johonkanen/ac_psu_kicad/reports/aux_flyback/report.txt

params:
VOR 100.5 V, Lp*Ipp 447 uVs, Ipp(max) 1.388 A, Lp 322 uH, RCS 0.562 ohm
design load 19.8 W -> full-load fsw 71.0 kHz at Ipp(max) (FM region)
  Vin 100 V: ton 4.47 us, tdemag 4.45 us, D 0.317, demag duty 0.316, period use 0.70, Ipri rms 0.451 A
  Vin 300 V: ton 1.49 us, tdemag 4.45 us, D 0.106, demag duty 0.316, period use 0.49, Ipri rms 0.260 A
  Vin 450 V: ton 0.99 us, tdemag 4.45 us, D 0.070, demag duty 0.316, period use 0.46, Ipri rms 0.213 A
CC limit: 27.9 W at 100 kHz, 25.7 W at fSW(max) min 92 kHz, 23.0 W with VCST(max) 738 mV too (worst case)
DCM at the CC point, 100 V: ton 4.47 + tdemag 4.45 + 1.0 us = 0.99 of the 10 us period
min on time at 450 V, VCST(min): 248 ns (LEB max 280 ns -> effective 280 ns); tDMAG(min) 1.25 us (TI target >= 1.2 us)
drain peak at 450 V: 450 + clamp 240 = 690 V (73 % of 950 V)
clamp loss (leakage 5.9 uH, Vclamp 240 V): 0.69 W at full load (any Vin; Ipp is fixed by VCST(max) in the FM region)
RCS 0.562 ohm 1 % (E96): 0.12 W at 100 V
  Out1: N 5, winding 15.70 V -> out 15.00 V; diode reverse 85 V
  Out2: N 5, winding 15.70 V -> out 15.00 V; diode reverse 85 V
  CTRL: N 3, winding 9.42 V -> out 8.97 V; diode reverse 51 V
VS divider from the Out1 winding: RS1 59.0 k (run at 85 V DC, stop at 30 V), RS2 20.97 k
cable compensation 0.25 V at full load: RCBC 118 k
VDD from Out1 via diode + 47 ohm: ~14.3 V; run current 6.2 mA (IRUN max + Qg x 100 kHz)
CDD >= 12.9 uF for 20 ms to Out1 10 V (worst UVLO window 9.5 V) -> 15 uF; start delay with 15 uF: 1.3 s typ, 4.9 s worst (IHV 100 uA at 100 V)
gate drive: VDD 14.3 V, DRV ~13 V (clamp 14-16 V only at high VDD); Qg 35 nC at 20 mA min source -> 1.8 us to full charge
== EE25: E 25/13/7 N87, Bobbin EE 25 horizontal longer-creepage 10-pin 5.08mm (Norwe 10165-106)
   Ae 51.8 mm2, Ve 2994 mm3; centre gap 0.215 mm for Lm 322 uH (AL 314 nH); fits: True
   peak flux at Ipp(max) (VCST max 810 mV): 280 mT
   Vin 100 V: Bpk 270 mT  core 0.388 W  winding 0.255 W  total 0.64 W  -> ~74 C at 55 C air (Rth ~29 K/W)  [Primary 0.137 Out1 0.037 Out2 0.035 CTRL 0.047]
   Vin 300 V: Bpk 257 mT  core 0.481 W  winding 0.268 W  total 0.75 W  -> ~77 C at 55 C air (Rth ~29 K/W)  [Primary 0.134 Out1 0.043 Out2 0.033 CTRL 0.058]
   Vin 450 V: Bpk 267 mT  core 0.620 W  winding 0.304 W  total 0.92 W  -> ~82 C at 55 C air (Rth ~29 K/W)  [Primary 0.159 Out1 0.047 Out2 0.033 CTRL 0.065]
== E30: E 30/15/7 N87, Bobbin E 30/15/7 (Ferroxcube CP-E30/15/7-1S)
   Ae 60.1 mm2, Ve 3938 mm3; centre gap 0.206 mm for Lm 322 uH (AL 314 nH); fits: True
   peak flux at Ipp(max) (VCST max 810 mV): 241 mT
   Vin 100 V: Bpk 233 mT  core 0.333 W  winding 0.216 W  total 0.55 W  -> ~69 C at 55 C air (Rth ~25 K/W)  [Primary 0.115 Out1 0.027 Out2 0.036 CTRL 0.038]
   Vin 300 V: Bpk 222 mT  core 0.413 W  winding 0.202 W  total 0.62 W  -> ~71 C at 55 C air (Rth ~25 K/W)  [Primary 0.096 Out1 0.030 Out2 0.032 CTRL 0.044]
   Vin 450 V: Bpk 230 mT  core 0.533 W  winding 0.220 W  total 0.75 W  -> ~74 C at 55 C air (Rth ~25 K/W)  [Primary 0.109 Out1 0.032 Out2 0.032 CTRL 0.048]
== EE32: E 32/16/9 N87, Bobbin EE 32 horizontal 12-pin 5.08mm (Norwe 10750-024)
   Ae 83.2 mm2, Ve 6180 mm3; centre gap 0.372 mm for Lm 322 uH (AL 314 nH); fits: True
   peak flux at Ipp(max) (VCST max 810 mV): 174 mT
   Vin 100 V: Bpk 168 mT  core 0.204 W  winding 0.304 W  total 0.51 W  -> ~65 C at 55 C air (Rth ~20 K/W)  [Primary 0.163 Out1 0.041 Out2 0.043 CTRL 0.056]
   Vin 300 V: Bpk 160 mT  core 0.253 W  winding 0.315 W  total 0.57 W  -> ~66 C at 55 C air (Rth ~20 K/W)  [Primary 0.158 Out1 0.048 Out2 0.040 CTRL 0.069]
   Vin 450 V: Bpk 166 mT  core 0.327 W  winding 0.357 W  total 0.68 W  -> ~69 C at 55 C air (Rth ~20 K/W)  [Primary 0.186 Out1 0.053 Out2 0.040 CTRL 0.077]
== chosen EE25: leakage and build
   leakage ref Primary: [0.0, 6.12, 11.16, 2.92] uH
   leakage ref Out1   : [0.15, 0.0, 0.32, 0.16] uH
   leakage ref Out2   : [0.27, 0.32, 0.0, 0.42] uH
   leakage ref CTRL   : [0.03, 0.06, 0.15, 0.0] uH
   layers (inner -> outer):
     Primary section 0 layer 0                      conduction t 0.450 w  7.19 mm 16
     Insulation between Primary and CTRL section 1  insulation t 0.025 w 15.80 mm 
     CTRL section 0 layer 0                         conduction t 0.683 w  6.15 mm 9
     Insulation between CTRL and Out1 section 3 ins insulation t 0.025 w 15.80 mm 
     Out1 section 0 layer 0                         conduction t 0.704 w  3.52 mm 5
     Insulation between Out1 and Primary section 5  insulation t 0.025 w 15.80 mm 
     Primary section 1 layer 0                      conduction t 0.450 w  7.19 mm 16
     Insulation between Primary and Out2 section 7  insulation t 0.025 w 15.80 mm 
     Out2 section 0 layer 0                         conduction t 0.739 w  3.69 mm 5
     Insulation between Out2 and Primary section 9  insulation t 0.025 w 15.80 mm 
   insulation requirement (MKF, IEC 60664-1 reinforced, 500 V, PD2, OVC II, IIIa; MKF applies its >30 kHz rules): {'clearance': 0.0015, 'creepageDistance': 0.016, 'distanceThroughInsulation': 0.00015, 'withstandVoltage': 2676.2365978649464}
