johonkanen/ac_psu_kicad/next_prompt.md

# Next prompt
## ac_psu_kicad (continuing work on the inverter PSU)

```
Work in /home/jari/dev/ac_psu_kicad (KiCad 10.0.7 design of the single-phase inverter PSU,
converted from Proteus, tag proteus-conversion-complete; v4 fixes 1-16 and v5 steps 1-2 done).
Read README.md, STATUS.md (first "v5 step 2", "v5 step 1", "v4 fix 16", then "v4 fix 15", "v4 fix 13/14"),
V5_PLAN.md section 8, CTRL_ISOLATION_PLAN.md section 8, fab/README.md and tools/check_all.sh.
Never run the KiCad AppImage with --version.

Rules: kicad/ac_psu.kicad_pcb is changed only by small committed pcbnew scripts (tools/v4/fix_*.py,
tools/v5/v5_*.py; each refuses to run twice) or in the KiCad GUI with a clear note in STATUS.md.
Schematic sheets stay generated by tools/sheets/sheetNN.py; v5 parts live in tools/v5/v5_parts.py
(lib/part_map.csv and lib/v5_deviations.csv come from tools/v5/make_v5_lists.py [--nets]). Every
intended difference from Proteus is in lib/v4_deviations.csv, lib/v5_deviations.csv (kinds merge,
rename, refdes, remove, pin, part, add, value, footprint), lib/v4_copper.csv or lib/v5_copper.csv (vias,
areas, pending-layout areas). After a schematic change run tools/p2k/bin/kipy tools/v4/domain_rules.py
(net classes DOM_P/I/E/C + kicad/ac_psu.kicad_dru: the IEC 61010-1 gaps that zone fills and DRC keep).
Pours have no cut-outs since fix 16: KiCad draws every clearance. Every refdes must end in a digit
(KiCad's annotation check of Update PCB; kicad-cli ERC does not test it), see STATUS "v5 step 2".

Verify first: tools/check_all.sh (~2 min) must end with ALL CHECKS PASSED; at handoff:
  compare: parts 365/365 present ... wrong-net pins 0 ... compare: OK (135 deviation values)
  check_board: 377 footprints, 1202 pads ... 217 IPC nets mapped 1:1; 20 v4 vias; 24 Proteus vias deleted by v5; OK
  assign_nets: 562 groups, 0 shorts, 0 orphans, 0 opens; 87 v5 opens pending GUI layout
  domain_rules: 113 DOM_P, 95 DOM_I, 8 DOM_E, 64 DOM_C; OK
  drc: 291 violations, 0 shorts, 0 unconnected, 0 parity; 262 unconnected + 427 clearance pending
  domain_gaps: 0 violations; 208 in v5 pending-layout areas
  ipc356_diff: 217 nets 1:1, 0 mismatches; roundtrip: OK, drills 0 mismatches
Also tools/regen_check.sh must print "regen_check: OK".

State: the v5 netlist is on the board, the 98 new parts sit unplaced in a staging area below the
outline (IPC y -92 .. -152). Placement/routing is GUI work by the user (V5_PLAN.md D5). The pending
areas of lib/v5_copper.csv make the checks list layout items as pending; remove a row when its area
is finished so the checks become strict there again.

Open points (ask the user which to do):
0. **Next (user 2026-11-12): V5_LAYOUT_PLAN.md** – place the control and measurement parts under the
   control card in three domains (CTRL / primary / ISO), 6 copper layers, parts on both sides, planes
   reshaped; for a Claude Fable 5.2 session; stop points after the proposal (phase 1) and before routing.
1. After the user's GUI layout: review it (DRC, domain_gaps with the pending rows removed, renders of
   the aux area and both CTRL islands, slots under the isolators, In1/In2 re-cut), record it in STATUS.md.
2. CPV-E25/13/7-1S-10P-Z pin grid: the footprint assumes 5.0 x 12.7 mm (from the CSV 6-pin former);
   verify on a sample/drawing and fix gen_footprints.py if needed. Core insulation is mandatory.
3. v5 M4 ring-lug terminals for the 17 lead connections that keep soldered pins in v4 (as fix 13),
   which also settles the open cable-tie anchors (ACIN2, PE4, PE6-8, DAB_PRI/SEC_1/2, STATUS "v4 fix 15").
4. fab: the v5 passives are in fab/jlc_bom.csv (fab/README.md "v5 passives"; check C113's effective
   capacitance on the prototype). Still to add: the v5 ICs/discretes (codes in fab/README.md where known:
   UCC28710 C80866, IPD95R450P7 C3289115, ISO7760FDWR C2878538, CA-IS3742LW C4944981, AMC1311BDWVR
   C783598; Q15/Q16, D11-D16, U28 to pick), T1/W1/J13/J14/PEC1/PEC2 in hand_fit.csv, REF3025AIDBZR now
   0 stock (find a replacement), then the CPL after the layout (fab/make_fab.sh, fab/jlc_bom_check.py).
5. Still open from before: switching-noise firmware items (reports/noise/README.md), R73/R74 when the
   shunt inductance is measured, silk outlines vs the 199 silk_over_copper warnings.

Done when: the chosen points are implemented, tools/check_all.sh and tools/regen_check.sh pass,
STATUS.md has a short section, next_prompt.md is replaced, committed (Co-Authored-By: Claude
Opus 5.5 <noreply@anthropic.com>), not pushed.
```
