johonkanen/ac_psu_kicad/V5_PLAN.md

# v5 plan – aux flyback redesign (INN3694C, EE25, 2 x 15 V)

Status 2026-11-05: **schematic done, board staged** (section 8): sheet 7 is the UCC28710 flyback,
the CTRL isolation is on sheets 2/11, the board carries the v5 netlist with the new parts unplaced
below the outline; placement, routing, plane re-cuts and slots are GUI work (D5). Was: plan only
(2026-10-24). User decisions taken
2026-10-24: D1 yes, D2 15 V is fine, D3 reinforced, D5 in place on the main board, D6 rename. D4
(controller sourcing) is still open. The converter and transformer design are
in `reports/aux_flyback/README.md` (commit 965a78b). This file says how to bring that design
into the KiCad project, and which questions need answers first. Coordinates: mm, IPC frame (Y up).

## 1. What sheet 7 does today (v4)

| Rail | Made by | Return | Loads |
|---|---|---|---|
| `20V` | IW1830 PWM1, aux winding TR2-3 → D2, C28/C41; regulates through `AUX_FB` (primary-side sensing) | `GND` | J1/J2/J3 pin 48 (primary gate drivers), U9 → `5V`, relay R20 coil via Q14, D10 |
| `20V_ISO_SEC` | TR2-7 → D1, C36/C15, R49 preload (cross-regulated) | `ISOGND` | J4/J6/J8 pin 48 (isolated-side gate drivers), U8 → `5V_ISOL`, relay R79 coil via Q13, D4 |
| `5V` | U9 (VXO7805), C67/C58/C57 | `GND` | J1–J3 pin 45, U3, … |

`GND` is the DC-link negative: R96 (0 R, sheet 4) joins `GND` and `PGND`. The flyback primary
(PWM1, TR2-4) and the 20 V output therefore already share one reference. Only `20V_ISO_SEC`
crosses the DC ↔ ISO barrier, the same barrier as the DAB transformer TR1 and the
ADuM7701 / Si866x isolators.

The sheet 7 parts take up about x 70…107, y −60…−13. TR2 (EF20, 2 × 5 pins, P 3.81) is at
(87.5, −28.4) and PWM1 (DIP-8) at (75.8, −37.8). DC+ (up to 500 V) runs through the area.

## 2. Findings that change the README design

1. **Isolation sides.** The README models the transformer as primary | Out1 | Out2 | bias, with
   reinforced insulation from the primary to both outputs. On this board:
   - Out1 replaces `20V` (return `GND` = DC−), so it is in the primary domain. Primary ↔ Out1
     needs no insulation at all.
   - Out2 replaces `20V_ISO_SEC` on `ISOGND`. The barrier that matters is
     {primary, Out1, bias} ↔ Out2, and it must be reinforced (D3).

   Re-run `transformer.py` with isolation sides [primary, primary, secondary, primary]. Out2 then
   needs reinforced margins and 3-layer tape on both of its faces. The primary ↔ Out1 barrier
   becomes functional, so P1 → Out1 can be wound without margins. That frees winding width,
   which may allow wider margins on Out2 for the IEC 60664-1 caveat in the README. The
   reinforced barrier on the board, through the transformer and the slot, must match the
   ADuM7701 / Si866x / TR1 barrier around it.
2. **The InnoSwitch secondary side sits on Out1.** The secondary controller (SR FET drive, FB,
   VOUT pins) is referenced to Out1's return, which is `GND`, the same node as the primary
   `SOURCE`. That is allowed. The IC's internal FluxLink isolation is then simply unused between
   primary and Out1, so the "pending UL1577 / IEC 60747-17" note in the README no longer matters.
   An alternative is a primary-side-regulated part with the same transformer (decision D4).
3. **Relay coils.** R20 and R79 (SLA-12VDC-SL-A, 12 V coil) run from the rails through a
   2N7000 with no series resistor. With the two 15 V rails that is 125 % of the rated coil
   voltage (v4: 167 % at 20 V). The user considers this acceptable; check the relay's maximum
   coil voltage once.
4. **15 V instead of 20 V** at the HB GT connectors' pin 48 is only a problem if the gate-driver
   boards need more than 15 V (decision D2). U8/U9 (VXO78, 6.5–36 V input) are fine with 15 V.
5. **Stock.** INN3694C is JLC C567564, with 0 in stock on 2026-10-23. Neither the KiCad library nor
   JLC's basic parts have the InSOP-24D footprint or an EE25 10-pin bobbin footprint; both must be
   project footprints from the datasheets. The transformer is custom-wound, so JLC cannot assemble
   it: hand-fit it, like TR2 today.

6. **Out2 power is too small for the new control card.** The efinix-soc-board session asks for
   U8 (5V_ISOL) to be upgraded to 1.5–2 A for the Ti135 control card (0.72 A typical, 1.15 A
   high at 5 V; `~/dev/efinix_soc_board/POWER_BUDGET.md`). On Out2 (`15V_ISO`) that is U8 at
   up to about 7–8 W (1.45 A at 5 V with the gate-driver logic and U10, at 89–92 % efficiency),
   plus the J4/J6/J8 gate-driver supplies and the R79 coil (≈ 0.5 W). That exceeds the README's
   10 W per output. Re-balance the outputs before step 1 (for example Out2 13–14 W, Out1 6–7 W,
   or a larger total), and re-check the INN3694C's power rating, ILIM and the core.

## 3. Decisions (D1–D3, D5, D6 answered 2026-10-24; D4 2026-10-30)

- **D1 Output mapping – yes:** Out1 (regulated) → `20V`, renamed `15V`, on `GND`; Out2
  (cross-regulated) → `20V_ISO_SEC`, renamed `15V_ISO`, on `ISOGND`.
- **D2 – 15 V is fine** for the gate-driver boards on J1–J8 (pin 48), so `params.py` keeps
  VOUT = 15 V.
- **D3 – reinforced** between {primary, Out1, bias} and Out2 (finding 1), in the transformer and
  on the board.
- **D4 Controller – TI UCC28710 with an external 950 V MOSFET** (user, 2026-10-30), instead of the
  INN3694C (0 stock at JLC). Details in section 5. The iW1830 has 0 stock at JLC, and its 700 V
  switch is too close to 450 V DC plus VOR plus the leakage spike.
- **D5 – in place on the main board:** it replaces the aux supply. Delete the sheet 7 copper,
  then re-place and re-route the area in the KiCad GUI, with a slot under the transformer and IC.
- **D6 – rename** `20V` / `20V_ISO_SEC` to `15V` / `15V_ISO`. This touches sheets 1, 2, 3, 5, 7
  and 10, the deviation files and the checks; the renamed nets go into the v5 deviation list.
- **D7 – standard: IEC 61010-1, user 2026-10-31** (bench-top laboratory power supply). Insulation
  check in 5.3.

## 4. Steps (after the decisions)

1. **Transformer re-check.** Update `params.py` and `inputs.py` for D1–D3 (isolation sides,
   insulation class, output voltages), re-run `inputs.py` and `transformer.py`, and update the
   README tables. Check Out2 cross-regulation at the real load split. Out2 feeds the U8 module
   and the relay coil: keep a preload, or accept 16–17 V at light load if both are fine with it.
2. **Circuit.** Base it on PI's INN3694C datasheet application circuit and the README "Around
   the transformer" section:
   - input: DC+ → small RC/π filter, bulk capacitor rated ≥ 630 V (stacked 1206 parts at 500 V
     need a voltage rating to match)
   - clamp: 180–200 V TVS plus a 1000 V fast diode
   - BPP 0.47 µF; bias winding → 200 V diode → BPP resistor
   - Out1: SR MOSFET ≥ 150 V, FB divider 100 k / 9.09 k, low-ESR output capacitors ≥ 25 V
   - Out2: 150–200 V Schottky/ultrafast diode, output capacitors, preload
   - a Y1 capacitor across the DC ↔ ISO barrier only if D3 allows it (it bridges the barrier
     the ADuM7701s isolate; check the measurement noise effect)

   Write it as a new `tools/sheets/sheet07.py` (the v4 one stays in git history). Keep the 5 V
   capacitors C67/C58/C57, C68 and the rail flags. Remove PWM1, TR2, R43/R34/R33, D7, C65/C66,
   R24/C62/R23/D6, R44/R25/C63/R26/R29/R31, R45/R47, D2, D1, R49. New refdes continue from
   C111 / R98 / D11 / U18 / T3 (check that they are free; C95–C110 are fix 11).
3. **Library.**
   - Symbols in `tools/gen_symbols.py`: INN3694C with all InSOP-24D pins, and the EE25 transformer
     (10 pins, winding dots, one unit, pin numbers as on the bobbin).
   - Project footprints in `tools/gen_footprints.py` (`from_ipc`-style builder from datasheet
     coordinates): `InSOP-24D` (PI package drawing, with its creepage slot) and
     `Transformer_EE25_Ferroxcube_CPV-E25-13-7-1S-10P` (vertical; pin pitch, row spacing, holes and body from the Ferroxcube
     drawing; slot between the rows if D3 needs it).
   - Part map rows and `fab/jlc_bom.csv` codes.
4. **Deviation framework.** v5 replaces a whole block, so per-pin deviation rows are the wrong
   tool. Add `lib/v5_deviations.csv` with `removed_part` rows (the v4 parts above) and a
   `replaced_block` area (the aux copper area, every layer). Teach `tools/deviations.py`,
   `compare_netlists_v4.py`, `check_board.py`, `ipc356_diff.py` and `gerber_roundtrip.py` to skip
   removed parts and their pins, nets that exist only inside the block, and copper clusters
   inside the area. Everything outside the block keeps the Proteus parity checks. Negative-test
   it: a part outside the block that is removed or renetted must still fail.
5. **Board (D5: in place).** A `tools/v5/` script deletes the removed footprints and the copper
   inside the area, then places the new footprints at agreed positions. Routing, pours and the
   slot are done in the KiCad GUI and recorded in STATUS.md, which ends the "frozen board edited
   only by scripts" rule for this area.

   A net class `HV_AUX` sets the clearance for DC+, the drain node and the clamp (500 V working:
   ≥ 2.5 mm on external layers). The reinforced creepage between the GND and ISOGND domains is
   kept across the transformer, the slot and the Out2 copper, including on the inner layers.
   Check the space first: the EE25 bobbin is larger than the EF20, and the InSOP-24D needs
   its own slot.
6. **Checks.** ERC, `tools/check_all.sh` (with the v5 deviations), DRC with the new net class,
   `tools/regen_check.sh`, renders of the area, and the JLC BOM/CPL refreshed.
7. **Bring-up** (README): measure Lp (MKF predicts +12 %), the drain peak at 500 V, the clamp
   temperature, and Out2 at light and full load.

## 5. Controller: UCC28710 + external MOSFET (D4)

Why: primary-side regulation (PSR) like the present iW1830 design: the output is sensed through
the bias winding, so there is no optocoupler across the reinforced barrier. The external MOSFET
removes the 700–725 V switch limit of the integrated parts, and the 700 V high-voltage start-up
switch (DC+ ≤ 450 V) replaces the R43/R34/R33 start-up chain. ±5 % CV/CC regulation, up to
100 kHz, clamped MOSFET gate drive, SOIC-7. JLC C80866 (UCC28710DR), 381 in stock on 2026-10-30.
The UCC28712 is pin-compatible (fixed cable compensation) and could serve as a second source.

MOSFET (primary peak current ≈ 0.8–1 A at 20–25 W; RMS ≈ 0.2 A at 400 V, ≈ 0.45 A at 100 V;
drain peak ≈ 450 V + VOR ≈ 104 V + clamp overshoot, so ≈ 700–750 V with a 180–200 V TVS clamp,
which needs ≥ 950 V parts):

| Part | Package | Rds(on) at 10 V | JLC / stock 2026-10-30 | Note |
|---|---|---|---|---|
| Infineon IPN95R2K0P7 (only if the input stays ≥ 300 V; see 5.1) | SOT-223 | 2.0 Ω | C3278575 / 75 | Smallest; CoolMOS P7, 330 pF Ciss, 10 nC. ≈ 0.1 W conduction at 400 V, ≈ 0.4–0.8 W at 100 V hot: needs a copper area of ≈ 1–2 cm² on the drain tab, which is the switch node (keep it small for EMI; use the source side and a thermal pad). |
| Infineon IPN95R3K7P7 | SOT-223 | 3.7 Ω | C3278582 / 172 | More stock, twice the conduction loss. |
| ST STD6N95K5 | DPAK (TO-252) | 1.25 Ω | C455168 / 112 254 | Large stock and lower loss, with a bigger tab (≈ 6.6 × 6.1 mm). The fallback if the SOT-223 parts run out. |
| Infineon IPD95R1K2P7 | DPAK | 1.2 Ω | C536916 / 1528 | Same class as STD6N95K5. |

Check in the datasheets before the circuit step:
- the UCC28710 DRV drive against the MOSFET Qg (10–15 nC is fine at ≤ 100 kHz)
- the minimum demagnetisation time for its PSR sampling against the EE25 leakage (20.6 µH)
- the bias-winding voltage range (VDD), then pick NB to suit
- the maximum power the TI design calculator gives at VIN 100–450 V

With PSR, Out1 is no longer the regulated rail. Both 15 V outputs are cross-regulated through the
bias winding, as 20V/20V_ISO_SEC are today, so the transformer coupling (MKF leakage) sets the
accuracy. Keep a preload on both outputs.

Step changes for this choice: step 2 follows the UCC28710 application circuit (no SR MOSFET and no
FB divider on Out1; a VS divider from the bias winding, a CS resistor, a 950 V MOSFET, and diodes on
both outputs). Step 3 drops the InSOP-24D footprint (SOIC-7 and SOT-223 are KiCad library
footprints).

### 5.1 Full power at 100 V, passive cooling (user, 2026-10-30)

DC+ is rated 100–450 V, and the aux supply must deliver full power at 100 V: the control card
(FPGA, Ethernet, LCD), the 5 V logic and all the gate-drive supplies. The supply is passively
cooled inside a closed chassis.

**Power budget (estimate, to confirm).** Output side:

| Load | Estimate |
|---|---|
| Out2: U8 (card 5.8 W high case + gate-driver logic + U10) / 0.9 | ≈ 7–8 W |
| Out2: J4/J6/J8 gate-drive supplies | ≈ 3 W |
| Out2: R79 coil | 0.5 W |
| Out1: J1–J3 gate drives | ≈ 3 W |
| Out1: U9 5 V logic | ≈ 1–2 W |
| Out1: R20 coil | 0.5 W |

Each gate-driver board is assumed at about 1 W. The SiC gate charge itself is only ≈ 20–40 mW per
switch at 30/66 kHz; the drivers' isolated DC/DCs dominate. The total is **≈ 15–20 W, so design for
25 W output (≈ 29 W input) at 100 V.**

**The README transformer cannot do that.** The UCC28710 is primary-side regulated and needs DCM:
on-time plus demagnetisation time must fit in the switching period.
- With VOR ≈ 104 V at 100 V input, the DCM boundary is D ≈ 0.51.
- The maximum input power is then (Vin·D)² / (2·Lp·fsw) = 51² / (2 · 1.19 mH · 70 kHz) ≈ 15.6 W.

Redesign for:
- **Lp ≈ 0.5–0.6 mH** at 70 kHz (≤ 0.64 mH at the boundary, with margin for the PSR sampling
  window).
- **Or a higher VOR** (≈ 130–150 V gives D ≈ 0.57–0.6 and allows ≈ 0.7–0.9 mH). The drain peak then
  rises to ≈ 450 + 150 + overshoot ≈ 780 V, still under 950 V. Choose by the transformer losses.
- Primary at 0.5 mH: Ipk ≈ 1.46 A, Irms ≈ 0.6 A, stored energy ≈ 0.53 mJ per cycle.
- On EE25 (Ae ≈ 52 mm²) at 0.3 T that is ≈ 47 primary turns and a gap of ≈ 0.3 mm. It is feasible,
  but re-run MKF for copper and core loss at 100 V in a hot enclosure.
- If the losses come out over ≈ 1.5 W, step up to E30/EF25.

**MOSFET for continuous 100 V operation.** Hot Rds(on) is about 2.2 × the 25 °C value; the
switching loss is ≈ 0.25 W turn-off at 250 V / 1.46 A.

| Part | Package | Rds(on) 25 °C | Conduction loss hot at 100 V | JLC / stock 2026-10-30 |
|---|---|---|---|---|
| **Infineon IPD95R450P7** | DPAK | 0.45 Ω | ≈ 0.36 W | C3289115 / 112 |
| Infineon IPD95R750P7 | DPAK | 0.75 Ω | ≈ 0.6 W | C536918 / 97 |
| ST STD6N95K5 | DPAK | 1.25 Ω | ≈ 1.0 W | C455168 / 112 254 (fallback) |
| ST STB20N95K5 | D2PAK | 0.275 Ω | ≈ 0.2 W | C500935 / 895 (if DPAK runs hot) |
| ~~IPN95R2K0P7~~ | SOT-223 | 2.0 Ω | ≈ 1.6 W | too hot for 100 V continuous; dropped |

Choose the IPD95R450P7, about 0.6 W in total. Its tab is the drain, i.e. the switch node, so
keep that copper small: cool it through a source-side and inner-layer copper spread with thermal
vias, not a large drain pour. Check the 35 nC Qg against the UCC28710 DRV current.

**Thermal budget in the closed chassis:**
- FET ≈ 0.6 W, clamp ≈ 1–1.3 W (more at the higher Ipk), transformer ≈ 1–1.5 W, output diodes
  ≈ 0.5–0.8 W: ≈ 3.5–4 W in the aux area.
- Give the clamp TVS and the diodes copper too.
- Measure the internal air temperature on the v3 build, then check the N87 core loss, the
  electrolytic capacitor life and the U8 K7805-2000R3 derating (the 5 V version derates from
  ≈ 55–71 °C ambient).

**Thermal environment (user 2026-10-31: rated ambient 30 °C):**
- **Internal air:** 30 °C ambient + the rise of the passively cooled closed chassis. No dissipation
  figure for the whole unit exists in the repo yet (the power stages' losses are unknown), so a
  **20–30 K rise is assumed: internal air ≈ 50–60 °C, design value 55 °C** (`params.py` T_AMB).
  Measure it on the v3 build at full load.
- **Transformer (EE25, MKF at 55 °C air; the rule-of-thumb rise scales with the air temperature):**
  0.64 W at 100 V, 0.75 W at 300 V, 0.92 W at 450 V → **≈ 74–82 °C at 55 °C air (≈ 69–87 °C for
  50–60 °C air).** N87 core loss rises slightly when cooler (its loss minimum is near 100 °C), so the
  losses are 0.03–0.05 W higher than at 60 °C.
- **U8 (K7805-2000R3):** Mornsun derates the 5 V version above 71 °C ambient for Vin ≤ 32 V (here
  15–20 V), to zero at 85 °C. At 50–60 °C internal air (plus a few K local rise) it runs at full power.
  In v5 U8 only feeds the gate-driver logic and U10 (≈ 1 A), so there is extra margin.
- **IEC 61010-1 temperature limits (10.1, Table 19; values from memory, verify):** accessible outer
  surfaces about 70 °C metal / 80 °C non-metal for unintentional contact; knobs and handles about
  55 °C metal / 70 °C non-metal. The test is run at the reference ambient (10–40 °C) and the measured
  rise is added to the rated ambient (30 °C). A metal chassis that also works as the passive heatsink
  may therefore rise only about **40 K** above ambient where it can be touched. Windings are limited
  by their insulation class (≈ 105–130 °C for class A–B), which the transformer meets.

### 5.2 CTRL winding and control-card isolation (user, 2026-10-31)

v5 includes the control-card isolation in `CTRL_ISOLATION_PLAN.md`. The card domain (J11/J12)
becomes CTRL, isolated by reinforced barriers from both power sides, so the card's Ethernet and
touchscreen are SELV. The card's 5 V comes from a **dedicated CTRL winding** on this flyback. The
transformer now has **three reinforced-separated groups**:
- {primary, Out1 (`15V`, GND; also the PSR sense and VDD winding since 5.3)}
- Out2 (`15V_ISO`, ISOGND)
- CTRL (5 V, card ≈ 6–7 W)

Margins or TIW are needed on both of the last two. Re-run MKF with isolation sides
[primary, primary, secondary, tertiary, primary], and expect the EE25 to become too small: check
E30 / EF25 / EFD30 with the 100 V full-power design point of 5.1.

**Power (user estimate):** about 15–20 W in total; the 25 W design point of 5.1 covers it. With
CTRL taking the card, Out2 drops back to the gate-driver supplies, U8 (now only the gate-driver
logic and U10) and the R79 coil, ≈ 4–5 W. Rebalance the outputs: Out1 ≈ 5–6 W, Out2 ≈ 4–5 W, CTRL
≈ 7 W, with margin.

**Regulation:** PSR regulates the bias winding (since 5.3: Out1 itself, no separate bias winding). CTRL is cross-regulated like the others, so put a
local regulator (buck or LDO) after the CTRL winding if the card needs a tight 5 V. Choose the
CTRL winding voltage to suit, e.g. ≈ 7–8 V into a buck.

**Why not the iW1830** (user question 2026-10-31): Renesas rates it at 12–15 W maximum, for AC input
(85–264 VAC, ≈ 120–375 V DC). Its integrated MOSFET is 700 V, but here the drain peak at 450 V DC is
≈ 700–780 V. And JLC has 0 in stock. The UCC28710 (section 5) is the same kind of controller
(primary-side regulation from the bias winding, no optocoupler), but drives an external 950 V
MOSFET, so the power is set by the transformer and the MOSFET.

### 5.3 Transformer (run 2026-10-31, revised to 20 W on EE25, no bias winding)

Details, candidates and scripts: `reports/aux_flyback/` (README.md, params.py, inputs.py,
transformer.py, report.txt, winding.svg). This supersedes the INN3694C/EE25 numbers above. The
25 W / E30/15/7 design (commit 3b4a33d) is kept in the README as the alternative.

**Electrical design** (UCC28710, 100–450 V, full power at 100 V; user: 20 W):
- **Design load ≈ 20 W:** Out1 15 V 0.39 A (load + ≈ 20 mA VDD), Out2 15 V 0.33 A, CTRL ≈ 9 V 1.0 A
  (into a 5 V buck). **No separate bias winding** (user, 2026-10-31).
- **VOR 100.5 V:** the 100 V DCM limit sets it.
- **Lp 322 µH, Ipp(max) 1.39 A, RCS 0.562 Ω** (user 2026-10-31: lowered from 0.590 Ω for CC margin).
- **Full load (19.8 W) at 71 kHz:** at 100 V, the on-time, demagnetisation and ring take 0.70 of the
  period.
- **CC limit:** 27.9 W typ; **23.0 W worst case** (fSW(max) 92 kHz and VCST 738 mV).
- **Drain peak:** 450 + 240 V clamp = 690 V (73 % of 950 V).
- **Light load at 450 V:** tDMAG(min) ≈ 1.25 µs (TI target 1.2 µs).

**Core:** E25/13/7 N87, gap ≈ 0.22 mm for AL ≈ 314 nH (choose the TDK B66317 gapped half or grind).
**Bobbin (user decision 2026-11-02): vertical coil former**, Ferroxcube CPV-E25/13/7-1S-10P-Z (10 pins)
with clip CLI-E25/13/7, instead of the Norwe 10165-106 horizontal bobbin (see section 7). The winding design is
unchanged (same core and winding width); MKF still models it with the Norwe horizontal bobbin as a proxy.
Was: Norwe 10165-106 (EE25 horizontal, longer creepage, 5 + 5 pins at 5.08 mm); alternatives
Norwe 10220-024 / 10175-106.

| Winding (inside → out) | Turns | Wire |
|---|---|---|
| P1 | 16 | 0.40 mm Grade 2 |
| CTRL | 3 | 3 × TIW 25 AWG (Rubadue TCA3) in parallel, **flying leads** |
| Out1 | 5 | 0.63 mm Grade 2 (PSR sense + VDD) |
| P2 | 16 | 0.40 mm Grade 2 |
| Out2 | 5 | TIW 24 AWG |

Order O2 out of four compared: the lowest clamp-effective leakage (5.9 µH), Out1 between the
primary halves (P→Out1 6.1 µH), and CTRL tightly coupled to Out1 (0.06 µH).

**Out1 as the PSR sense and VDD winding** (user, 2026-10-31; details in the README):
- **VS divider** from the Out1 winding node before its diode: RS1 59.0 k, RS2 21.0 k, cable
  compensation RCBC ≈ 118 k (+0.25 V at full load). The controller regulates Out1 directly; Out2 and
  CTRL cross-regulate against it.
- **VDD** from the 15 V rail via BAS16 + 47 Ω, ≈ 14.3 V. CDD 15 µF (TI eq. 24: ≥ 12.9 µF for a 20 ms
  start into ≈ 2200 µF total output capacitance). Start delay ≈ 1.3 s typ, 4.9 s worst at 100 V.
- **An output short** collapses VDD: hiccup (≈ 30 ms on per 1–5 s), thermally safe.
- **Gate drive:** DRV ≈ 13 V, so the FET is fully on (its Rds(on) is rated at 10 V). DRV sources only
  20–25 mA, so add an MMBT3904/3906 buffer for the 35 nC gate (or use the IPD95R750P7, 23 nC).
- **VS knee:** the leakage reset is ≈ 60 ns (TI limit 2.2 µs). The ringing must be < 100 mVpp at VS by
  ≈ 1.05 µs at 450 V no load (tDMAG(min) 1.25 µs); add an RC snubber on the Out1 diode if needed.

**Pins:**
- **Primary row:** drain, DC+, empty (the freed bias pin), GND, Out1.
- **Secondary row:** Out2+, ISOGND; pins 8–10 cut.
- **CTRL:** TIW flying leads from the pin-10 end of the secondary flange to two Ø 1.6 mm holes
  (pads Ø 3.0 mm, 5.08 mm apart) in the CTRL island, ≥ 10 mm from the Out2 pins, the primary row and
  the core.
- **The core is floating:** it counts as conductive between the groups; insulate it (see the IEC 61010-1 check below).

**Insulation – IEC 61010-1 check (2026-10-31):**

**Standard: IEC 61010-1 (3rd ed. + A1), user decision 2026-10-31** (bench-top laboratory power
supply). The values below use the **IEC 60664-1 basis** that IEC 61010-1 Annex K builds on
(Table F.2 clearance, Table F.4 creepage, reinforced = 2 × basic). The standard text was not
available here, so **every number must be verified against IEC 61010-1 Annex K (K.1 mains circuits,
K.2 secondary circuits) before layout sign-off.** Assumptions: mains 230 V, OVC II (2.5 kV impulse),
PD2, ≤ 2000 m; bobbin plastic material group IIIa; FR4 CTI ≥ 175 (IIIa).

**Working voltages** (user 2026-10-31: the isolated DC link is ≤ 410 V, so the AC output peak is
≤ 410 V (≈ 290 Vrms sine); the primary DC+ stays ≤ 450 V for the 100–450 V input range. CTRL is
bonded to PE; both power domains move against PE). **User 2026-10-31: the output is always floating AC**, so the DC/earthed case below does not apply and B2 stays in the 500 V row. Whether an output terminal can be earthed was not
known yet, so both cases are given:

| Barrier | Floating output (only the output Y caps C29–C32 to PE) | Output earthed (through the Y caps' leakage path, the user or the load) | IEC 60664-1 row (RMS / DC working voltage) |
|---|---|---|---|
| B2 primary ↔ ISO | ISO domain centred on PE: ISOGND ≈ −205 V average, −410…0 V extremes; DC+ ≤ +450 V to PE. Peak ≈ 860 V, RMS ≈ 430–500 V | ISOGND = −(earthed pole voltage): −410…0 V. Same peak ≈ 860 V, RMS ≈ 430–500 V | **500 V row** (was 630 V); medium confidence, the RMS sits near the 500 V boundary. (The DC-output/earthed case, 1000 V row, does not apply: the output is always floating AC, user 2026-10-31.) |
| B3 primary ↔ CTRL (PE) | DC+ ≤ 450 V peak to PE, RMS < 450 V | same | **500 V row** (unchanged) |
| B4 ISO ↔ CTRL (PE) | ≤ 410 V peak (switching common mode included), RMS ≈ 205–290 V | ≤ 410 V peak, RMS ≤ 410 V (DC output) | **500 V row** (just above the 400 V row; unchanged) |
| B1 mains/primary ↔ accessible parts | mains 230 Vrms OVC II; DC+ ≤ 450 V | same | mains OVC II 300 V |
| B5 CTRL ↔ user parts (Ethernet, touchscreen) | same domain, PE-bonded, SELV | same | functional |

Insulation type: reinforced everywhere (user D3 for B2; for B3/B4, basic + PE bonding would satisfy
class I). IEC 61010-1 may only require basic between two hazardous-live circuits (B2); to confirm.

**Required distances** (IEC 60664-1 basis; confidence in brackets):

| Barrier | Clearance, reinforced | Creepage, reinforced: PCB (printed-wiring column, CTI ≥ 175) | Creepage, reinforced: other insulating material IIIa (bobbin, connector bodies) | Solid insulation, reinforced |
|---|---|---|---|---|
| B2, B3, B4 (500 V row) | ≥ 3.0 mm (2.5 kV OVC II impulse → 4 kV step; the ≈ 860 V recurring peak needs less) (medium-high; K.1.2 may add for working voltages above mains, so lay out ≥ 4 mm) | 2 × 2.5 = **5.0 mm** (medium) | 2 × 5.0 = **10.0 mm** (medium) | ≥ 0.4 mm single layer, or ≥ 2 thin layers each passing the full test voltage (3 layers: any 2) (medium) |
| ~~B2 if the output could be DC and earthed (1000 V row)~~ not applicable (floating AC output) | ≥ 3.0 mm | 2 × 5.0 = **10.0 mm** (medium-low) | 2 × 10.0 = **20 mm** (medium-low) | same |

- **Test voltage** (dielectric strength, reinforced, 1 min AC): ≈ 3 kVrms for mains OVC II 300 V,
  higher for the 500 V row working voltages (≈ 3.5–4 kVrms). Low confidence: verify in IEC 61010-1 6.8 and Annex K
  MKF's IEC 60664-1 figure is 2.7 kV; its IEC 62368-1 figure is 5 kV.
- **If IEC 61010-1 does not accept the printed-wiring column** for these working voltages, use the
  material-group column on the PCB too (10.0 mm for all three barriers). The board plan's ≥ 10 mm with
  slots covers that (the 20 mm DC-output/earthed case does not apply: floating AC output).
- **Slots** count as an interruption of the creepage path when ≥ 1.0 mm wide (IEC 60664-1, PD2).
- **MKF numbers** (reports/aux_flyback/insulation.py → insulation.txt): its IEC 60664-1 creepage is
  16 mm at 450–500 V and 25 mm at 630–800 V reinforced (IIIa, PD2). That is far above Table F.4 because
  MKF applies the high-frequency (> 30 kHz) creepage rules to the converter's 71 kHz waveform. Between
  the groups the voltage is mostly DC/50 Hz plus a ≈ 100 V switching swing, so Table F.4 governs.
  The HF rule must be checked for the swing amplitude only (small). Keep the MKF figure as an upper
  bound.
- **Digital isolators and AMC1306/AMC1311:** IEC 61010-1 ed. 3 asks for ≥ 0.4 mm internal distance
  through insulation, with relief for components certified to IEC 60747-17 / VDE 0884-11 (ADI note).
  Use parts with that certification (ISO7760F, CA-IS3742, AMC1311, AMC1306 are listed as reinforced
  per DIN EN IEC 60747-17; confirm each datasheet). Their 8 mm package creepage on CTI ≥ 600 mold
  compound covers 5.0 mm (group I at 500 V); the slot under each package is still needed for the FR4.

**Transformer verdict (EE25, written for the Norwe 10165-106; the same checks apply to the vertical
Ferroxcube CPV-E25/13/7-1S-10P-Z chosen 2026-11-02; TIW on Out2 and CTRL, CTRL on flying leads):**
**not compliant as it is; fixable** (paths ranked by risk):

1. **Via the floating core** (fails as built): on a standard EE25 bobbin, pins to the core edge are
   ≈ 2–4 mm per side. That is far below the 10.0 mm needed (B2: P/Out1 pins ↔ core ↔ Out2 pins; B3/B4: CTRL holes ↔
   core). **Fix: insulate the core:** 3 layers of polyester tape around the outer legs and
   back, or insulating core caps/sleeves. The core then drops out of the creepage path, which is
   measured over the tape. Cheap and standard practice.
2. **Pin row to pin row over the bobbin (P/Out1 row ↔ Out2 row, B2, ≥ 10.0 mm):** depends on the Norwe
   10165-106 row spacing and flange; typical EE25 horizontal bobbins have ≈ 15–20 mm between the rows
   (verify on the drawing). Cutting pins 8–10 and keeping Out2 on pins 6–7 at the far end helps.
3. **Through the windings:** TIW (Rubadue TCA3, Furukawa TEX-E) is certified as reinforced solid
   insulation (IEC 61558-2-16 / IEC 62368-1 Annex J, UL/VDE), typically 3 kVrms+ per wire. IEC 61010-1
   has no TIW-specific clause. Certification bodies accept certified TIW in wound components when the
   finished transformer passes the reinforced test voltage (to confirm with the test lab; medium-low
   confidence). Sleeve the TIW leads where they leave the bobbin, so the lead cannot be pinched
   against the core edge.
4. **CTRL flying leads:** TIW is solid insulation along its length, so only the soldered ends count:
   PCB rules at the CTRL holes (≥ 10.0 mm to other-domain copper and to the core outline,
   B3/B4). Already in the plan.

**Fix options, ranked:**
1. **Core insulation (tape or caps) + certified TIW + verify the row spacing ≥ 10.0 mm.** Recommended:
   no process change.
2. **Vacuum varnish impregnation:** IEC 60664-1 / IEC 61010-1 allow pollution degree 1 only for parts
   that are sealed, potted or coated to IEC 60664-3. Plain impregnation of an open bobbin is usually
   **not** accepted as PD1 for the pin and flange surfaces, so it does not replace fix 1.
3. **Potting the transformer:** solid insulation everywhere; heavy and a process step. Only if the
   lab rejects fix 1.
4. **Larger core / 12-pin E30 bobbin:** more room but the same core issue; fix 1 is still needed.

**PCB verdict:**
- **B3/B4 (CTRL islands):** the plan's ≥ 10 mm with slots meets the IEC 60664-1 basis in both cases:
  printed-wiring column 5.0 mm, material-group column 10.0 mm. **OK** (unchanged by the 410 V limit). Clearance ≥ 4 mm is met
  automatically.
- **B2 (primary ↔ ISO on the PCB):** the aux transformer's P/Out1 pads ↔ Out2 pads and the TR1
  terminals (DAB_PRI_x ↔ DAB_SEC_x) need **5.0 mm (printed-wiring column) to 10.0 mm (material-group
  column)** at the 500 V row; ≥ 10 mm (PCB) / 20 mm (other material) if the output can be DC and
  earthed. Lay out ≥ 10 mm, or slot. Check today's DAB terminal spacing on the v4 board as well.
- **Inner layers:** keep the same gap on In1/In2 unless the PCB is qualified for cemented joints. A
  domain on L1 must not overlap another domain on L2: the L1–L2 prepreg (≈ 0.2 mm) is below the
  0.4 mm reinforced solid-insulation thickness and is not two separately tested layers.
- **Slots:** ≥ 1.0 mm wide under every isolator and across each barrier where the copper gap is
  tight. The plan already says ≥ 1 mm.

**IEC 61010-1 checklist (beyond distances):**
- **Output terminals:** the AC output and the DC link are hazardous live (> 30 Vrms / 60 V DC).
  Use shrouded, finger-safe output terminals, with markings and a warning symbol.
- **Protective bonding:** PE bond resistance test (≤ 0.1 Ω at 25 A or 2 × rated current, per 6.5.2)
  covering the chassis, the CTRL island PE terminals and the Ethernet shield.
- **Touch current / protective-conductor current:** limits in 6.3. The Y capacitors and all barrier
  capacitances to PE add up; check the total.
- **Temperature limits (10.1):** surfaces, windings (insulation class) and components in the passively
  cooled chassis at the rated ambient (to define, e.g. 40 °C) and full load.
- **Fire enclosure, mains switch / fuse, X/Y capacitor ratings, marking and documentation.**
- **EMC:** IEC 61326-1.

**Losses (MKF at 55 °C air):** 0.64 W at 100 V, 0.92 W at 450 V. Peak flux 280 mT. ≈ 74–82 °C at
55 °C chassis air (30 °C rated ambient + an assumed 25 K rise). Aux area total at 100 V full load ≈ 2.6 W (clamp 0.7 W, MOSFET 0.4 W, diodes
≈ 0.9 W).

**Board footprint:** ≈ 28 × 26 mm plus the CTRL hole zone (≈ 800 mm² in total). That is ≈ 2.6 ×
today's EF20 and ≈ 25 % less than the E30 alternative (≈ 35 × 31 mm).

**Rest of the stage:**
- clamp TVS ≈ 200 V class + 1000 V fast diode
- Out1/Out2: 200 V ultrafast 1–2 A
- CTRL: 100 V Schottky 3 A
- VDD feed: BAS16 + 47 Ω, CDD 15 µF / 50 V; gate buffer MMBT3904/3906
- output capacitor RMS: Out1 0.71 A, Out2 0.62 A, CTRL 1.86 A
- preloads: Out2 ≈ 3 mA, CTRL ≈ 10 mA
- cross-regulation against Out1: Out2 14.7–15.3 V; CTRL ≈ 8.9–9.3 V loaded, ≈ 10.5–11.5 V at no load;
  CTRL buck ≥ 17 V input

**Open items:**
1. measure the chassis air temperature
2. wind a sample and measure Lp, the leakage, and the VS waveform at 450 V no load
3. source certified TIW
4. confirm the E25 gap (AL 314 nH; the user grinds the gap on ungapped cores) and the Ferroxcube CPV-E25/13/7-1S-10P-Z
   drawing: pin-row to pin-row creepage ≥ 10.0 mm (B2), pins to core, where the CTRL TIW leads exit,
   and the height (≈ 25–30 mm) clear of the control card
5. working voltages: all barriers in the 500 V row (isolated DC link ≤ 410 V, user 2026-10-31); the output is always floating AC (user 2026-10-31), so the 1000 V case is closed
6. standard decided: IEC 61010-1 (user 2026-10-31); PCB targets confirmed by the user 2026-11-01: 5.0 mm reinforced (primary ↔ ISO, primary/ISO ↔ CTRL), 2.5 mm basic (to PE); still to verify: the bobbin (10 mm) and test-voltage values; core insulation tape/caps
7. trim RS2 / RCBC and check the VS ringing, the start-up and the gate buffer on the prototype
   (decided 2026-10-31: MMBT3904/3906 buffer, RCS 0.562 Ω → CC worst case 23.0 W)

## 6. Not part of v5

v4 clean-up and manufacturing items (C67, silk positions, pad decisions, JLC alternatives, CPL)
continue separately on the v4 board. Sheet 7 parts that v5 replaces (iW1830, EF20 TR2 and so on)
get no JLC alternatives.

## 7. Magnetics sourcing (checked 2026-11-02, stock figures change)

| Part | Distributor | Notes |
|---|---|---|
| Core TDK B66317G0250X187 (E25/13/7 N87, 0.25 mm gap, AL ≈ 250 nH) | Mouser, DigiKey (495-77132-ND), Farnell/Newark | TDK's table (May 2026): Mouser ≈ 500, DigiKey ≈ 1300, but one DigiKey page showed 3 and a 26-week lead time. Order 2 halves per transformer: the gap is in one half; check whether the part number is one gapped half or a set. |
| Core TDK B66317G0000X187 (E25/13/7 N87, ungapped) | DigiKey, Mouser | The user can grind the gap: grind the centre leg of one half until Lp = 1.19 mH (≈ 0.25 mm), and measure Lp as you grind. |
| Coil former TDK B66208B1110T001 (E25/13/7, horizontal) | DigiKey (495-5372-ND) | Pin count and creepage still to confirm in the TDK datasheet; 29-week lead time listed. Yoke/clip B66208A2010X000 (2 per transformer). |
| Coil former Ferroxcube CPH-E25/13/7-1S-10P (horizontal, 10 pins) | DigiKey (1779-1317-ND) | 0 stock in one snapshot, about 10 weeks. Clip CLI-E25/13/7. |
| Norwe 10165-106 (longer-creepage horizontal 10-pin, used by the README design) | not found at Mouser/DigiKey | Specialist magnetics suppliers only. |
| AliExpress / eBay "EE25 5+5 pin" sets | many sellers | PC40 (≈ N87), mostly ungapped: the user grinds the gap, so the cores are usable (check the core size is really E25/13/7, and measure Lp). The bobbins have an unknown insulation rating and pin creepage, so they are no basis for reinforced isolation: use a TDK/Ferroxcube coil former. |

The board footprint (step 3) is drawn from whichever coil former is chosen. Its pin pitch, row spacing and creepage set the reinforced-isolation layout.

**Decision 2026-11-02 (user): vertical coil former.** Candidate: Ferroxcube CPV-E25/13/7-1S-10P-Z
(10 pins, vertical; DigiKey 1779-1359-ND, 0 stock with 250 expected 2027-03-30, 10-week lead
time, about €0.46; datasheet https://www.ferroxcube.com/upload/media/product/file/Pr_ds/E25_13_7.pdf)
with clip CLI-E25/13/7. The winding design is unchanged. Before drawing the footprint (step 3), read the
pin pitch, row spacing and the pin-to-core distances from the datasheet; the reinforced barrier runs
between the two pin rows (primary/bias/Out1 on one row, Out2 on the other) with a slot between them.
The transformer is about 25–30 mm tall. Put it in the lower part of the aux area (y below −18.8),
outside the control card's outline, and glue or clip it to the board.

## 8. Implementation (2026-11-05)

User request 2026-11-05: "do 1, the v5 aux flyback", scope "Flyback + CTRL isolation" (schematic,
board placement only; the logic-area re-layout stays GUI work).

**Bobbin creepage re-check (Ferroxcube CPV-E25/13/7-1S-10P-Z, open item 4).** The CPV drawing is not
on Ferroxcube's site any more (the current E25/13/7 sheet has the core only and lists the CPV as an
accessory); the 2008 data sheet (web archive of ferroxcube.home.pl/prod/assets/e25137.pdf) draws the
horizontal 10-pin CPH (pins 0.7 mm square, 5 mm pitch) and the vertical 6-pin CSV (2 x 3 pins, 5.0 mm
pitch, **rows 12.7 mm apart**, flange 17 x 17.2 mm). The footprint
`ac_psu:Transformer_EE25_Ferroxcube_CPV-E25-13-7-1S-10P_Vertical` therefore assumes 2 x 5 pins on the
CSV grid (5.0 x 12.7 mm, 1.2 mm drills, 2.0 mm pads), body 28 x 20 mm, core 25.8 x 7.5 mm between the
rows. **Verify the pin grid on a CPV sample or drawing before the PCB order.** With that grid:

| Path (B2, 500 V row, reinforced) | Required | Found | Verdict |
|---|---|---|---|
| PCB copper, primary row ↔ Out2 row (pad edge to pad edge) | 5.0 mm printed wiring (10.0 mm material group) | 12.7 − 2.0 = **10.7 mm** | OK in both columns, no slot needed |
| Over the former between the rows (pin edge to pin edge, IIIa) | 10.0 mm | ≥ 12.7 − 0.7 = **12.0 mm** (more along the flange contour) | OK |
| Pins ↔ floating core (each row) | 10.0 mm via the core (sum of both sides) | 6.35 − 3.75 − 0.35 ≈ **2.25 mm** per side | **fails: insulate the core** (3 layers of tape or caps), as in 5.3 |
| Out2 pins 6/7 ↔ cut pins 8-10 | – | pins 8-10 cut, pads unconnected (no domain) | OK |
| CTRL leads (W1 holes) ↔ other domains | 5.0 mm on the PCB (DRC rule), 10 mm to the core outline | placement in the GUI | DRC enforces the PCB part |

The DRC rules of `kicad/ac_psu.kicad_dru` (tools/v4/domain_rules.py: P-I, P-C, I-C 5.0 mm; P/I-E 2.5 mm)
now hold the PCB distances for T1, W1 and all CTRL parts automatically, also for zone fills.

**What was done** (details in STATUS.md "v5 step 1"):
- `tools/v5/v5_parts.py`: the part list (98 parts: 46 on sheet 7, 52 on sheet 11), removed parts,
  renames. `tools/v5/make_v5_lists.py` writes part_map and `lib/v5_deviations.csv`.
- Symbols (gen_symbols.py): UCC28710, IPD95R450P7, MMBT3904/3906, D_TVS, CONN_2, OPA2350EA,
  EE25_AUX_TRANS, CTRL_WINDING, ISO7760F, CA-IS3742, AMC1311, TPS54202; power 15V, 15V_ISO, CTRLGND,
  CTRLGND_A, 3V3_CTRL, 5V_CTRL, 5V_CTRL_A. Pinouts from the TI / Chipanalog data sheets (UCC28710
  SLUSB86C: D package 1 VDD 2 VS 3 CBC 4 GND 5 CS 6 DRV 7 HV; ISO7760 SLLSER1H; AMC1311 SBAS786C;
  TPS54202 SLVSD26C; CA-IS374x Table 6-1).
- Footprints: SOIC-7 (UCC28710, pad 7 at the pin-8 position), D_SMB_AC, the EE25 vertical former,
  the CTRL flying-lead holes (1.6 mm drill, 3.0 mm pads, 5.08 mm).
- Circuit values: as 5.3 (RS1 59.0k, RS2 21.0k, RCBC 118k, RCS 0.562R, RLC 1k to tune, CDD 15u, BAS16
  + 47R from 15V, MMBT3904/3906 buffer, 10R gate, US1M + SMBJ170A clamp, ES2D on Out1/Out2 with
  470u + 4.7k preloads, SS310 + 2 x 470u + 910R on CTRL_RAW, TPS54202 5 V with 15 uH, 100k/13.3k).
  The TI reference design values were used for the TPS54202 (EN divider 511k/105k: start ≈ 7 V).

**Not done in this step:** placement and routing (GUI, D5); the slot under the isolators; the M4
ring-lug terminals for the 17 soldered leads (point 1 of the v4 prompt: still open for v5); fab files
(BOM/CPL after the layout); transformer re-run with MKF (5.3 is still the design).
