johonkanen/ac_psu_kicad/reference/pins_by_net.md

# Pins by net

Generated by `p2k ipc356`. Do not edit. Nets with a single pin are
usually test points or connections made through the ignored-by-IPC copper.

`vias` counts vias and free pads (blank refdes with a net).

| net | pins | vias | members |
|---|---|---|---|
| 3V3_ISO | 19 | 10 | C3-2 C5-2 C37-2 C38-2 C56-2 C80-2 C82-2 C83-2 C86-2 C87-2 REF2-2 U2-5 U4-8 U6-8 U7-8 U10-5 U13-1 U15-1 U16-1 |
| 5V | 10 | 3 | C57-2 C58-2 C67-2 C70-2 J1-45 J2-45 J3-45 U3-1 U3-3 U9-3 |
| 5V_ISOL | 10 | 0 | C4-2 J4-45 J6-45 J8-45 J12-44 J12-46 J12-48 U8-3 U10-1 U10-3 |
| 20V | 10 | 2 | C28-1 C41-1 D2-C D7-A D10-C J1-48 J2-48 J3-48 R20-6 U9-1 |
| 20V_ISO_SEC | 10 | 16 | C15-1 C36-1 D1-C D4-C J4-48 J6-48 J8-48 R49-2 R79-6 U8-1 |
| #00010 | 3 | 1 | R6-1 R7-2 U1-5 |
| #00011 | 3 | 1 | R3-1 R8-2 U1-6 |
| #00012 | 3 | 0 | R8-1 R9-2 U1-7 |
| #00016 | 3 | 3 | R13-1 R21-2 U1-3 |
| #00017 | 3 | 3 | R16-1 R17-2 U1-2 |
| #00018 | 3 | 0 | R17-1 R18-2 U1-1 |
| #00033 | 2 | 0 | R4-1 R5-2 |
| #00034 | 2 | 2 | R5-1 R6-2 |
| #00035 | 2 | 0 | R2-2 R11-1 |
| #00036 | 2 | 2 | R2-1 R3-2 |
| #00037 | 2 | 0 | R12-2 R95-1 |
| #00038 | 2 | 0 | R12-1 R13-2 |
| #00039 | 2 | 0 | R15-1 R16-2 |
| #00040 | 2 | 0 | R14-1 R15-2 |
| #00195 | 3 | 0 | C40-2 R19-1 REF1-3 |
| #00209 | 3 | 0 | C6-2 R32-1 REF2-3 |
| #00226 | 3 | 1 | R35-1 R37-2 U14-3 |
| #00227 | 3 | 0 | R38-1 R39-2 U14-1 |
| #00228 | 3 | 1 | R36-1 R38-2 U14-4 |
| #00231 | 2 | 0 | R27-1 R35-2 |
| #00232 | 2 | 0 | R27-2 R41-1 |
| #00233 | 2 | 0 | R28-2 R42-1 |
| #00234 | 2 | 0 | R28-1 R36-2 |
| #00242 | 3 | 3 | R1-2 R82-1 U2-3 |
| #00243 | 3 | 0 | R76-1 R77-2 U2-1 |
| #00244 | 3 | 3 | R76-2 R85-1 U2-4 |
| #00247 | 2 | 0 | R80-1 R82-2 |
| #00248 | 2 | 0 | R80-2 R81-1 |
| #00249 | 2 | 0 | R83-1 R84-2 |
| #00250 | 2 | 0 | R84-1 R85-2 |
| #00269 | 3 | 3 | R52-2 R71-1 U7-3 |
| #00270 | 3 | 3 | R53-2 R256-1 U7-2 |
| #00271 | 3 | 0 | R53-1 R54-2 U7-1 |
| #00275 | 3 | 3 | R46-2 R67-1 U7-5 |
| #00276 | 3 | 3 | R51-2 R68-1 U7-6 |
| #00277 | 3 | 0 | R51-1 R56-2 U7-7 |
| #00281 | 2 | 0 | R60-1 R61-2 |
| #00282 | 2 | 0 | R61-1 R71-2 |
| #00283 | 2 | 0 | R62-1 R63-2 |
| #00284 | 2 | 0 | R63-1 R256-2 |
| #00285 | 2 | 0 | R65-1 R66-2 |
| #00286 | 2 | 0 | R66-1 R67-2 |
| #00287 | 2 | 0 | R68-2 R69-1 |
| #00288 | 2 | 0 | R69-2 R70-1 |
| #00339 | 2 | 0 | D6-C R23-2 |
| #00340 | 3 | 0 | C62-2 R23-1 R24-2 |
| #00343 | 2 | 1 | PWM1-2 R31-1 |
| #00344 | 5 | 1 | C65-1 C66-1 D7-C PWM1-1 R33-2 |
| #00345 | 2 | 0 | R33-1 R34-2 |
| #00346 | 2 | 0 | R34-1 R43-2 |
| #00348 | 5 | 0 | C71-1 C73-1 D8-C R59-1 U5-1 |
| #00349 | 3 | 0 | C53-1 R57-1 U5-2 |
| #00350 | 3 | 0 | C52-1 R58-1 U5-3 |
| #00354 | 2 | 0 | R55-1 U5-6 |
| #00359 | 4 | 0 | C76-1 C77-1 R75-1 U6-1 |
| #00360 | 3 | 0 | C75-1 R73-1 U6-2 |
| #00361 | 3 | 0 | C74-1 R74-1 U6-3 |
| #00365 | 2 | 0 | R72-1 U6-6 |
| #00390 | 2 | 0 | U11-3 U12-3 |
| #00394 | 3 | 0 | AD1-7 C9-2 R86-1 |
| #00396 | 6 | 0 | AD1-4 AD1-6 C17-2 C18-2 L1-1 U12-5 |
| #00402 | 3 | 0 | R86-2 U12-1 U12-4 |
| #00406 | 2 | 0 | AD1-1 R87-8 |
| #00407 | 2 | 0 | AD1-2 R87-7 |
| #00408 | 2 | 0 | AD1-3 R87-6 |
| #00409 | 2 | 0 | D5-C D10-A |
| #00412 | 3 | 0 | C44-1 Q14-2 R89-1 |
| #00416 | 2 | 0 | D3-C D4-A |
| #00419 | 3 | 0 | C43-1 Q13-2 R78-1 |
| #00427 | 5 | 0 | C55-1 C78-1 D9-C R94-1 U4-1 |
| #00428 | 3 | 0 | C54-1 R92-1 U4-2 |
| #00429 | 3 | 0 | C51-1 R93-1 U4-3 |
| #00431 | 2 | 0 | R50-1 U4-6 |
| #00465 | 2 | 0 | R22-1 U15-11 |
| AC_IN2 | 6 | 0 | ACIN2-1 ACIN2-1 C14-2 C25-2 CM2-4 R95-2 |
| AC_IN_1 | 5 | 1 | ACIN1-1 ACIN1-1 R10-1 R14-2 R20-3 |
| AC_OUT_1 | 4 | 0 | ACOUT1-1 ACOUT1-1 R70-2 R79-3 |
| AC_OUT_2 | 6 | 0 | ACOUT2-1 ACOUT2-1 C31-2 C34-2 CM3-4 R65-2 |
| ADA0 | 1 | 0 | U11-15 |
| ADA1 | 3 | 0 | C42-1 R39-1 U11-14 |
| ADA2 | 2 | 0 | R18-1 U11-13 |
| ADA3 | 2 | 0 | R9-1 U11-12 |
| ADA4 | 1 | 0 | U11-1 |
| ADA5 | 1 | 0 | U11-2 |
| ADA6 | 1 | 0 | U11-4 |
| ADASEL0 | 2 | 0 | U11-11 U15-15 |
| ADASEL0_ISO | 2 | 0 | J11-11 U15-2 |
| ADASEL1 | 2 | 0 | U11-10 U15-14 |
| ADASEL1_ISO | 2 | 0 | J11-10 U15-3 |
| ADASEL2 | 2 | 0 | U11-9 U15-13 |
| ADASEL2_ISO | 2 | 0 | J11-9 U15-4 |
| ADCLK | 2 | 2 | R22-2 U5-7 |
| ADCLK_DAB | 2 | 0 | J11-24 U6-7 |
| ADCLK_ISO | 2 | 0 | J11-7 U15-6 |
| AFE_RELAY | 4 | 0 | C32-2 C34-1 CM3-3 R79-1 |
| AUX_FB | 4 | 1 | D2-A R25-1 R44-1 TR2-3 |
| AUX_FEEDBACK | 6 | 0 | C63-2 R25-2 R26-1 R29-1 R31-2 R44-2 |
| AUX_ISENSE | 4 | 0 | PWM1-4 PWM1-5 R45-1 R47-1 |
| AUX_SWITCH_NODE | 4 | 0 | D6-A PWM1-7 PWM1-8 TR2-2 |
| CLK1 | 2 | 0 | R87-3 U13-12 |
| CLK1_ISO | 2 | 0 | J11-14 U13-5 |
| CMFILT1 | 4 | 0 | C22-2 C24-1 CM1-3 CM2-2 |
| CMFILT2 | 4 | 0 | C23-2 C24-2 CM1-4 CM2-1 |
| CS1 | 2 | 0 | R87-1 U13-11 |
| CS1_ISO | 2 | 0 | J11-13 U13-6 |
| DAB_CAP_PRI | 5 | 0 | C1-2 C35-2 C45-1 C46-1 DAB_PRI_2-1 |
| DAB_CAP_SEC | 5 | 0 | C47-2 C48-2 C49-1 C50-1 DAB_SEC_2-1 |
| DAB_GATE_HI_PRI | 6 | 0 | J3-21 J3-22 J3-23 J3-24 J3-26 Q9-1 |
| DAB_GATE_HI_SEC | 6 | 0 | J4-35 J4-36 J4-37 J4-38 J4-40 Q11-1 |
| DAB_GATE_LO_PRI | 6 | 0 | J3-35 J3-36 J3-37 J3-38 J3-40 Q10-1 |
| DAB_GATE_LO_SEC | 6 | 0 | J4-21 J4-22 J4-23 J4-24 J4-26 Q12-1 |
| DAB_GROUND | 10 | 0 | C49-2 C50-2 J4-15 J4-16 J4-17 J4-18 J4-19 J4-20 Q12-3 R64-4 |
| DAB_PWM_HI_SEC | 2 | 2 | J4-43 J11-27 |
| DAB_PWM_LO_SEC | 2 | 2 | J4-44 J11-29 |
| DAB_PWM_PRI_HI | 2 | 1 | J3-43 U16-14 |
| DAB_PWM_PRI_HI_ISO | 2 | 0 | J11-22 U16-3 |
| DAB_PWM_PRI_LO | 2 | 1 | J3-44 U16-15 |
| DAB_PWM_PRI_LO_ISO | 2 | 0 | J11-23 U16-2 |
| DAB_SHUNT1 | 2 | 0 | R64-2 R73-2 |
| DAB_SHUNT2 | 7 | 0 | C74-2 C75-2 C76-2 C77-2 R64-1 R74-2 U6-4 |
| DAB_SOURCE_HI_PRI | 9 | 0 | DAB_PRI_1-1 J3-15 J3-16 J3-17 J3-18 J3-19 J3-20 Q9-3 Q10-2 |
| DAB_SOURCE_HI_SEC | 9 | 0 | DAB_SEC_1-1 J4-29 J4-30 J4-31 J4-32 J4-33 J4-34 Q11-3 Q12-2 |
| DC+ | 15 | 0 | C1-1 C7-2 C11-1 C12-1 C35-1 C62-1 C68-2 C79-1 Q1-2 Q3-2 Q9-2 R24-1 R41-2 R43-1 TR2-1 |
| DGND | 1 | 0 | U11-6 |
| FILTER_INPUT | 5 | 0 | C20-2 C21-2 CM1-1 FILTER_IN-1 R11-2 |
| G1_GATE_HI | 6 | 0 | J2-35 J2-36 J2-37 J2-38 J2-40 Q1-1 |
| G1_SOURCE_HI | 9 | 0 | J2-29 J2-30 J2-31 J2-32 J2-33 J2-34 Q1-3 Q2-2 R48-4 |
| G2_GATE_LO | 6 | 0 | J1-21 J1-22 J1-23 J1-24 J1-26 Q2-1 |
| G3_GATE_HI | 6 | 0 | J2-21 J2-22 J2-23 J2-24 J2-26 Q3-1 |
| G3_SOURCE_HI | 9 | 0 | AFE_OUT-1 J2-15 J2-16 J2-17 J2-18 J2-19 J2-20 Q3-3 Q4-2 |
| G4_GATE_LO | 6 | 0 | J1-35 J1-36 J1-37 J1-38 J1-40 Q4-1 |
| GND | 54 | 25 | AD1-5 AD1-8 C9-1 C16-1 C17-1 C18-1 C26-1 C27-1 C28-2 C39-1 C40-1 C41-2 C42-2 C44-2 C57-1 C58-1 C63-1 C64-1 C65-2 C66-2 C67-1 C68-1 C69-1 C70-1 C81-1 C84-1 C85-1 J1-46 J2-46 J3-46 PWM1-3 Q14-3 R26-2 R29-2 R30-2 R37-1 R45-2 R47-2 R90-2 R96-1 REF1-1 TR2-4 U1-4 U3-2 U5-5 U9-2 U11-5 U11-7 U11-8 U12-2 U13-9 U14-2 U15-9 U16-9 |
| GPIO_BYPASS_RLY | 3 | 2 | R89-2 R90-1 U15-12 |
| GPIO_BYPASS_RLY_ISO | 3 | 3 | J11-36 R78-2 R88-1 |
| GPIO_BYPASS_RLY_ISOLATED | 2 | 0 | J11-8 U15-5 |
| INDUCTOR_INPUT | 2 | 0 | J7-1 R91-4 |
| INDUCTOR_OUTPUT | 5 | 0 | C29-2 C33-2 CM3-1 J9-1 R62-2 |
| INU_ADCLK | 2 | 1 | J11-32 U4-7 |
| INU_FILTER_INPUT | 5 | 0 | C30-2 C33-1 CM3-2 J10-1 R60-2 |
| INU_SHUNT1 | 2 | 0 | R91-2 R92-2 |
| INU_SHUNT2 | 8 | 0 | C51-2 C54-2 C55-2 C78-2 D9-A R91-1 R93-2 U4-4 |
| ISOADA1 | 2 | 1 | J11-4 R54-1 |
| ISOADA2 | 2 | 1 | J11-3 R56-1 |
| ISOADA3 | 3 | 1 | C2-1 J11-1 R77-1 |
| ISODC+ | 10 | 0 | C8-1 C47-1 C48-1 C59-2 C61-1 C72-1 Q5-2 Q7-2 Q11-2 R81-2 |
| ISOGND | 37 | 17 | C2-2 C3-1 C4-1 C5-1 C6-1 C37-1 C38-1 C43-2 C56-1 C80-1 C82-1 C83-1 C86-1 C87-1 J4-46 J6-46 J8-46 J11-2 J11-5 J12-43 J12-45 J12-47 Q13-3 R1-1 R40-2 R88-2 R97-1 REF2-1 U2-2 U4-5 U6-5 U7-4 U8-2 U10-2 U13-8 U15-8 U16-8 |
| ISOPGND | 21 | 0 | C8-2 C60-1 C61-2 C72-2 J6-15 J6-16 J6-17 J6-18 J6-19 J6-20 J6-29 J6-30 J6-31 J6-32 J6-33 J6-34 Q6-3 Q8-3 R64-3 R83-2 R97-2 |
| ISO_AFE_SDM_RAW_VOLTAGE | 2 | 0 | J8-39 R94-2 |
| ISO_DAB_SDM_RAW_VOLTAGE | 2 | 1 | J4-25 R75-2 |
| JEE | 5 | 0 | C13-2 C25-1 CM2-3 R10-2 R20-1 |
| LEMOUT | 5 | 2 | C19-2 C21-1 CM1-2 FILTER_OUT-1 R4-2 |
| MDATA | 2 | 2 | R55-2 U15-10 |
| MDATA_DAB | 2 | 0 | J11-26 R72-2 |
| MDATA_INU | 2 | 1 | J11-34 R50-2 |
| MDATA_ISO | 2 | 0 | J11-6 U15-7 |
| PE1 | 4 | 0 | C19-1 C20-1 C23-1 PE1-1 |
| PE2 | 2 | 0 | C14-1 PE2-1 |
| PE3 | 2 | 0 | C22-1 PE3-1 |
| PE4 | 2 | 0 | C13-1 PE4-1 |
| PE5 | 3 | 0 | C59-1 C60-2 PE5-1 |
| PE6 | 3 | 0 | C29-1 C30-1 PE6-1 |
| PE7 | 3 | 0 | C31-1 C32-1 PE7-1 |
| PE8 | 3 | 0 | C7-1 C10-2 PE8-1 |
| PGND | 29 | 1 | C10-1 C11-2 C12-2 C45-2 C46-2 C79-2 J1-15 J1-16 J1-17 J1-18 J1-19 J1-20 J1-29 J1-30 J1-31 J1-32 J1-33 J1-34 J3-29 J3-30 J3-31 J3-32 J3-33 J3-34 Q2-3 Q4-3 Q10-3 R42-2 R96-2 |
| PWM_G1 | 2 | 2 | J2-43 U16-12 |
| PWM_G1_ISO | 2 | 0 | J11-20 U16-5 |
| PWM_G2 | 2 | 2 | J1-44 U16-11 |
| PWM_G2_ISO | 2 | 0 | J11-19 U16-6 |
| PWM_G3 | 2 | 2 | J2-44 U16-13 |
| PWM_G3_ISO | 2 | 0 | J11-21 U16-4 |
| PWM_G4 | 2 | 2 | J1-43 U16-10 |
| PWM_G4_ISO | 2 | 0 | J11-18 U16-7 |
| PWM_Q5 | 2 | 1 | J8-44 J11-30 |
| PWM_Q6 | 2 | 0 | J6-43 J11-31 |
| PWM_Q7 | 2 | 1 | J8-43 J11-37 |
| PWM_Q8 | 2 | 0 | J6-44 J11-33 |
| PWM_TRANS1 | 2 | 3 | J1-47 U13-13 |
| PWM_TRANS1_ISO | 2 | 0 | J11-15 U13-4 |
| PWM_TRANS2 | 2 | 3 | J2-47 U13-14 |
| PWM_TRANS2_ISO | 2 | 0 | J11-16 U13-3 |
| PWM_TRANS3 | 2 | 3 | J3-47 U13-15 |
| PWM_TRANS3_ISO | 2 | 0 | J11-17 U13-2 |
| PWM_TRANS4 | 2 | 2 | J4-47 J11-25 |
| PWM_TRANS5 | 2 | 0 | J6-47 J11-35 |
| PWM_TRANS6 | 2 | 1 | J8-47 J11-28 |
| Q5_G | 6 | 0 | J8-21 J8-22 J8-23 J8-24 J8-26 Q5-1 |
| Q5_S | 9 | 0 | INU_OUT2-1 J8-15 J8-16 J8-17 J8-18 J8-19 J8-20 Q5-3 Q6-2 |
| Q6_G | 6 | 0 | J6-35 J6-36 J6-37 J6-38 J6-40 Q6-1 |
| Q7_G | 6 | 0 | J8-35 J8-36 J8-37 J8-38 J8-40 Q7-1 |
| Q7_S | 9 | 0 | J8-29 J8-30 J8-31 J8-32 J8-33 J8-34 Q7-3 Q8-2 R91-3 |
| Q8_G | 6 | 0 | J6-21 J6-22 J6-23 J6-24 J6-26 Q8-1 |
| REF_1V65 | 4 | 2 | R7-1 R19-2 R21-1 R30-1 |
| REF_1V65_ISO | 4 | 2 | R32-2 R40-1 R46-1 R52-1 |
| RELAY_DRIVE | 3 | 0 | D5-A Q14-1 R20-2 |
| RELAY_DRIVE_ISO | 3 | 0 | D3-A Q13-1 R79-2 |
| RET_ISO | 4 | 2 | C15-2 C36-2 R49-1 TR2-6 |
| SDATA1 | 2 | 0 | R87-2 U13-10 |
| SDATA1_ISO | 2 | 0 | J11-12 U13-7 |
| SDM_RAW_VOLTAGE | 2 | 0 | J2-39 R59-2 |
| SEC11 | 2 | 0 | D1-A TR2-7 |
| SHUNT1 | 10 | 0 | C52-2 C53-2 C71-2 C73-2 D8-A J5-1 R48-1 R48-3 R58-2 U5-4 |
| SHUNT2 | 2 | 0 | R48-2 R57-2 |
| VCC | 19 | 12 | C16-2 C26-2 C27-2 C39-2 C64-2 C69-2 C81-2 C84-2 C85-2 L1-2 REF1-2 U1-8 U3-5 U5-8 U11-16 U13-16 U14-5 U15-16 U16-16 |
