johonkanen/ac_psu_kicad/reports/footprint_fit.csv

# IPC frame (mm | Y up): board = (x | y) + R(angle) . M . pad | M = mirror x for bottom. KiCad (Y down): SetPosition(kicad_x | kicad_y); bottom: Flip(pos | LEFT_RIGHT); then SetOrientationDegrees(kicad_orientation)
refdes | footprint | side | angle | x | y | kicad_x | kicad_y | kicad_orientation | max_residual | max_pad_size_diff | max_drill_diff | max_pad_axis_diff
ACIN1 | ac_psu:Terminal_2x1_P5.00mm_D2.0mm_Drill1.4mm | top | 0 | -109.7400 | -46.3800 | -109.7400 | 46.3800 | 0 | 0.0000 | 0.000 | 0.000 | 0
ACIN2 | ac_psu:Terminal_2x1_P5.00mm_D2.0mm_Drill1.4mm | top | 0 | -109.7400 | -40.3800 | -109.7400 | 40.3800 | 0 | 0.0000 | 0.000 | 0.000 | 0
ACOUT1 | ac_psu:Terminal_2x1_P5.00mm_D2.0mm_Drill1.4mm | top | 0 | -104.8000 | -6.5000 | -104.8000 | 6.5000 | 0 | 0.0000 | 0.000 | 0.000 | 0
ACOUT2 | ac_psu:Terminal_2x1_P5.00mm_D2.0mm_Drill1.4mm | top | 0 | -111.0000 | 31.5000 | -111.0000 | -31.5000 | 0 | 0.0000 | 0.000 | 0.000 | 0
AD1 | ac_psu:X2QFN-8_1.5x1.5mm_P0.5mm_ADS7056 | top | 270 | 62.6427 | 7.2190 | 62.6427 | -7.2190 | 270 | 0.0001 | 0.000 | 0.000 | 0
AFE_OUT1 | ac_psu:Terminal_D4.0mm_Drill2.55mm | top | 0 | 47.5000 | -73.6000 | 47.5000 | 73.6000 | 0 | 0.0000 | 0.000 | 0.000 | 0
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
