johonkanen/ac_psu_kicad/source/schematic_pdf/schematic_text.txt

              A                      B                         C                           D                        E                               F                      G                                H                                  J                              K

                                                        DC+
                                                                                                                                                               R20

                                                                                                                                                                                                                                            ac_in_1
                                                                                                                                            20V                 COIL_2        NO
                                                                                                                                                           6                          3                                                                      PE4     PE2
0                                                                                                                                                          5
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
1                  29          30                                                                                                                                                                           1
                                                                                              29          30
                   31          32                                                                                                                                   29              30
    G4_SOURCE_LO                          G4_SOURCE_LO                                        31          32
                   33          34                                          G1_SOURCE_HI                              G1_SOURCE_HI                                   31              32
                                                                                              33          34                          DAB_SOURCE_LO_PRI                                      DAB_SOURCE_LO_P
                   35          36                                                                                                                                   33              34
                                                                                              35          36
                   37          38                                                                                                                                   35              36
      G4_GATE_LO                          G4_GATE_LO                                          37          38
                   39          40                                         G1_GATE_HI                                 G1_GATE_HI                                     37              38
                                                                                              39          40                               DAB_GATE_LO_PRI                                   DAB_GATE_LO_PRI
                                                                    SDM_RAW_VOLTAGE                                                                                 39              40
2                  43          44                                                                                                                                                                           2
        PWM_G4                            PWM_G2                                              43          44
                   45          46                                              PWM_G1                                PWM_G3                                         43              44
             5v                           GND                                                 45          46                               DAB_PWM_PRI_HI                                    DAB_PWM_PRI_LO
                   47          48                                                   5v                               GND                                            45              46
     PWM_TRANS1                           20V                                                 47          48                                           5v                                    GND
                                                                            PWM_TRANS2                               20V                                            47              48
                                                                                                                                              PWM_TRANS3                                     20V
                        HB GT CONNECTOR
                                                                                                   HB GT CONNECTOR
                                                                                                                                                                         HB GT CONNECTOR
3                                                                                                                                                                                                           3
                        J6                                                                         J8                                                                    J4
                   15          16                                                             15          16
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
                   43          44                                                             43          44
        PWM_Q6                            PWM_Q8                               PWM_Q7                                PWM_Q5                                         43              44
                   45          46                                                             45          46                               DAB_PWM_HI_SEC                                    DAB_PWM_LO_SEC
         5V_ISOL                          ISOGND                                5V_ISOL                              ISOGND                                         45              46
                   47          48                                                             47          48                                      5V_ISOL                                    ISOGND
     PWM_TRANS5                           20V_ISO_SEC                       PWM_TRANS6                               20V_ISO_SEC                                    47              48
6                                                                                                                                             PWM_TRANS4                                     20V_ISO_SEC 6
                        HB GT CONNECTOR                      J11                                   HB GT CONNECTOR
                                                                                                                                                                         HB GT CONNECTOR
                                                        38            37
                                                                                  PWM_Q7
                                                        36            35
                        GPIO_BYPASS_RLY_ISO                                       PWM_TRANS5
                                                        34            33
                                  MDATA_INU                                       PWM_Q8
                                                        32            31
                                  INU_ADCLK                                       PWM_Q6
                                                        30            29
7                                    PWM_Q5
                                                        28            27
                                                                                  DAB_PWM_LO_SEC                                                     J12                                                    7
                                PWM_TRANS6                                        DAB_PWM_HI_SEC
                                                        26            25                                                                        43             44
                                 MDATA_DAB                                        PWM_TRANS4                                      ISOGND                                 5V_ISOL
                                                        24            23                                                                        45             46
                                 ADCLK_DAB                                        DAB_PWM_PRI_LO_ISO                              ISOGND                                 5V_ISOL
                                                        22            21                                                                        47             48
                         DAB_PWM_PRI_HI_ISO                                       PWM_G3_ISO                                      ISOGND                                 5V_ISOL
                                                        20            19
                                PWM_G1_ISO                                        PWM_G2_ISO
                                                        18            17                                                                             2X3 PIN 50TH CONNECTOR
                                PWM_G4_ISO                                        PWM_TRANS3_ISO
8                                                       16            15                                                                                                                                    8
                            PWM_TRANS2_ISO                                        PWM_TRANS1_ISO
                                                        14            13
                                    CLK1_ISO                                      CS1_ISO
                                                        12            11
                                 SDATA1_ISO                                       ADASEL0_ISO
                                ADASEL1_ISO
                                                        10
                                                         8
                                                                      9
                                                                      7
                                                                                  ADASEL2_ISO                                 FILE NAME:    single_phase_inverter_psu_v3.pdsprj
                                                                                                                                                                       DATE:
                   GPIO_BYPASS_RLY_ISOLATED
                                  MDATA_ISO
                                                         6            5
                                                                                  ADCLK_ISO
                                                                                  ISOGND                                      DESIGN TITLE: Inverter PSU
                                                                                                                                                                       26/01/2025
                                                         4            3
9
                                     ISOADA1
                                      ISOGND
                                                         2            1
                                                                                  ISOADA2
                                                                                  ISOADA3                                     PATH:
                                                                                                                                     fpga connector                    PAGE:                                9
                                                                                                                                                                                         2   of 11
                                                             38 PIN HEADER 50TH                                               BY: JH                                     REV:   0        TIME:   11.34.56
       A            B                     C                     D                       E                F                    G                      H                      J                     K

    A                      B                                       C                          D              E                  F                               G                   H                         J                      K

                                                                                                                             REF1
                                                                                                                             REF3025
0                                                                  U3                                                                                                                                                                          0
                                                             1                     4                                                                                        R19
                    5v                                              IN        NR
                                                             2                     5                                     2                              3
                                                                    GND      OUT                     3v3   3v3                VIN            VOUT                                               REF_1V65
                                                             3                                                                                                              420R
                                                                    EN
                                   C70                             TPS73033DBVT                                                                                            C40          R30
1                                  100n
                                                                                              C69                   C16
                                                                                                                                       GND                                 1u
                                                                                                                                                                                        820R                                                   1
                                                                                              100n
                                                                                                                    1u
                                                                                                                                       1

2                                                      GND
                                                                                                                                       GND                                                                                                     2

                                   U9
                               1
              20V                   +VIN
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
                                                                                                                                                                                      DATE:
                                                        ISOPGND

                                                                                                                                             DESIGN TITLE: Inverter PSU
                                                                                                                                                                                      26/01/2025
9                                                                                                                                            PATH:
                                                                                                                                                    DC links                          PAGE:                                                                  9
                                                                                                                                                                                                                                      4    of 11
                                                                                                                                             BY: JH                                                              REV:    0            TIME:    11.34.56
            A                   B                           C                 D                        E                         F           G                                    H                                 J                           K

            A                        B                         C                                      D                                 E                              F                             G                                H                          J                        K

                                IKZ50N65EH5XKSA1                             INU_SHUNT1                                 INU_SHUNT2                                           20V_ISO_SEC
                                                                                                                                                                                                                         RELAY_DRIVE_ISO
0                                                                                                                                                                                                                                                                                                       0
                                             ISODC+                                                   R91                                                                                     R79
                                                                                                  2                      1
                                                                                                          2         1
                                                                                                  4                      3                                                                         COIL_2          NO
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
                                                                                 1                  3                1
                                                                DAB_PRI_2

                                                  dab_cap_pri
                                                                PIN                                                      PIN
4                                                                                                                                                                                    4

                                                                                                                                                      1
                                                                1
                                                                                 2                  4                                   DAB_CAP_SEC

5                                                                                     ETD34 TRAN 1P1S                                                                                5
                             Q10
                             C3M0065090D                                                                         Q12
       DAB_GATE_LO_PRI                                                                                           C3M0065090D
    DAB_SOURCE_LO_PRI                                                                  DAB_GATE_LO_SEC
                                              C46               C45                                                                       C50         C49
6                                             2.2u              2.2u                                                                      2.2u        2.2u                           6
                                                                                     DAB_SOURCE_LO_SEC

                                                                                                                         DAB_GROUND
                                       PGND
7                                                                                                                                                                                    7

8                                                                                                                                                                                    8

                                                                                                            FILE NAME:    single_phase_inverter_psu_v3.pdsprj
                                                                                                                                                     DATE:

                                                                                                            DESIGN TITLE: Inverter PSU
                                                                                                                                                     26/01/2025
9                                                                                                           PATH:
                                                                                                                   Dual Active Bridge                PAGE:                           9
                                                                                                                                                                  6   of 11
                                                                                                            BY: JH                               REV:         0   TIME:   11.34.56
          A              B         C          D                              E                          F   G                       H                     J                K

             A                 B                            C                   D                           E                        F                                                G              H                        J                        K
  vsense nominal = 1.536 V
0
  vsense OVP threshold = 1.838 V                                                                                                                                                                                                                                     0
  Isense pk = 1V                                                                              D2
  Vpeak = 520V                  20V                                                                                                                                                   TR2

                                                                 DC-
                                                                                              ES1A
                                                                       C28             C41                                                                                       1                    10
                                                                       220u            4.7u
1                                                                                                                                                                                2                    9                                                              1
                                                                                                                                                                                                           Sec11
                                                                                                                                                                                 3                    8
                                                C67                    C58                                                                                                                                          D1
                                                     100u
                                                                        22u
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
                                                                                                                                                                                DC-
                                                                                                      DC-

                                                                                                     RET_iso                  ISO_GND
                                                                                                                                                                                      FILE NAME:    single_phase_inverter_psu_v3.pdsprj
                                                                                                                                                                                                                               DATE:
               Vsense @ 1.536V = 5.8368Vaux                                                                                                                                           DESIGN TITLE: Inverter PSU
                                                                                                                                                                                                                               26/01/2025
9                                                                                                                                                                                            Auxiliary supply                  PAGE:                                 9
                                                                                                                 Isense ocp = 1.15V                                                   PATH:                                                7   of 11
                                                                                                                                                                                      BY: JH                               REV:   0        TIME:      11.34.56
             A                 B                            C                   D                           E                        F                                                G              H                        J                        K

    A                      B                     C                        D                       E                                F                      G                          H             J                        K

                                                                                                                                                                       3v3
0                                                                                                                                                                                                                                     0
                                                     R59
         SDM_raw_voltage                                                                                                                                                      C64
                                                     470R                                                                                                                     100n

1                                                                    D8             C73               C71                                                                                                                             1
                                                                                    100n              100n
                                                                     MM3Z5V1T1_1
                                                                                                                        U5                                             GND
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
                                                                              10R
                                                                                                                            ADUM7701-8BRIZ-RL7

8                                  R64                                                                                                                                                                                                8
                               2             1                                               C74               C75
          dab_shunt1                2    1                  DAB_SHUNT2                       220p              220p
                               4             3
          dab_ground                4    3                  ISOPGND                                                                                       FILE NAME:    single_phase_inverter_psu_v3.pdsprj
                                                                                                                                                                                                   DATE:
                                   FKK5R0020FE-TR
                                                                                                                                                          DESIGN TITLE: Inverter PSU
                                                                                                                                                                                                   26/01/2025
9                                                                                                                                                         PATH:
                                                                                                                                                                 SDM current measurements          PAGE:                              9
                                                                                                                                                                                                                   8   of 11
                                                                                                                                                          BY: JH                                REV:     0         TIME:   11.34.56
    A                      B                     C                        D                       E                                F                      G                          H             J                        K

    A                          B                   C                     D             E          F                 G                    H              J                    K

0   3V3                                                                                                                                                                               0

          C39                                                                                   3V3
          1u     AGND        DC-
1                                                                                                                                                                                     1
                                                                                                                                             R87:A
    DC-                                                                                           L1                                                                CS1
                                                                                                  22uH                                       RESISTOR_ARRAY
                              check logic
2                                                                        U12                                                                 R87:B                                    2
                                                                                                                                                                    SDATA1

                                                                    5
                              U11                                                                                 AD1                        RESISTOR_ARRAY
                        13                     3              3                  R86                          8                      1
          ADA2                 X0          X                                                                       AINM         CS
                        14                                                   1                                7                      2
          ADA1                 X1                                                                                  AINP        SDO
                        15                                    4                  10R                          6                      3
          ADA0                 X2                                                                                  AVDD       SCLK           R87:C
                        12                                                                                    5                      4
3         ADA3                 X3                                                                                  GND        DVDD                                                    3
                         1                                                                                                                                          CLK1
          ADA4                 X4                      C18

                                                                    2
                         5                                                                                        ADS7056                    RESISTOR_ARRAY
          AGND                 X5                      100n              TLV316IDBVR
                         2
          ADA5                 X6
          ADA6
                         4
                               X7                                                          C9          C17
                                                                                                       100n
                        11                                                                 1n
    ADASEL0                    A
                        10
4   ADASEL1                    B                                                                                                                                                      4
                         9
    ADASEL2                    C
                         6
      DGND                     INH
                                                                                                AGND
                              SN74LV4051                          AGND
                              VDD=3V3
                              VEE=AGND
5                             VSS=AGND                                                                                                                                                5

6                                                                                                                                                                                     6

7                                                                                                                                                                                     7

8                                                                                                                                                                                     8

                                                                                                                     FILE NAME:   single_phase_inverter_psu_v3.pdsprj
                                                                                                                                                             DATE:

                                                                                                                    DESIGN TITLE: Inverter PSU
                                                                                                                                                             26/01/2025
9                                                                                                                   PATH:
                                                                                                                           primary side ADC                  PAGE:                    9
                                                                                                                                                                9    of 11
                                                                                                                     BY: JH                          REV:   0   TIME:      11.34.56
    A                          B                   C                     D             E          F                 G                    H              J                    K

    A                      B                         C                         D                   E                              F                       G                           H                       J                      K
                                                                                                                                                                3V3_ISO

0                                                                                                                                                                                                                                              0
                                                               R94
          iso_afe_SDM_raw_voltage
                                                               470R                                                                                                      C37
                                                                                                                                                                         100n

                                                                                   D9            C78           C55
1                                                                                                100n          100n                                                                                                                            1
                                                                                   MM3Z5V1T1_1

                                                                                        R92                                      U4                             ISOGND
                                                                                                                             1                        8
                                                            INU_SHUNT1                                                            VDD1    VDD2                    3V3_ISO
                                                                                        10R                                  2                        7                         R50
                                                                                                                                  VIN+   MCLKIN                   INU_ADclk
                                                                                        R93                                  3                        6
                                                                                                                                  VIN-    MDAT                                                    Mdata_INU
                                                                                                                             4                        5                         33R
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

0                                                                                                                                                                                    0

                                                                          U15
                                                                 16                       1
        3V3                                                                VDD2    VDD1                                                         3V3_ISO
                                                                 15                       2
                                                       ADASEL0             B1        A1           ADASEL0_ISO
1                                                                14                       3                                                                                          1
                                                       ADASEL1             B2        A2           ADASEL1_ISO
                                                                 13                       4
                    C85                                ADASEL2
                                                                 12
                                                                           B3        A3
                                                                                          5
                                                                                                  ADASEL2_ISO                       C86
                    100n               R22     GPIO_BYPASS_RLY
                                                                 11
                                                                           B4        A4
                                                                                          6
                                                                                                  GPIO_BYPASS_RLY_ISOlated          100n
                           ADCLK                                           B5        A5           ADCLK_ISO
                                       39R                       10                       7
                                                        MDATA              B6        A6           MDATA_ISO
                                                                  9                       8
        GND                                                                GND2    GND1                                                         ISOGND
2                                                                         Si8661BD-B-IS                                                                                              2

                                                                          U13
                                                                 16                       1
              3V3                                                          VDD2    VDD1                                           3V3_ISO
                                                                 15                       2
                                                  PWM_TRANS3               B1        A1           PWM_TRANS3_ISO
                                                                 14                       3
                                                  PWM_TRANS2               B2        A2           PWM_TRANS2_ISO
3                                                                13                       4                                                                                          3
                                        C84       PWM_TRANS1
                                                                 12
                                                                           B3        A3
                                                                                          5
                                                                                                  PWM_TRANS1_ISO           C83
                                        100n            CLK1               B4        A4           CLK1_ISO                 100n
                                                                 11                       6
                                                         CS1               B5        A5           CS1_ISO
                                                                 10                       7
                                                      SDATA1               B6        A6           SDATA1_ISO
                                                                  9                       8
              DC-                                                          GND2    GND1                                           ISOGND
                                                                          Si8661BD-B-IS
4                                                                                                                                                                                    4
                                                                          U16
                                                                 16                       1
              3V3                                                          VDD2    VDD1                                               3V3_ISO
                                                                 15                       2
                                               DAB_PWM_PRI_LO              B1        A1           DAB_PWM_PRI_LO_ISO
                                                                 14                       3
                                               DAB_PWM_PRI_HI              B2        A2           DAB_PWM_PRI_HI_ISO
                                        C81           PWM_G3
                                                                 13
                                                                           B3        A3
                                                                                          4
                                                                                                  PWM_G3_ISO                 C82
5                                       100n                     12                       5                                  100n                                                    5
                                                      PWM_G1               B4        A4           PWM_G1_ISO
                                                                 11                       6
                                                      PWM_G2               B5        A5           PWM_G2_ISO
                                                                 10                       7
                                                      PWM_G4               B6        A6           PWM_G4_ISO
                                                                  9                       8
              GND                                                          GND2    GND1                                               ISOGND
                                                                          Si8660BD-B-IS

6                                                                         U17                                                                                                        6
                                                                 16                       1
                                                                           VDD2    VDD1
                                                                 15                       2
                                                                           B1        A1
                                                                 14                       3
                                                                           B2        A2
                                                                 13                       4
                                                                           B3        A3
                                                                 12                       5
                                                                           B4        A4
                                                                 11                       6
                                                                           B5        A5
7                                                                10
                                                                           B6        A6
                                                                                          7                                                                                          7
                                                                  9                       8
                                                                           GND2    GND1
                                                                          Si8661BD-B-IS

8                                                                                                                                                                                    8

                                                                                                              FILE NAME:   single_phase_inverter_psu_v3.pdsprj
                                                                                                                                                      DATE:

                                                                                                             DESIGN TITLE: Inverter PSU
                                                                                                                                                      26/01/2025
9                                                                                                            PATH:
                                                                                                                    signal isolators                  PAGE:                          9
                                                                                                                                                                  11 of 11
                                                                                                              BY: JH                                  REV:    0   TIME:   11.34.56
    A         B                    C                D                 E                       F              G                       H                    J                K
