johonkanen/ac_psu_kicad/reports/ctrliso/card_area_B.png

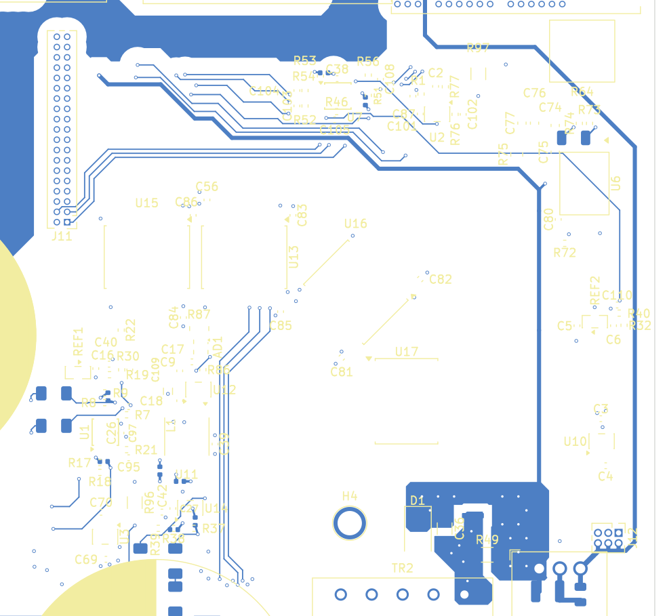
reports/ctrliso/card_area_B.png
