johonkanen/ac_psu_kicad/reports/ctrliso/card_area_F.png

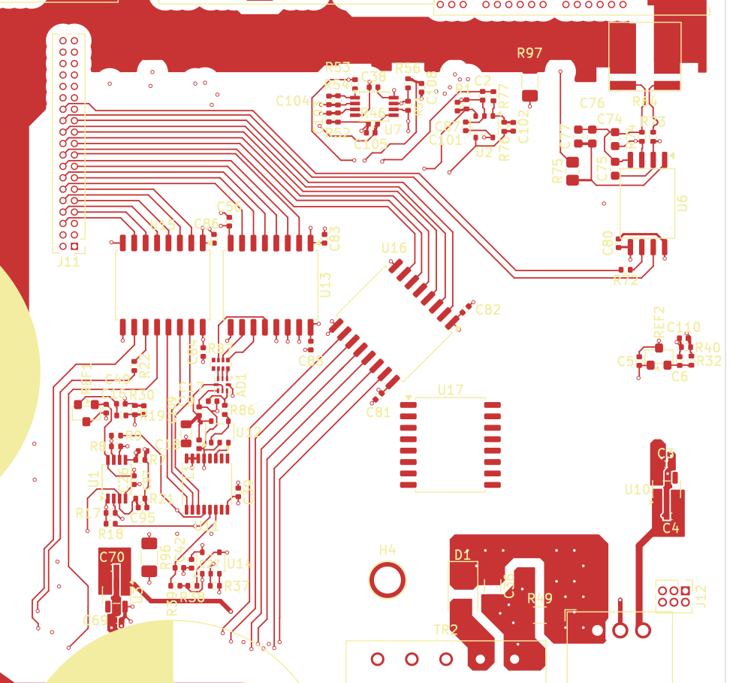
reports/ctrliso/card_area_F.png
