johonkanen/ac_psu_kicad/reports/ctrliso/card_area_In1.png

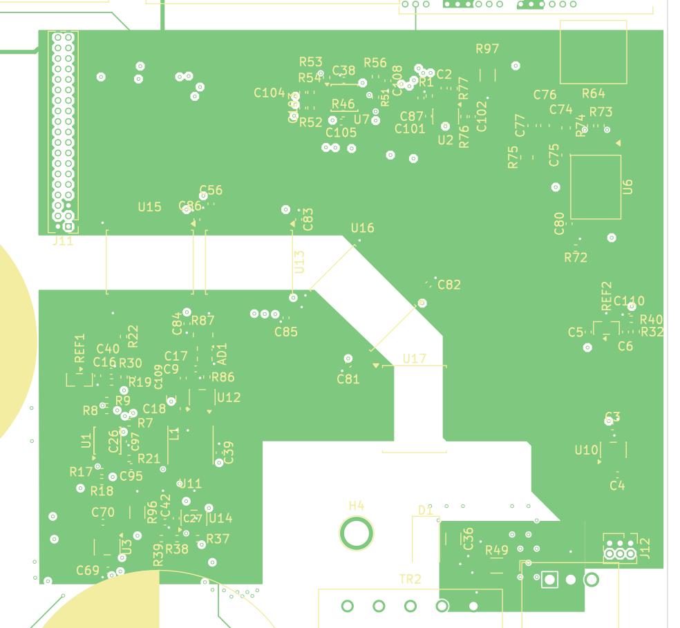
reports/ctrliso/card_area_In1.png
