johonkanen/ac_psu_kicad/reports/noise/01_overview_taps.png

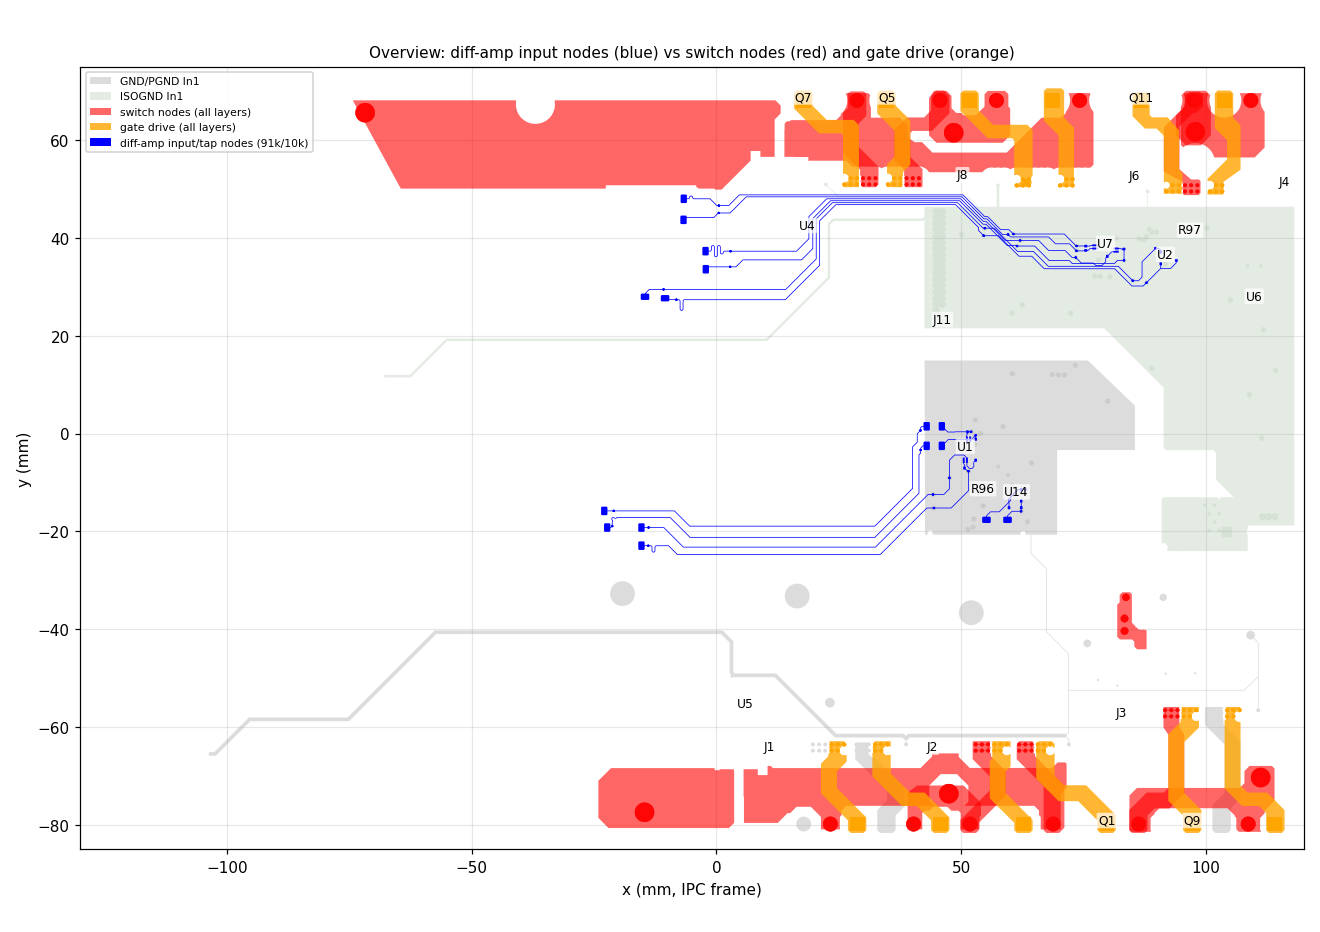
reports/noise/01_overview_taps.png
