johonkanen/ac_psu_kicad/reports/noise/02_inverter_U7_U2_In2.png

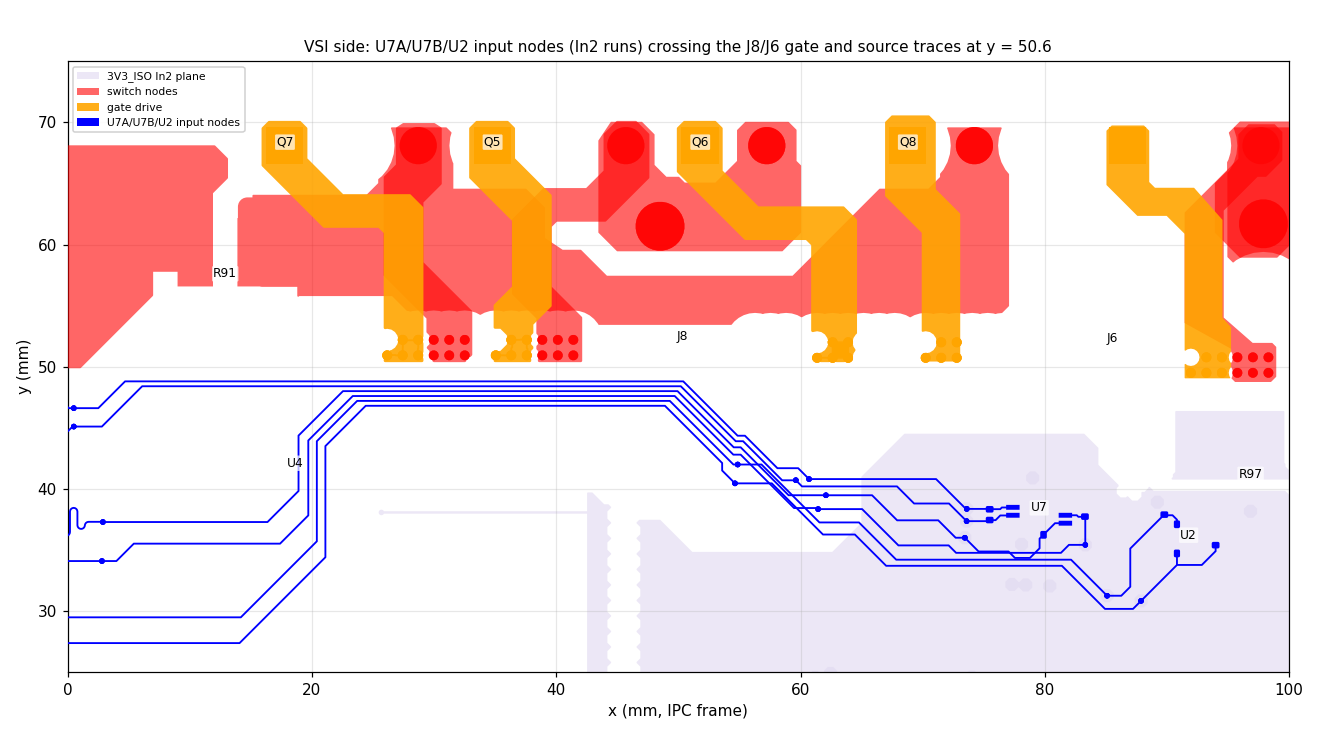
reports/noise/02_inverter_U7_U2_In2.png
