johonkanen/ac_psu_kicad/reports/noise/03_afe_side_U1_U14.png

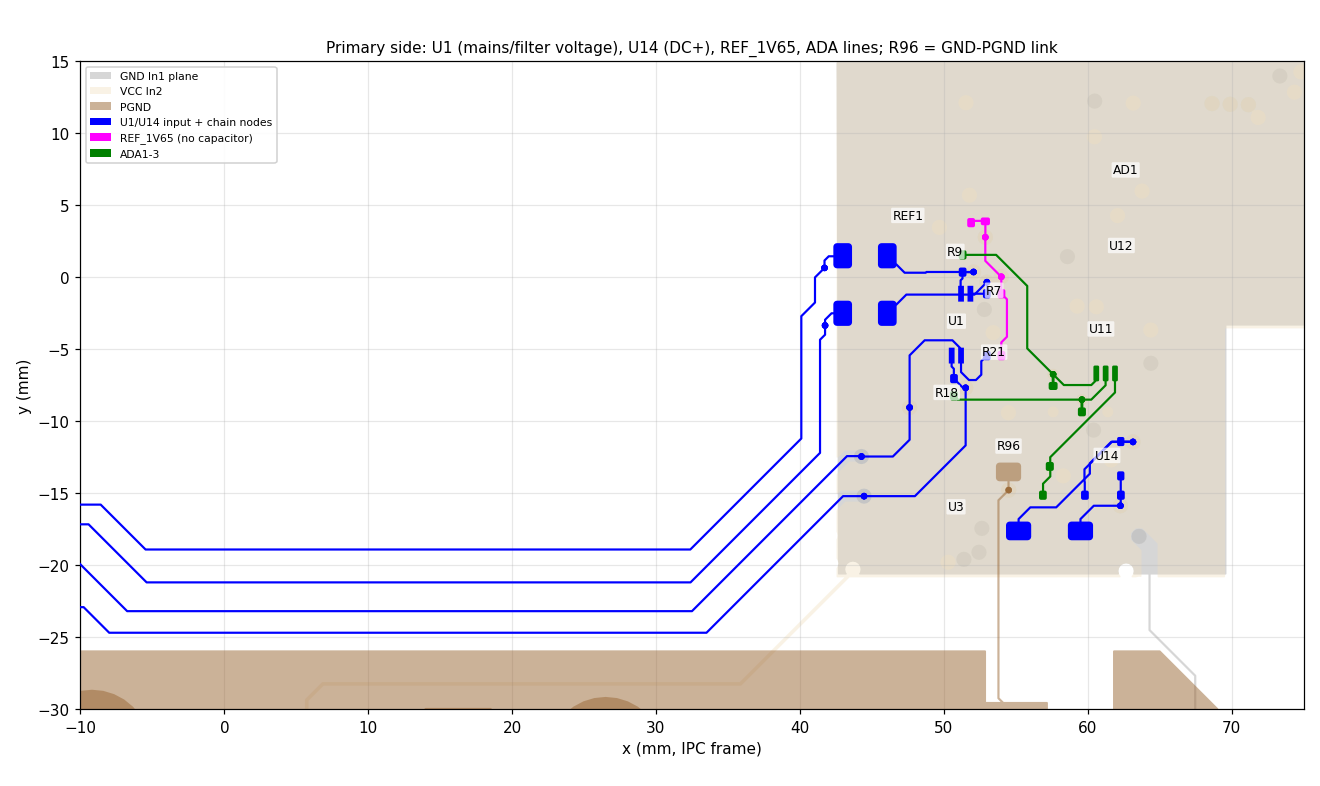
reports/noise/03_afe_side_U1_U14.png
