johonkanen/ac_psu_kicad/reports/noise/04_shunt_R48_U5.png

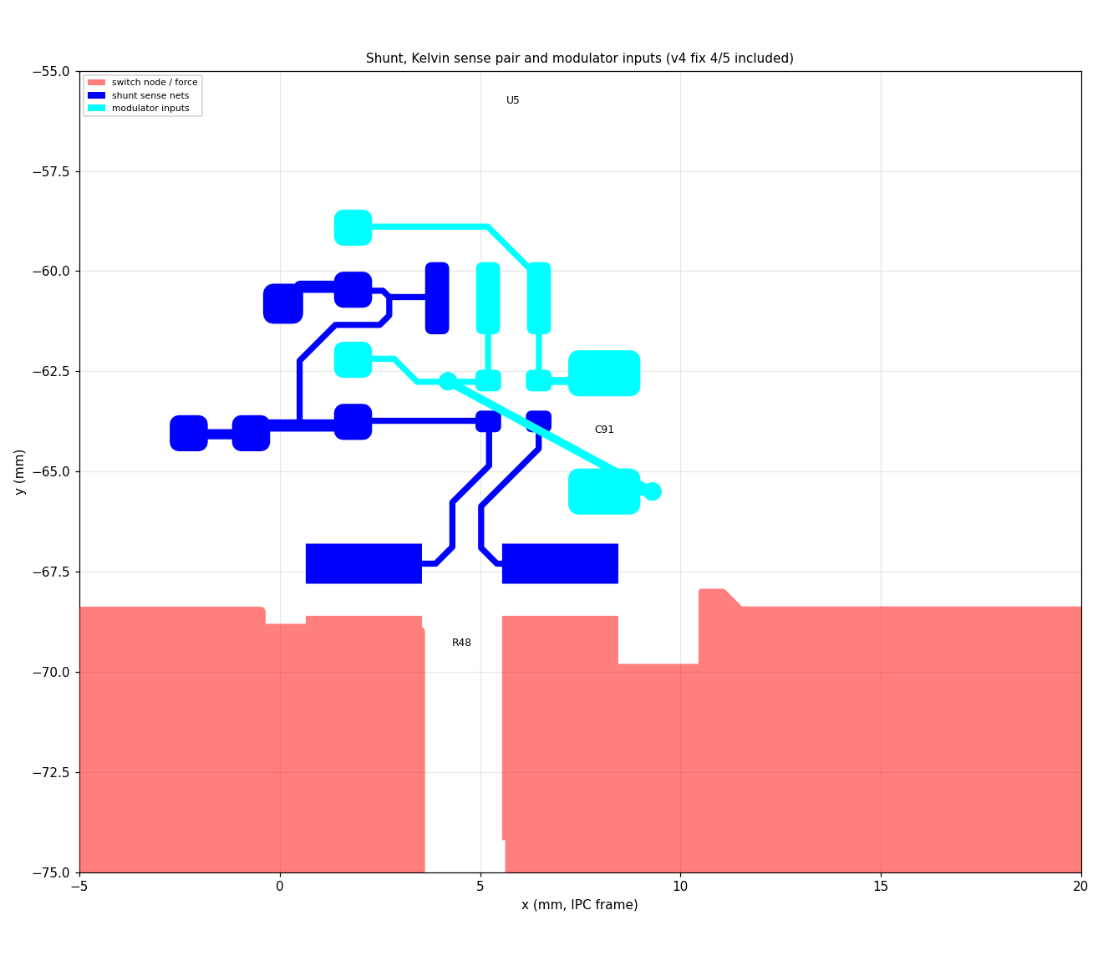
reports/noise/04_shunt_R48_U5.png
