johonkanen/ac_psu_kicad/reports/noise/05_shunt_R91_U4.png

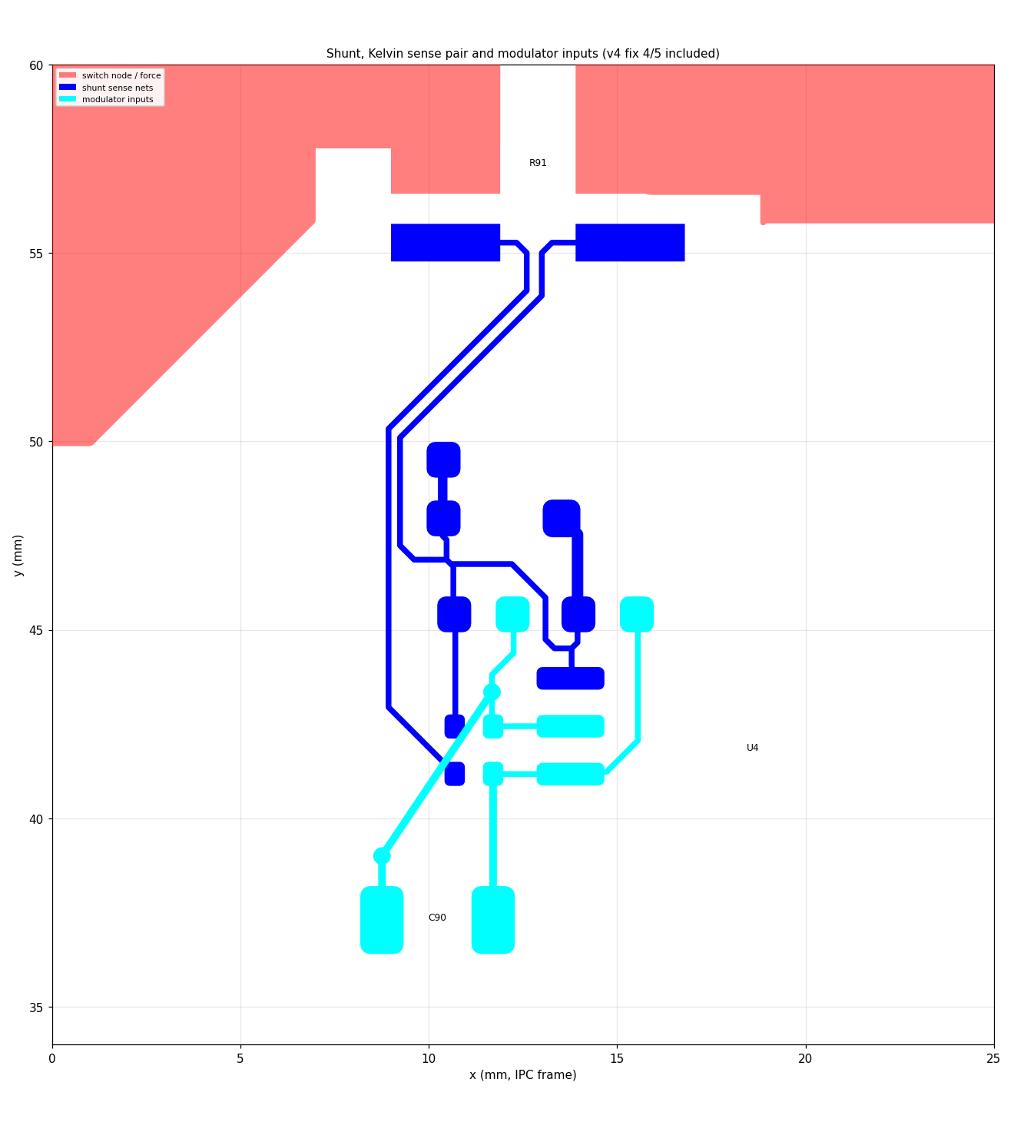
reports/noise/05_shunt_R91_U4.png
