johonkanen/ac_psu_kicad/reports/render/01_afe.png

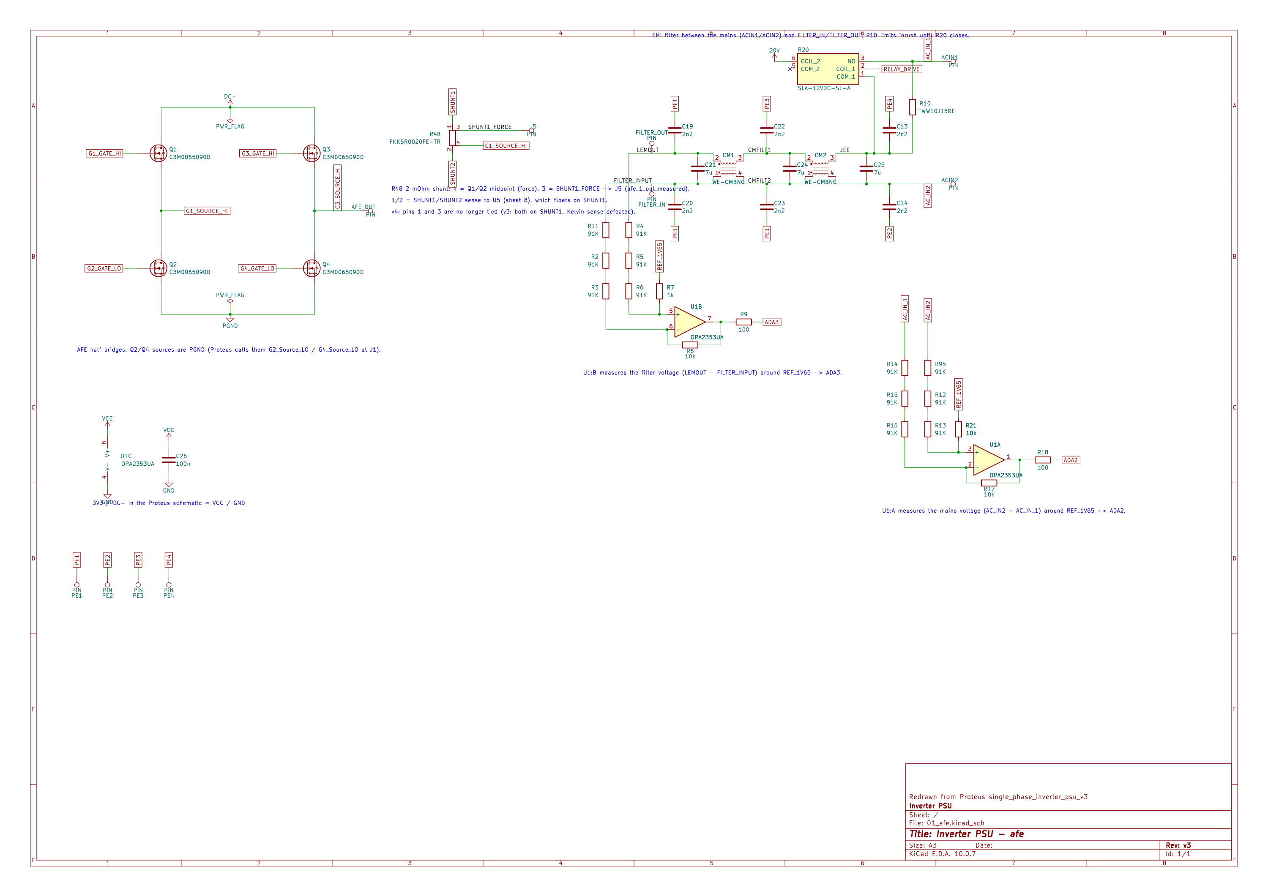
reports/render/01_afe.png
