johonkanen/ac_psu_kicad/reports/render/02_fpga_connector.png

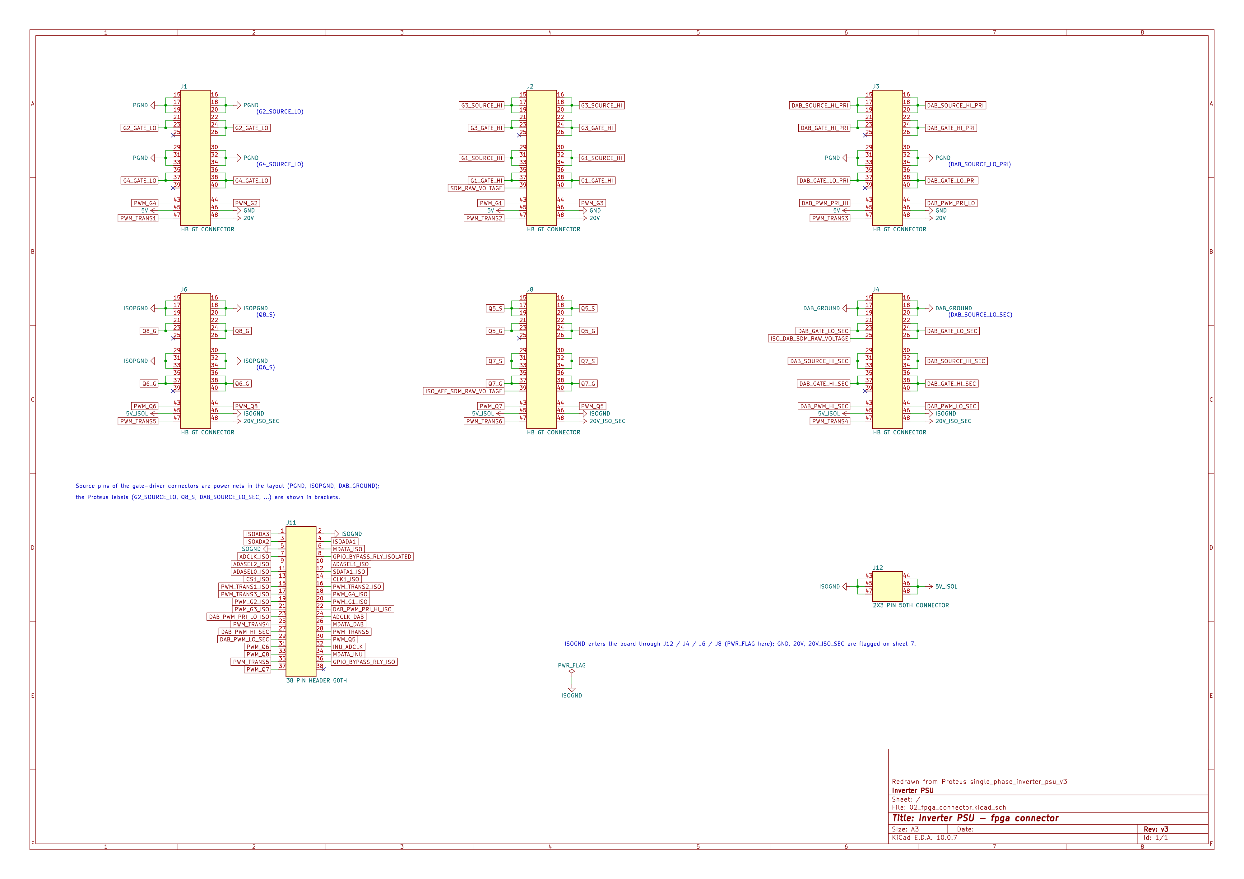
reports/render/02_fpga_connector.png
