johonkanen/ac_psu_kicad/reports/render/03_regulators.png

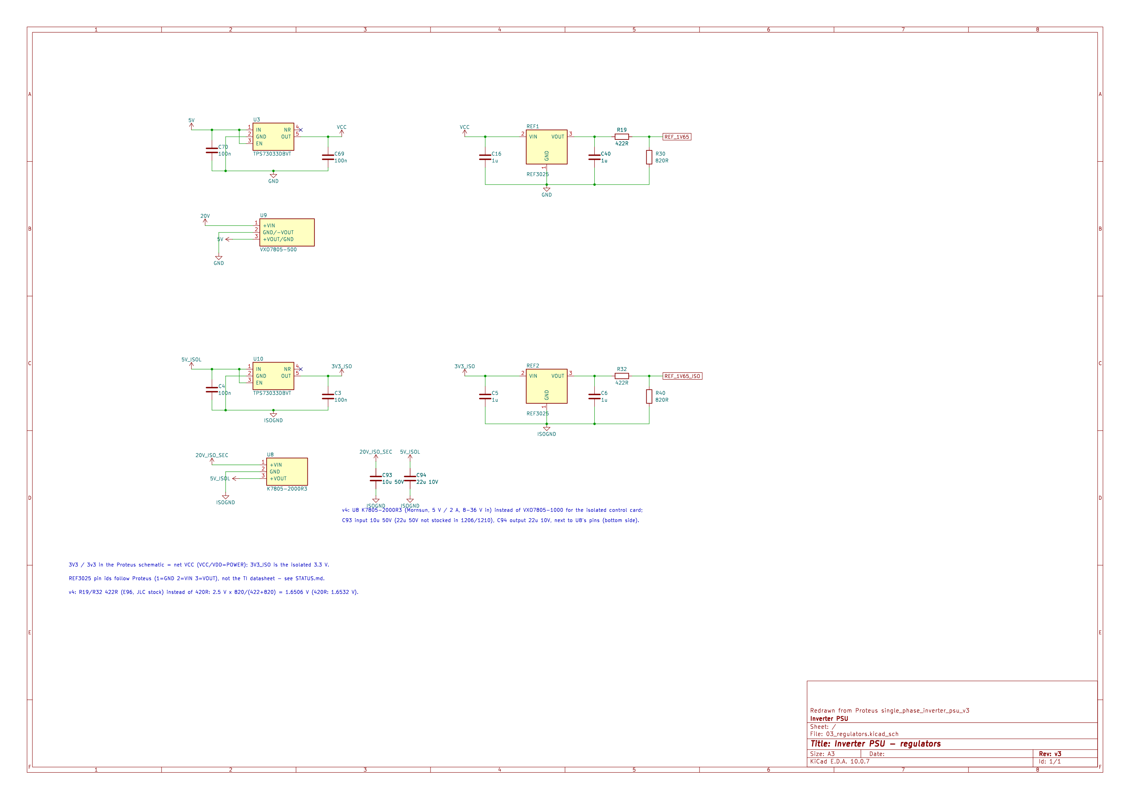
reports/render/03_regulators.png
