johonkanen/ac_psu_kicad/reports/render/04_dc_links.png

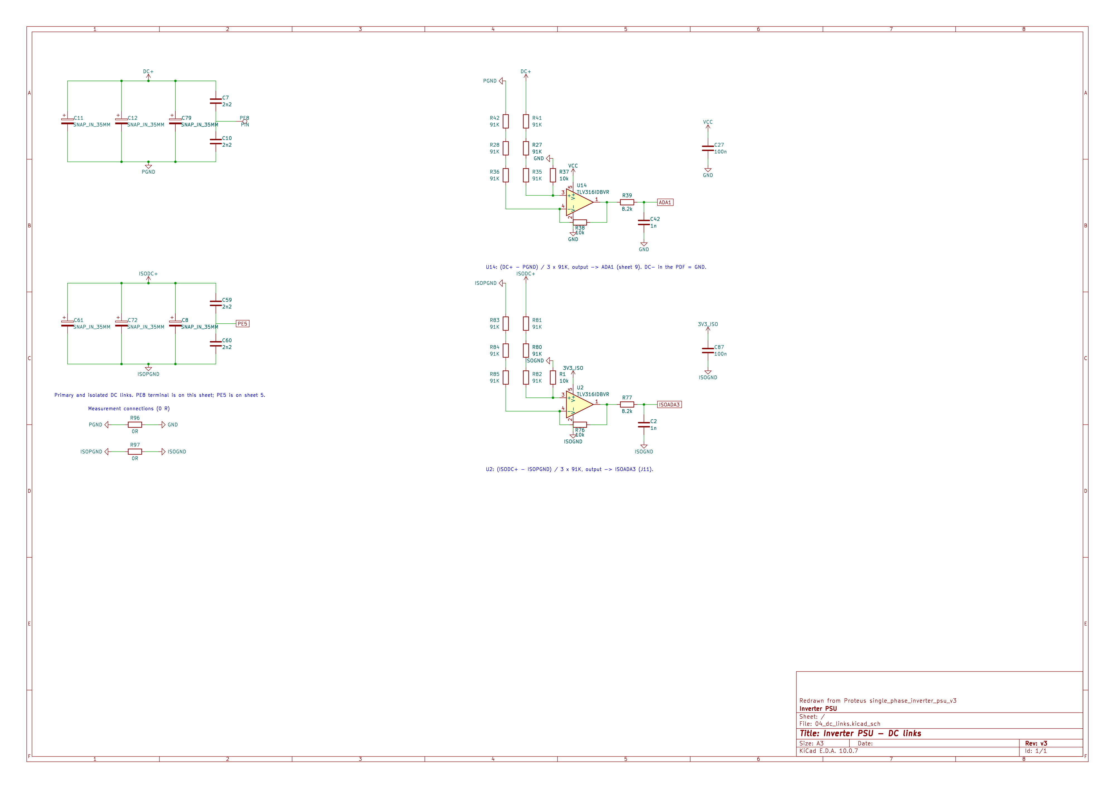
reports/render/04_dc_links.png
