johonkanen/ac_psu_kicad/reports/render/06_dual_active_bridge.png

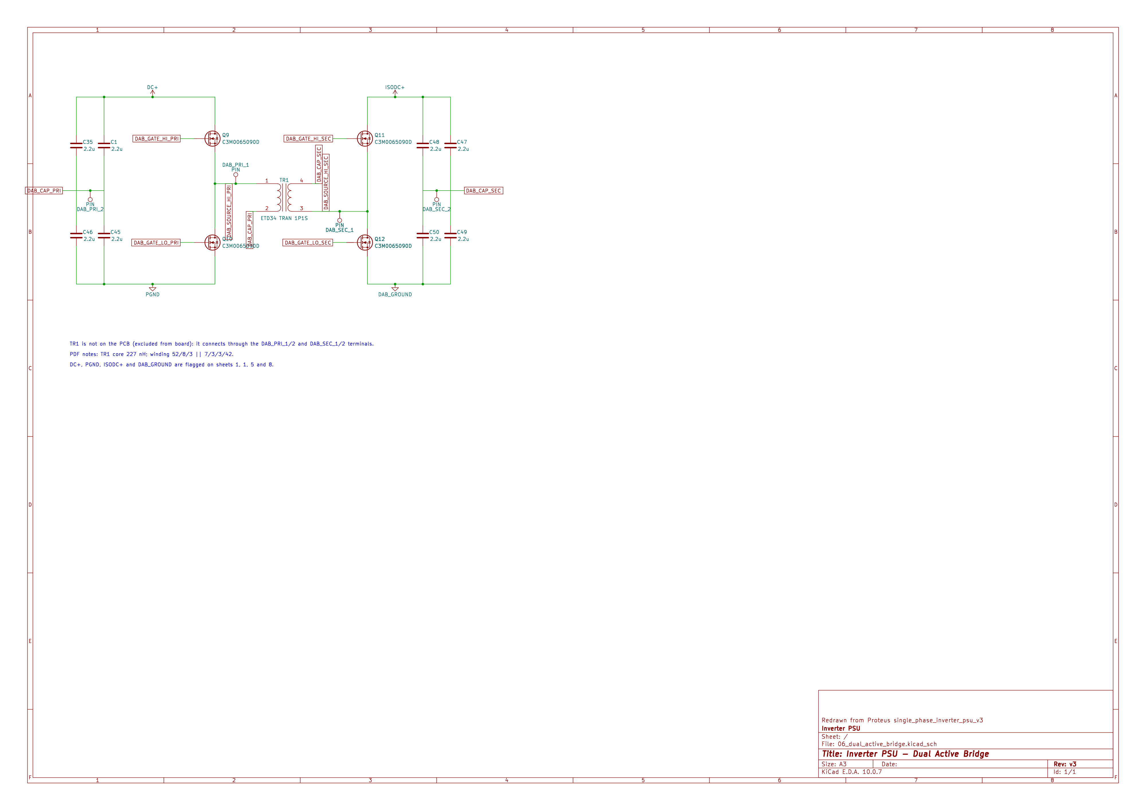
reports/render/06_dual_active_bridge.png
