johonkanen/ac_psu_kicad/reports/render/07_auxiliary_supply.png

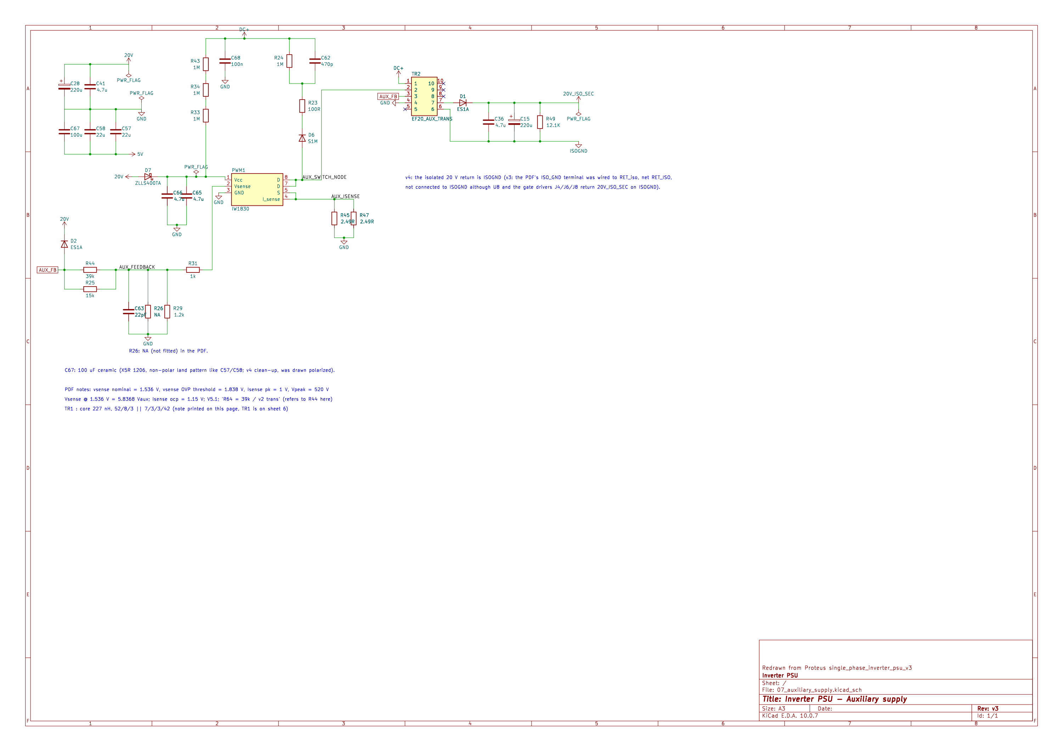
reports/render/07_auxiliary_supply.png
