johonkanen/ac_psu_kicad/reports/render/09_primary_side_adc.png

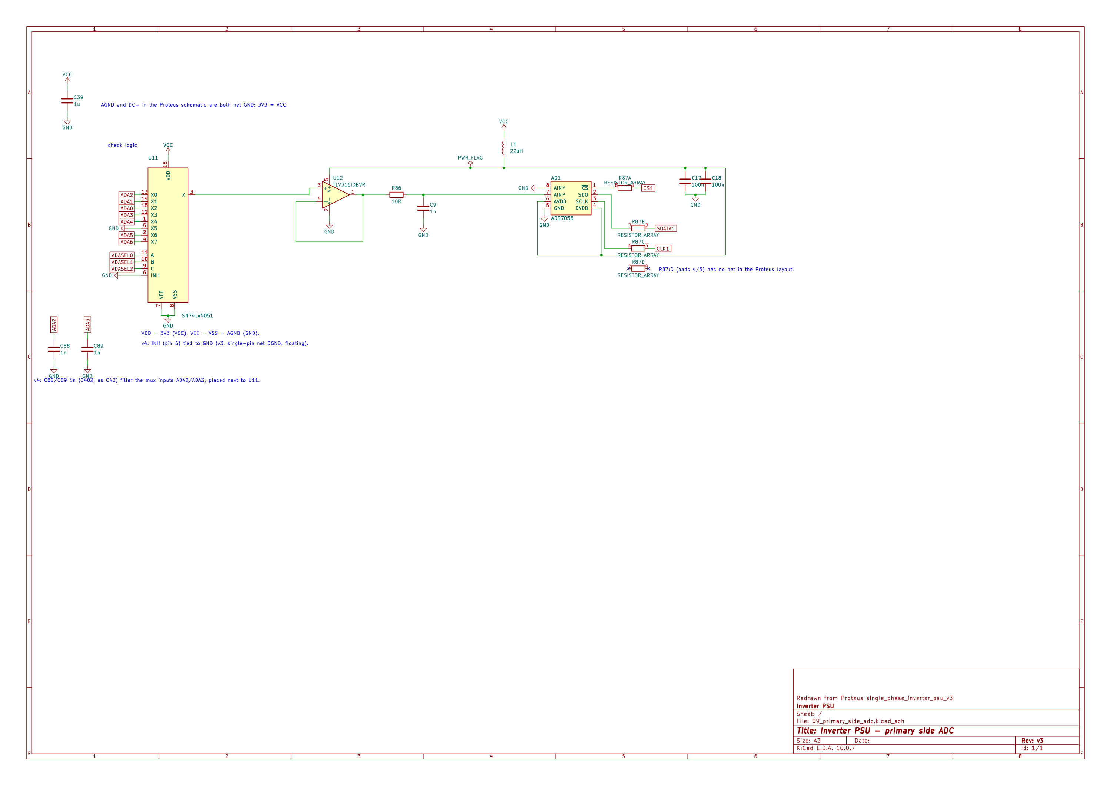
reports/render/09_primary_side_adc.png
