johonkanen/ac_psu_kicad/reports/render/10_inu_sdm_relay_drive.png

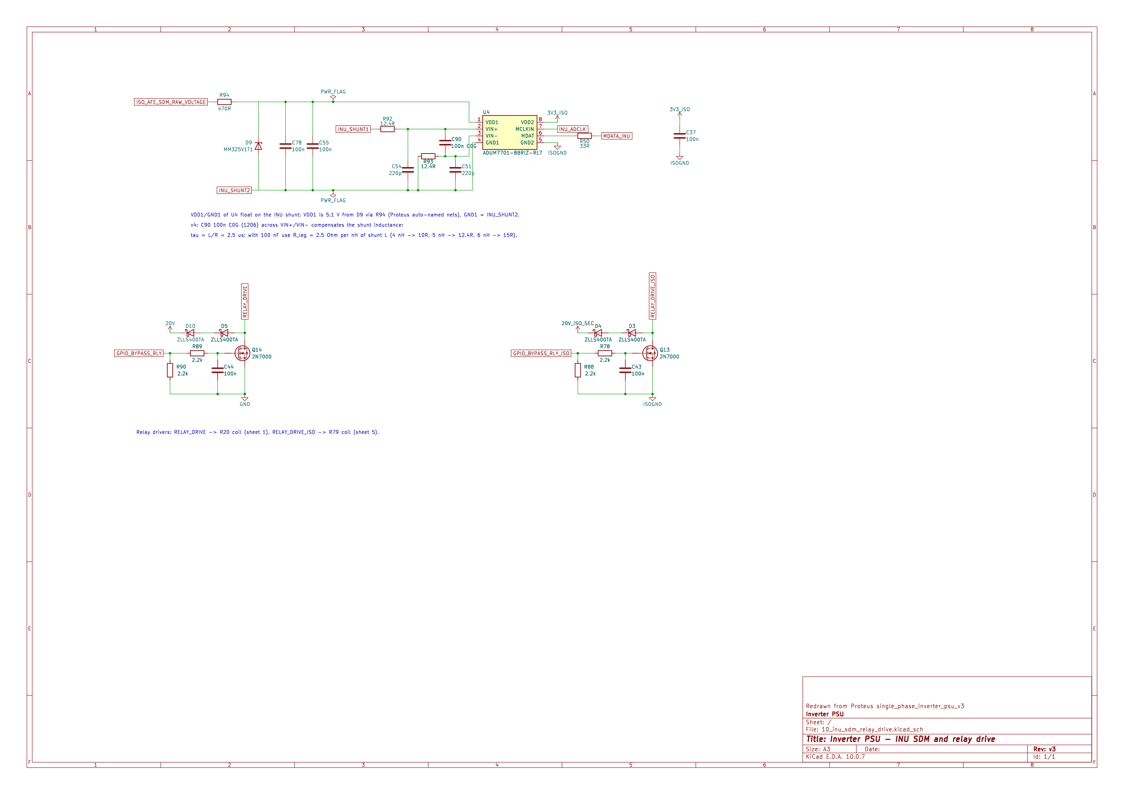
reports/render/10_inu_sdm_relay_drive.png
