johonkanen/ac_psu_kicad/reports/render/11_signal_isolators.png

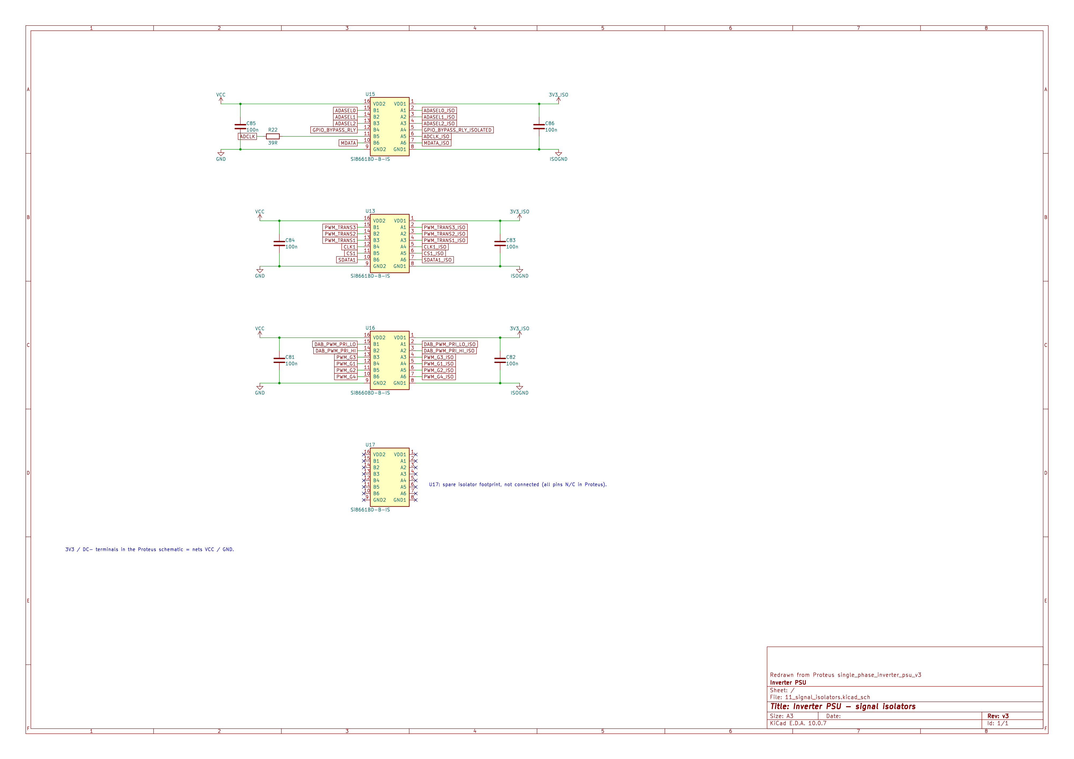
reports/render/11_signal_isolators.png
