johonkanen/ac_psu_kicad/reports/roundtrip/B_Cu.png

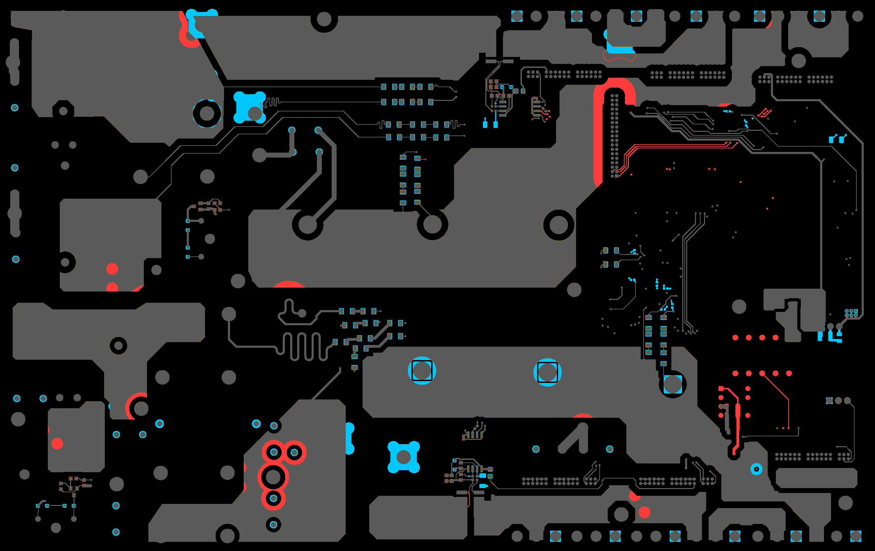
reports/roundtrip/B_Cu.png
