johonkanen/ac_psu_kicad/reports/roundtrip/F_Cu.png

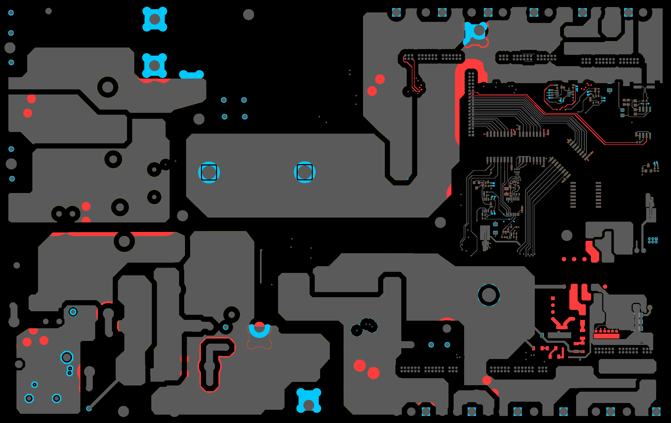
reports/roundtrip/F_Cu.png
