johonkanen/ac_psu_kicad/reports/roundtrip/In1_Cu.png

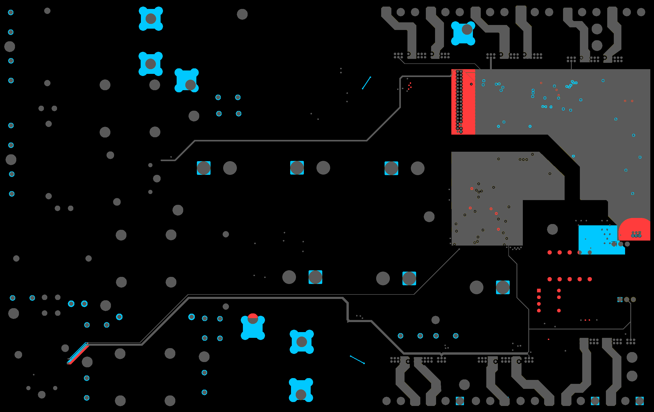
reports/roundtrip/In1_Cu.png
