johonkanen/ac_psu_kicad/reports/roundtrip/In2_Cu.png

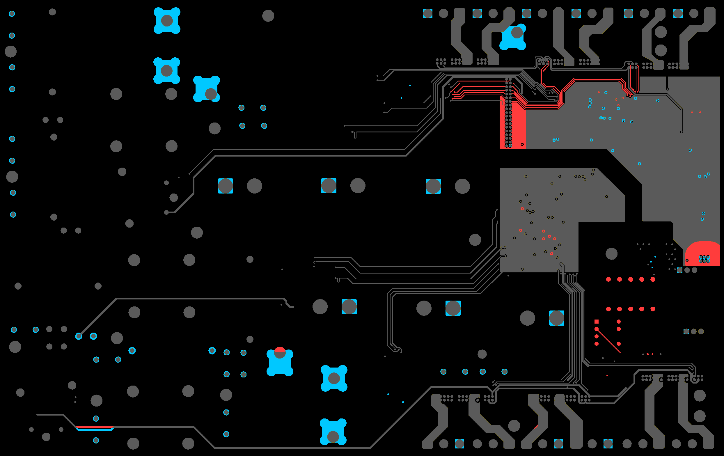
reports/roundtrip/In2_Cu.png
