johonkanen/ac_psu_kicad/source/schematic_pdf/hi-01.png

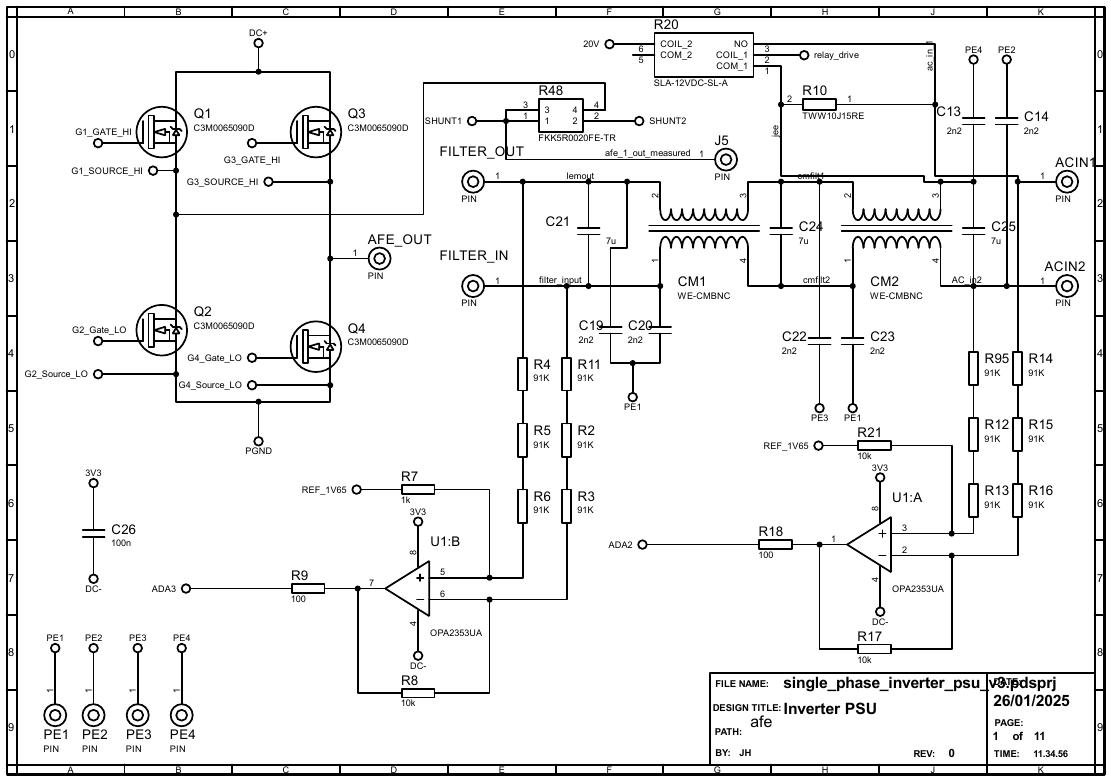
source/schematic_pdf/hi-01.png
