johonkanen/ac_psu_kicad/source/schematic_pdf/hi-02.png

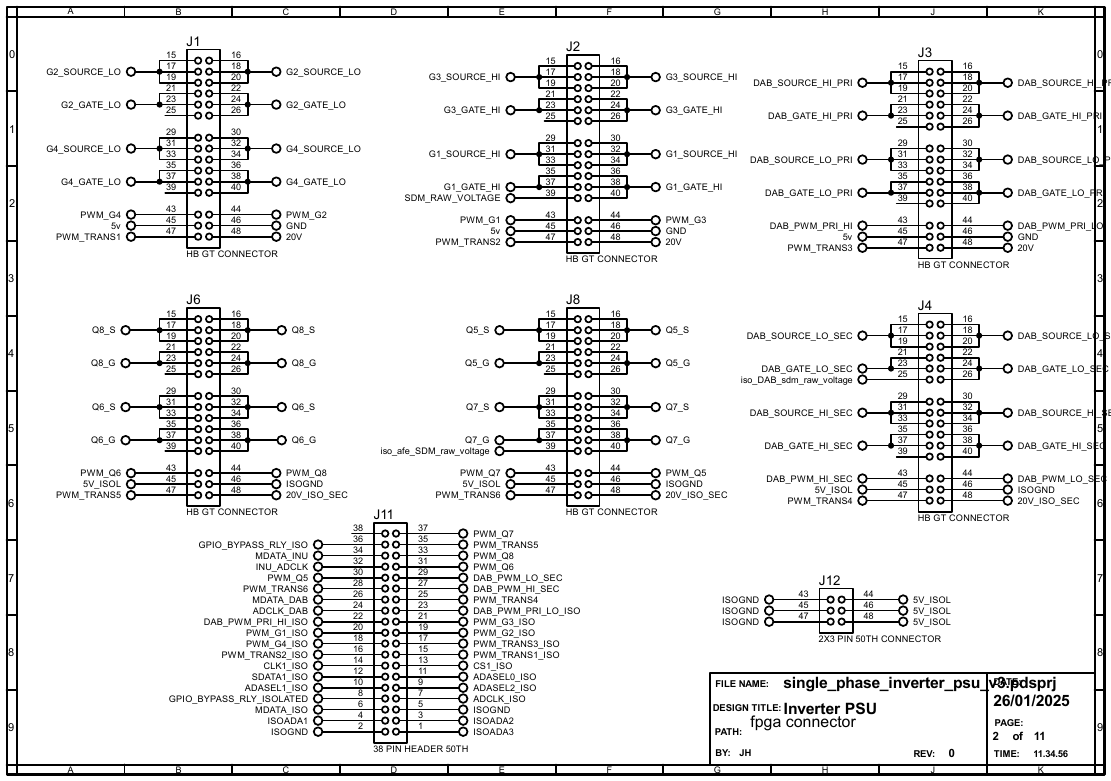
source/schematic_pdf/hi-02.png
