johonkanen/ac_psu_kicad/source/schematic_pdf/hi-03.png

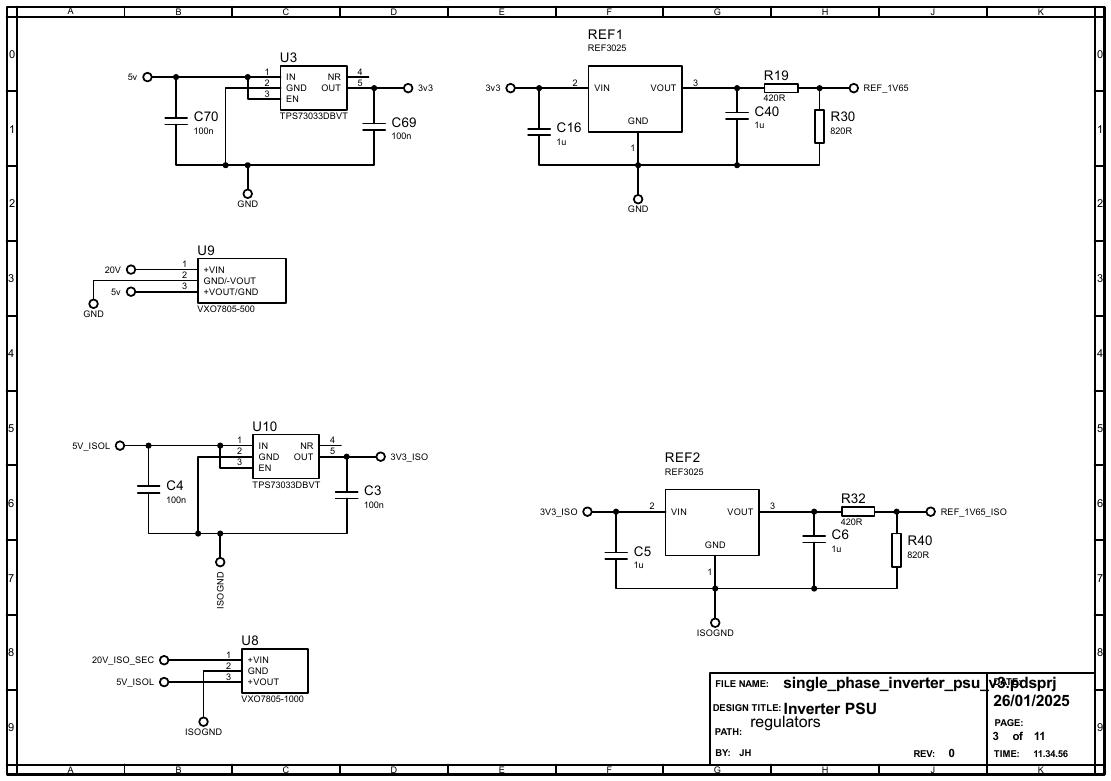
source/schematic_pdf/hi-03.png
