johonkanen/ac_psu_kicad/source/schematic_pdf/hi-04.png

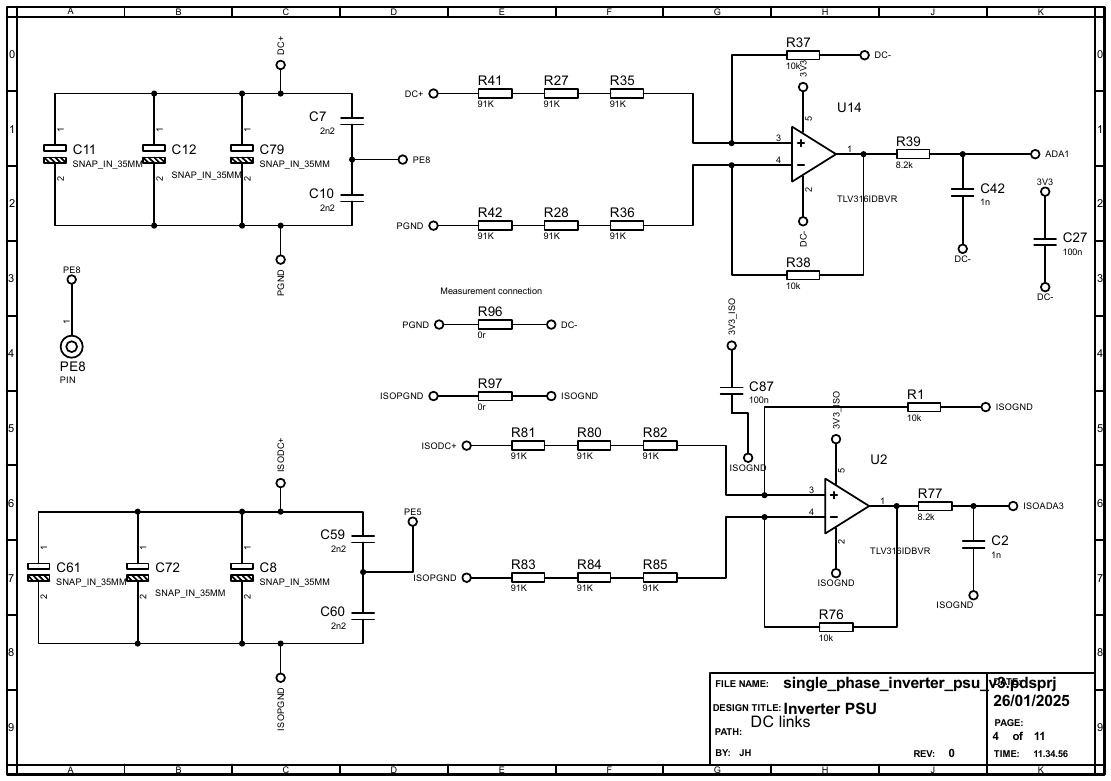
source/schematic_pdf/hi-04.png
