johonkanen/ac_psu_kicad/source/schematic_pdf/hi-05.png

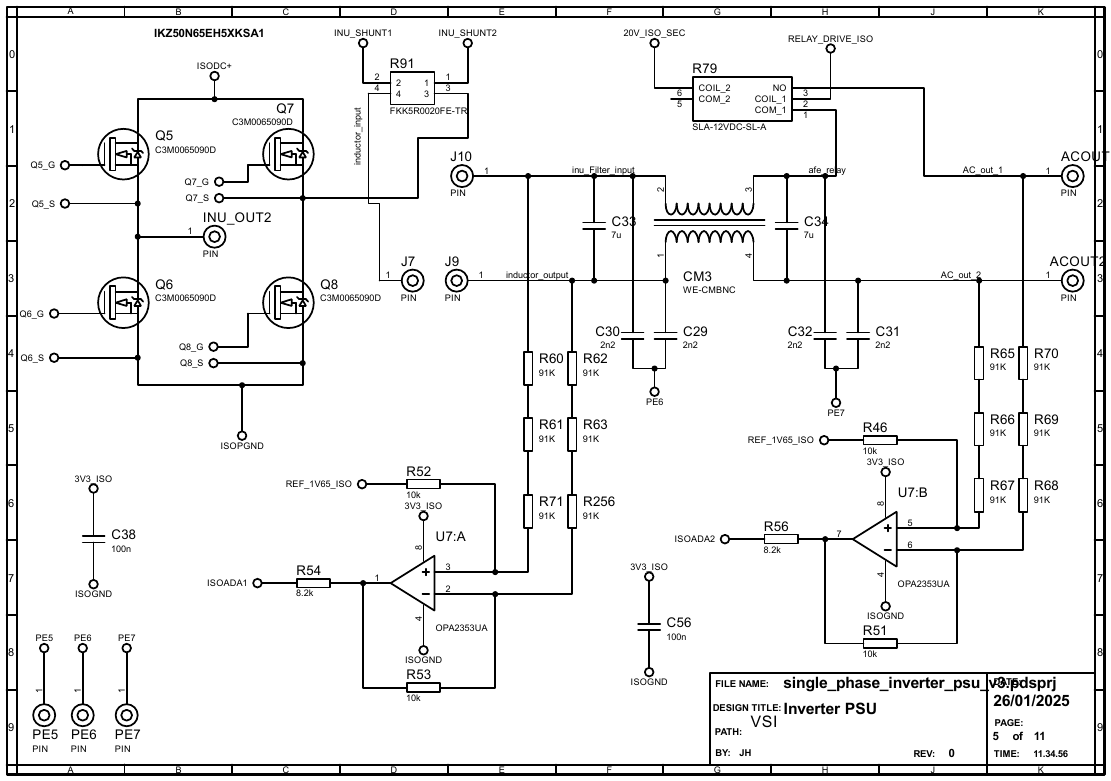
source/schematic_pdf/hi-05.png
