johonkanen/ac_psu_kicad/source/schematic_pdf/hi-06.png

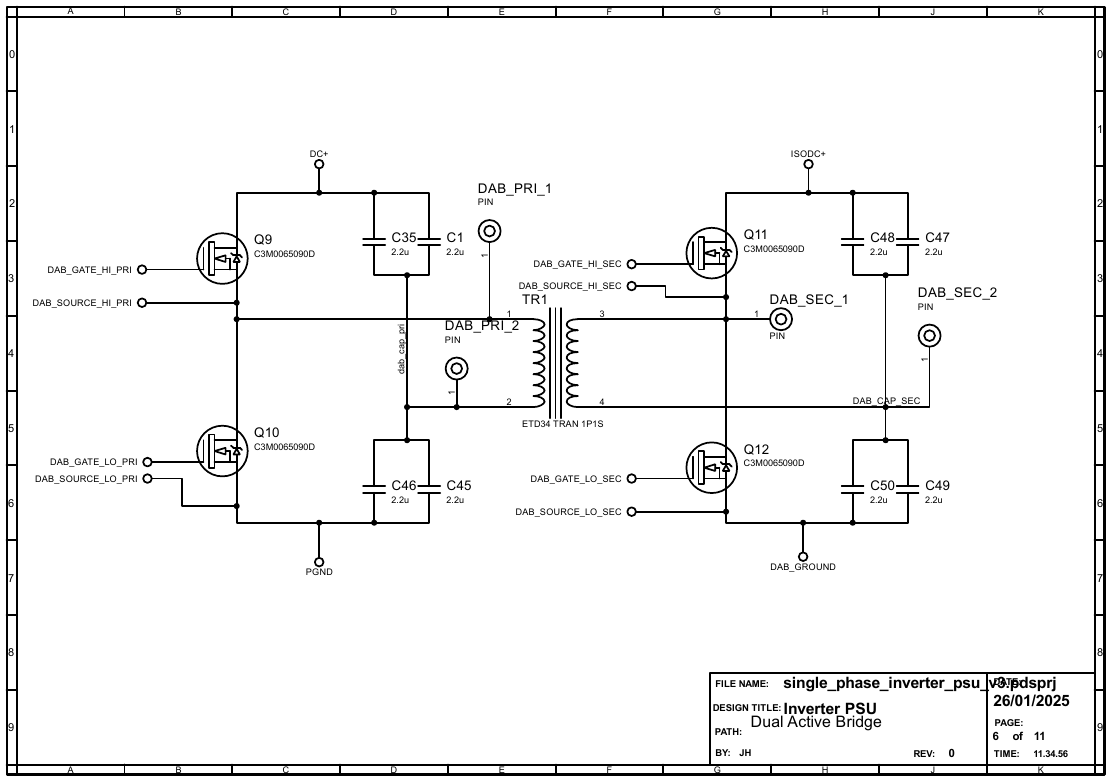
source/schematic_pdf/hi-06.png
