johonkanen/ac_psu_kicad/source/schematic_pdf/hi-07.png

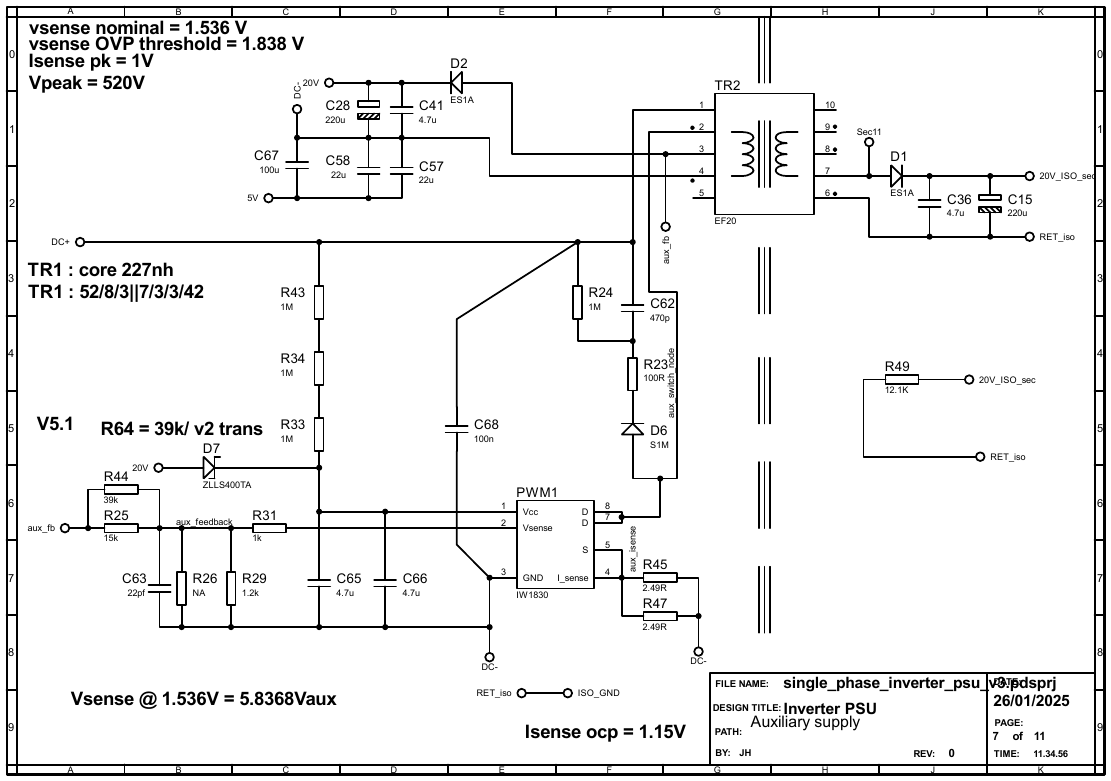
source/schematic_pdf/hi-07.png
