johonkanen/ac_psu_kicad/source/schematic_pdf/hi-08.png

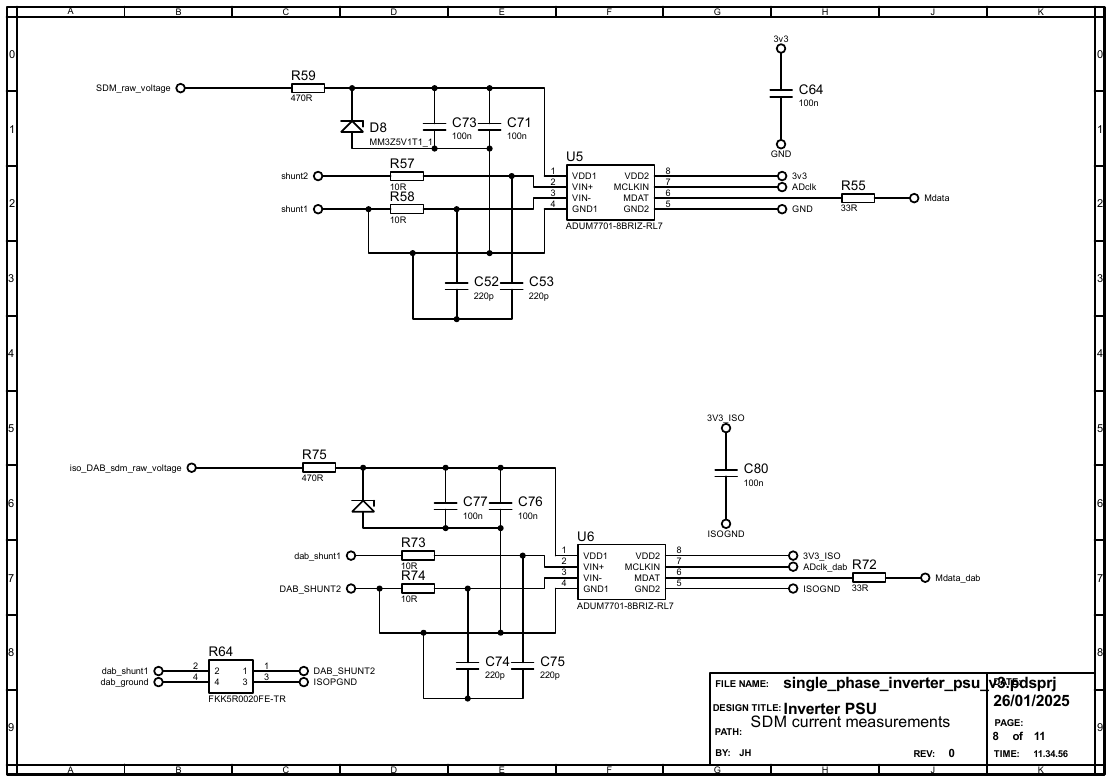
source/schematic_pdf/hi-08.png
