johonkanen/ac_psu_kicad/source/schematic_pdf/hi-09.png

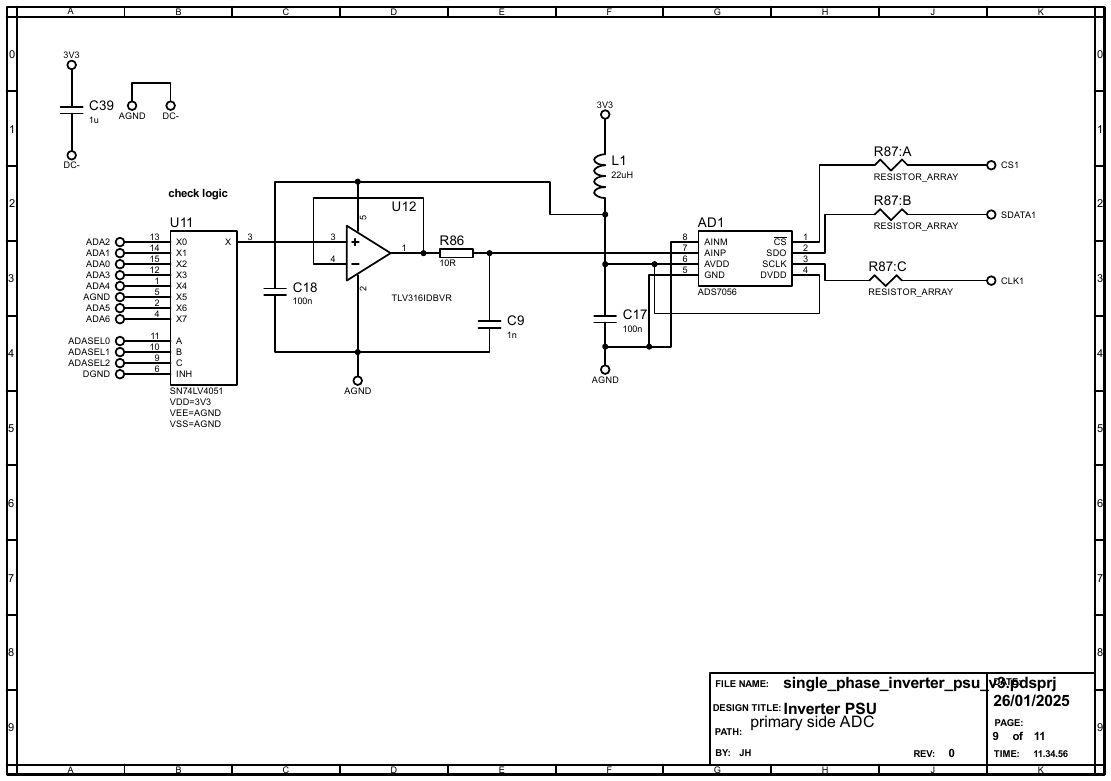
source/schematic_pdf/hi-09.png
