johonkanen/ac_psu_kicad/source/schematic_pdf/hi-10.png

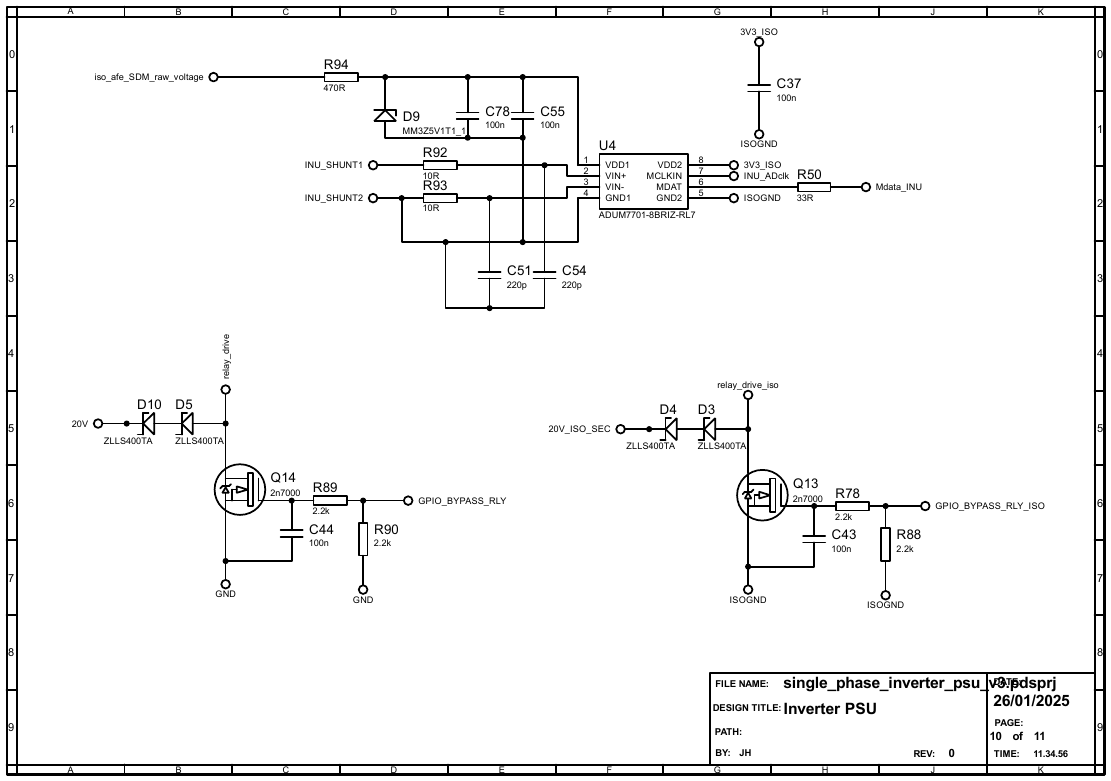
source/schematic_pdf/hi-10.png
