johonkanen/ac_psu_kicad/source/schematic_pdf/hi-11.png

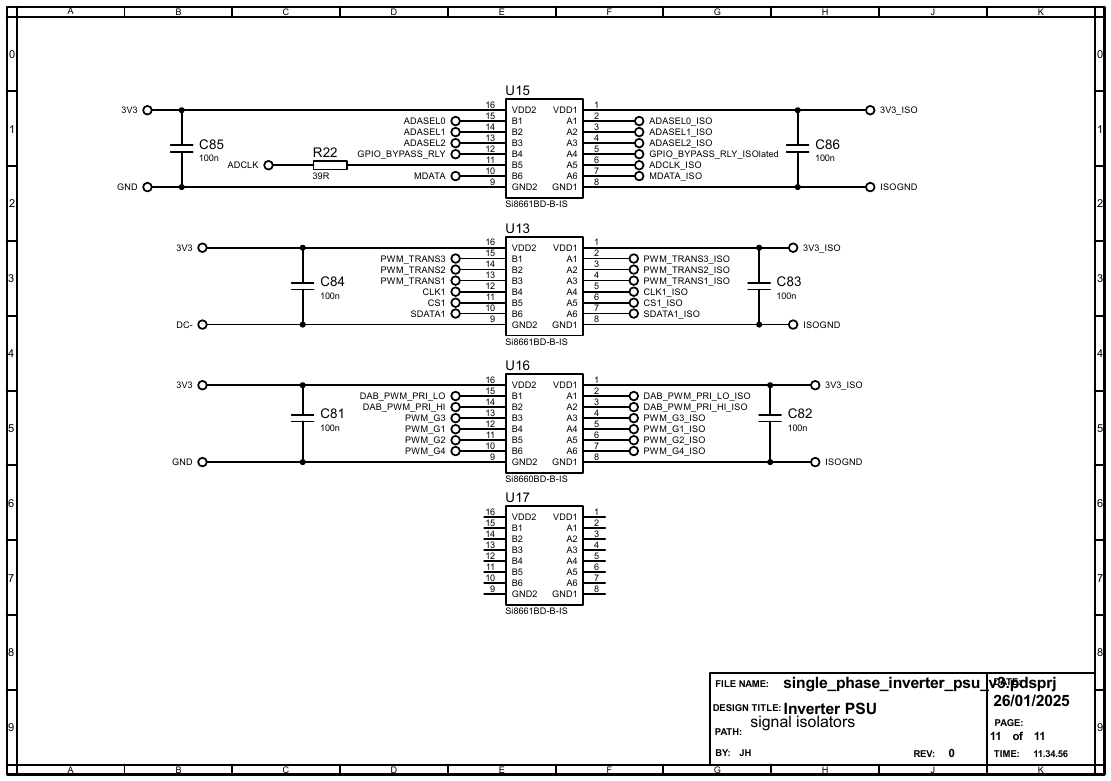
source/schematic_pdf/hi-11.png
