johonkanen/ac_psu_kicad/reference/pin_nets_by_component.md

# Pin → net by component

Generated by `p2k ipc356` from the Proteus IPC-D-356A netlist. Do not edit.

Net aliases: `GND=POWER` → `GND`, `VCC/VDD=POWER` → `VCC`.
Refdes restored from 6-char truncation: `AFE_OU` → `AFE_OUT`, `FILTER` → `FILTER_IN`, `FILTER` → `FILTER_OUT`, `INU_OU` → `INU_OUT2`, `DAB_PR` → `DAB_PRI_1`, `DAB_PR` → `DAB_PRI_2`, `DAB_SE` → `DAB_SEC_1`, `DAB_SE` → `DAB_SEC_2`.
`N/C` = explicitly unconnected in Proteus; `(no net)` = pad without any net record.
Coordinates in mm, IPC orientation (Y up). Side: top/bottom for SMD, both for THT.

Index: ACIN (2), ACOUT (2), AD (1), AFE_OUT (1), C (87), CM (3), D (10), DAB_PRI_ (2), DAB_SEC_ (2), FILTER_IN (1), FILTER_OUT (1), INU_OUT (1), J (12), L (1), PE (8), PWM (1), Q (14), R (98), REF (2), TR (1), U (17)

## ACIN1

2 pads, THT, side both

| pin | net | x | y |
|---|---|---|---|
| 1 | AC_IN_1 | -107.240 | -46.380 |
| 1 | AC_IN_1 | -112.240 | -46.380 |

## ACIN2

2 pads, THT, side both

| pin | net | x | y |
|---|---|---|---|
| 1 | AC_IN2 | -107.240 | -40.380 |
| 1 | AC_IN2 | -112.240 | -40.380 |

## ACOUT1

2 pads, THT, side both

| pin | net | x | y |
|---|---|---|---|
| 1 | AC_OUT_1 | -102.300 | -6.500 |
| 1 | AC_OUT_1 | -107.300 | -6.500 |

## ACOUT2

2 pads, THT, side both

| pin | net | x | y |
|---|---|---|---|
| 1 | AC_OUT_2 | -108.500 | 31.500 |
| 1 | AC_OUT_2 | -113.500 | 31.500 |

## AD1

8 pads, SMD, side top

| pin | net | x | y |
|---|---|---|---|
| 1 | #00406 | 63.149 | 7.894 |
| 2 | #00407 | 62.649 | 7.894 |
| 3 | #00408 | 62.149 | 7.894 |
| 4 | #00396 | 61.949 | 7.219 |
| 5 | GND | 62.149 | 6.544 |
| 6 | #00396 | 62.649 | 6.544 |
| 7 | #00394 | 63.149 | 6.544 |
| 8 | GND | 63.299 | 7.219 |

## AFE_OUT

1 pads, THT, side both

| pin | net | x | y |
|---|---|---|---|
| 1 | G3_SOURCE_HI | 47.500 | -73.600 |

## C1

2 pads, SMD, side top

| pin | net | x | y |
|---|---|---|---|
| 1 | DC+ | 97.100 | -69.100 |
| 2 | DAB_CAP_PRI | 97.100 | -63.900 |

## C2

2 pads, SMD, side top

| pin | net | x | y |
|---|---|---|---|
| 1 | ISOADA3 | 91.587 | 39.800 |
| 2 | ISOGND | 91.587 | 38.900 |

## C3

2 pads, SMD, side top

| pin | net | x | y |
|---|---|---|---|
| 1 | ISOGND | 112.400 | -1.623 |
| 2 | 3V3_ISO | 111.500 | -1.623 |

## C4

2 pads, SMD, side top

| pin | net | x | y |
|---|---|---|---|
| 1 | ISOGND | 112.100 | -7.423 |
| 2 | 5V_ISOL | 113.000 | -7.423 |

## C5

2 pads, SMD, side top

| pin | net | x | y |
|---|---|---|---|
| 1 | ISOGND | 109.013 | 10.295 |
| 2 | 3V3_ISO | 109.013 | 9.395 |

## C6

2 pads, SMD, side top

| pin | net | x | y |
|---|---|---|---|
| 1 | ISOGND | 113.513 | 10.295 |
| 2 | #00209 | 113.513 | 9.395 |

## C7

2 pads, THT, side both

| pin | net | x | y |
|---|---|---|---|
| 1 | PE8 | 36.700 | -55.000 |
| 2 | DC+ | 44.200 | -55.000 |

## C8

2 pads, THT, side both

| pin | net | x | y |
|---|---|---|---|
| 1 | ISODC+ | 19.700 | 8.700 |
| 2 | ISOPGND | 29.700 | 8.700 |

## C9

2 pads, SMD, side top

| pin | net | x | y |
|---|---|---|---|
| 1 | GND | 61.999 | 5.384 |
| 2 | #00394 | 61.099 | 5.384 |

## C10

2 pads, THT, side both

| pin | net | x | y |
|---|---|---|---|
| 1 | PGND | 23.200 | -55.000 |
| 2 | PE8 | 30.700 | -55.000 |

## C11

2 pads, THT, side both

| pin | net | x | y |
|---|---|---|---|
| 1 | DC+ | 26.500 | -33.200 |
| 2 | PGND | 16.500 | -33.200 |

## C12

2 pads, THT, side both

| pin | net | x | y |
|---|---|---|---|
| 1 | DC+ | 62.100 | -36.600 |
| 2 | PGND | 52.100 | -36.600 |

## C13

2 pads, THT, side both

| pin | net | x | y |
|---|---|---|---|
| 1 | PE4 | -88.600 | -50.900 |
| 2 | JEE | -96.100 | -50.900 |

## C14

2 pads, THT, side both

| pin | net | x | y |
|---|---|---|---|
| 1 | PE2 | -124.400 | -40.600 |
| 2 | AC_IN2 | -116.900 | -40.600 |

## C15

2 pads, SMD, side bottom

| pin | net | x | y |
|---|---|---|---|
| 1 | 20V_ISO_SEC | 100.684 | -13.575 |
| 2 | RET_ISO | 96.184 | -13.575 |

## C16

2 pads, SMD, side top

| pin | net | x | y |
|---|---|---|---|
| 1 | GND | 49.700 | 4.109 |
| 2 | VCC | 49.700 | 5.009 |

## C17

2 pads, SMD, side top

| pin | net | x | y |
|---|---|---|---|
| 1 | GND | 60.046 | 4.724 |
| 2 | #00396 | 60.046 | 3.824 |

## C18

2 pads, SMD, side top

| pin | net | x | y |
|---|---|---|---|
| 1 | GND | 60.046 | 0.141 |
| 2 | #00396 | 60.046 | 1.041 |

## C19

2 pads, THT, side both

| pin | net | x | y |
|---|---|---|---|
| 1 | PE1 | -45.500 | -56.000 |
| 2 | LEMOUT | -45.500 | -48.500 |

## C20

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
| 4 | AC_IN2 | -64.100 | -16.600 |

## CM3

4 pads, THT, side both

| pin | net | x | y |
|---|---|---|---|
| 1 | INDUCTOR_OUTPUT | -89.244 | 40.413 |
| 2 | INU_FILTER_INPUT | -70.344 | 40.413 |
| 3 | AFE_RELAY | -70.244 | 22.513 |
| 4 | AC_OUT_2 | -89.244 | 22.413 |

## D1

2 pads, SMD, side top

| pin | net | x | y |
|---|---|---|---|
| A | SEC11 | 89.400 | -18.000 |
| C | 20V_ISO_SEC | 89.400 | -13.900 |

## D2

2 pads, SMD, side top

| pin | net | x | y |
|---|---|---|---|
| A | AUX_FB | 88.300 | -37.300 |
| C | 20V | 92.400 | -37.300 |

## D3

2 pads, SMD, side bottom

| pin | net | x | y |
|---|---|---|---|
| A | RELAY_DRIVE_ISO | -75.800 | 9.900 |
| C | #00416 | -75.800 | 7.300 |

## D4

2 pads, SMD, side bottom

| pin | net | x | y |
|---|---|---|---|
| A | #00416 | -75.800 | 2.300 |
| C | 20V_ISO_SEC | -75.800 | -0.300 |

## D5

2 pads, SMD, side bottom

| pin | net | x | y |
|---|---|---|---|
| A | RELAY_DRIVE | -108.200 | -71.100 |
| C | #00409 | -110.800 | -71.100 |

## D6

2 pads, SMD, side top

| pin | net | x | y |
|---|---|---|---|
| A | AUX_SWITCH_NODE | 86.800 | -42.839 |
| C | #00339 | 86.800 | -46.939 |

## D7

2 pads, SMD, side top

| pin | net | x | y |
|---|---|---|---|
| A | 20V | 81.950 | -59.650 |
| C | #00344 | 79.350 | -59.650 |

## D8

2 pads, SMD, side bottom

| pin | net | x | y |
|---|---|---|---|
| A | SHUNT1 | 0.086 | -60.814 |
| C | #00348 | 0.085 | -58.214 |

## D9

2 pads, SMD, side bottom

| pin | net | x | y |
|---|---|---|---|
| A | INU_SHUNT2 | 13.524 | 47.955 |
| C | #00427 | 16.124 | 47.955 |

## D10

2 pads, SMD, side bottom

| pin | net | x | y |
|---|---|---|---|
| A | #00409 | -115.800 | -71.100 |
| C | 20V | -118.400 | -71.100 |

## DAB_PRI_1

1 pads, THT, side both

| pin | net | x | y |
|---|---|---|---|
| 1 | DAB_SOURCE_HI_PRI | 111.250 | -70.300 |

## DAB_PRI_2

1 pads, THT, side both

| pin | net | x | y |
|---|---|---|---|
| 1 | DAB_CAP_PRI | 111.250 | -63.200 |

## DAB_SEC_1

1 pads, THT, side both

| pin | net | x | y |
|---|---|---|---|
| 1 | DAB_SOURCE_HI_SEC | 97.900 | 61.700 |

## DAB_SEC_2

1 pads, THT, side both

| pin | net | x | y |
|---|---|---|---|
| 1 | DAB_CAP_SEC | 97.900 | 55.400 |

## FILTER_IN

1 pads, THT, side both

| pin | net | x | y |
|---|---|---|---|
| 1 | FILTER_INPUT | -14.400 | -57.300 |

## FILTER_OUT

1 pads, THT, side both

| pin | net | x | y |
|---|---|---|---|
| 1 | LEMOUT | -33.000 | -48.500 |

## INU_OUT2

1 pads, THT, side both

| pin | net | x | y |
|---|---|---|---|
| 1 | Q5_S | 48.500 | 61.500 |

## J1

30 pads, THT, side both

| pin | net | x | y |
|---|---|---|---|
| 15 | PGND | 19.720 | -64.800 |
| 16 | PGND | 19.720 | -63.530 |
| 17 | PGND | 20.990 | -64.800 |
| 18 | PGND | 20.990 | -63.530 |
| 19 | PGND | 22.260 | -64.800 |
| 20 | PGND | 22.260 | -63.530 |
| 21 | G2_GATE_LO | 23.530 | -64.800 |
| 22 | G2_GATE_LO | 23.530 | -63.530 |
| 23 | G2_GATE_LO | 24.800 | -64.800 |
| 24 | G2_GATE_LO | 24.800 | -63.530 |
| 25 | N/C | 26.070 | -64.800 |
| 26 | G2_GATE_LO | 26.070 | -63.530 |
| 29 | PGND | 28.610 | -64.800 |
| 30 | PGND | 28.610 | -63.530 |
| 31 | PGND | 29.880 | -64.800 |
| 32 | PGND | 29.880 | -63.530 |
| 33 | PGND | 31.150 | -64.800 |
| 34 | PGND | 31.150 | -63.530 |
| 35 | G4_GATE_LO | 32.420 | -64.800 |
| 36 | G4_GATE_LO | 32.420 | -63.530 |
| 37 | G4_GATE_LO | 33.690 | -64.800 |
| 38 | G4_GATE_LO | 33.690 | -63.530 |
| 39 | N/C | 34.960 | -64.800 |
| 40 | G4_GATE_LO | 34.960 | -63.530 |
| 43 | PWM_G4 | 37.500 | -64.800 |
| 44 | PWM_G2 | 37.500 | -63.530 |
| 45 | 5V | 38.770 | -64.800 |
| 46 | GND | 38.770 | -63.530 |
| 47 | PWM_TRANS1 | 40.040 | -64.800 |
| 48 | 20V | 40.040 | -63.530 |

## J2

30 pads, THT, side both

| pin | net | x | y |
|---|---|---|---|
| 15 | G3_SOURCE_HI | 52.990 | -64.800 |
| 16 | G3_SOURCE_HI | 52.990 | -63.530 |
| 17 | G3_SOURCE_HI | 54.260 | -64.800 |
| 18 | G3_SOURCE_HI | 54.260 | -63.530 |
| 19 | G3_SOURCE_HI | 55.530 | -64.800 |
| 20 | G3_SOURCE_HI | 55.530 | -63.530 |
| 21 | G3_GATE_HI | 56.800 | -64.800 |
| 22 | G3_GATE_HI | 56.800 | -63.530 |
| 23 | G3_GATE_HI | 58.070 | -64.800 |
| 24 | G3_GATE_HI | 58.070 | -63.530 |
| 25 | N/C | 59.340 | -64.800 |
| 26 | G3_GATE_HI | 59.340 | -63.530 |
| 29 | G1_SOURCE_HI | 61.880 | -64.800 |
| 30 | G1_SOURCE_HI | 61.880 | -63.530 |
| 31 | G1_SOURCE_HI | 63.150 | -64.800 |
| 32 | G1_SOURCE_HI | 63.150 | -63.530 |
| 33 | G1_SOURCE_HI | 64.420 | -64.800 |
| 34 | G1_SOURCE_HI | 64.420 | -63.530 |
| 35 | G1_GATE_HI | 65.690 | -64.800 |
| 36 | G1_GATE_HI | 65.690 | -63.530 |
| 37 | G1_GATE_HI | 66.960 | -64.800 |
| 38 | G1_GATE_HI | 66.960 | -63.530 |
| 39 | SDM_RAW_VOLTAGE | 68.230 | -64.800 |
| 40 | G1_GATE_HI | 68.230 | -63.530 |
| 43 | PWM_G1 | 70.770 | -64.800 |
| 44 | PWM_G3 | 70.770 | -63.530 |
| 45 | 5V | 72.040 | -64.800 |
| 46 | GND | 72.040 | -63.530 |
| 47 | PWM_TRANS2 | 73.310 | -64.800 |
| 48 | 20V | 73.310 | -63.530 |

## J3

30 pads, THT, side both

| pin | net | x | y |
|---|---|---|---|
| 15 | DAB_SOURCE_HI_PRI | 91.700 | -57.800 |
| 16 | DAB_SOURCE_HI_PRI | 91.700 | -56.530 |
| 17 | DAB_SOURCE_HI_PRI | 92.970 | -57.800 |
| 18 | DAB_SOURCE_HI_PRI | 92.970 | -56.530 |
| 19 | DAB_SOURCE_HI_PRI | 94.240 | -57.800 |
| 20 | DAB_SOURCE_HI_PRI | 94.240 | -56.530 |
| 21 | DAB_GATE_HI_PRI | 95.510 | -57.800 |
| 22 | DAB_GATE_HI_PRI | 95.510 | -56.530 |
| 23 | DAB_GATE_HI_PRI | 96.780 | -57.800 |
| 24 | DAB_GATE_HI_PRI | 96.780 | -56.530 |
| 25 | N/C | 98.050 | -57.800 |
| 26 | DAB_GATE_HI_PRI | 98.050 | -56.530 |
| 29 | PGND | 100.590 | -57.800 |
| 30 | PGND | 100.590 | -56.530 |
| 31 | PGND | 101.860 | -57.800 |
| 32 | PGND | 101.860 | -56.530 |
| 33 | PGND | 103.130 | -57.800 |
| 34 | PGND | 103.130 | -56.530 |
| 35 | DAB_GATE_LO_PRI | 104.400 | -57.800 |
| 36 | DAB_GATE_LO_PRI | 104.400 | -56.530 |
| 37 | DAB_GATE_LO_PRI | 105.670 | -57.800 |
| 38 | DAB_GATE_LO_PRI | 105.670 | -56.530 |
| 39 | N/C | 106.940 | -57.800 |
| 40 | DAB_GATE_LO_PRI | 106.940 | -56.530 |
| 43 | DAB_PWM_PRI_HI | 109.480 | -57.800 |
| 44 | DAB_PWM_PRI_LO | 109.480 | -56.530 |
| 45 | 5V | 110.750 | -57.800 |
| 46 | GND | 110.750 | -56.530 |
| 47 | PWM_TRANS3 | 112.020 | -57.800 |
| 48 | 20V | 112.020 | -56.530 |

## J4

30 pads, THT, side both

| pin | net | x | y |
|---|---|---|---|
| 15 | DAB_GROUND | 107.200 | 50.770 |
| 16 | DAB_GROUND | 107.200 | 49.500 |
| 17 | DAB_GROUND | 105.930 | 50.770 |
| 18 | DAB_GROUND | 105.930 | 49.500 |
| 19 | DAB_GROUND | 104.660 | 50.770 |
| 20 | DAB_GROUND | 104.660 | 49.500 |
| 21 | DAB_GATE_LO_SEC | 103.390 | 50.770 |
| 22 | DAB_GATE_LO_SEC | 103.390 | 49.500 |
| 23 | DAB_GATE_LO_SEC | 102.120 | 50.770 |
| 24 | DAB_GATE_LO_SEC | 102.120 | 49.500 |
| 25 | ISO_DAB_SDM_RAW_VOLTAGE | 100.850 | 50.770 |
| 26 | DAB_GATE_LO_SEC | 100.850 | 49.500 |
| 29 | DAB_SOURCE_HI_SEC | 98.310 | 50.770 |
| 30 | DAB_SOURCE_HI_SEC | 98.310 | 49.500 |
| 31 | DAB_SOURCE_HI_SEC | 97.040 | 50.770 |
| 32 | DAB_SOURCE_HI_SEC | 97.040 | 49.500 |
| 33 | DAB_SOURCE_HI_SEC | 95.770 | 50.770 |
| 34 | DAB_SOURCE_HI_SEC | 95.770 | 49.500 |
| 35 | DAB_GATE_HI_SEC | 94.500 | 50.770 |
| 36 | DAB_GATE_HI_SEC | 94.500 | 49.500 |
| 37 | DAB_GATE_HI_SEC | 93.230 | 50.770 |
| 38 | DAB_GATE_HI_SEC | 93.230 | 49.500 |
| 39 | N/C | 91.960 | 50.770 |
| 40 | DAB_GATE_HI_SEC | 91.960 | 49.500 |
| 43 | DAB_PWM_HI_SEC | 89.420 | 50.770 |
| 44 | DAB_PWM_LO_SEC | 89.420 | 49.500 |
| 45 | 5V_ISOL | 88.150 | 50.770 |
| 46 | ISOGND | 88.150 | 49.500 |
| 47 | PWM_TRANS4 | 86.880 | 50.770 |
| 48 | 20V_ISO_SEC | 86.880 | 49.500 |

## J5

1 pads, THT, side both

| pin | net | x | y |
|---|---|---|---|
| 1 | SHUNT1 | -14.700 | -77.400 |

## J6

30 pads, THT, side both

| pin | net | x | y |
|---|---|---|---|
| 15 | ISOPGND | 76.600 | 52.000 |
| 16 | ISOPGND | 76.600 | 50.730 |
| 17 | ISOPGND | 75.330 | 52.000 |
| 18 | ISOPGND | 75.330 | 50.730 |
| 19 | ISOPGND | 74.060 | 52.000 |
| 20 | ISOPGND | 74.060 | 50.730 |
| 21 | Q8_G | 72.790 | 52.000 |
| 22 | Q8_G | 72.790 | 50.730 |
| 23 | Q8_G | 71.520 | 52.000 |
| 24 | Q8_G | 71.520 | 50.730 |
| 25 | N/C | 70.250 | 52.000 |
| 26 | Q8_G | 70.250 | 50.730 |
| 29 | ISOPGND | 67.710 | 52.000 |
| 30 | ISOPGND | 67.710 | 50.730 |
| 31 | ISOPGND | 66.440 | 52.000 |
| 32 | ISOPGND | 66.440 | 50.730 |
| 33 | ISOPGND | 65.170 | 52.000 |
| 34 | ISOPGND | 65.170 | 50.730 |
| 35 | Q6_G | 63.900 | 52.000 |
| 36 | Q6_G | 63.900 | 50.730 |
| 37 | Q6_G | 62.630 | 52.000 |
| 38 | Q6_G | 62.630 | 50.730 |
| 39 | N/C | 61.360 | 52.000 |
| 40 | Q6_G | 61.360 | 50.730 |
| 43 | PWM_Q6 | 58.820 | 52.000 |
| 44 | PWM_Q8 | 58.820 | 50.730 |
| 45 | 5V_ISOL | 57.550 | 52.000 |
| 46 | ISOGND | 57.550 | 50.730 |
| 47 | PWM_TRANS5 | 56.280 | 52.000 |
| 48 | 20V_ISO_SEC | 56.280 | 50.730 |

## J7

1 pads, THT, side both

| pin | net | x | y |
|---|---|---|---|
| 1 | INDUCTOR_INPUT | -71.800 | 65.600 |

## J8

30 pads, THT, side both

| pin | net | x | y |
|---|---|---|---|
| 15 | Q5_S | 41.400 | 52.200 |
| 16 | Q5_S | 41.400 | 50.930 |
| 17 | Q5_S | 40.130 | 52.200 |
| 18 | Q5_S | 40.130 | 50.930 |
| 19 | Q5_S | 38.860 | 52.200 |
| 20 | Q5_S | 38.860 | 50.930 |
| 21 | Q5_G | 37.590 | 52.200 |
| 22 | Q5_G | 37.590 | 50.930 |
| 23 | Q5_G | 36.320 | 52.200 |
| 24 | Q5_G | 36.320 | 50.930 |
| 25 | N/C | 35.050 | 52.200 |
| 26 | Q5_G | 35.050 | 50.930 |
| 29 | Q7_S | 32.510 | 52.200 |
| 30 | Q7_S | 32.510 | 50.930 |
| 31 | Q7_S | 31.240 | 52.200 |
| 32 | Q7_S | 31.240 | 50.930 |
| 33 | Q7_S | 29.970 | 52.200 |
| 34 | Q7_S | 29.970 | 50.930 |
| 35 | Q7_G | 28.700 | 52.200 |
| 36 | Q7_G | 28.700 | 50.930 |
| 37 | Q7_G | 27.430 | 52.200 |
| 38 | Q7_G | 27.430 | 50.930 |
| 39 | ISO_AFE_SDM_RAW_VOLTAGE | 26.160 | 52.200 |
| 40 | Q7_G | 26.160 | 50.930 |
| 43 | PWM_Q7 | 23.620 | 52.200 |
| 44 | PWM_Q5 | 23.620 | 50.930 |
| 45 | 5V_ISOL | 22.350 | 52.200 |
| 46 | ISOGND | 22.350 | 50.930 |
| 47 | PWM_TRANS6 | 21.080 | 52.200 |
| 48 | 20V_ISO_SEC | 21.080 | 50.930 |

## J9

1 pads, THT, side both

| pin | net | x | y |
|---|---|---|---|
| 1 | INDUCTOR_OUTPUT | -71.900 | 48.400 |

## J10

1 pads, THT, side both

| pin | net | x | y |
|---|---|---|---|
| 1 | INU_FILTER_INPUT | -56.700 | 40.400 |

## J11

38 pads, THT, side both

| pin | net | x | y |
|---|---|---|---|
| 1 | ISOADA3 | 46.170 | 22.610 |
| 2 | ISOGND | 44.900 | 22.610 |
| 3 | ISOADA2 | 46.170 | 23.880 |
| 4 | ISOADA1 | 44.900 | 23.880 |
| 5 | ISOGND | 46.170 | 25.150 |
| 6 | MDATA_ISO | 44.900 | 25.150 |
| 7 | ADCLK_ISO | 46.170 | 26.420 |
| 8 | GPIO_BYPASS_RLY_ISOLATED | 44.900 | 26.420 |
| 9 | ADASEL2_ISO | 46.170 | 27.690 |
| 10 | ADASEL1_ISO | 44.900 | 27.690 |
| 11 | ADASEL0_ISO | 46.170 | 28.960 |
| 12 | SDATA1_ISO | 44.900 | 28.960 |
| 13 | CS1_ISO | 46.170 | 30.230 |
| 14 | CLK1_ISO | 44.900 | 30.230 |
| 15 | PWM_TRANS1_ISO | 46.170 | 31.500 |
| 16 | PWM_TRANS2_ISO | 44.900 | 31.500 |
| 17 | PWM_TRANS3_ISO | 46.170 | 32.770 |
| 18 | PWM_G4_ISO | 44.900 | 32.770 |
| 19 | PWM_G2_ISO | 46.170 | 34.040 |
| 20 | PWM_G1_ISO | 44.900 | 34.040 |
| 21 | PWM_G3_ISO | 46.170 | 35.310 |
| 22 | DAB_PWM_PRI_HI_ISO | 44.900 | 35.310 |
| 23 | DAB_PWM_PRI_LO_ISO | 46.170 | 36.580 |
| 24 | ADCLK_DAB | 44.900 | 36.580 |
| 25 | PWM_TRANS4 | 46.170 | 37.850 |
| 26 | MDATA_DAB | 44.900 | 37.850 |
| 27 | DAB_PWM_HI_SEC | 46.170 | 39.120 |
| 28 | PWM_TRANS6 | 44.900 | 39.120 |
| 29 | DAB_PWM_LO_SEC | 46.170 | 40.390 |
| 30 | PWM_Q5 | 44.900 | 40.390 |
| 31 | PWM_Q6 | 46.170 | 41.660 |
| 32 | INU_ADCLK | 44.900 | 41.660 |
| 33 | PWM_Q8 | 46.170 | 42.930 |
| 34 | MDATA_INU | 44.900 | 42.930 |
| 35 | PWM_TRANS5 | 46.170 | 44.200 |
| 36 | GPIO_BYPASS_RLY_ISO | 44.900 | 44.200 |
| 37 | PWM_Q7 | 46.170 | 45.470 |
| 38 | N/C | 44.900 | 45.470 |

## J12

6 pads, THT, side both

| pin | net | x | y |
|---|---|---|---|
| 43 | ISOGND | 114.140 | -15.700 |
| 44 | 5V_ISOL | 114.140 | -16.970 |
| 45 | ISOGND | 112.870 | -15.700 |
| 46 | 5V_ISOL | 112.870 | -16.970 |
| 47 | ISOGND | 111.600 | -15.700 |
| 48 | 5V_ISOL | 111.600 | -16.970 |

## L1

2 pads, SMD, side top

| pin | net | x | y |
|---|---|---|---|
| 1 | #00396 | 58.597 | 2.795 |
| 2 | VCC | 58.599 | 0.719 |

## PE1

1 pads, THT, side both

| pin | net | x | y |
|---|---|---|---|
| 1 | PE1 | -51.500 | -63.000 |

## PE2

1 pads, THT, side both

| pin | net | x | y |
|---|---|---|---|
| 1 | PE2 | -124.000 | -46.500 |

## PE3

1 pads, THT, side both

| pin | net | x | y |
|---|---|---|---|
| 1 | PE3 | -96.000 | -65.000 |

## PE4

1 pads, THT, side both

| pin | net | x | y |
|---|---|---|---|
| 1 | PE4 | -89.000 | -43.500 |

## PE5

1 pads, THT, side both

| pin | net | x | y |
|---|---|---|---|
| 1 | PE5 | -55.400 | 28.600 |

## PE6

1 pads, THT, side both

| pin | net | x | y |
|---|---|---|---|
| 1 | PE6 | -125.500 | 55.000 |

## PE7

1 pads, THT, side both

| pin | net | x | y |
|---|---|---|---|
| 1 | PE7 | -125.000 | 12.000 |

## PE8

1 pads, THT, side both

| pin | net | x | y |
|---|---|---|---|
| 1 | PE8 | 36.500 | -49.000 |

## PWM1

7 pads, THT, side both

| pin | net | x | y |
|---|---|---|---|
| 1 | #00344 | 75.800 | -37.800 |
| 2 | #00343 | 75.800 | -40.340 |
| 3 | GND | 75.800 | -42.880 |
| 4 | AUX_ISENSE | 75.800 | -45.420 |
| 5 | AUX_ISENSE | 83.420 | -45.420 |
| 7 | AUX_SWITCH_NODE | 83.420 | -40.340 |
| 8 | AUX_SWITCH_NODE | 83.420 | -37.800 |

## Q1

3 pads, THT, side both

| pin | net | x | y |
|---|---|---|---|
| 1 | G1_GATE_HI | 79.761 | -79.800 |
| 2 | DC+ | 74.300 | -79.800 |
| 3 | G1_SOURCE_HI | 68.839 | -79.800 |

## Q2

3 pads, THT, side both

| pin | net | x | y |
|---|---|---|---|
| 1 | G2_GATE_LO | 28.761 | -79.800 |
| 2 | G1_SOURCE_HI | 23.300 | -79.800 |
| 3 | PGND | 17.839 | -79.800 |

## Q3

3 pads, THT, side both

| pin | net | x | y |
|---|---|---|---|
| 1 | G3_GATE_HI | 62.761 | -79.800 |
| 2 | DC+ | 57.300 | -79.800 |
| 3 | G3_SOURCE_HI | 51.839 | -79.800 |

## Q4

3 pads, THT, side both

| pin | net | x | y |
|---|---|---|---|
| 1 | G4_GATE_LO | 45.761 | -79.800 |
| 2 | G3_SOURCE_HI | 40.300 | -79.800 |
| 3 | PGND | 34.839 | -79.800 |

## Q5

3 pads, THT, side both

| pin | net | x | y |
|---|---|---|---|
| 1 | Q5_G | 34.778 | 68.100 |
| 2 | ISODC+ | 40.239 | 68.100 |
| 3 | Q5_S | 45.700 | 68.100 |

## Q6

3 pads, THT, side both

| pin | net | x | y |
|---|---|---|---|
| 1 | Q6_G | 51.778 | 68.100 |
| 2 | Q5_S | 57.239 | 68.100 |
| 3 | ISOPGND | 62.700 | 68.100 |

## Q7

3 pads, THT, side both

| pin | net | x | y |
|---|---|---|---|
| 1 | Q7_G | 17.778 | 68.100 |
| 2 | ISODC+ | 23.239 | 68.100 |
| 3 | Q7_S | 28.700 | 68.100 |

## Q8

3 pads, THT, side both

| pin | net | x | y |
|---|---|---|---|
| 1 | Q8_G | 68.778 | 68.100 |
| 2 | Q7_S | 74.239 | 68.100 |
| 3 | ISOPGND | 79.700 | 68.100 |

## Q9

3 pads, THT, side both

| pin | net | x | y |
|---|---|---|---|
| 1 | DAB_GATE_HI_PRI | 97.222 | -79.800 |
| 2 | DC+ | 91.761 | -79.800 |
| 3 | DAB_SOURCE_HI_PRI | 86.300 | -79.800 |

## Q10

3 pads, THT, side both

| pin | net | x | y |
|---|---|---|---|
| 1 | DAB_GATE_LO_PRI | 114.161 | -79.800 |
| 2 | DAB_SOURCE_HI_PRI | 108.700 | -79.800 |
| 3 | PGND | 103.239 | -79.800 |

## Q11

3 pads, THT, side both

| pin | net | x | y |
|---|---|---|---|
| 1 | DAB_GATE_HI_SEC | 86.778 | 68.100 |
| 2 | ISODC+ | 92.239 | 68.100 |
| 3 | DAB_SOURCE_HI_SEC | 97.700 | 68.100 |

## Q12

3 pads, THT, side both

| pin | net | x | y |
|---|---|---|---|
| 1 | DAB_GATE_LO_SEC | 103.778 | 68.100 |
| 2 | DAB_SOURCE_HI_SEC | 109.239 | 68.100 |
| 3 | DAB_GROUND | 114.700 | 68.100 |

## Q13

3 pads, SMD, side bottom

| pin | net | x | y |
|---|---|---|---|
| 1 | RELAY_DRIVE_ISO | -74.105 | 14.000 |
| 2 | #00419 | -72.200 | 14.939 |
| 3 | ISOGND | -72.200 | 13.060 |

## Q14

3 pads, SMD, side bottom

| pin | net | x | y |
|---|---|---|---|
| 1 | RELAY_DRIVE | -108.200 | -68.100 |
| 2 | #00412 | -109.139 | -66.195 |
| 3 | GND | -107.260 | -66.195 |

## R1

2 pads, SMD, side top

| pin | net | x | y |
|---|---|---|---|
| 1 | ISOGND | 89.787 | 38.900 |
| 2 | #00242 | 89.787 | 37.900 |

## R2

2 pads, SMD, side bottom

| pin | net | x | y |
|---|---|---|---|
| 1 | #00036 | -22.900 | -15.799 |
| 2 | #00035 | -26.049 | -15.799 |

## R3

2 pads, SMD, side bottom

| pin | net | x | y |
|---|---|---|---|
| 1 | #00011 | 46.100 | 1.500 |
| 2 | #00036 | 42.950 | 1.500 |

## R4

2 pads, SMD, side bottom

| pin | net | x | y |
|---|---|---|---|
| 1 | #00033 | -28.100 | -19.799 |
| 2 | LEMOUT | -31.249 | -19.799 |

## R5

2 pads, SMD, side bottom

| pin | net | x | y |
|---|---|---|---|
| 1 | #00034 | -22.300 | -19.200 |
| 2 | #00033 | -25.449 | -19.200 |

## R6

2 pads, SMD, side bottom

| pin | net | x | y |
|---|---|---|---|
| 1 | #00010 | 46.100 | -2.499 |
| 2 | #00034 | 42.950 | -2.499 |

## R7

2 pads, SMD, side top

| pin | net | x | y |
|---|---|---|---|
| 1 | REF_1V65 | 54.000 | -1.139 |
| 2 | #00010 | 53.000 | -1.139 |

## R8

2 pads, SMD, side top

| pin | net | x | y |
|---|---|---|---|
| 1 | #00012 | 50.300 | 0.361 |
| 2 | #00011 | 51.300 | 0.361 |

## R9

2 pads, SMD, side top

| pin | net | x | y |
|---|---|---|---|
| 1 | ADA3 | 51.300 | 1.561 |
| 2 | #00012 | 50.300 | 1.561 |

## R10

2 pads, THT, side both

| pin | net | x | y |
|---|---|---|---|
| 1 | AC_IN_1 | -102.100 | -42.800 |
| 2 | JEE | -97.100 | -42.800 |

## R11

2 pads, SMD, side bottom

| pin | net | x | y |
|---|---|---|---|
| 1 | #00035 | -28.950 | -15.800 |
| 2 | FILTER_INPUT | -32.100 | -15.800 |

## R12

2 pads, SMD, side bottom

| pin | net | x | y |
|---|---|---|---|
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
| 7 | #00277 | 81.687 | 38.487 |
| 8 | 3V3_ISO | 81.687 | 39.137 |

## U8

3 pads, THT, side both

| pin | net | x | y |
|---|---|---|---|
| 1 | 20V_ISO_SEC | 104.360 | -20.100 |
| 2 | ISOGND | 106.900 | -20.100 |
| 3 | 5V_ISOL | 109.440 | -20.100 |

## U9

3 pads, THT, side both

| pin | net | x | y |
|---|---|---|---|
| 1 | 20V | 106.660 | -41.200 |
| 2 | GND | 109.200 | -41.200 |
| 3 | 5V | 111.740 | -41.200 |

## U10

5 pads, SMD, side top

| pin | net | x | y |
|---|---|---|---|
| 1 | 5V_ISOL | 111.100 | -5.623 |
| 2 | ISOGND | 112.050 | -5.623 |
| 3 | 5V_ISOL | 113.000 | -5.623 |
| 4 | N/C | 113.000 | -3.123 |
| 5 | 3V3_ISO | 111.100 | -3.123 |

## U11

16 pads, SMD, side top

| pin | net | x | y |
|---|---|---|---|
| 1 | ADA4 | 63.199 | -0.980 |
| 2 | ADA5 | 62.549 | -0.980 |
| 3 | #00390 | 61.899 | -0.980 |
| 4 | ADA6 | 61.249 | -0.980 |
| 5 | GND | 60.599 | -0.980 |
| 6 | DGND | 59.949 | -0.980 |
| 7 | GND | 59.299 | -0.980 |
| 8 | GND | 58.649 | -0.980 |
| 9 | ADASEL2 | 58.649 | -6.680 |
| 10 | ADASEL1 | 59.299 | -6.680 |
| 11 | ADASEL0 | 59.949 | -6.680 |
| 12 | ADA3 | 60.599 | -6.680 |
| 13 | ADA2 | 61.249 | -6.680 |
| 14 | ADA1 | 61.899 | -6.680 |
| 15 | ADA0 | 62.549 | -6.680 |
| 16 | VCC | 63.199 | -6.680 |

## U12

5 pads, SMD, side top

| pin | net | x | y |
|---|---|---|---|
| 1 | #00402 | 61.394 | 0.784 |
| 2 | GND | 62.334 | 0.784 |
| 3 | #00390 | 63.299 | 0.784 |
| 4 | #00402 | 63.299 | 3.171 |
| 5 | #00396 | 61.394 | 3.171 |

## U13

16 pads, SMD, side top

| pin | net | x | y |
|---|---|---|---|
| 1 | 3V3_ISO | 72.444 | 22.964 |
| 2 | PWM_TRANS3_ISO | 71.174 | 22.964 |
| 3 | PWM_TRANS2_ISO | 69.904 | 22.964 |
| 4 | PWM_TRANS1_ISO | 68.634 | 22.964 |
| 5 | CLK1_ISO | 67.364 | 22.964 |
| 6 | CS1_ISO | 66.094 | 22.964 |
| 7 | SDATA1_ISO | 64.824 | 22.964 |
| 8 | ISOGND | 63.554 | 22.964 |
| 9 | GND | 63.554 | 13.604 |
| 10 | SDATA1 | 64.824 | 13.604 |
| 11 | CS1 | 66.094 | 13.604 |
| 12 | CLK1 | 67.364 | 13.604 |
| 13 | PWM_TRANS1 | 68.634 | 13.604 |
| 14 | PWM_TRANS2 | 69.904 | 13.604 |
| 15 | PWM_TRANS3 | 71.174 | 13.604 |
| 16 | VCC | 72.444 | 13.604 |

## U14

5 pads, SMD, side top

| pin | net | x | y |
|---|---|---|---|
| 1 | #00227 | 60.395 | -13.800 |
| 2 | GND | 61.334 | -13.800 |
| 3 | #00226 | 62.300 | -13.800 |
| 4 | #00228 | 62.300 | -11.412 |
| 5 | VCC | 60.395 | -11.412 |

## U15

16 pads, SMD, side top

| pin | net | x | y |
|---|---|---|---|
| 1 | 3V3_ISO | 60.445 | 22.980 |
| 2 | ADASEL0_ISO | 59.175 | 22.980 |
| 3 | ADASEL1_ISO | 57.905 | 22.980 |
| 4 | ADASEL2_ISO | 56.635 | 22.980 |
| 5 | GPIO_BYPASS_RLY_ISOLATED | 55.365 | 22.980 |
| 6 | ADCLK_ISO | 54.095 | 22.980 |
| 7 | MDATA_ISO | 52.825 | 22.980 |
| 8 | ISOGND | 51.555 | 22.980 |
| 9 | GND | 51.555 | 13.620 |
| 10 | MDATA | 52.825 | 13.620 |
| 11 | #00465 | 54.095 | 13.620 |
| 12 | GPIO_BYPASS_RLY | 55.365 | 13.620 |
| 13 | ADASEL2 | 56.635 | 13.620 |
| 14 | ADASEL1 | 57.905 | 13.620 |
| 15 | ADASEL0 | 59.175 | 13.620 |
| 16 | VCC | 60.445 | 13.620 |

## U16

16 pads, SMD, side top

| pin | net | x | y |
|---|---|---|---|
| 1 | 3V3_ISO | 88.204 | 14.132 |
| 2 | DAB_PWM_PRI_LO_ISO | 87.306 | 15.030 |
| 3 | DAB_PWM_PRI_HI_ISO | 86.408 | 15.928 |
| 4 | PWM_G3_ISO | 85.510 | 16.826 |
| 5 | PWM_G1_ISO | 84.612 | 17.724 |
| 6 | PWM_G2_ISO | 83.714 | 18.622 |
| 7 | PWM_G4_ISO | 82.816 | 19.520 |
| 8 | ISOGND | 81.918 | 20.418 |
| 9 | GND | 75.300 | 13.800 |
| 10 | PWM_G4 | 76.198 | 12.901 |
| 11 | PWM_G2 | 77.096 | 12.003 |
| 12 | PWM_G1 | 77.994 | 11.105 |
| 13 | PWM_G3 | 78.892 | 10.207 |
| 14 | DAB_PWM_PRI_HI | 79.790 | 9.309 |
| 15 | DAB_PWM_PRI_LO | 80.688 | 8.411 |
| 16 | VCC | 81.586 | 7.513 |

## U17

16 pads, SMD, side top

| pin | net | x | y |
|---|---|---|---|
| 1 | N/C | 83.320 | 4.970 |
| 2 | N/C | 83.320 | 3.700 |
| 3 | N/C | 83.320 | 2.430 |
| 4 | N/C | 83.320 | 1.160 |
| 5 | N/C | 83.320 | -0.110 |
| 6 | N/C | 83.320 | -1.380 |
| 7 | N/C | 83.320 | -2.650 |
| 8 | N/C | 83.320 | -3.920 |
| 9 | N/C | 92.680 | -3.920 |
| 10 | N/C | 92.680 | -2.650 |
| 11 | N/C | 92.680 | -1.380 |
| 12 | N/C | 92.680 | -0.110 |
| 13 | N/C | 92.680 | 1.160 |
| 14 | N/C | 92.680 | 2.430 |
| 15 | N/C | 92.680 | 3.700 |
| 16 | N/C | 92.680 | 4.970 |
