johonkanen/ac_psu_kicad/fab/jlc_bom.csv

Comment | Designator | Footprint | JLCPCB Part #
10k | R1,R7,R8,R17,R21,R37,R38,R46,R51,R52,R53,R76 | 0402 | C25744
39R | R22 | 0402 | C2909354
820R | R30,R40 | 0402 | C54920831
8.2k | R9,R18,R39,R54,R56,R77,R128,R129,R130 | 0402 | C25924
33R | R50,R55,R72 | 0402 | C25105
10R | R86 | 0402 | C25077
12.4R | R57,R58,R73,R74,R92,R93 | 0402 | C477607
2.2k | R78,R88,R89,R90 | 0603 | C4190
470R | R59,R75,R94 | 0805 | C17710
91k | R2,R3,R4,R5,R6,R11,R12,R13,R14,R15,R16,R27,R28,R35,R36,R41,R42,R60,R61,R62,R63,R65,R66,R67,R68,R69,R70,R71,R80,R81,R82,R83,R84,R85,R95,R256 | 1206 | C2933767
0R | R96,R97 | 1206 | C17888
1nF | C9 | 0402 | C1523
1nF C0G | C95,C96,C97,C98,C99,C100,C101,C102,C103,C104,C105,C106 | 0402 | C307441
4.7nF C0G | C88,C89,C107,C108,C129,C130 | 0402 | C1518204
10nF C0G | C2,C42,C131 | 0402 | C22400107
100nF | C3,C4,C17,C18,C26,C27,C37,C38,C56,C64,C69,C70,C80,C81,C82,C83,C84,C85,C86,C87,C109,C110,C117,C118,C119,C120,C121,C122,C123,C124,C125,C126,C127,C128,C132,C133 | 0402 | C1525
1uF | C5,C6,C16,C39,C40 | 0402 | C52923
100nF | C43,C44,C55,C71,C73,C76,C77,C78,C114,C140,C141 | 0603 | C14663
220pF | C51,C52,C53,C54,C74,C75 | 0603 | C1603
100nF C0G | C90,C91,C92 | 1206 | C170182
4.7uF | C36,C41 | 1206 | C29823
22uF | C57,C58,C142,C143 | 1206 | C12891
100uF | C67 | 1206 | C883598
2.2uF 450V | C1,C35,C45,C46,C47,C48,C49,C50 | 2220 | C445674
22uH | L1 | 0805 | C32375
EEEFTE221XAP | C15,C28 | CP_Elec_6.3x7.7 | C190724
ZLLS400TA | D3,D4,D5,D10 | SOD-323 | C460267
MM3Z5V1T1G | D8,D9 | SOD-323 | C75074
2N7002 | Q13,Q14 | SOT-23 | C8545
REF3025AIDBZR | REF1,REF2 | SOT-23 | C11334
OPA2350EA/2K5 (alt. for OPA2353EA) | U1,U7 | VSSOP-8 | C115876
TLV316IDBVR | U2,U12,U14 | SOT-23-5 | C575578
TPS73033DBVR | U3,U10 | SOT-23-5 | C57424
SN74LV4051APWR | U11 | TSSOP-16 | C7793
ISO7760FDWR (alt. for Si8660BD-B-IS) | U16 | SOIC-16W | C2878538
422R | R19,R32 | 0402 | C67237
33R x4 | R87 | 4D02 0402x4 convex | C25501
AMC1306M05DWVR (alt. for ADuM7701-8BRIZ) | U4,U5,U6 | SOIC-8W 300mil | C701717
CA-IS3761LW (alt. for Si8661BD-B-IS) | U13,U15 | SOIC-16W | C528659
100nF 500V | C68 | 1206 | C5448934
10uF 50V X7R | C93 | 1210 | C138687
22uF 10V X5R | C94 | 0805 | C29277
1k | R104 | 0603 | C21190
10R 2W | R98 | 2512 | C3013385
47R | R100 | 0603 | C23182
59k | R101 | 0603 | C23085
21k | R102 | 0603 | C22956
118k | R103 | 0603 | C25806
0.56R (alt. for 0.562R) | R105 | 1206 | C2907358
10R | R106 | 0603 | C22859
10k | R107 | 0603 | C25804
4.7k | R108,R109 | 0805 | C17673
910R | R131 | 1206 | C2930433
511k | R132 | 0603 | C23194
105k | R133 | 0603 | C16840
100k | R134 | 0603 | C25803
13.3k | R135 | 0603 | C25952
6.8k 0.1% 25ppm | R110,R112,R114 | 0603 | C861539
10k 0.1% 25ppm | R111,R113,R115,R116,R118,R120,R122,R124,R126 | 0603 | C95204
24.9k 0.1% 25ppm | R117,R119,R121,R123,R125,R127 | 0603 | C136967
47nF 1kV X7R | C111,C112 | 1210 | C54916903
22uF 35V X5R (alt. for 15uF 50V) | C113 | 1210 | C778721
10uF 25V X7R | C139 | 1206 | C14860
75pF C0G | C144 | 0603 | C282074
10nF | C134 | 0402 | C15195
2.2uF | C135 | 0603 | C23630
1uF | C136 | 0603 | C15849
470uF 25V polymer | C115,C116 | CP_Elec_8x10 | C46550466
470uF 16V polymer | C137,C138 | CP_Elec_8x10 | C46550462
15uH SWPA6045S150MT | L2 | SWPA6045S | C83374
