johonkanen/ac_psu_kicad/fab/hand_fit.csv

Comment | Designator | Footprint | Source | Note
SLA-12VDC-SL-A | R20,R79 | Relay_SLA | JLC C55194 or distributor | THT relays placed by the user
2.2nF X1/Y2 disc (TDK CS45-E2GA222M-NKA) | C7,C10,C13,C14,C19,C20,C22,C23,C29,C30,C31,C32,C59,C60 | C_Disc P7.5 | JLC C96522 or distributor | Y2 is enough (user confirmed); placed by the user
C3M0065090D | Q1,Q2,Q3,Q4,Q5,Q6,Q7,Q8,Q9,Q10,Q11,Q12 | TO-247-3 | JLC C5713513 (23 in stock 2026-10-24) | heatsink-mounted SiC MOSFETs: fit by hand with the heatsink
470uF 450V snap-in, 35 mm, P10 (design: TDK B43504A5477M, 35x50) | C8,C11,C12,C61,C72,C79 | CP_Radial_D35 P10 snap-in | JLC C439920 Rubycon 450VXH470MEFCSN35X40 (301 in stock 2026-10-31; 5000 h at 105 C, preferred for the passively cooled chassis); alt. C1581700 Rubycon 450MXG470MEFCSN35X40 (1983, 3000 h) | 35 x 40 mm (10 mm lower than the B43504); check that the snap-in pins match the 2-pin P10 footprint; DC link rating 450 V (user: OK)
6.8uF X2 305VAC film, P27.5 (design: 7u 250VAC film) | C21,C24,C25,C33,C34 | C_Rect 33x20 P27.5 | JLC C17700119 Faratronic C42Q2685MBSC450 (181 in stock 2026-10-31) | all five are line-to-line X capacitors (C21/C24/C25 mains EMI filter, C33/C34 inverter output filter), so X2 safety rated; 6.8u vs 7u = -3 %; check the body against the 33 x 20 mm footprint outline before ordering (size not verified)
WE-CMBNC | CM1,CM2,CM3 | L_CommonMode_WE-CMBNC | sourced by the user (AliExpress) | hand-soldered by the user, no order code needed
TWW10J15RE | R10 | R_Radial_Power P5 | distributor (JLC 0 stock) | inrush resistor 15R 10W
FKK5R0020FE-TR | R48,R64,R91 | R_Shunt_FKK5R0020FE (4-terminal) | distributor (Ohmite; JLC C2482698 0 stock) | no JLC part fits the 4-terminal land pattern
VXO7805-500 / R-78E5.0-0.5 | U9 | SIP-3 P2.54 | CUI distributor or JLC C18212367 (YLPTEC R-78E5.0-0.5) | clone: same pinout; check its body side vs fix 6 before fitting
K7805-2000R3 (Mornsun) | U8 | SIP-3 P2.54 | Mornsun via a distributor (genuine part); JLC has clones only, e.g. YLPTEC C18212380 | v4 fix 10: 5 V / 2 A for the isolated control card (efinix POWER_BUDGET.md); body 11.5 x 9.0 x 17.5 mm standing, away from J12
1.27mm 2x24 female socket (pins 15-26 29-40 43-48 used) | J1,J2,J3,J4,J6,J8 | PinHeader 2x24 P1.27 partial | distributor | female (user confirmed); mates with the gate-driver boards
1.27mm 2x19 female socket | J11 | PinHeader 2x19 P1.27 | distributor | female (user confirmed); FPGA board connector
1.27mm 2x3 female socket | J12 | PinHeader 2x03 P1.27 | distributor | female (user confirmed)
PIN terminals | ACIN1,ACIN2,ACOUT1,ACOUT2,PE1,PE2,PE3,PE4,PE5,PE6,PE7,PE8,AFE_OUT1,DAB_PRI_1,DAB_PRI_2,DAB_SEC_1,DAB_SEC_2 | Terminal_* | hand wiring | wire/pin terminals (soldered leads). The pairs DAB_PRI_1/2, DAB_SEC_1/2, ACIN1/2, ACOUT1/2, AFE_OUT and PE1-PE8 have no room for an M4 terminal without re-layout (STATUS.md v4 fix 13)
Cable tie, nylon PA66 UV-resistant, UL94 V-2 or better, 2.5 x 100 mm | TIE_ACIN1,TIE_ACOUT1,TIE_ACOUT2,TIE_PE1,TIE_PE2,TIE_PE3,TIE_PE5,TIE_AFE_OUT1 | CableTie_NPTH_2x3.0mm_P5.5mm | any distributor | v4 fix 15: second fixing of the soldered lead wires (IEC 61010-1): tie each wire within 10 mm of its pin, around the insulation, through the two holes next to the pin. ACIN2, PE4, PE6-PE8, DAB_PRI_1/2, DAB_SEC_1/2 have no anchor (STATUS)
Wuerth 74650074R REDCUBE THR, M4 through thread, 50 A | FILTER_IN1,FILTER_OUT1,INU_OUT2,J5,J7,J9,J10 | Wuerth_REDCUBE-THR_74650074_M4_PTH | Mouser/Digikey (JLC C5118857, 0 stock 2026-10-31) | v4 fix 13: M4 ring-lug terminal (hand-solder the 4 pins; the 4.3 mm centre hole is plated). Per terminal: M4 x 6 mm pan-head screw (ISO 7045 / 7380, A2) + M4 spring/lock washer, torque per the Wuerth datasheet (about 1.2 Nm); insulated M4 ring lug (4.3 mm stud) for 2.5-6 mm2 (blue 1.5-2.5 / yellow 4-6 mm2, DIN 46234 / JIS RV class). Alternatives (not drop-in, other footprints): Amphenol AMT0440007DB0000G (M4, 35 A, JLC C22466633), Keystone 7799 (M4, 30 A, JLC C5370873)
ADS7056IRUGR | AD1 | X2QFN-8 1.5x1.5mm | bought by the user | X2QFN-8 0.5 mm pitch is hard to hand-solder: send the user's parts to JLC as consigned parts, or reflow with hot air
AMC1306M05DWVR (backup) | U4,U5,U6 | SOIC-8W 300mil | Mouser/Digikey | In the JLC BOM (C701717, 5 in stock 2026-10-30, 3 per board); if JLC runs out, the user buys from Mouser/Digikey and hand-solders
