johonkanen/ac_psu_kicad/reports/footprint_pads.csv

refdes | pad | residual | ipc_x | ipc_y | ipc_size | fp_size | d_long | d_short | axis_diff | ipc_drill | fp_drill
ACIN1 | 1 | 0.0000 | -107.240 | -46.380 | 2x2 | 2x2 | +0.000 | +0.000 |  | 1.4 | 1.4
ACIN1 | 1 | 0.0000 | -112.240 | -46.380 | 2x2 | 2x2 | +0.000 | +0.000 |  | 1.4 | 1.4
ACIN2 | 1 | 0.0000 | -107.240 | -40.380 | 2x2 | 2x2 | +0.000 | +0.000 |  | 1.4 | 1.4
ACIN2 | 1 | 0.0000 | -112.240 | -40.380 | 2x2 | 2x2 | +0.000 | +0.000 |  | 1.4 | 1.4
ACOUT1 | 1 | 0.0000 | -102.300 | -6.500 | 2x2 | 2x2 | +0.000 | +0.000 |  | 1.4 | 1.4
ACOUT1 | 1 | 0.0000 | -107.300 | -6.500 | 2x2 | 2x2 | +0.000 | +0.000 |  | 1.4 | 1.4
ACOUT2 | 1 | 0.0000 | -108.500 | 31.500 | 2x2 | 2x2 | +0.000 | +0.000 |  | 1.4 | 1.4
ACOUT2 | 1 | 0.0000 | -113.500 | 31.500 | 2x2 | 2x2 | +0.000 | +0.000 |  | 1.4 | 1.4
AD1 | 1 | 0.0000 | 63.149 | 7.894 | 0.55x0.25 | 0.55x0.25 | +0.000 | +0.000 | 0
AD1 | 2 | 0.0000 | 62.649 | 7.894 | 0.55x0.2 | 0.55x0.2 | +0.000 | +0.000 | 0
AD1 | 3 | 0.0000 | 62.149 | 7.894 | 0.55x0.25 | 0.55x0.25 | +0.000 | +0.000 | 0
AD1 | 4 | 0.0001 | 61.949 | 7.219 | 0.3x0.6 | 0.3x0.6 | +0.000 | +0.000 | 0
AD1 | 5 | 0.0000 | 62.149 | 6.544 | 0.55x0.25 | 0.55x0.25 | +0.000 | +0.000 | 0
AD1 | 6 | 0.0000 | 62.649 | 6.544 | 0.55x0.2 | 0.55x0.2 | +0.000 | +0.000 | 0
AD1 | 7 | 0.0000 | 63.149 | 6.544 | 0.55x0.25 | 0.55x0.25 | +0.000 | +0.000 | 0
AD1 | 8 | 0.0001 | 63.299 | 7.219 | 0.3x0.6 | 0.3x0.6 | +0.000 | +0.000 | 0
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
U9 | 1 | 0.0000 | 106.660 | -41.200 | 1.85x1.85 | 1.8x1.8 | -0.050 | -0.050 |  | 1.2 | 1.2
U9 | 2 | 0.0000 | 109.200 | -41.200 | 1.85x1.85 | 1.8x1.8 | -0.050 | -0.050 |  | 1.2 | 1.2
U9 | 3 | 0.0000 | 111.740 | -41.200 | 1.85x1.85 | 1.8x1.8 | -0.050 | -0.050 |  | 1.2 | 1.2
