johonkanen/ac_psu_kicad/reports/render/08_sdm_current_measurements.png

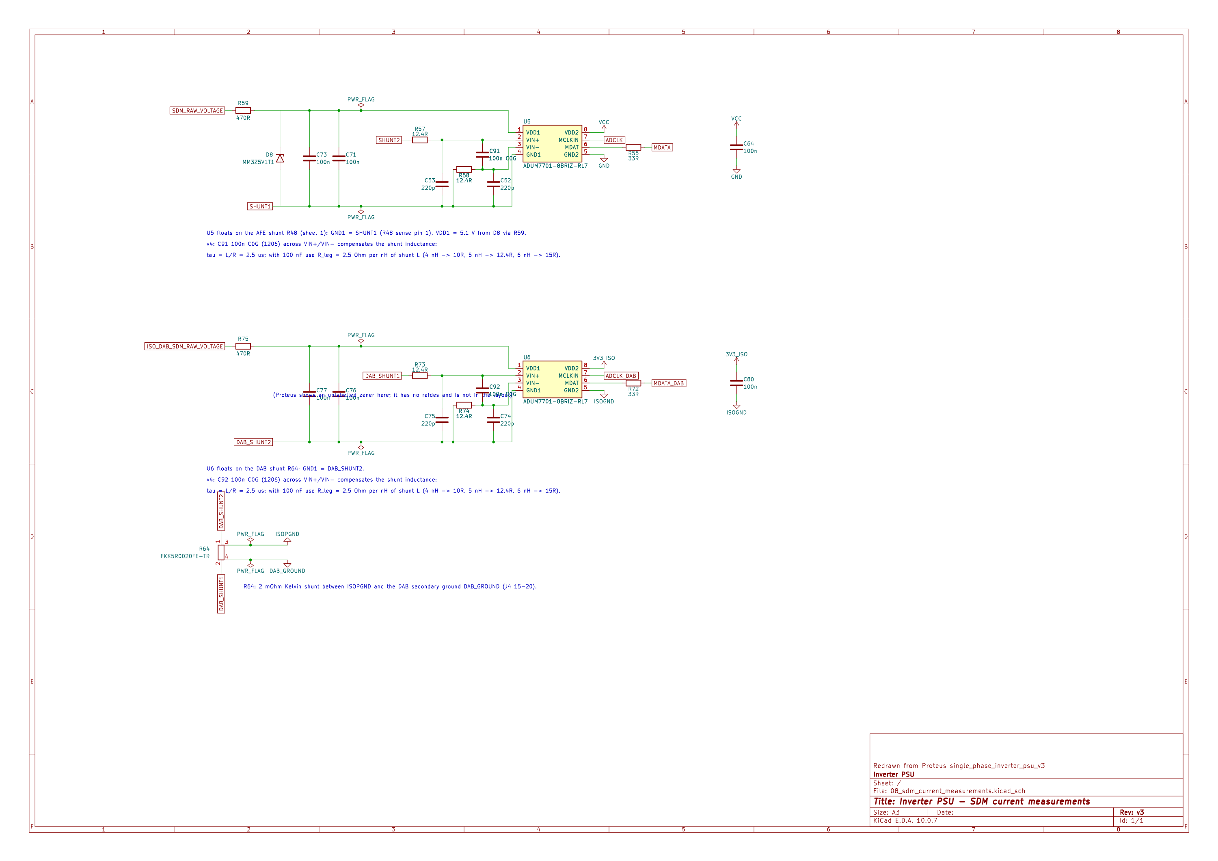
reports/render/08_sdm_current_measurements.png
