johonkanen/ac_psu_kicad/reports/v4/fix1_B.png

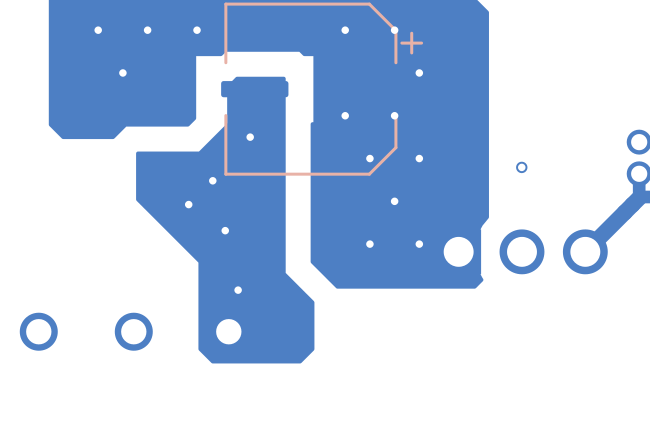
reports/v4/fix1_B.png
