johonkanen/ac_psu_kicad/reports/v4/fix1_In1.png

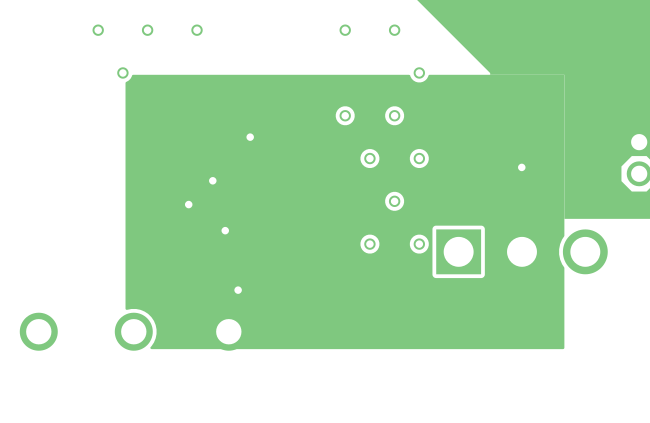
reports/v4/fix1_In1.png
