johonkanen/ac_psu_kicad/reports/v4/fix2_F.png

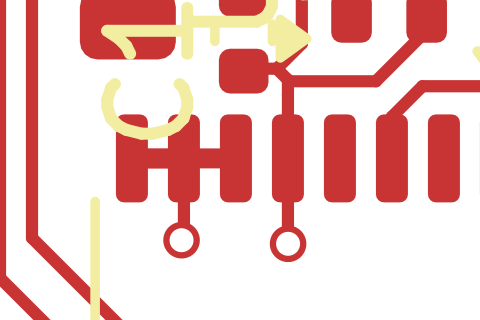
reports/v4/fix2_F.png
