johonkanen/ac_psu_kicad/reports/v4/fix3_FB.png

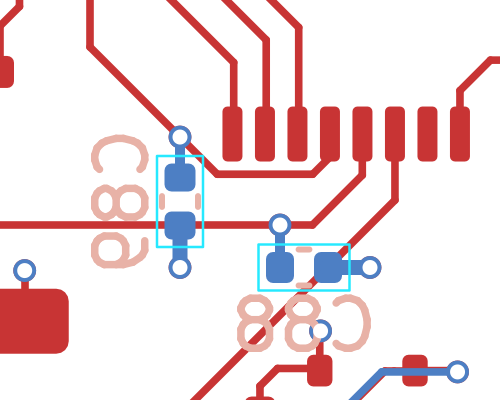
reports/v4/fix3_FB.png
