johonkanen/ac_psu_kicad/reports/v4/fix4_U4.png

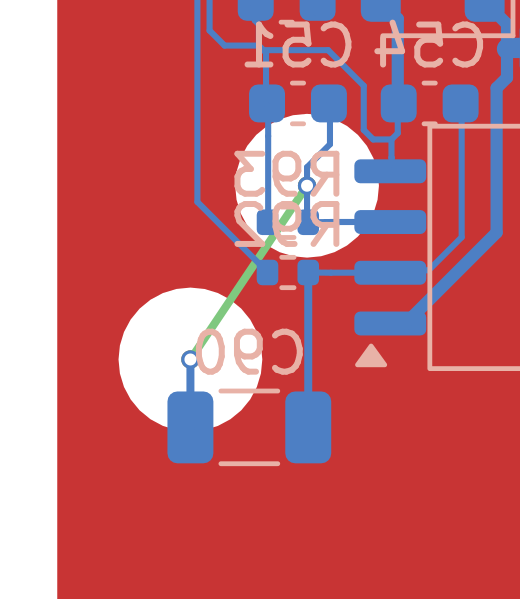
reports/v4/fix4_U4.png
