johonkanen/ac_psu_kicad/reports/v4/fix4_U6.png

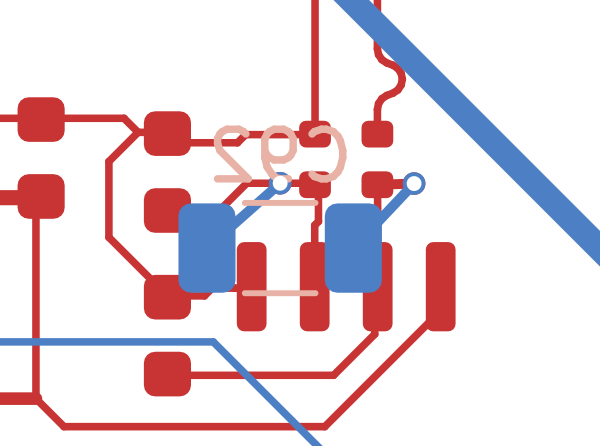
reports/v4/fix4_U6.png
