johonkanen/ac_psu_kicad/reports/v4/fix5_B.png

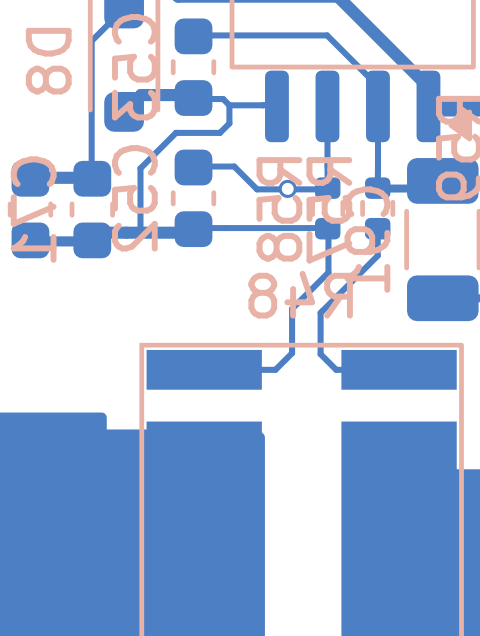
reports/v4/fix5_B.png
