johonkanen/ac_psu_kicad/reports/v4/fix6_F.png

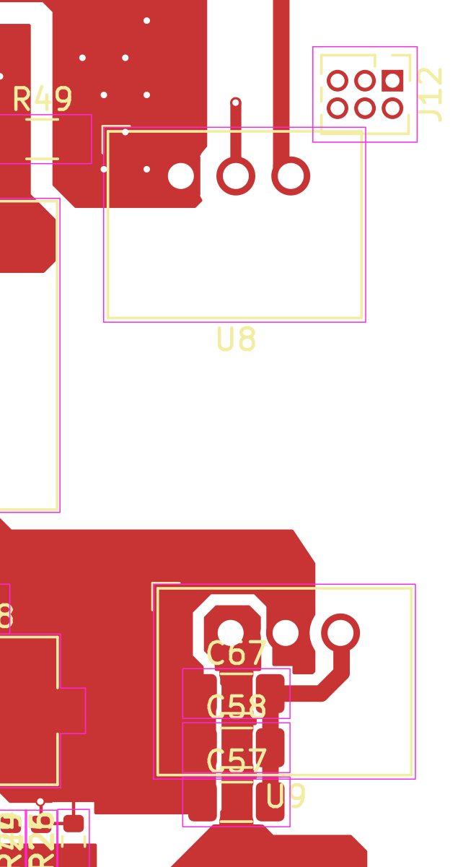
reports/v4/fix6_F.png
