johonkanen/ac_psu_kicad/reports/v4/fix8_afe_F.png

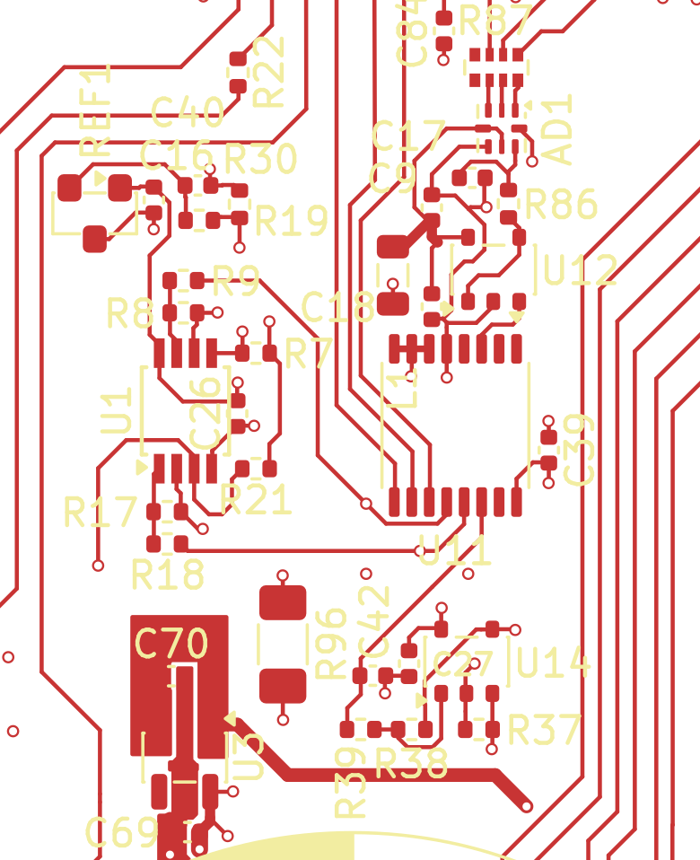
reports/v4/fix8_afe_F.png
