johonkanen/ac_psu_kicad/reports/v4/fix8_aux_F.png

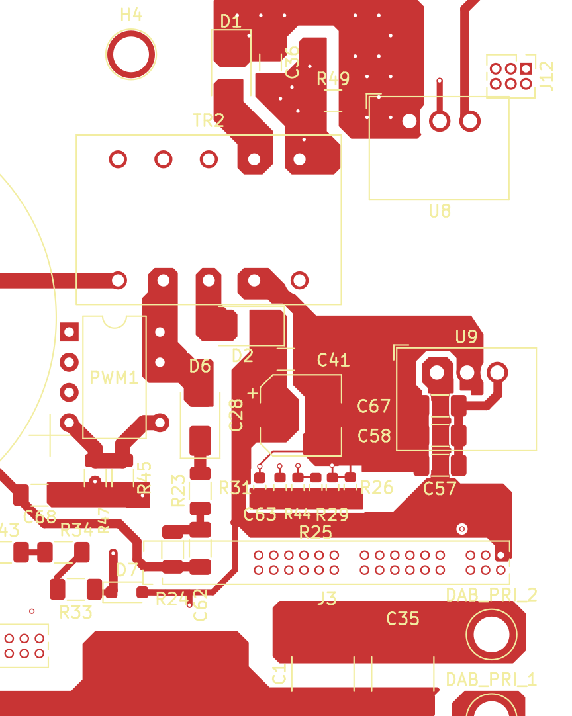
reports/v4/fix8_aux_F.png
