johonkanen/ac_psu_kicad/reports/v4/fix8_U5_B.png

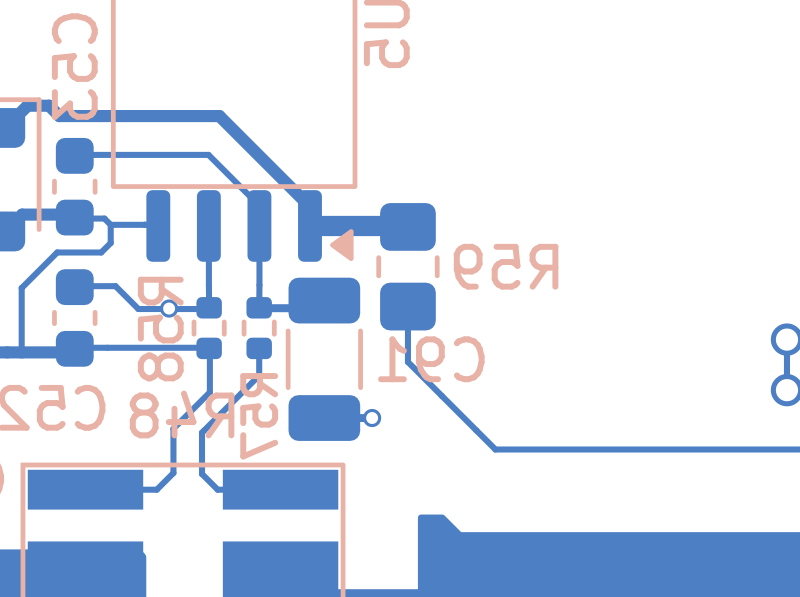
reports/v4/fix8_U5_B.png
