johonkanen/ac_psu_kicad/reports/v4/fix10_U8_B.png

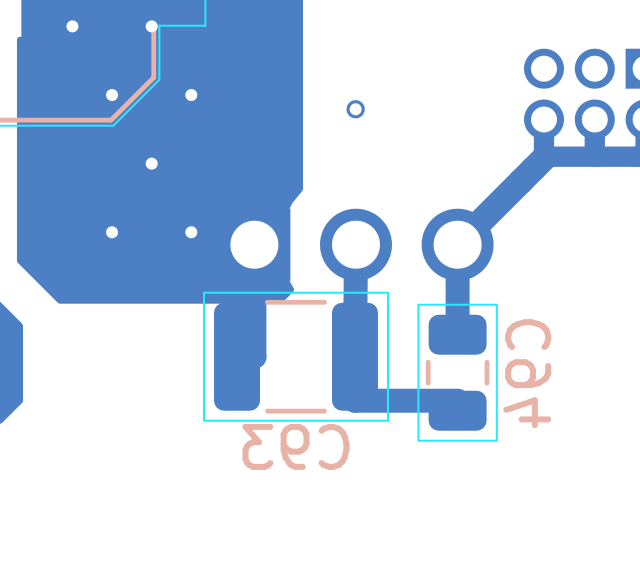
reports/v4/fix10_U8_B.png
