johonkanen/ac_psu_kicad/reports/v4/fix11_REF2.png

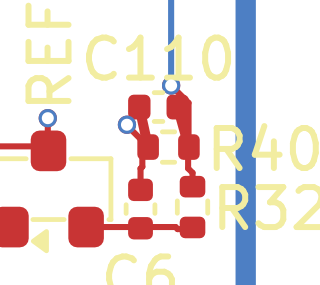
reports/v4/fix11_REF2.png
