johonkanen/ac_psu_kicad/reports/v4/fix11_U1.png

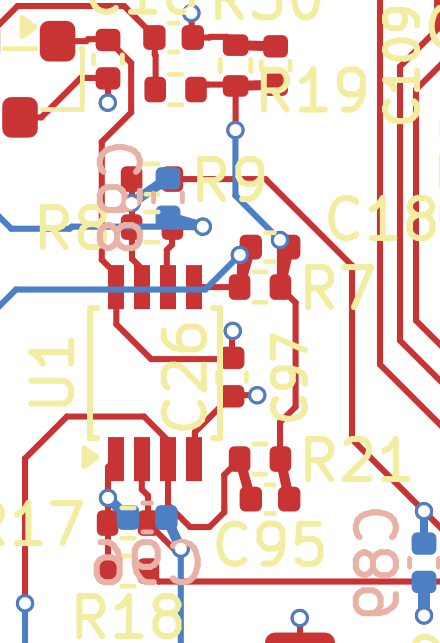
reports/v4/fix11_U1.png
