johonkanen/ac_psu_kicad/reports/v4/fix11_U7_U2.png

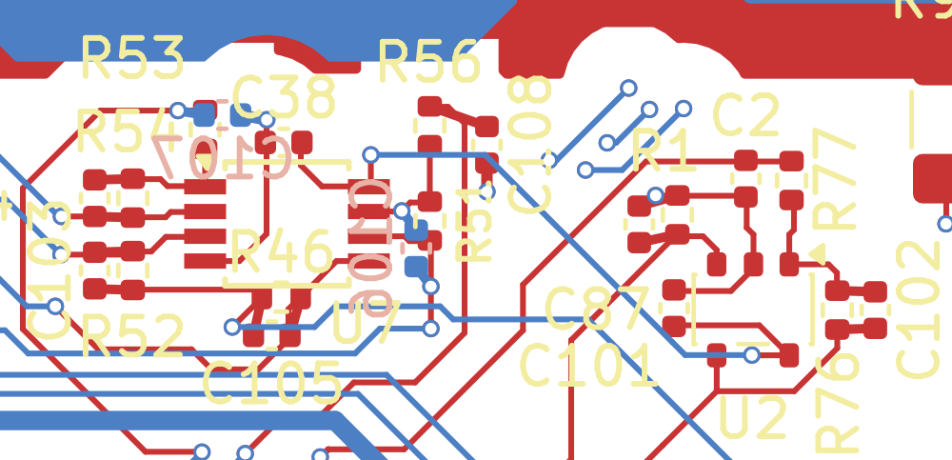
reports/v4/fix11_U7_U2.png
