johonkanen/ac_psu_kicad/reports/v4/fix13_FILTER_IN_before.png

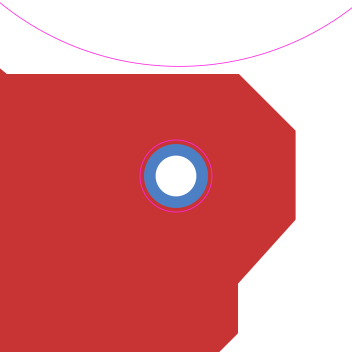
reports/v4/fix13_FILTER_IN_before.png
