johonkanen/ac_psu_kicad/reports/v4/fix13_FILTER_OUT.png

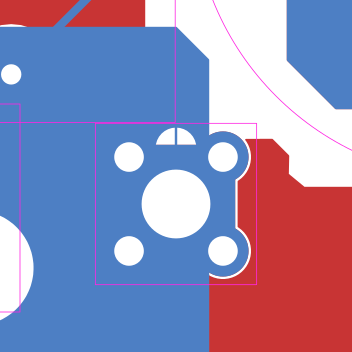
reports/v4/fix13_FILTER_OUT.png
