johonkanen/ac_psu_kicad/reports/v4/fix13_FILTER_OUT_before.png

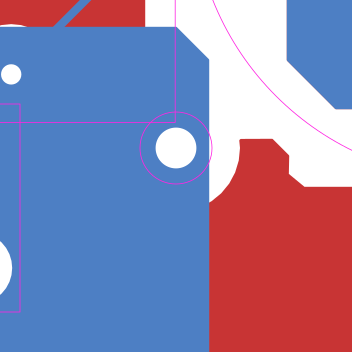
reports/v4/fix13_FILTER_OUT_before.png
