johonkanen/ac_psu_kicad/reports/v4/fix13_INU_OUT2.png

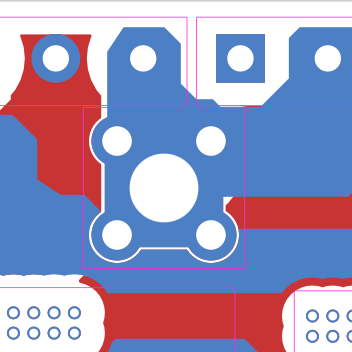
reports/v4/fix13_INU_OUT2.png
