johonkanen/ac_psu_kicad/reports/v4/fix13_INU_OUT2_before.png

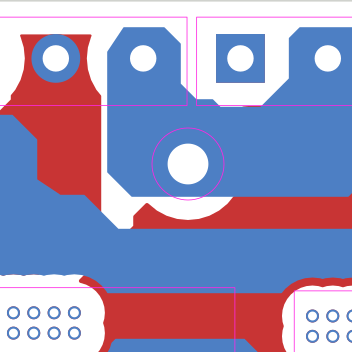
reports/v4/fix13_INU_OUT2_before.png
