johonkanen/ac_psu_kicad/reports/v4/fix13_J7.png

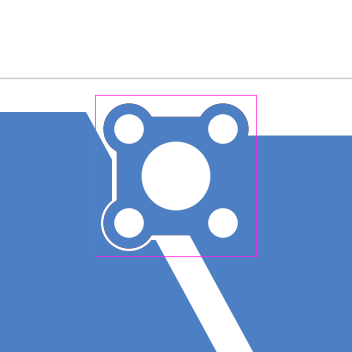
reports/v4/fix13_J7.png
