johonkanen/ac_psu_kicad/reports/v4/fix13_J10_before.png

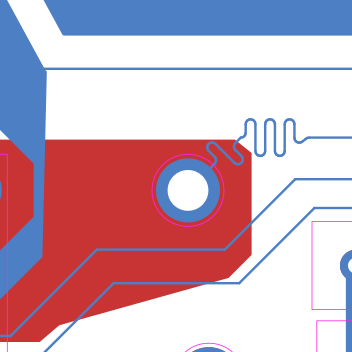
reports/v4/fix13_J10_before.png
