johonkanen/ac_psu_kicad/reports/v4/fix14_ACIN2_ACOUT_B.png

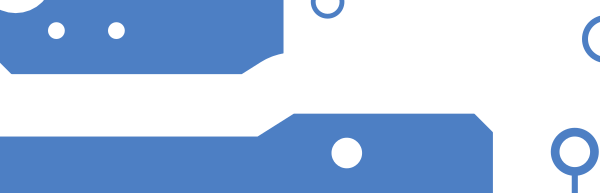
reports/v4/fix14_ACIN2_ACOUT_B.png
