johonkanen/ac_psu_kicad/reports/v4/fix14_ACIN2_ACOUT_F_before.png

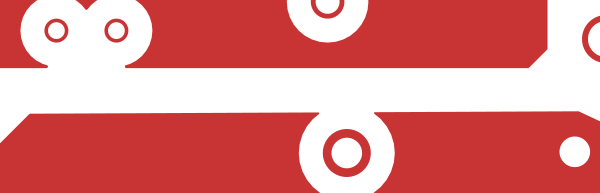
reports/v4/fix14_ACIN2_ACOUT_F_before.png
