johonkanen/ac_psu_kicad/reports/v4/fix14_PE1_B.png

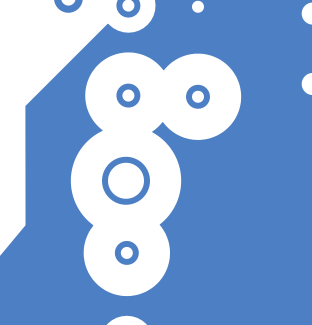
reports/v4/fix14_PE1_B.png
