johonkanen/ac_psu_kicad/reports/v4/fix14_PE1_F.png

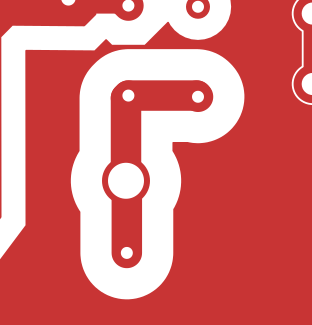
reports/v4/fix14_PE1_F.png
