johonkanen/ac_psu_kicad/reports/v4/fix14_PE1_F_before.png

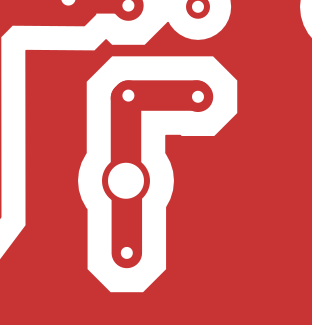
reports/v4/fix14_PE1_F_before.png
