johonkanen/ac_psu_kicad/reports/v4/fix14_PE3_PE4_B.png

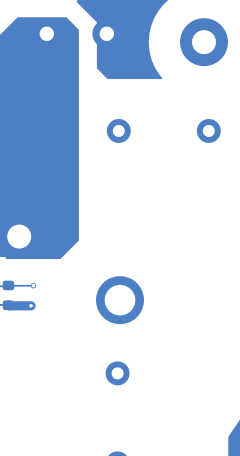
reports/v4/fix14_PE3_PE4_B.png
