johonkanen/ac_psu_kicad/reports/v4/fix14_PE3_PE4_B_before.png

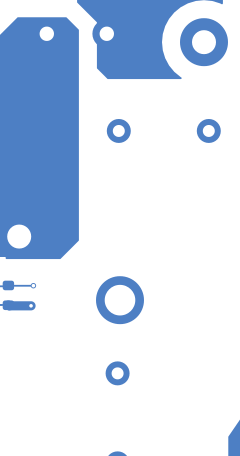
reports/v4/fix14_PE3_PE4_B_before.png
