johonkanen/ac_psu_kicad/reports/v4/fix14_tracks_In1.png

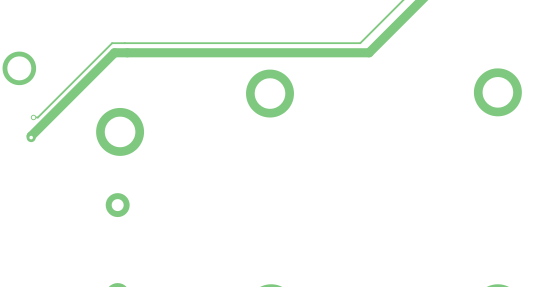
reports/v4/fix14_tracks_In1.png
