johonkanen/ac_psu_kicad/reports/v4/fix14_tracks_In2.png

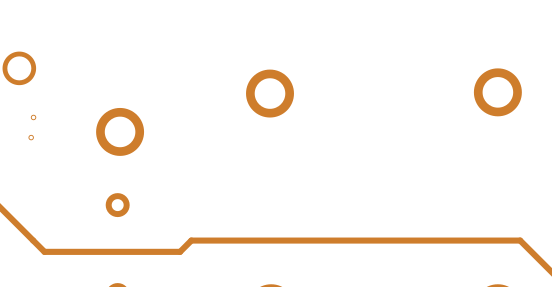
reports/v4/fix14_tracks_In2.png
