johonkanen/ac_psu_kicad/reports/v4/fix15_ACIN1.png

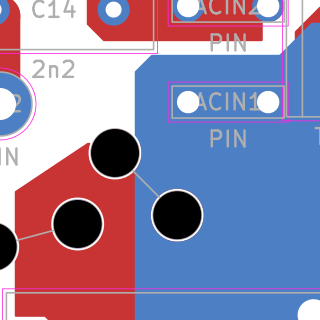
reports/v4/fix15_ACIN1.png
