johonkanen/ac_psu_kicad/reports/v4/fix15_ACOUT2.png

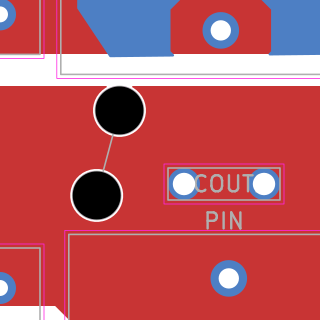
reports/v4/fix15_ACOUT2.png
