johonkanen/ac_psu_kicad/reports/v4/fix15_AFE_OUT.png

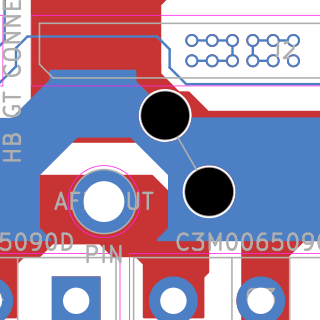
reports/v4/fix15_AFE_OUT.png
