johonkanen/ac_psu_kicad/source/schematic_pdf/single_phase_inverter_psu_v3.PDF

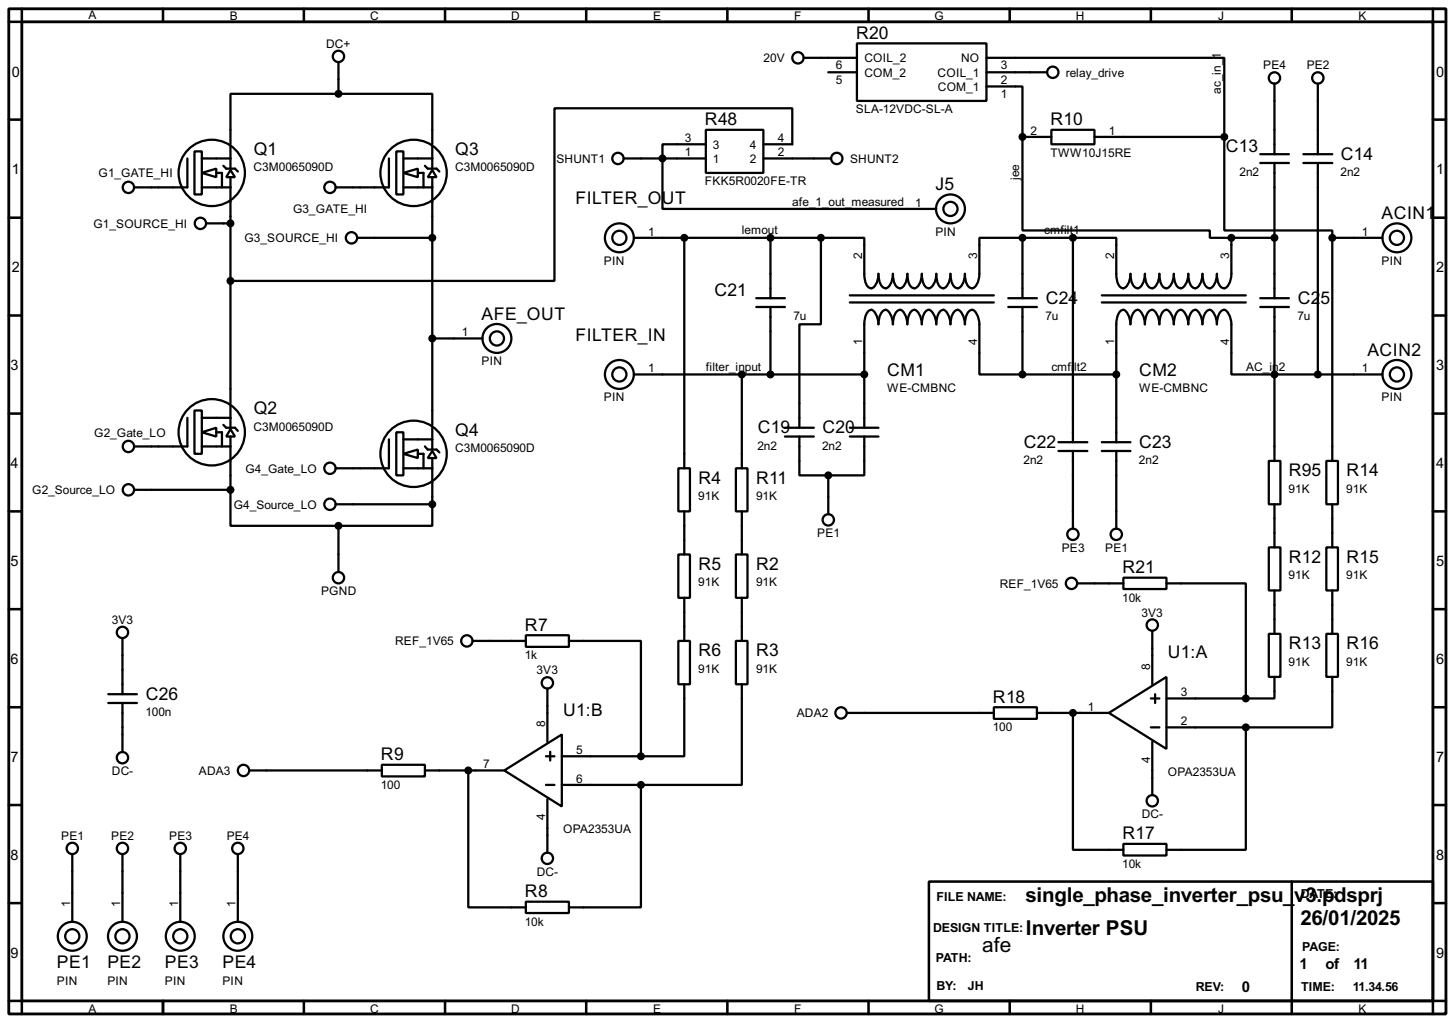
[picture p83: page 1]

DESIGN TITLE: Inverter PSU
afe

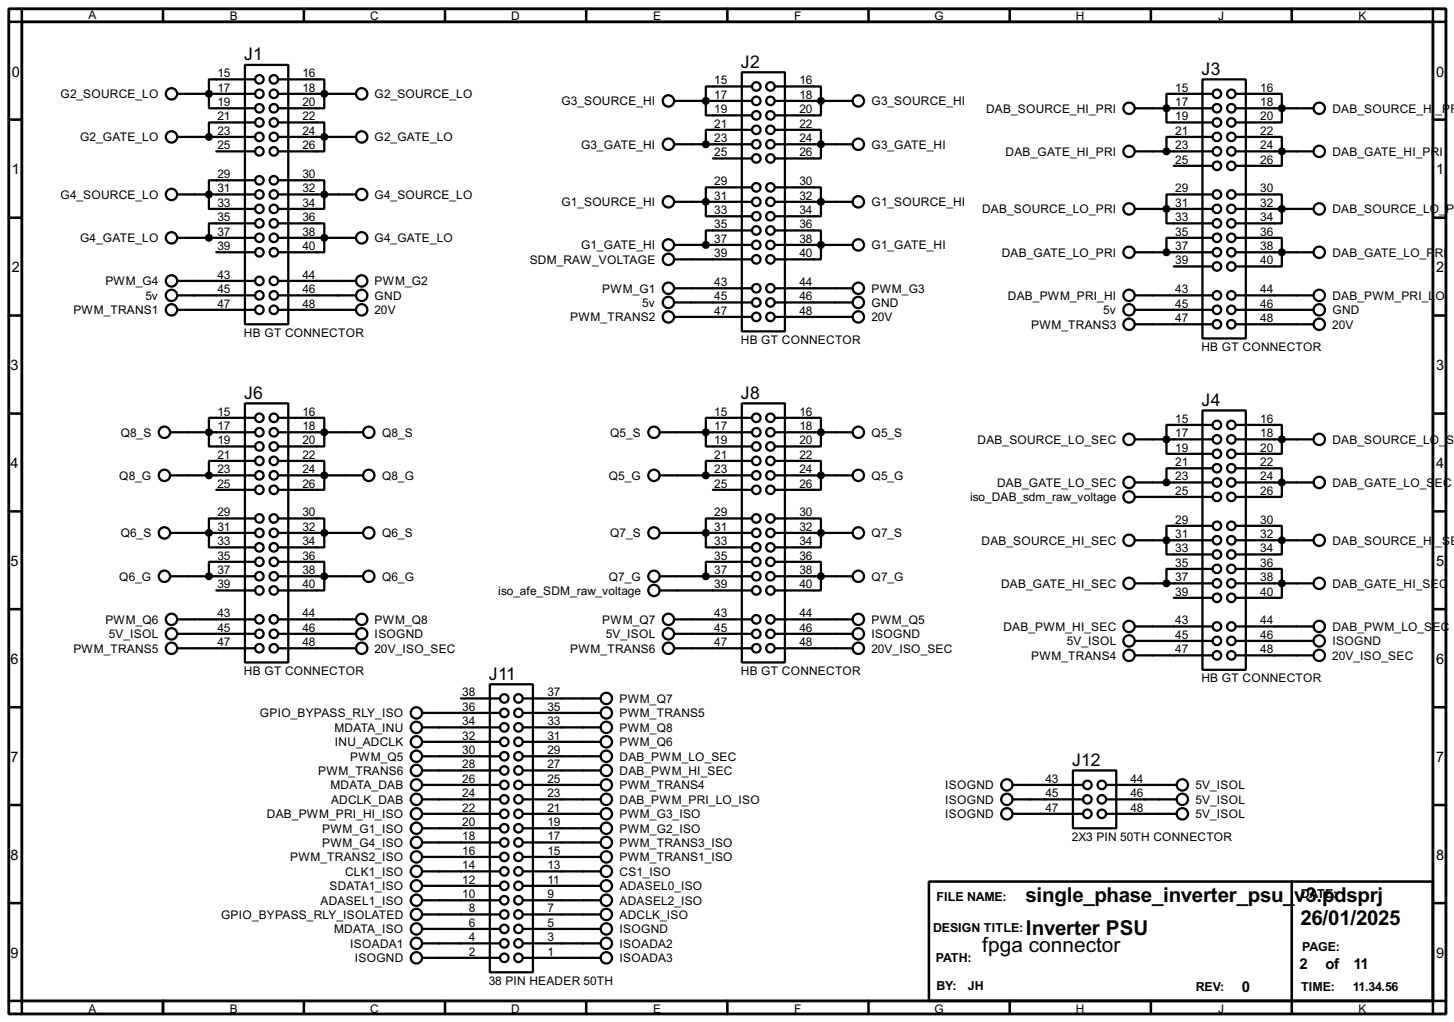
[picture p84: page 2]

DESIGN TITLE: Inverter PSU
fpga connector

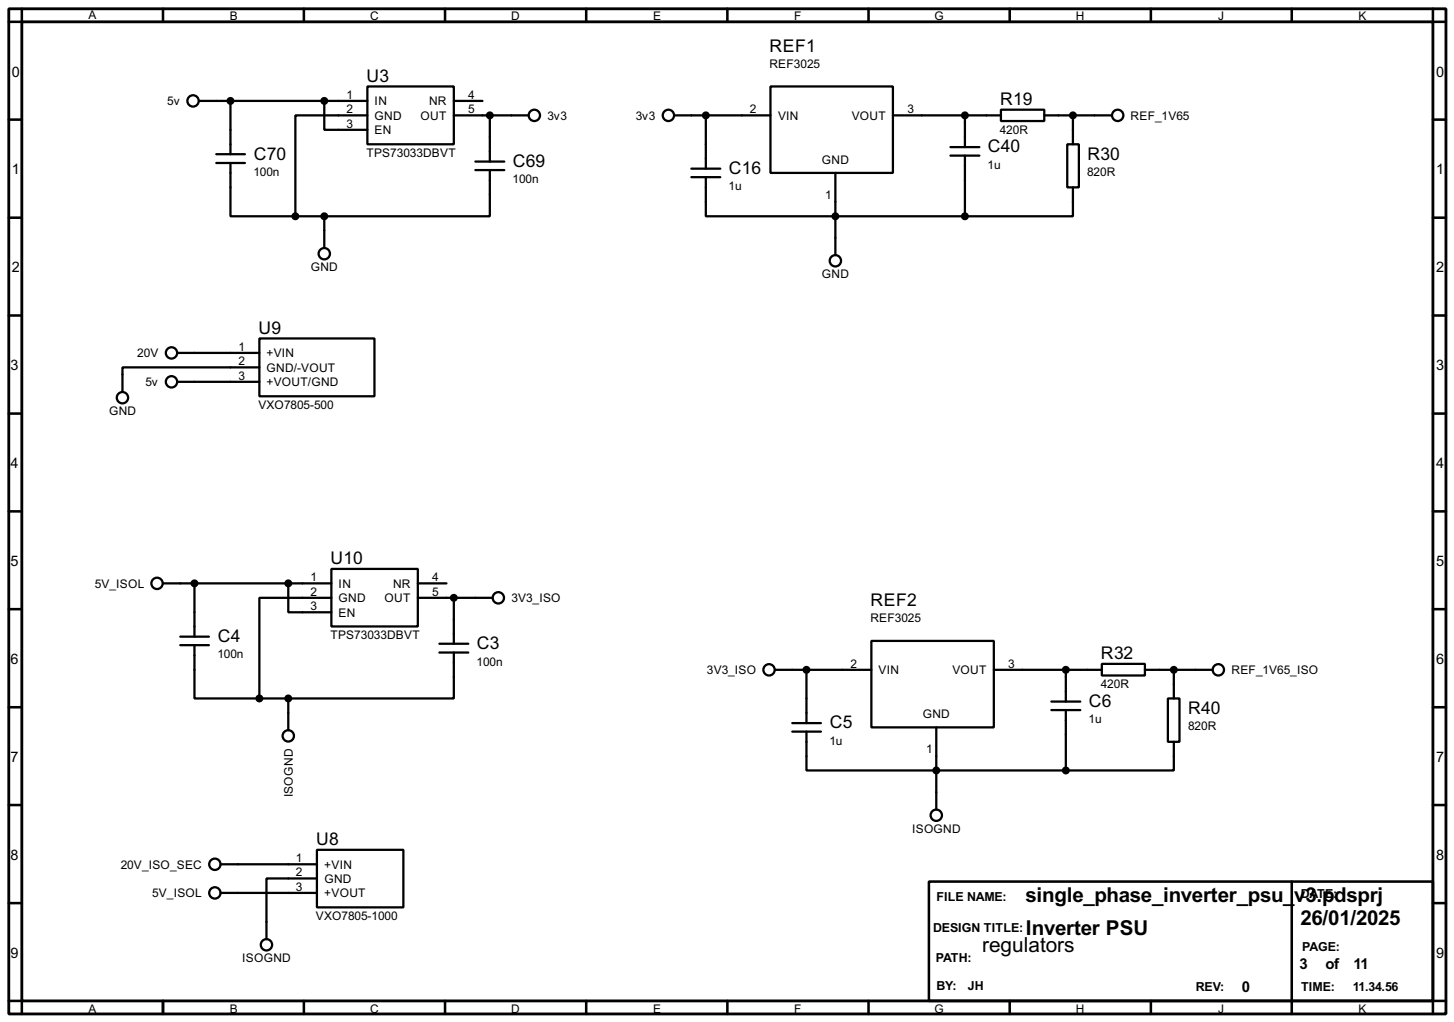
[picture p85: page 3]

DESIGN TITLE: Inverter PSU
regulators

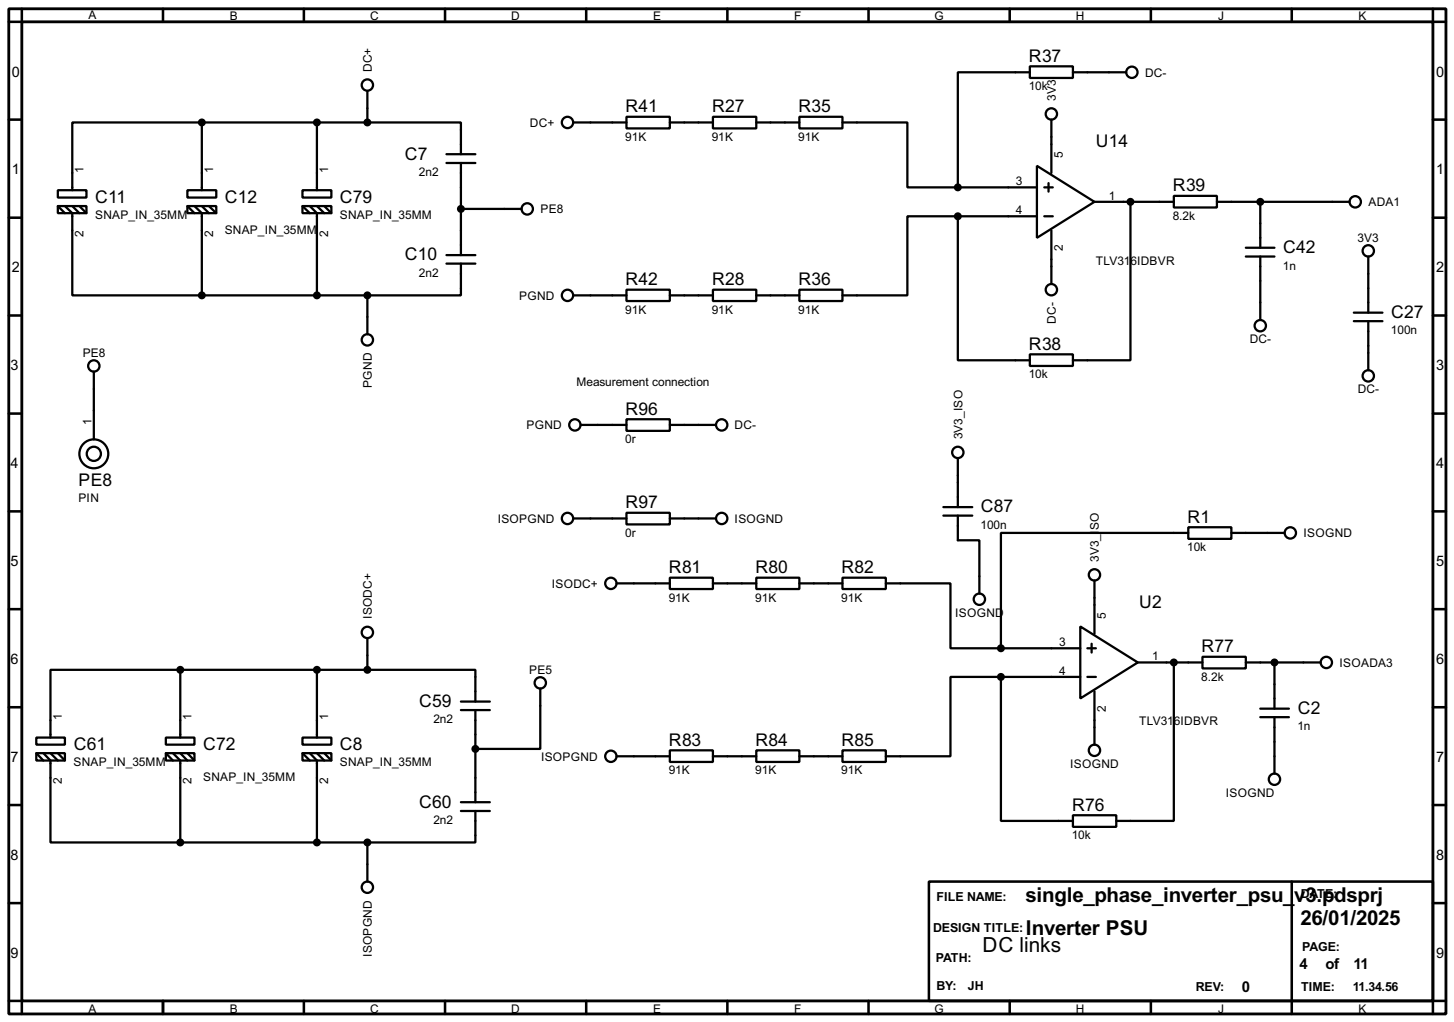
[picture p86: page 4]

DESIGN TITLE: Inverter PSU
DC links

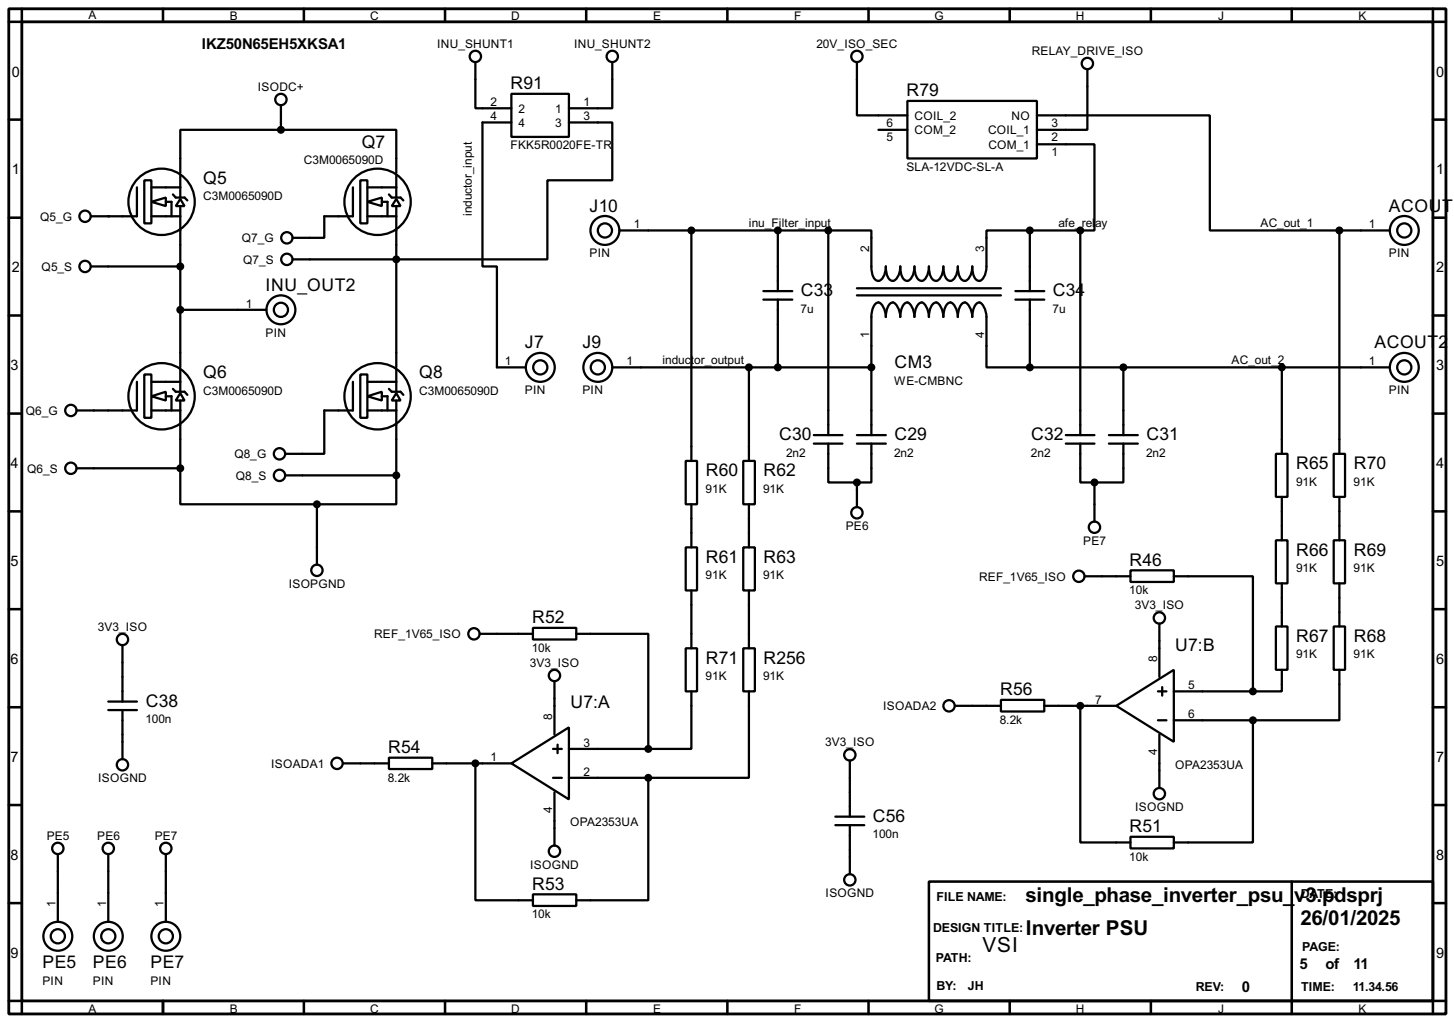
[picture p87: page 5]

DESIGN TITLE: Inverter PSU
VSI

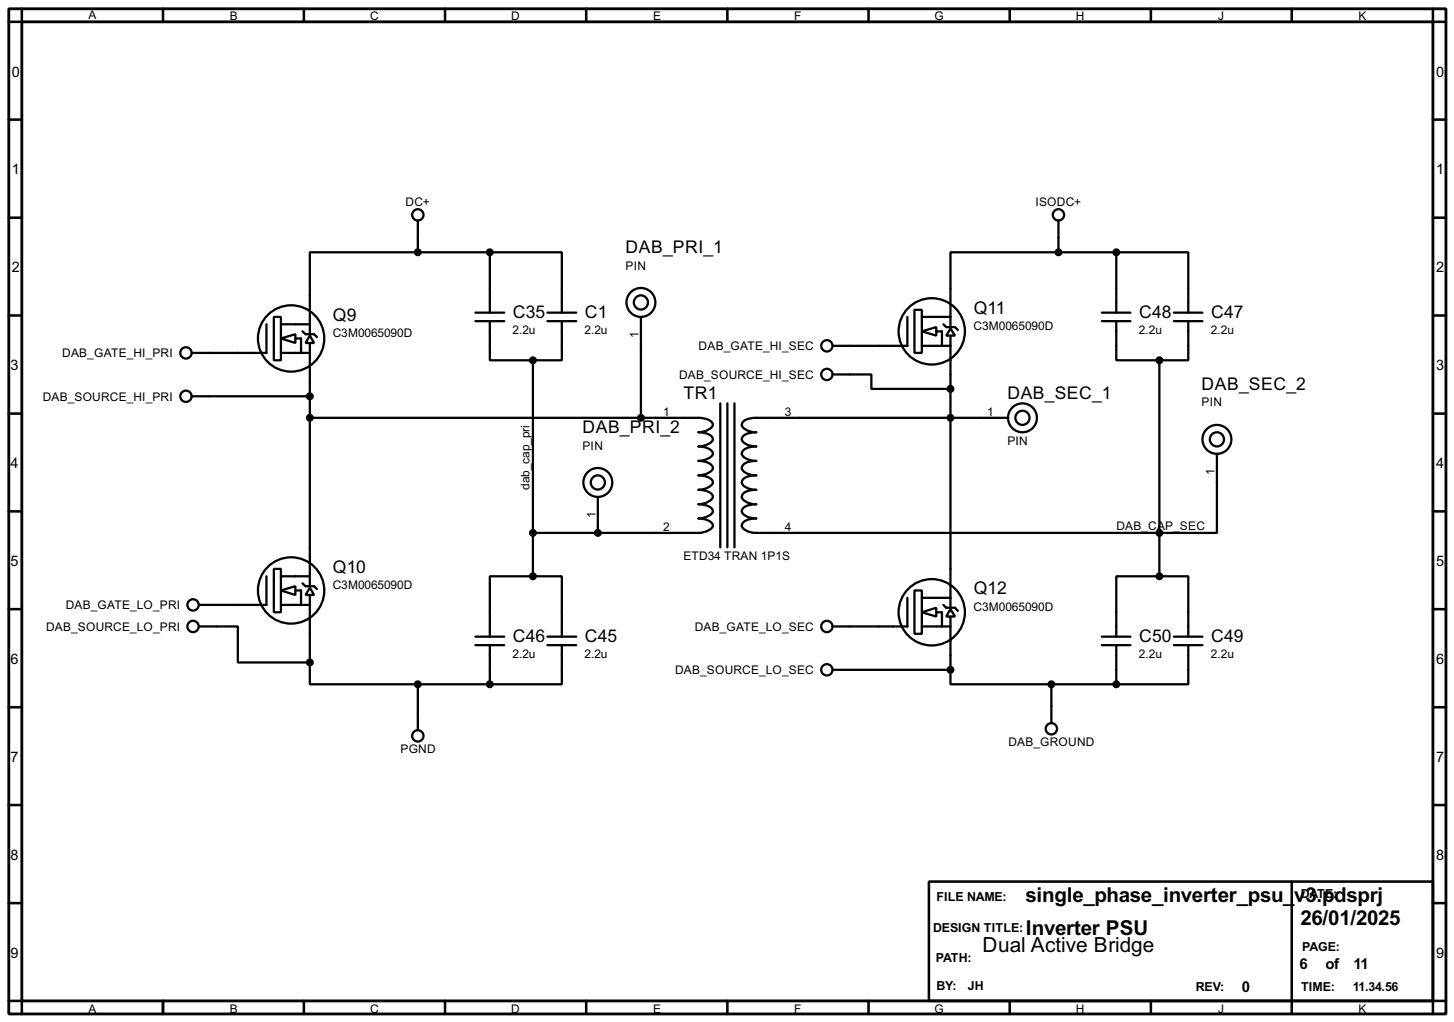
[picture p88: page 6]

DESIGN TITLE: Inverter PSU
Dual Active Bridge

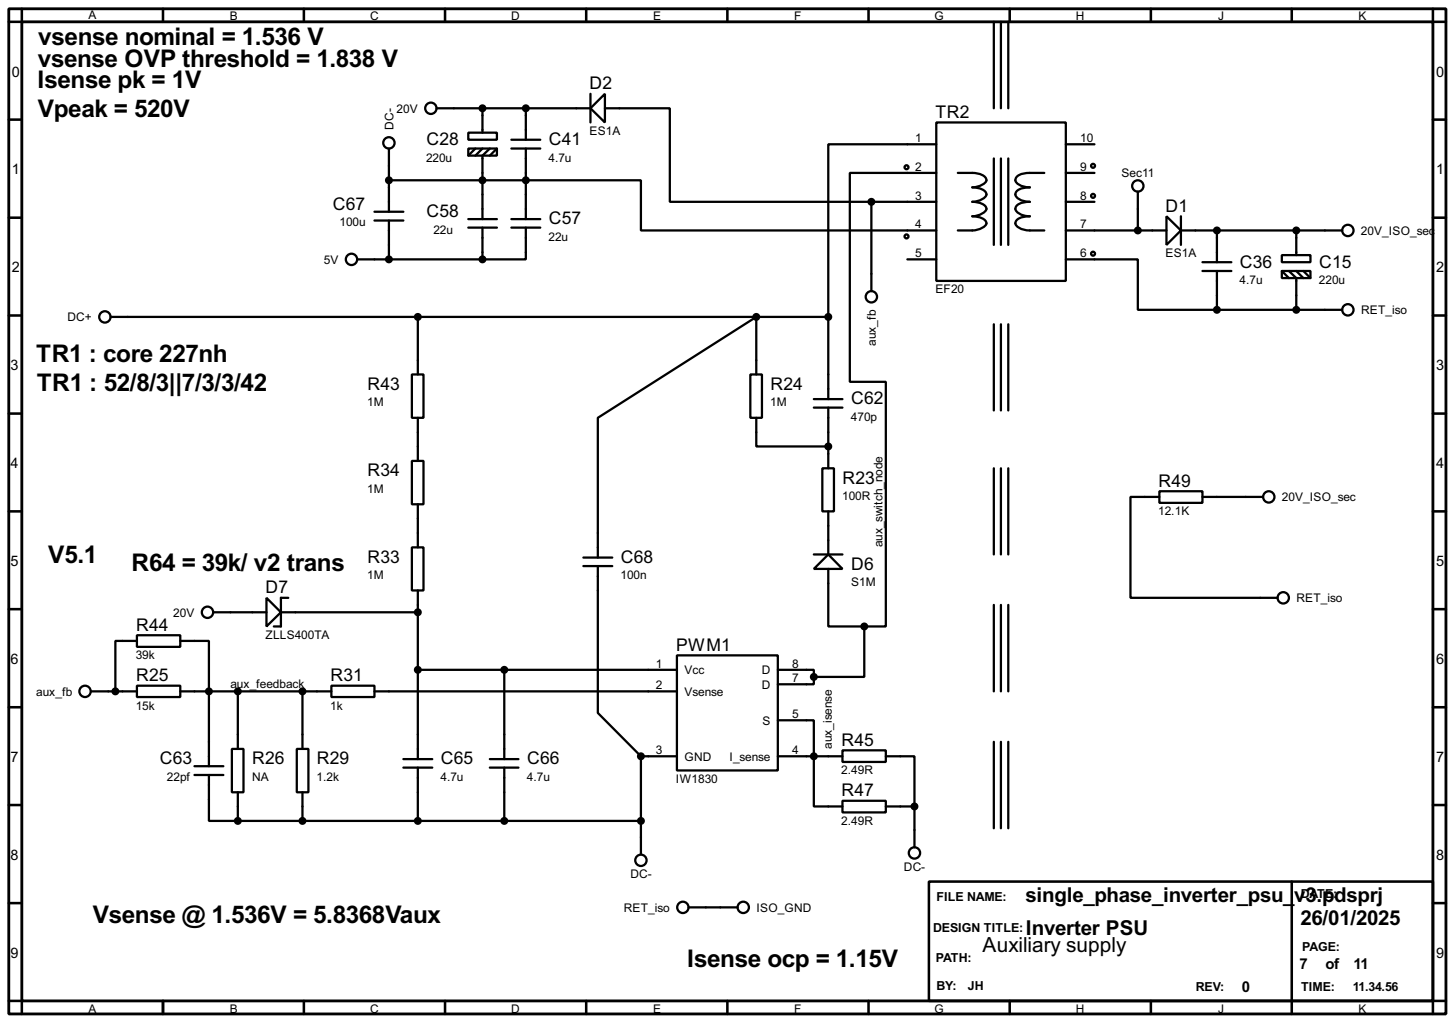
[picture p89: page 7]

DESIGN TITLE: Inverter PSU
Auxiliary supply

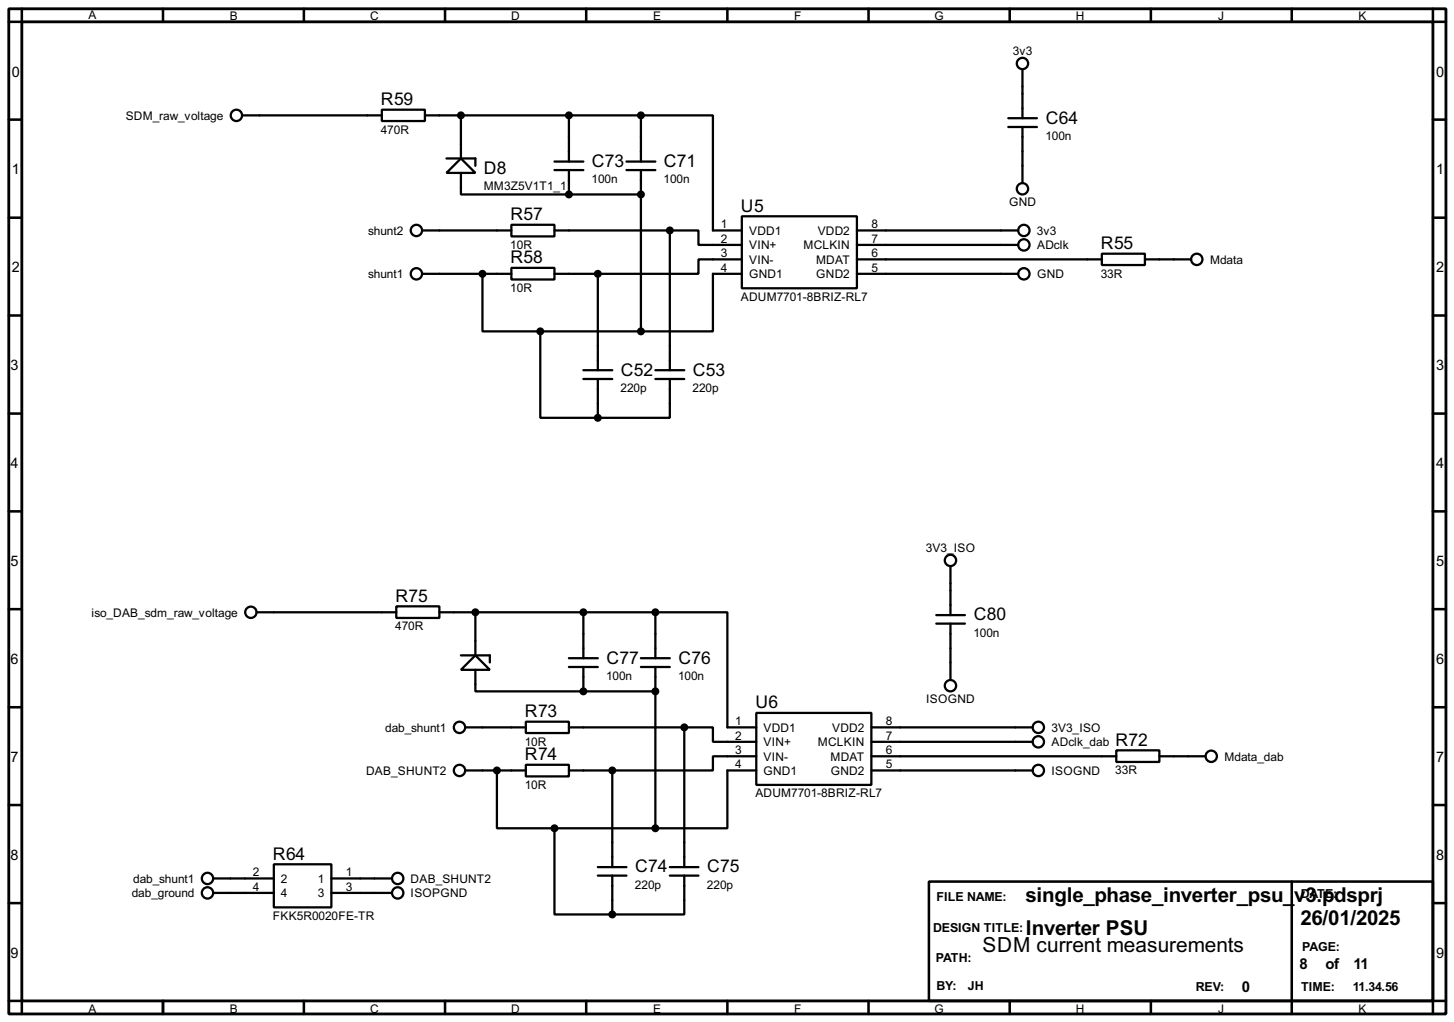
[picture p90: page 8]

DESIGN TITLE: Inverter PSU
SDM current measurements

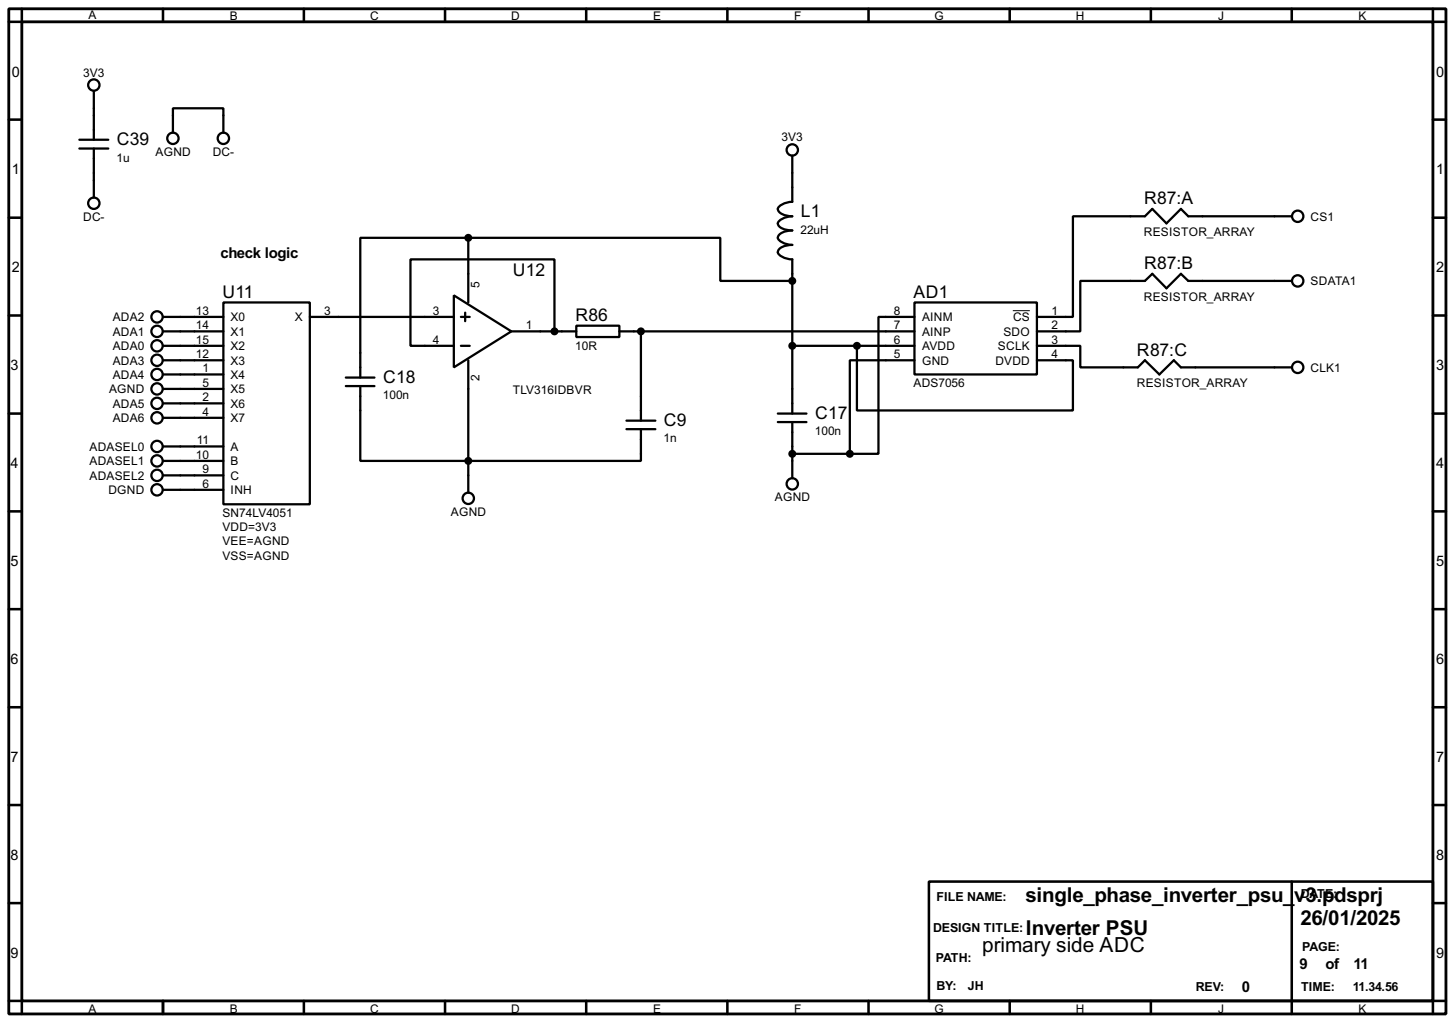
[picture p91: page 9]

DESIGN TITLE: Inverter PSU
primary side ADC

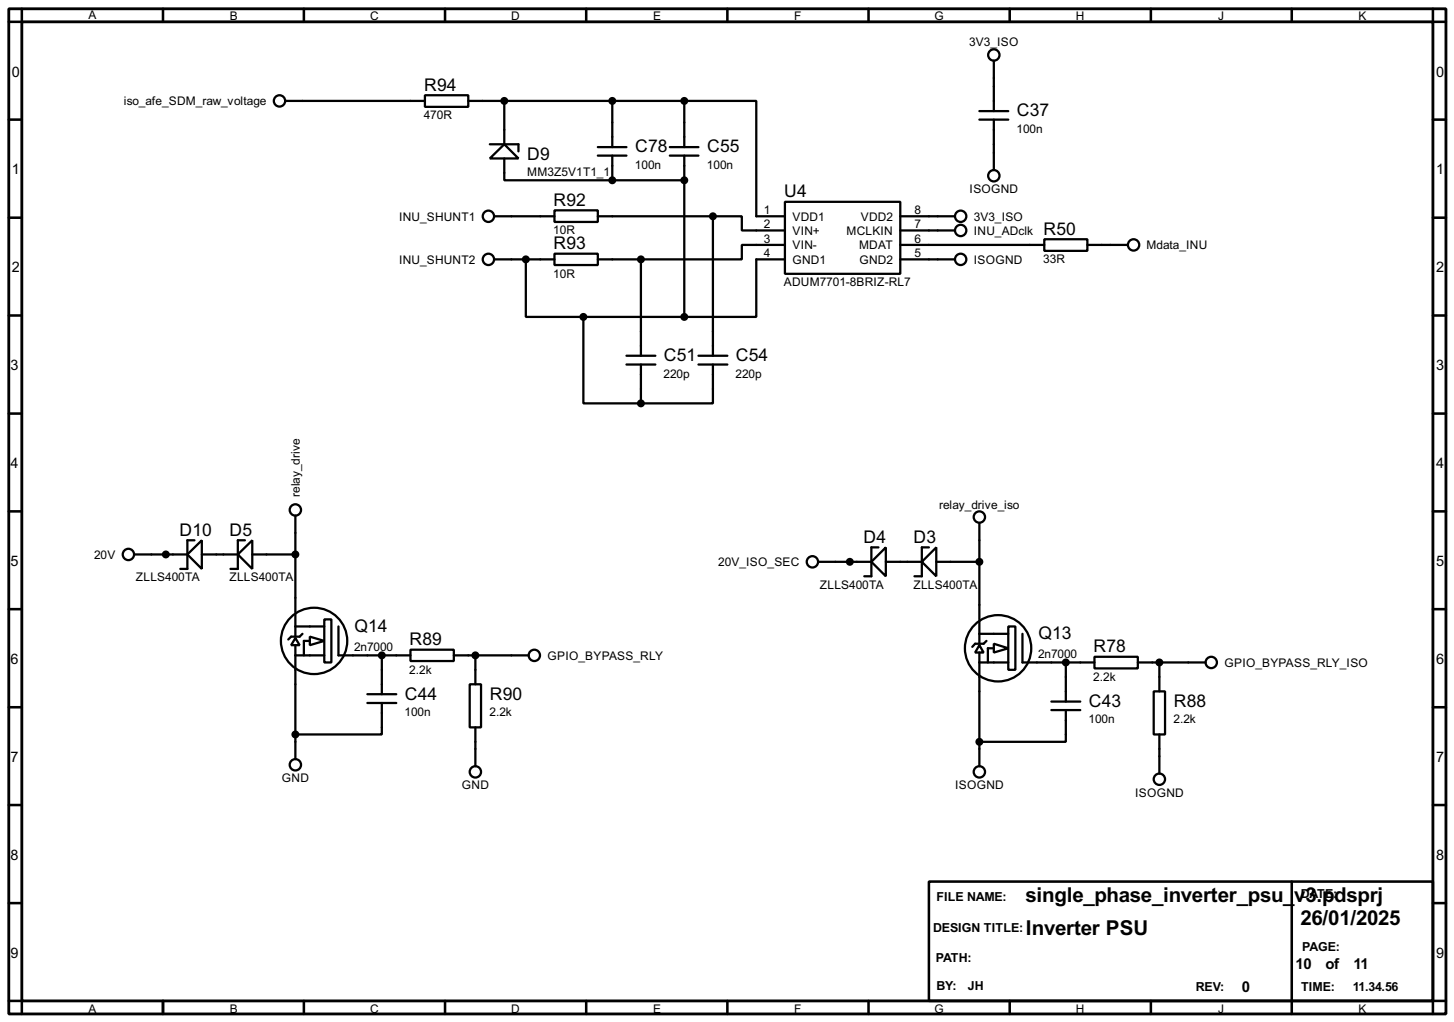
[picture p92: page 10]

DESIGN TITLE: Inverter PSU

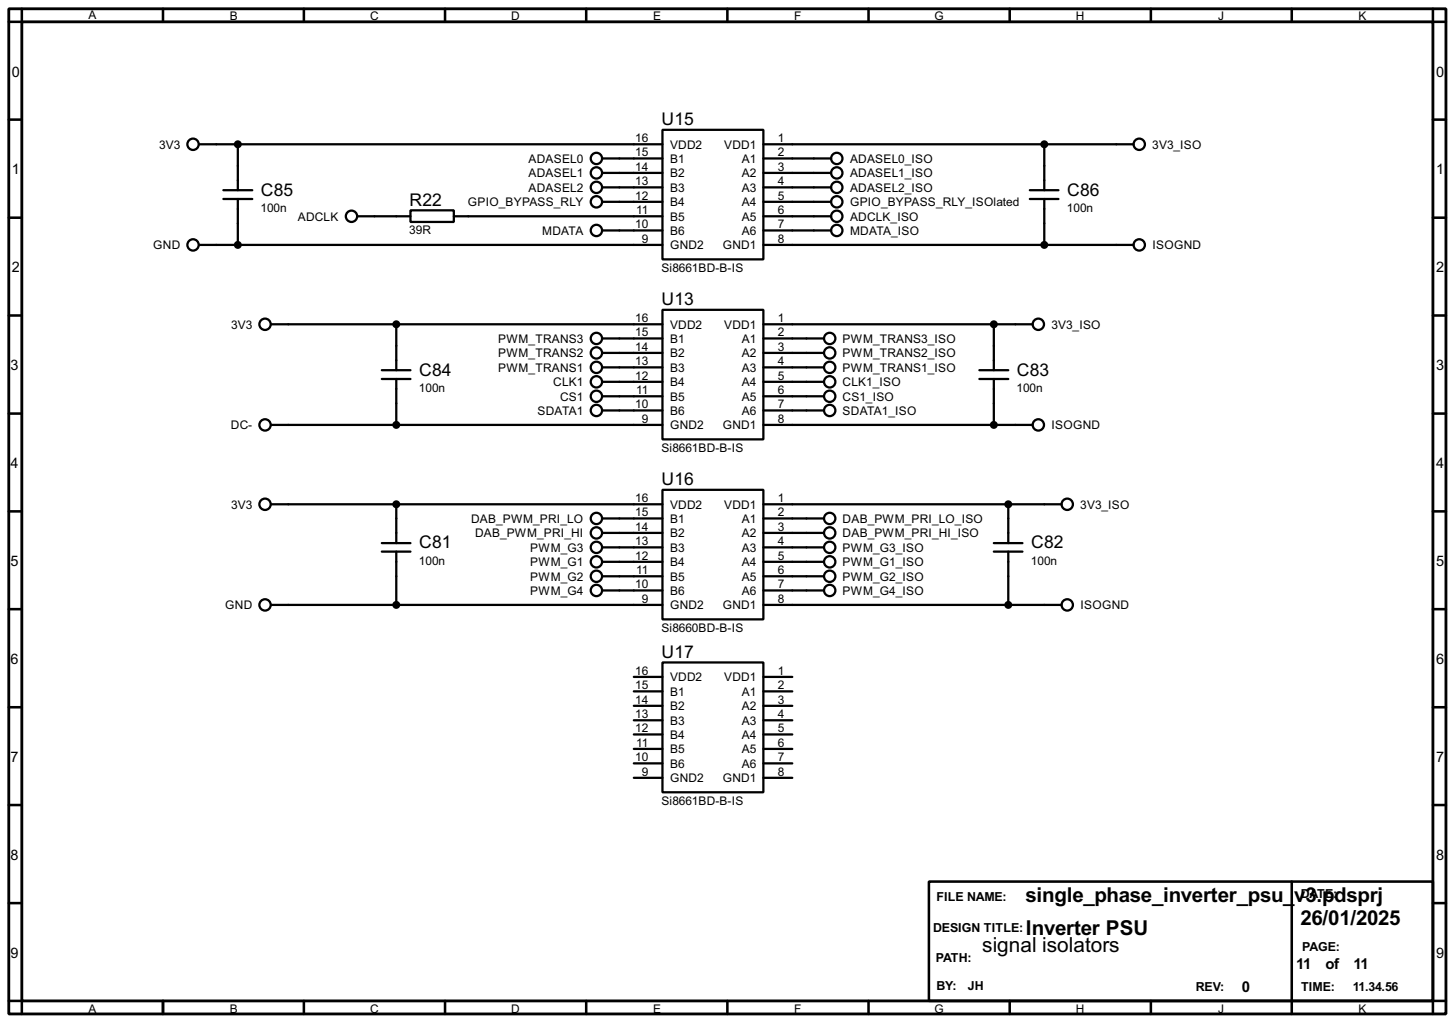
[picture p93: page 11]
