johonkanen/ac_psu_kicad/kicad/ac_psu.kicad_pcb

## KiCad design kicad/ac_psu.kicad_pcb (2026-11-09)

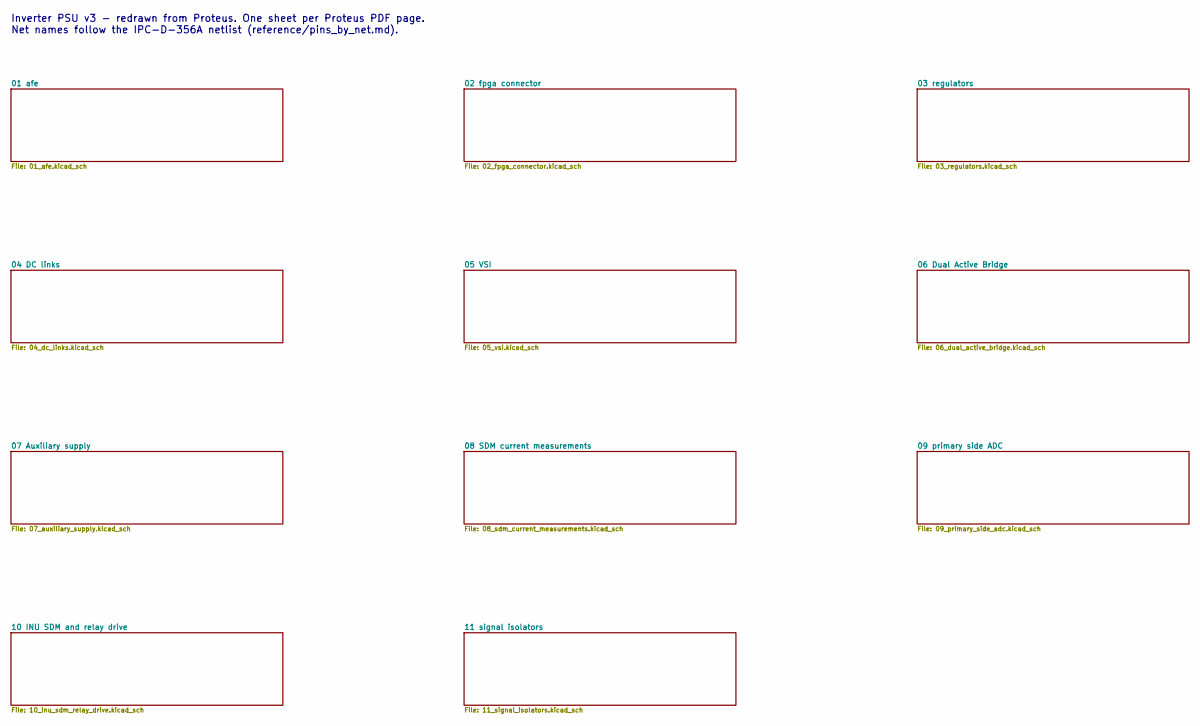
[picture p94: schematic ac_psu.kicad_sch, Inverter PSU]

Notes on the sheet:
Inverter PSU v3 - redrawn from Proteus. One sheet per Proteus PDF page. Net names follow the IPC-D-356A netlist (reference/pins_by_net.md).

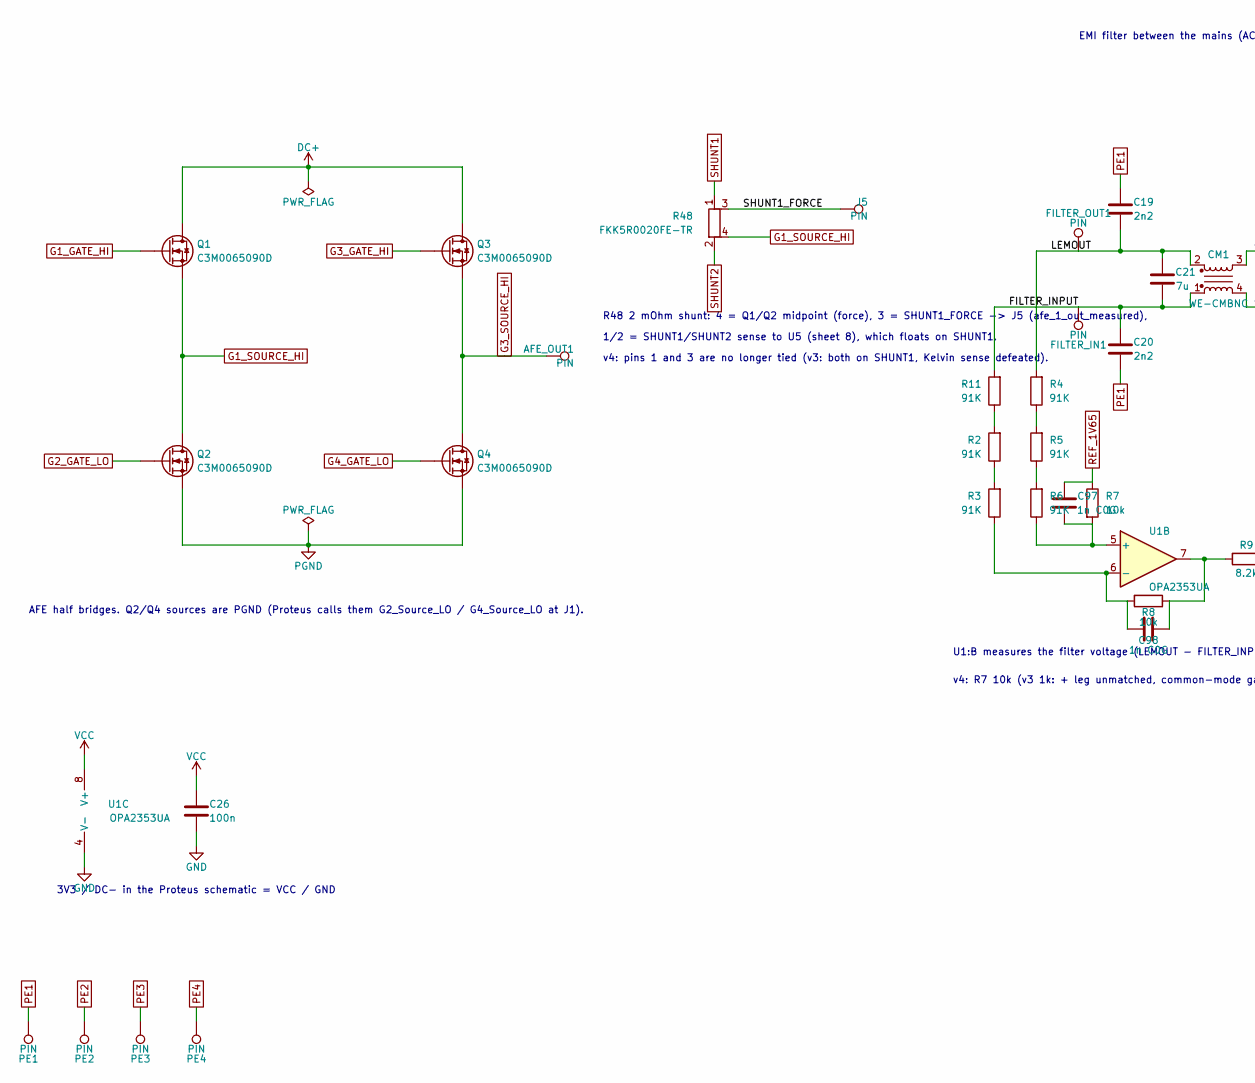
[picture p95: schematic 01_afe.kicad_sch, Inverter PSU - afe, part in row 1, column 1]

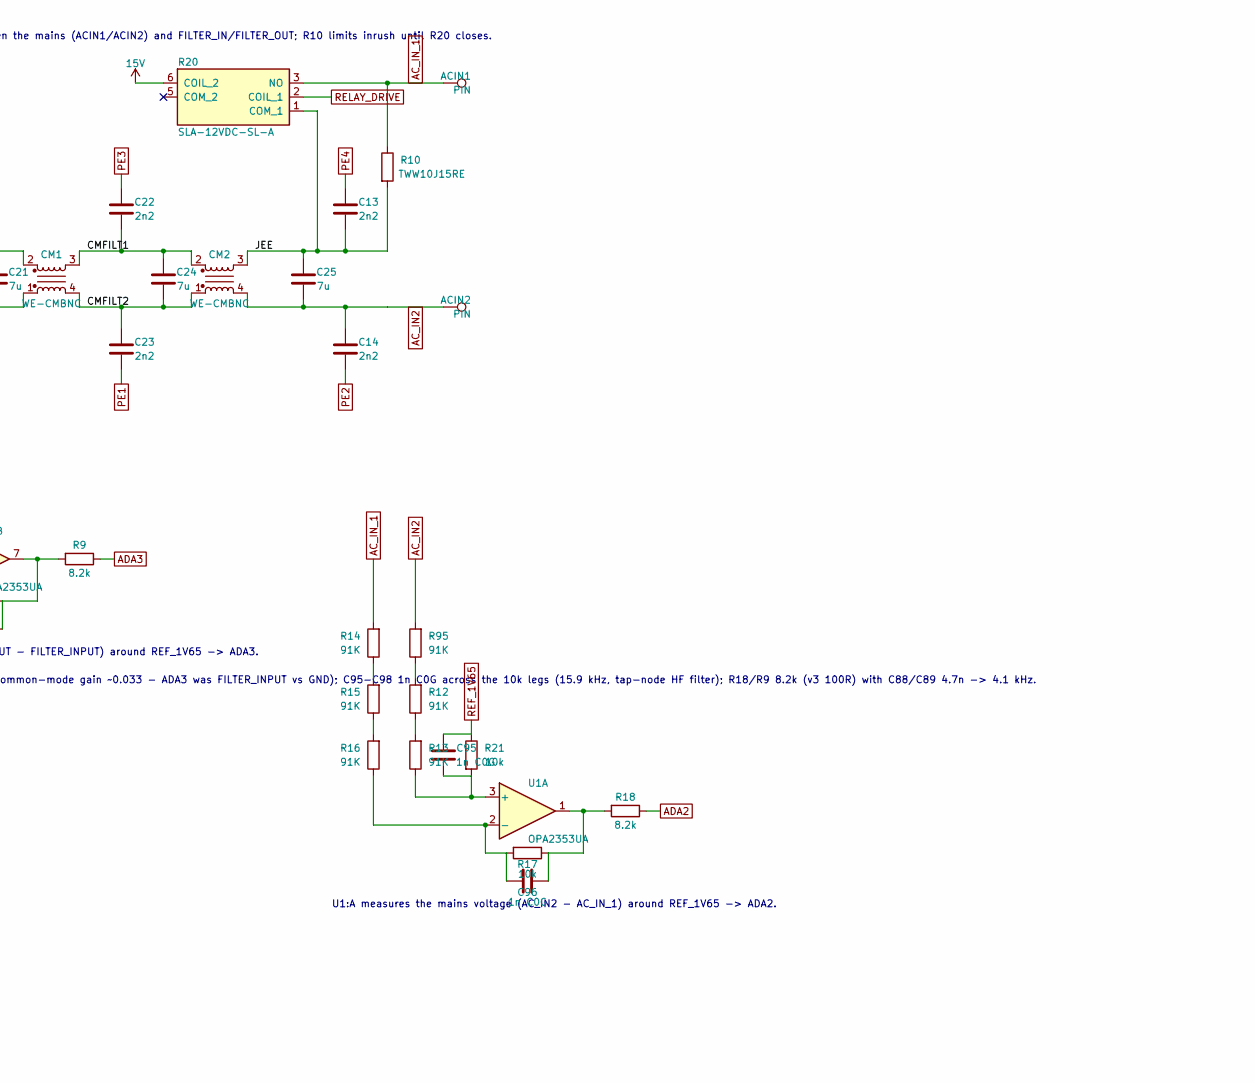
[picture p96: schematic 01_afe.kicad_sch, Inverter PSU - afe, part in row 1, column 2]

Parts:
ACIN1, ACIN2: PIN; Terminal_2x1_P5.00mm_D2.0mm_Drill1.4mm
AFE_OUT1: PIN; Terminal_D4.0mm_Drill2.55mm
C13, C14, C19, C20, C22, C23: 2n2; C_Disc_D12.5mm_W5.0mm_P7.50mm
C21, C25: 7u; C_Rect_L33.0mm_W20.0mm_P27.50mm_MKS4_Proteus
C24: 7u; C_Rect_L33.0mm_W20.0mm_P27.50mm_MKS4
C26: 100n; C_0402_1005Metric
C95, C96, C97, C98: 1n C0G; C_0402_1005Metric
CM1, CM2: WE-CMBNC; L_CommonMode_WE-CMBNC
FILTER_IN1: PIN; Wuerth_REDCUBE-THR_74650074_M4_PTH
FILTER_OUT1: PIN; Wuerth_REDCUBE-THR_74650074_M4_PTH
J5: PIN; Wuerth_REDCUBE-THR_74650074_M4_PTH
PE1: PIN; Terminal_D4.0mm_Drill3.0mm
PE2, PE4: PIN; Terminal_D4.0mm_Drill2.0mm
PE3: PIN; Terminal_D4.0mm_Drill2.55mm
Q1, Q2, Q3, Q4: C3M0065090D; TO-247-3_Vertical_Proteus
R2, R3, R4, R5, R6, R11, R12, R13, R14, R15, R16, R95: 91K; R_1206_3216Metric_Pad1.30x1.75mm_HandSolder
R7, R8, R17, R21: 10k; R_0402_1005Metric
R9, R18: 8.2k; R_0402_1005Metric
R10: TWW10J15RE; R_Radial_Power_L13.0mm_W9.0mm_P5.00mm
R20: SLA-12VDC-SL-A; Relay_SLA-12VDC-SL-A
R48: FKK5R0020FE-TR; R_Shunt_FKK5R0020FE
U1: OPA2353UA; TSSOP-8_3x3mm_P0.65mm_Proteus

Connections:
15V: R20.6 (COIL_2); also elsewhere on the board
/01 afe/CMFILT1: C22.2, C24.1, CM1.3, CM2.2
/01 afe/CMFILT2: C23.2, C24.2, CM1.4, CM2.1
/01 afe/FILTER_INPUT: C20.2, C21.2, CM1.1, FILTER_IN1.1, R11.2
/01 afe/JEE: C13.2, C25.1, CM2.3, R10.2, R20.1 (COM_1)
/01 afe/LEMOUT: C19.2, C21.1, CM1.2, FILTER_OUT1.1, R4.2
/01 afe/SHUNT1_FORCE: J5.1, R48.3
AC_IN2: ACIN2.1, C14.2, C25.2, CM2.4, R95.2
AC_IN_1: ACIN1.1, R10.1, R14.2, R20.3 (NO)
ADA2: R18.1; also elsewhere on the board
ADA3: R9.1; also elsewhere on the board
DC+: Q1.2 (D), Q3.2 (D); also elsewhere on the board
G1_GATE_HI: Q1.1 (G); also elsewhere on the board
G1_SOURCE_HI: Q1.3 (S), Q2.2 (D), R48.4; also elsewhere on the board
G2_GATE_LO: Q2.1 (G); also elsewhere on the board
G3_GATE_HI: Q3.1 (G); also elsewhere on the board
G3_SOURCE_HI: AFE_OUT1.1, Q3.3 (S), Q4.2 (D); also elsewhere on the board
G4_GATE_LO: Q4.1 (G); also elsewhere on the board
GND: C26.1, U1.4 (V-); also elsewhere on the board
unnamed: C96.1, R17.1, R18.2, U1.1
unnamed: C98.1, R8.1, R9.2, U1.7
unnamed: R2.1, R3.2
unnamed: R4.1, R5.2
unnamed: R5.1, R6.2
unnamed: R2.2, R11.1
unnamed: R12.1, R13.2
unnamed: R12.2, R95.1
unnamed: R14.1, R15.2
unnamed: R15.1, R16.2
unnamed: C95.2, R13.1, R21.2, U1.3 (+)
unnamed: C96.2, R16.1, R17.2, U1.2 (-)
unnamed: C97.2, R6.1, R7.2, U1.5 (+)
unnamed: C98.2, R3.1, R8.2, U1.6 (-)
PE1: C19.1, C20.1, C23.1, PE1.1
PE2: C14.1, PE2.1
PE3: C22.1, PE3.1
PE4: C13.1, PE4.1
PGND: Q2.3 (S), Q4.3 (S); also elsewhere on the board
REF_1V65: C95.1, C97.1, R7.1, R21.1; also elsewhere on the board
RELAY_DRIVE: R20.2 (COIL_1); also elsewhere on the board
SHUNT1: R48.1; also elsewhere on the board
SHUNT2: R48.2; also elsewhere on the board
VCC: C26.2, U1.8 (V+); also elsewhere on the board

Notes on the sheet:
AFE half bridges. Q2/Q4 sources are PGND (Proteus calls them G2_Source_LO / G4_Source_LO at J1).
R48 2 mOhm shunt: 4 = Q1/Q2 midpoint (force), 3 = SHUNT1_FORCE -> J5 (afe_1_out_measured),
1/2 = SHUNT1/SHUNT2 sense to U5 (sheet 8), which floats on SHUNT1.
v4: pins 1 and 3 are no longer tied (v3: both on SHUNT1, Kelvin sense defeated).
EMI filter between the mains (ACIN1/ACIN2) and FILTER_IN/FILTER_OUT; R10 limits inrush until R20 closes.
U1:B measures the filter voltage (LEMOUT - FILTER_INPUT) around REF_1V65 -> ADA3.
v4: R7 10k (v3 1k: + leg unmatched, common-mode gain ~0.033 - ADA3 was FILTER_INPUT vs GND); C95-C98 1n C0G across the 10k legs (15.9 kHz, tap-node HF filter); R18/R9 8.2k (v3 100R) with C88/C89 4.7n -> 4.1 kHz.
U1:A measures the mains voltage (AC_IN2 - AC_IN_1) around REF_1V65 -> ADA2.
3V3 / DC- in the Proteus schematic = VCC / GND

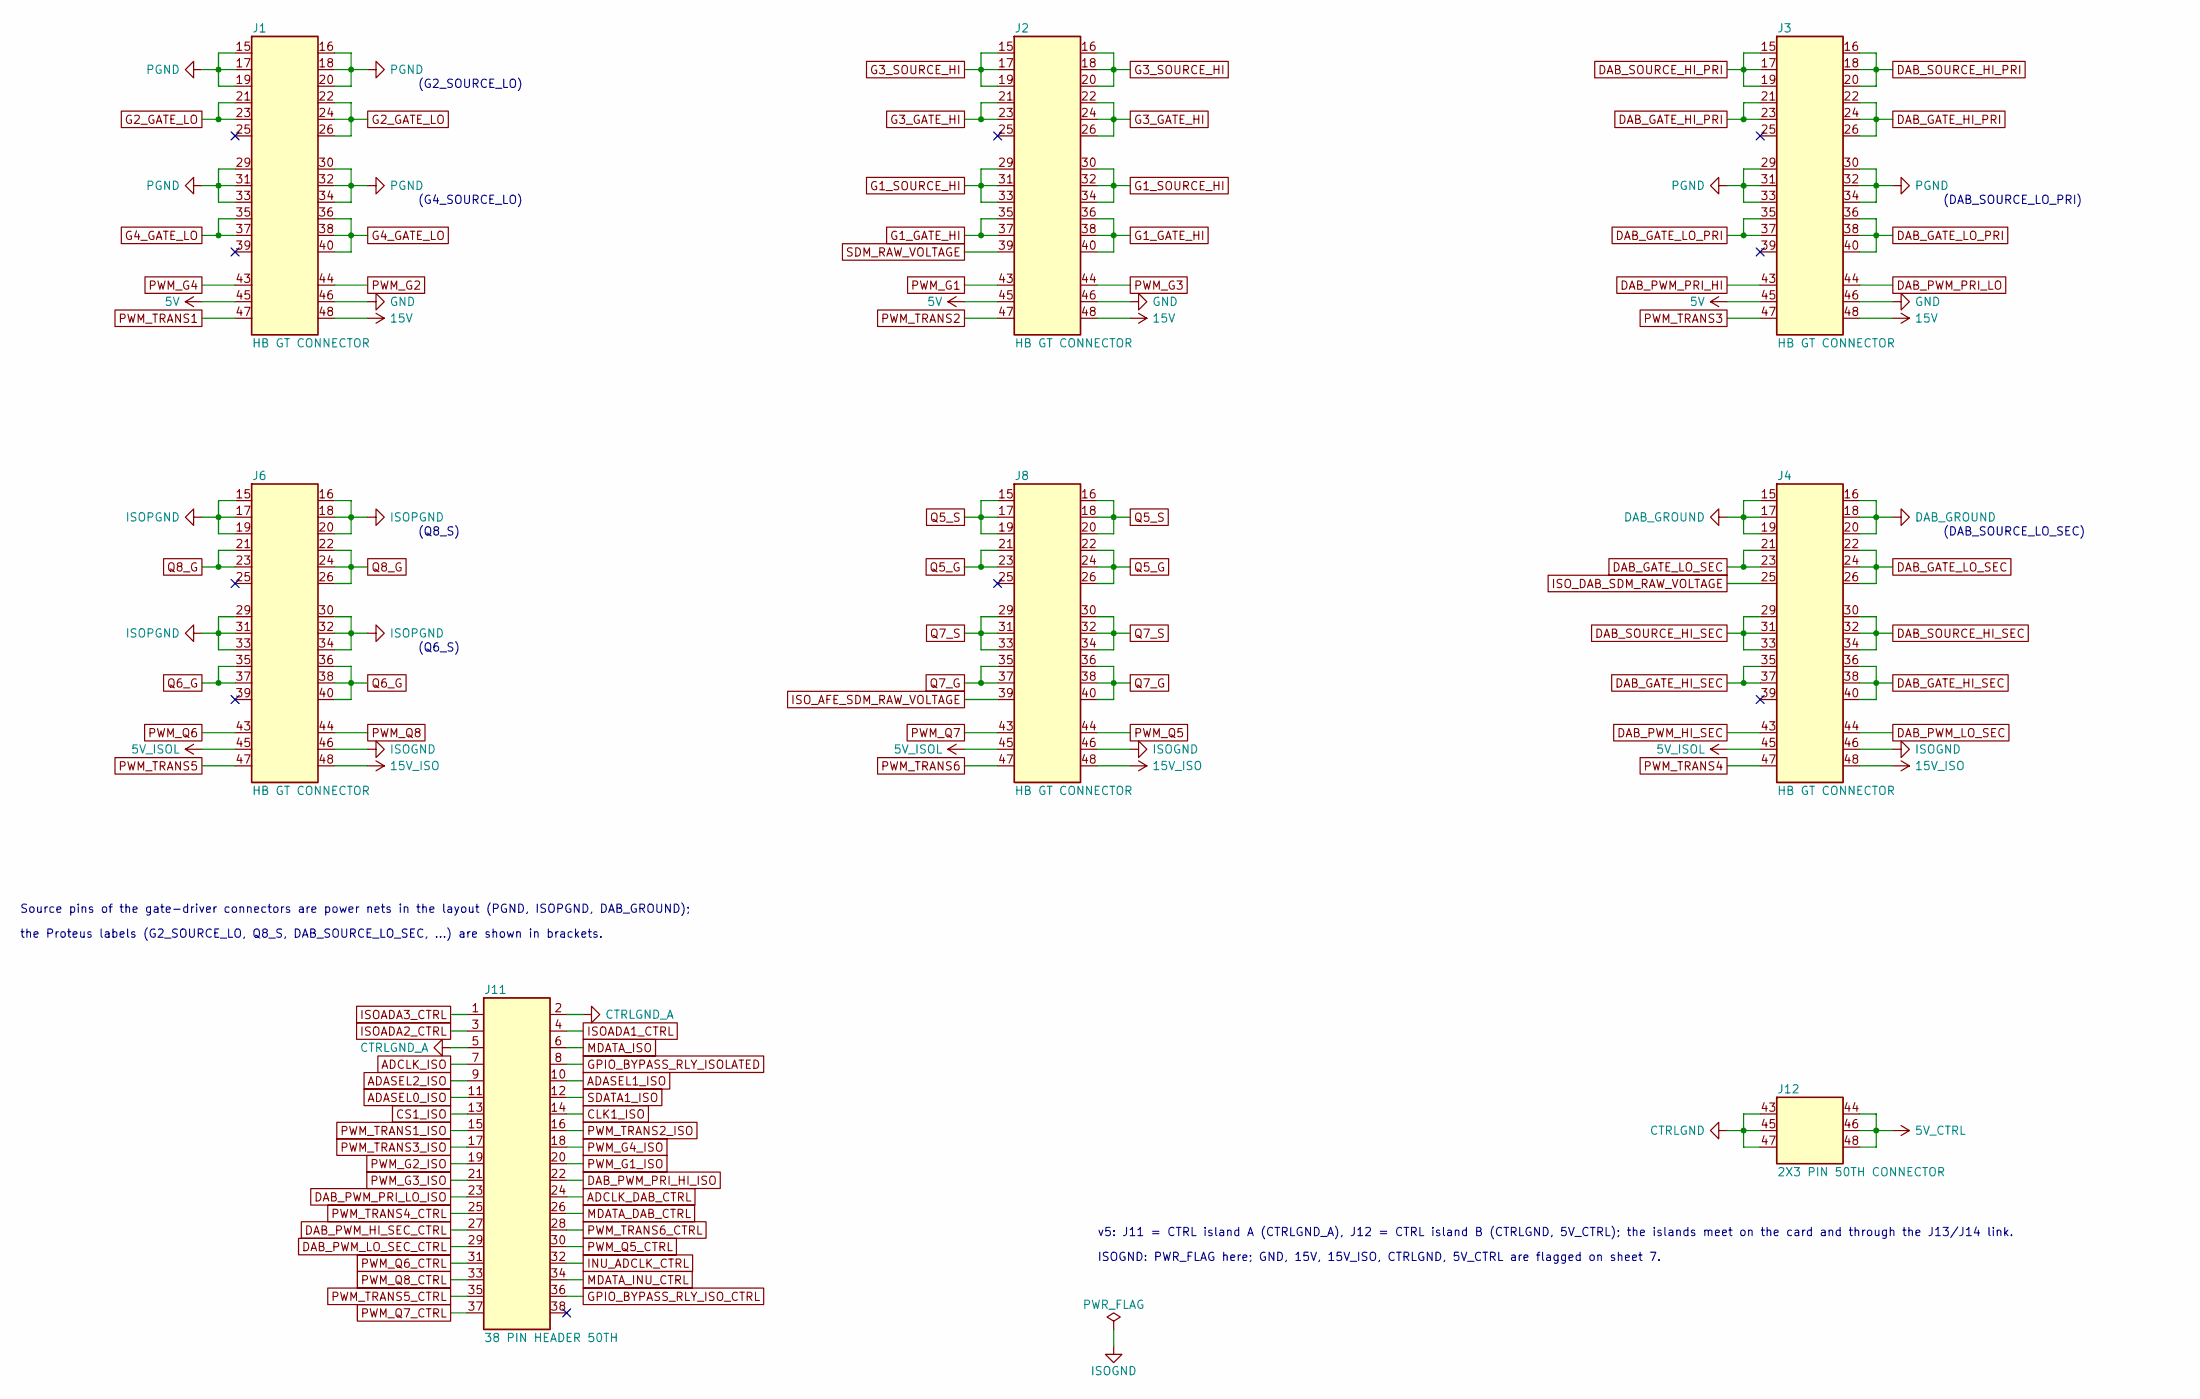
[picture p97: schematic 02_fpga_connector.kicad_sch, Inverter PSU - fpga connector]

Parts:
J1, J2, J3, J4, J6, J8: HB GT CONNECTOR; PinHeader_2x24_P1.27mm_Vertical_Pins15-48
J11: 38 PIN HEADER 50TH; PinHeader_2x19_P1.27mm_Vertical_Proteus
J12: 2X3 PIN 50TH CONNECTOR; PinHeader_2x03_P1.27mm_Vertical_Pins43-48

Connections:
5V: J1.45, J2.45, J3.45; also elsewhere on the board
5V_CTRL: J12.44, J12.46, J12.48; also elsewhere on the board
5V_ISOL: J4.45, J6.45, J8.45; also elsewhere on the board
15V: J1.48, J2.48, J3.48; also elsewhere on the board
15V_ISO: J4.48, J6.48, J8.48; also elsewhere on the board
ADASEL0_ISO: J11.11; also elsewhere on the board
ADASEL1_ISO: J11.10; also elsewhere on the board
ADASEL2_ISO: J11.9; also elsewhere on the board
ADCLK_DAB_CTRL: J11.24; also elsewhere on the board
ADCLK_ISO: J11.7; also elsewhere on the board
CLK1_ISO: J11.14; also elsewhere on the board
CS1_ISO: J11.13; also elsewhere on the board
CTRLGND: J12.43, J12.45, J12.47; also elsewhere on the board
CTRLGND_A: J11.2, J11.5; also elsewhere on the board
DAB_GATE_HI_PRI: J3.21, J3.22, J3.23, J3.24, J3.26; also elsewhere on the board
DAB_GATE_HI_SEC: J4.35, J4.36, J4.37, J4.38, J4.40; also elsewhere on the board
DAB_GATE_LO_PRI: J3.35, J3.36, J3.37, J3.38, J3.40; also elsewhere on the board
DAB_GATE_LO_SEC: J4.21, J4.22, J4.23, J4.24, J4.26; also elsewhere on the board
DAB_GROUND: J4.15, J4.16, J4.17, J4.18, J4.19, J4.20; also elsewhere on the board
DAB_PWM_HI_SEC: J4.43; also elsewhere on the board
DAB_PWM_HI_SEC_CTRL: J11.27; also elsewhere on the board
DAB_PWM_LO_SEC: J4.44; also elsewhere on the board
DAB_PWM_LO_SEC_CTRL: J11.29; also elsewhere on the board
DAB_PWM_PRI_HI: J3.43; also elsewhere on the board
DAB_PWM_PRI_HI_ISO: J11.22; also elsewhere on the board
DAB_PWM_PRI_LO: J3.44; also elsewhere on the board
DAB_PWM_PRI_LO_ISO: J11.23; also elsewhere on the board
DAB_SOURCE_HI_PRI: J3.15, J3.16, J3.17, J3.18, J3.19, J3.20; also elsewhere on the board
DAB_SOURCE_HI_SEC: J4.29, J4.30, J4.31, J4.32, J4.33, J4.34; also elsewhere on the board
G1_GATE_HI: J2.35, J2.36, J2.37, J2.38, J2.40; also elsewhere on the board
G1_SOURCE_HI: J2.29, J2.30, J2.31, J2.32, J2.33, J2.34; also elsewhere on the board
G2_GATE_LO: J1.21, J1.22, J1.23, J1.24, J1.26; also elsewhere on the board
G3_GATE_HI: J2.21, J2.22, J2.23, J2.24, J2.26; also elsewhere on the board
G3_SOURCE_HI: J2.15, J2.16, J2.17, J2.18, J2.19, J2.20; also elsewhere on the board
G4_GATE_LO: J1.35, J1.36, J1.37, J1.38, J1.40; also elsewhere on the board
GND: J1.46, J2.46, J3.46; also elsewhere on the board
GPIO_BYPASS_RLY_ISOLATED: J11.8; also elsewhere on the board
GPIO_BYPASS_RLY_ISO_CTRL: J11.36; also elsewhere on the board
INU_ADCLK_CTRL: J11.32; also elsewhere on the board
ISOADA1_CTRL: J11.4; also elsewhere on the board
ISOADA2_CTRL: J11.3; also elsewhere on the board
ISOADA3_CTRL: J11.1; also elsewhere on the board
ISOGND: J4.46, J6.46, J8.46; also elsewhere on the board
ISOPGND: J6.15, J6.16, J6.17, J6.18, J6.19, J6.20, J6.29, J6.30, J6.31, J6.32, J6.33, J6.34; also elsewhere on the board
ISO_AFE_SDM_RAW_VOLTAGE: J8.39; also elsewhere on the board
ISO_DAB_SDM_RAW_VOLTAGE: J4.25; also elsewhere on the board
MDATA_DAB_CTRL: J11.26; also elsewhere on the board
MDATA_INU_CTRL: J11.34; also elsewhere on the board
MDATA_ISO: J11.6; also elsewhere on the board
PGND: J1.15, J1.16, J1.17, J1.18, J1.19, J1.20, J1.29, J1.30, J1.31, J1.32, J1.33, J1.34, J3.29, J3.30, J3.31, J3.32, J3.33, J3.34; also elsewhere on the board
PWM_G1: J2.43; also elsewhere on the board
PWM_G1_ISO: J11.20; also elsewhere on the board
PWM_G2: J1.44; also elsewhere on the board
PWM_G2_ISO: J11.19; also elsewhere on the board
PWM_G3: J2.44; also elsewhere on the board
PWM_G3_ISO: J11.21; also elsewhere on the board
PWM_G4: J1.43; also elsewhere on the board
PWM_G4_ISO: J11.18; also elsewhere on the board
PWM_Q5: J8.44; also elsewhere on the board
PWM_Q5_CTRL: J11.30; also elsewhere on the board
PWM_Q6: J6.43; also elsewhere on the board
PWM_Q6_CTRL: J11.31; also elsewhere on the board
PWM_Q7: J8.43; also elsewhere on the board
PWM_Q7_CTRL: J11.37; also elsewhere on the board
PWM_Q8: J6.44; also elsewhere on the board
PWM_Q8_CTRL: J11.33; also elsewhere on the board
PWM_TRANS1: J1.47; also elsewhere on the board
PWM_TRANS1_ISO: J11.15; also elsewhere on the board
PWM_TRANS2: J2.47; also elsewhere on the board
PWM_TRANS2_ISO: J11.16; also elsewhere on the board
PWM_TRANS3: J3.47; also elsewhere on the board
PWM_TRANS3_ISO: J11.17; also elsewhere on the board
PWM_TRANS4: J4.47; also elsewhere on the board
PWM_TRANS4_CTRL: J11.25; also elsewhere on the board
PWM_TRANS5: J6.47; also elsewhere on the board
PWM_TRANS5_CTRL: J11.35; also elsewhere on the board
PWM_TRANS6: J8.47; also elsewhere on the board
PWM_TRANS6_CTRL: J11.28; also elsewhere on the board
Q5_G: J8.21, J8.22, J8.23, J8.24, J8.26; also elsewhere on the board
Q5_S: J8.15, J8.16, J8.17, J8.18, J8.19, J8.20; also elsewhere on the board
Q6_G: J6.35, J6.36, J6.37, J6.38, J6.40; also elsewhere on the board
Q7_G: J8.35, J8.36, J8.37, J8.38, J8.40; also elsewhere on the board
Q7_S: J8.29, J8.30, J8.31, J8.32, J8.33, J8.34; also elsewhere on the board
Q8_G: J6.21, J6.22, J6.23, J6.24, J6.26; also elsewhere on the board
SDATA1_ISO: J11.12; also elsewhere on the board
SDM_RAW_VOLTAGE: J2.39; also elsewhere on the board

Notes on the sheet:
(G2_SOURCE_LO)
(G4_SOURCE_LO)
(DAB_SOURCE_LO_PRI)
(Q8_S)
(Q6_S)
(DAB_SOURCE_LO_SEC)
Source pins of the gate-driver connectors are power nets in the layout (PGND, ISOPGND, DAB_GROUND);
the Proteus labels (G2_SOURCE_LO, Q8_S, DAB_SOURCE_LO_SEC, ...) are shown in brackets.
v5: J11 = CTRL island A (CTRLGND_A), J12 = CTRL island B (CTRLGND, 5V_CTRL); the islands meet on the card and through the J13/J14 link.
ISOGND: PWR_FLAG here; GND, 15V, 15V_ISO, CTRLGND, 5V_CTRL are flagged on sheet 7.

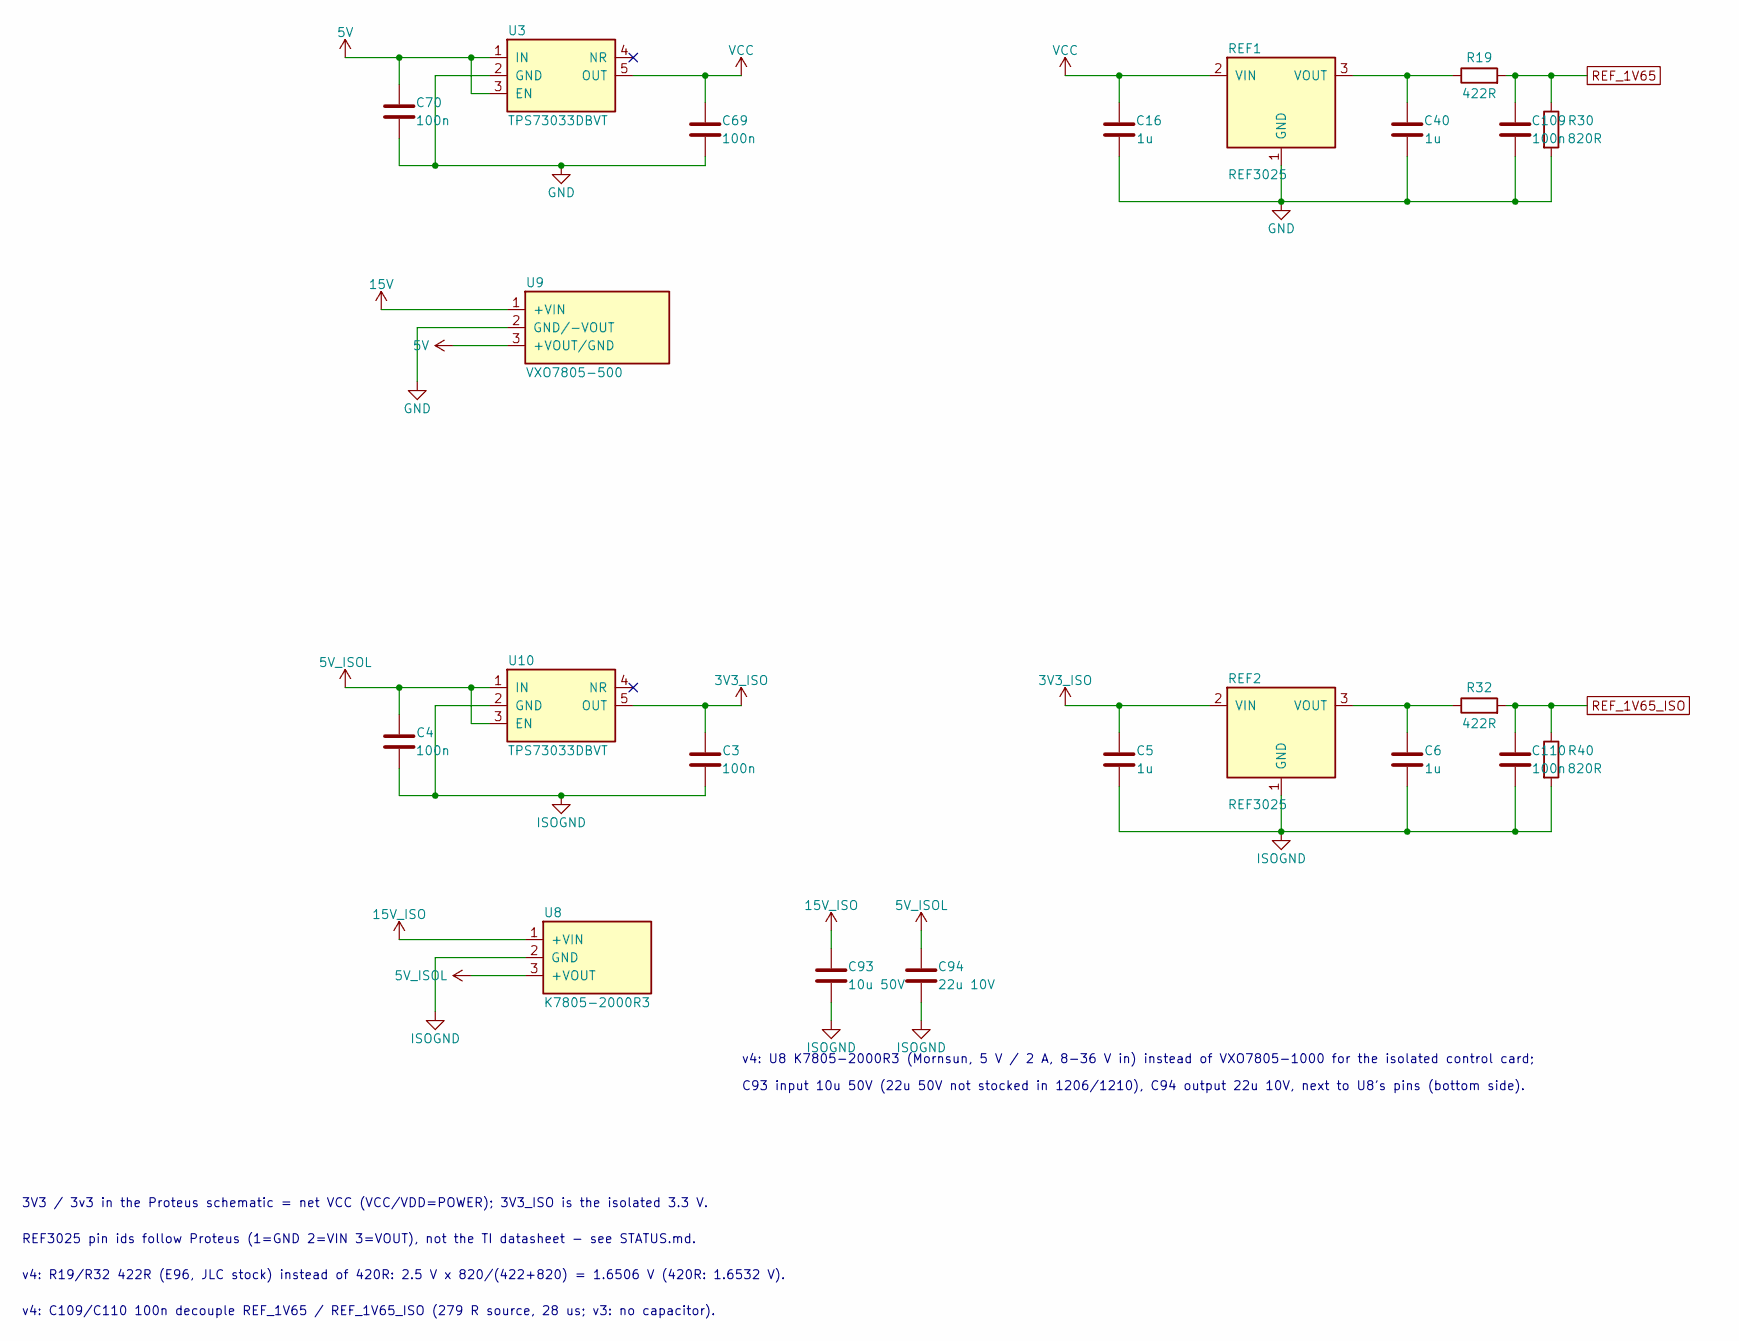
[picture p98: schematic 03_regulators.kicad_sch, Inverter PSU - regulators]

Parts:
C3, C4, C69, C70, C109, C110: 100n; C_0402_1005Metric
C5, C6, C16, C40: 1u; C_0402_1005Metric
C93: 10u 50V; C_1210_3225Metric
C94: 22u 10V; C_0805_2012Metric
R19, R32: 422R; R_0402_1005Metric
R30, R40: 820R; R_0402_1005Metric
REF1, REF2: REF3025; SOT-23_Proteus
U3, U10: TPS73033DBVT; SOT-23-5_TPS73033
U8: K7805-2000R3; Converter_DCDC_RECOM_R-78E-0.5_THT_Proteus
U9: VXO7805-500; Converter_DCDC_RECOM_R-78E-0.5_THT_Proteus

Connections:
3V3_ISO: C3.2, C5.2, REF2.2 (VIN), U10.5 (OUT); also elsewhere on the board
5V: C70.2, U3.1 (IN), U3.3 (EN), U9.3 (+VOUT/GND); also elsewhere on the board
5V_ISOL: C4.2, C94.1, U8.3 (+VOUT), U10.1 (IN), U10.3 (EN); also elsewhere on the board
15V: U9.1 (+VIN); also elsewhere on the board
15V_ISO: C93.1, U8.1 (+VIN); also elsewhere on the board
GND: C16.1, C40.1, C69.1, C70.1, C109.2, R30.2, REF1.1 (GND), U3.2 (GND), U9.2 (GND/-VOUT); also elsewhere on the board
ISOGND: C3.1, C4.1, C5.1, C6.1, C93.2, C94.2, C110.2, R40.2, REF2.1 (GND), U8.2 (GND), U10.2 (GND); also elsewhere on the board
unnamed: C40.2, R19.1, REF1.3 (VOUT)
unnamed: C6.2, R32.1, REF2.3 (VOUT)
REF_1V65: C109.1, R19.2, R30.1; also elsewhere on the board
REF_1V65_ISO: C110.1, R32.2, R40.1; also elsewhere on the board
VCC: C16.2, C69.2, REF1.2 (VIN), U3.5 (OUT); also elsewhere on the board

Notes on the sheet:
v4: U8 K7805-2000R3 (Mornsun, 5 V / 2 A, 8-36 V in) instead of VXO7805-1000 for the isolated control card;
C93 input 10u 50V (22u 50V not stocked in 1206/1210), C94 output 22u 10V, next to U8's pins (bottom side).
3V3 / 3v3 in the Proteus schematic = net VCC (VCC/VDD=POWER); 3V3_ISO is the isolated 3.3 V.
REF3025 pin ids follow Proteus (1=GND 2=VIN 3=VOUT), not the TI datasheet - see STATUS.md.
v4: R19/R32 422R (E96, JLC stock) instead of 420R: 2.5 V x 820/(422+820) = 1.6506 V (420R: 1.6532 V).
v4: C109/C110 100n decouple REF_1V65 / REF_1V65_ISO (279 R source, 28 us; v3: no capacitor).

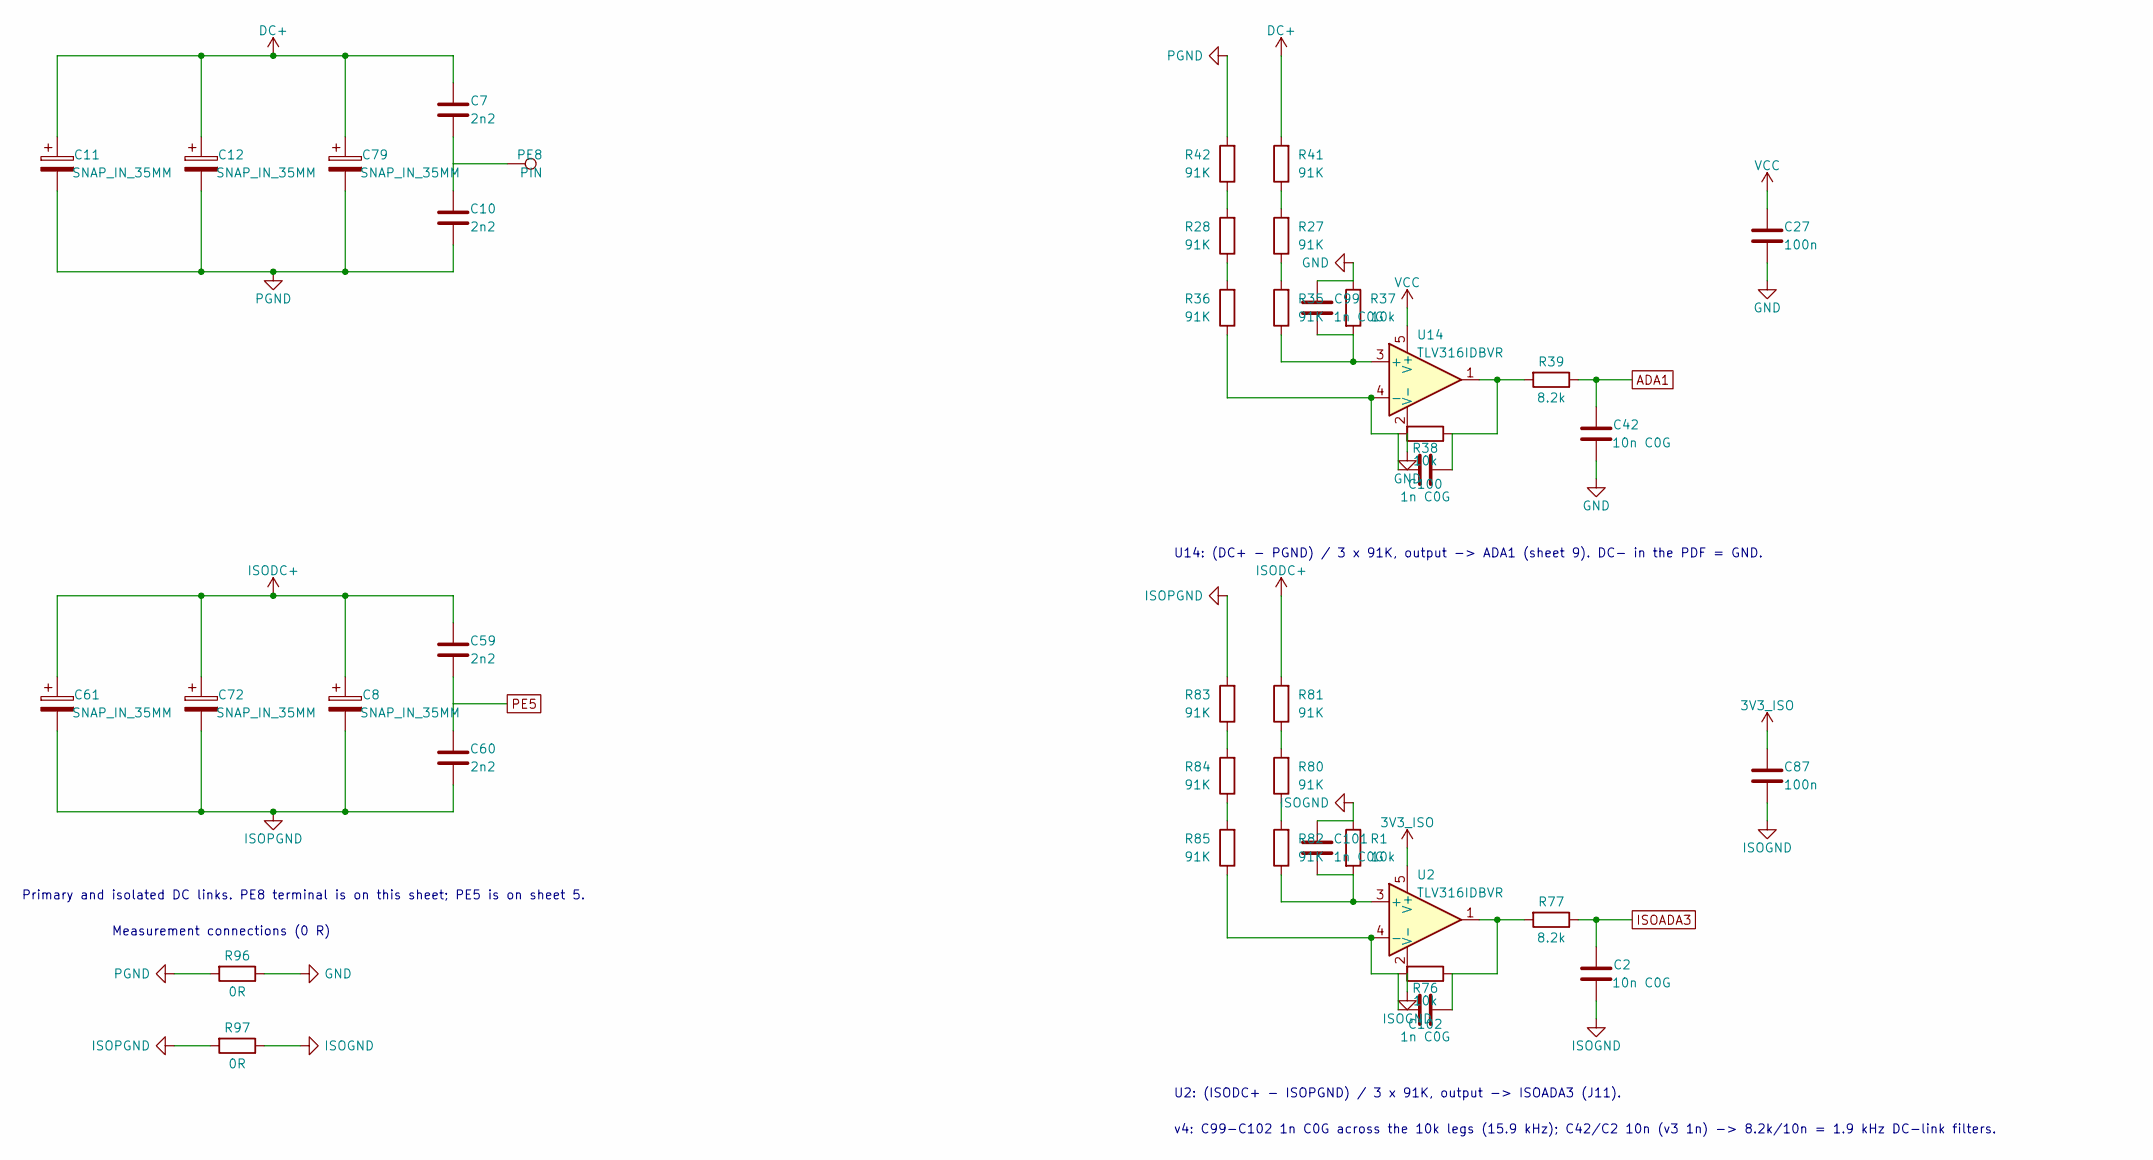
[picture p99: schematic 04_dc_links.kicad_sch, Inverter PSU - DC links]

Parts:
C2, C42: 10n C0G; C_0402_1005Metric
C7, C10, C59, C60: 2n2; C_Disc_D12.5mm_W5.0mm_P7.50mm
C8, C11, C12, C61, C72, C79: SNAP_IN_35MM; CP_Radial_D35.0mm_P10.00mm_SnapIn_Proteus
C27, C87: 100n; C_0402_1005Metric
C99, C100, C101, C102: 1n C0G; C_0402_1005Metric
PE8: PIN; Terminal_D3.05mm_Drill1.52mm
R1, R37, R38, R76: 10k; R_0402_1005Metric
R27, R28, R35, R36, R41, R42, R80, R81, R82, R83, R84, R85: 91K; R_1206_3216Metric_Pad1.30x1.75mm_HandSolder
R39, R77: 8.2k; R_0402_1005Metric
R96, R97: 0R; R_1206_3216Metric_Pad1.30x1.75mm_HandSolder
U2, U14: TLV316IDBVR; SOT-23-5_TLV316

Connections:
3V3_ISO: C87.2, U2.5 (V+); also elsewhere on the board
ADA1: C42.1, R39.1; also elsewhere on the board
DC+: C7.2, C11.1, C12.1, C79.1, R41.2; also elsewhere on the board
GND: C27.1, C42.2, C99.1, R37.1, R96.1, U14.2 (V-); also elsewhere on the board
ISOADA3: C2.1, R77.1; also elsewhere on the board
ISODC+: C8.1, C59.2, C61.1, C72.1, R81.2; also elsewhere on the board
ISOGND: C2.2, C87.1, C101.1, R1.1, R97.1, U2.2 (V-); also elsewhere on the board
ISOPGND: C8.2, C60.1, C61.2, C72.2, R83.2, R97.2; also elsewhere on the board
unnamed: C7.1, C10.2, PE8.1
unnamed: C100.1, R38.1, R39.2, U14.1
unnamed: C102.1, R76.1, R77.2, U2.1
unnamed: R27.1, R35.2
unnamed: R27.2, R41.1
unnamed: R28.1, R36.2
unnamed: R28.2, R42.1
unnamed: R80.1, R82.2
unnamed: R80.2, R81.1
unnamed: R83.1, R84.2
unnamed: R84.1, R85.2
unnamed: C101.2, R1.2, R82.1, U2.3 (+)
unnamed: C102.2, R76.2, R85.1, U2.4 (-)
unnamed: C99.2, R35.1, R37.2, U14.3 (+)
unnamed: C100.2, R36.1, R38.2, U14.4 (-)
PE5: C59.1, C60.2; also elsewhere on the board
PGND: C10.1, C11.2, C12.2, C79.2, R42.2, R96.2; also elsewhere on the board
VCC: C27.2, U14.5 (V+); also elsewhere on the board

Notes on the sheet:
Primary and isolated DC links. PE8 terminal is on this sheet; PE5 is on sheet 5.
Measurement connections (0 R)
U14: (DC+ - PGND) / 3 x 91K, output -> ADA1 (sheet 9). DC- in the PDF = GND.
U2: (ISODC+ - ISOPGND) / 3 x 91K, output -> ISOADA3 (J11).
v4: C99-C102 1n C0G across the 10k legs (15.9 kHz); C42/C2 10n (v3 1n) -> 8.2k/10n = 1.9 kHz DC-link filters.
