johonkanen/ac_psu_kicad/kicad/ac_psu.kicad_pcb

## KiCad design kicad/ac_psu.kicad_pcb (continued)

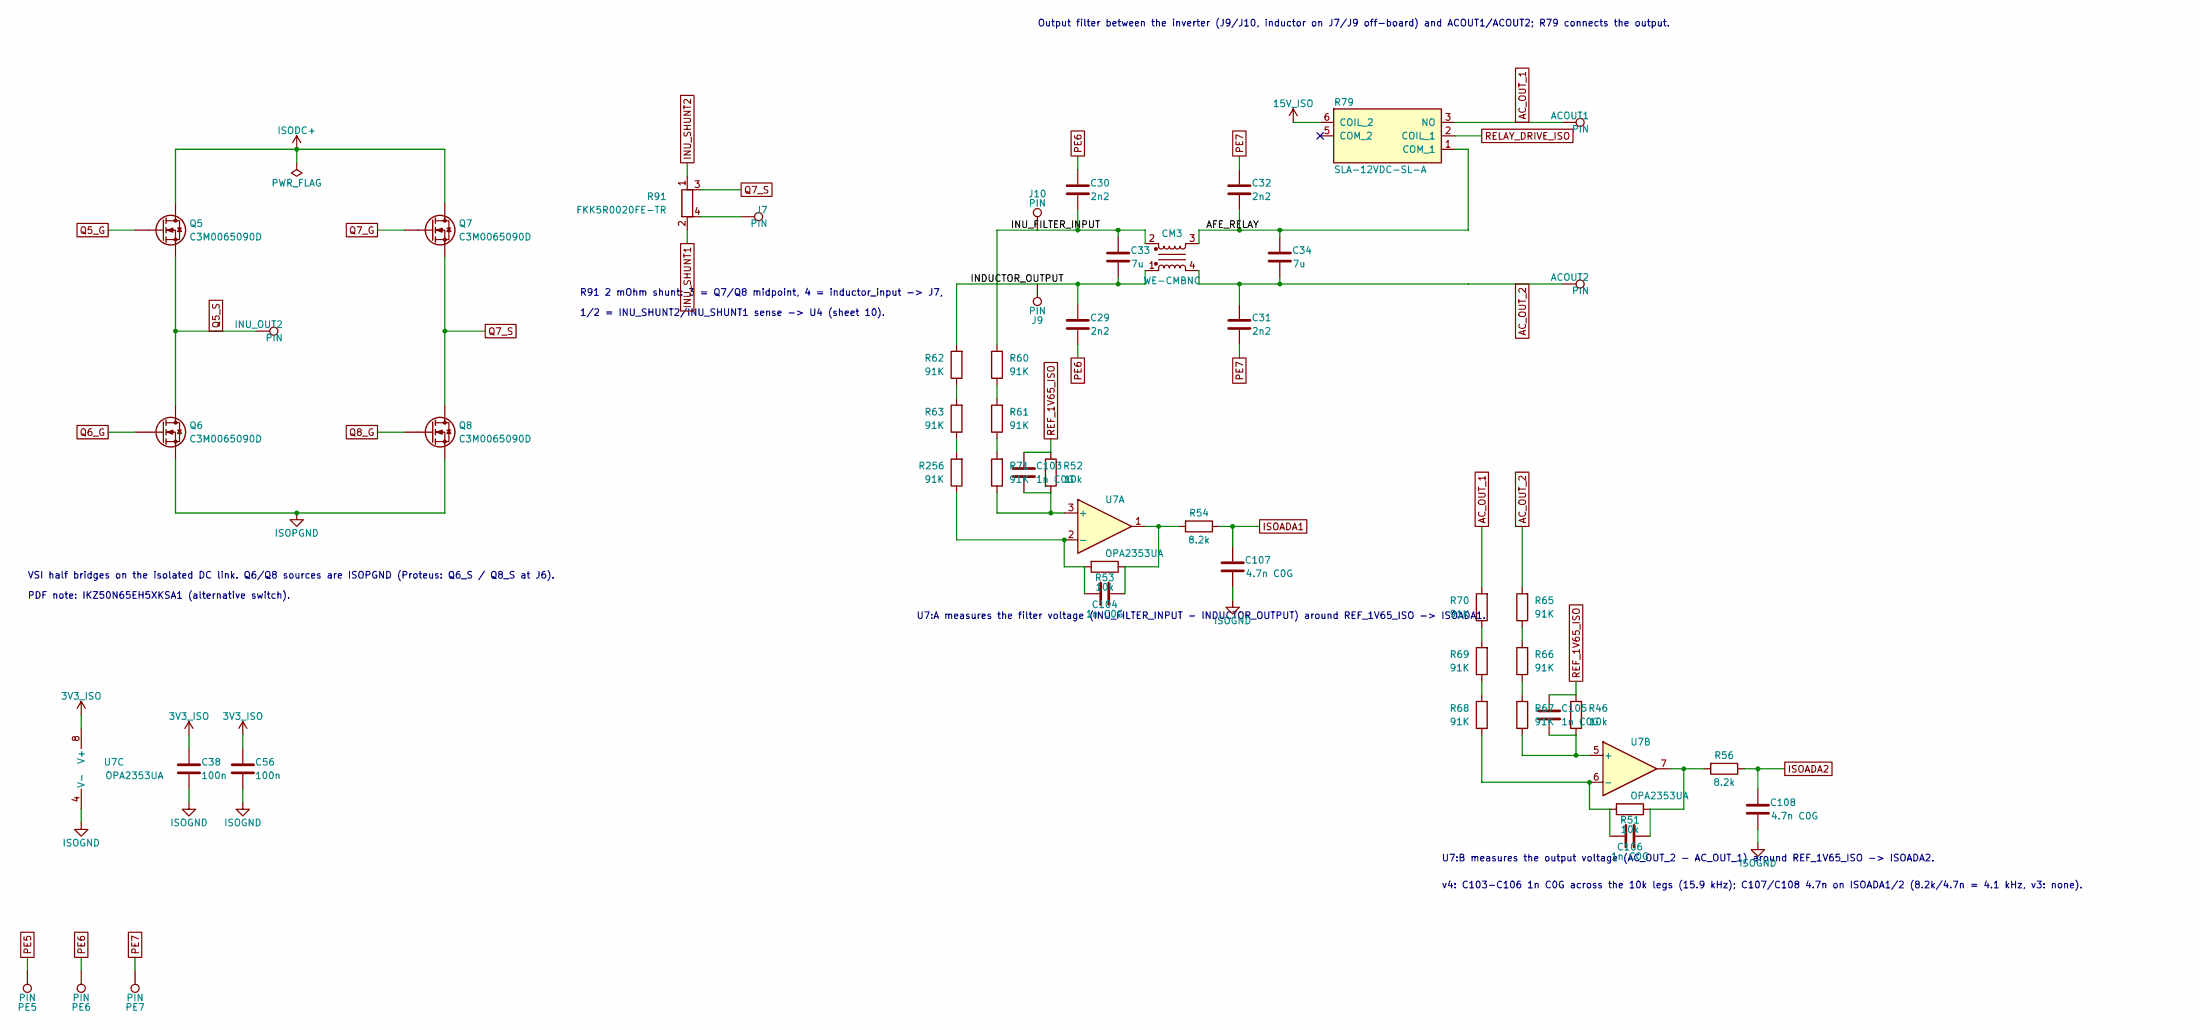
[picture p100: schematic 05_vsi.kicad_sch, Inverter PSU - VSI]

Parts:
ACOUT1, ACOUT2: PIN; Terminal_2x1_P5.00mm_D2.0mm_Drill1.4mm
C29, C30, C31, C32: 2n2; C_Disc_D12.5mm_W5.0mm_P7.50mm
C33, C34: 7u; C_Rect_L33.0mm_W20.0mm_P27.50mm_MKS4_Proteus
C38, C56: 100n; C_0402_1005Metric
C103, C104, C105, C106: 1n C0G; C_0402_1005Metric
C107, C108: 4.7n C0G; C_0402_1005Metric
CM3: WE-CMBNC; L_CommonMode_WE-CMBNC
INU_OUT2: PIN; Wuerth_REDCUBE-THR_74650074_M4_PTH
J7, J9, J10: PIN; Wuerth_REDCUBE-THR_74650074_M4_PTH
PE5, PE6, PE7: PIN; Terminal_D4.0mm_Drill3.0mm
Q5, Q6, Q7, Q8: C3M0065090D; TO-247-3_Vertical_Proteus
R46, R51, R52, R53: 10k; R_0402_1005Metric
R54, R56: 8.2k; R_0402_1005Metric
R60, R61, R62, R63, R65, R66, R67, R68, R69, R70, R71, R256: 91K; R_1206_3216Metric_Pad1.30x1.75mm_HandSolder
R79: SLA-12VDC-SL-A; Relay_SLA-12VDC-SL-A
R91: FKK5R0020FE-TR; R_Shunt_FKK5R0020FE
U7: OPA2353UA; TSSOP-8_3x3mm_P0.65mm_Proteus

Connections:
3V3_ISO: C38.2, C56.2, U7.8 (V+); also elsewhere on the board
15V_ISO: R79.6 (COIL_2); also elsewhere on the board
/05 VSI/AFE_RELAY: C32.2, C34.1, CM3.3, R79.1 (COM_1)
/05 VSI/INDUCTOR_OUTPUT: C29.2, C33.2, CM3.1, J9.1, R62.2
/05 VSI/INU_FILTER_INPUT: C30.2, C33.1, CM3.2, J10.1, R60.2
AC_OUT_1: ACOUT1.1, R70.2, R79.3 (NO)
AC_OUT_2: ACOUT2.1, C31.2, C34.2, CM3.4, R65.2
INU_SHUNT1: R91.2; also elsewhere on the board
INU_SHUNT2: R91.1; also elsewhere on the board
ISOADA1: C107.1, R54.1; also elsewhere on the board
ISOADA2: C108.1, R56.1; also elsewhere on the board
ISODC+: Q5.2 (D), Q7.2 (D); also elsewhere on the board
ISOGND: C38.1, C56.1, C107.2, C108.2, U7.4 (V-); also elsewhere on the board
ISOPGND: Q6.3 (S), Q8.3 (S); also elsewhere on the board
unnamed: C104.1, R53.1, R54.2, U7.1
unnamed: C106.1, R51.1, R56.2, U7.7
unnamed: J7.1, R91.4
unnamed: R60.1, R61.2
unnamed: R61.1, R71.2
unnamed: R62.1, R63.2
unnamed: R65.1, R66.2
unnamed: R66.1, R67.2
unnamed: R68.2, R69.1
unnamed: R69.2, R70.1
unnamed: R63.1, R256.2
unnamed: C103.2, R52.2, R71.1, U7.3 (+)
unnamed: C104.2, R53.2, R256.1, U7.2 (-)
unnamed: C105.2, R46.2, R67.1, U7.5 (+)
unnamed: C106.2, R51.2, R68.1, U7.6 (-)
PE5: PE5.1; also elsewhere on the board
PE6: C29.1, C30.1, PE6.1
PE7: C31.1, C32.1, PE7.1
Q5_G: Q5.1 (G); also elsewhere on the board
Q5_S: INU_OUT2.1, Q5.3 (S), Q6.2 (D); also elsewhere on the board
Q6_G: Q6.1 (G); also elsewhere on the board
Q7_G: Q7.1 (G); also elsewhere on the board
Q7_S: Q7.3 (S), Q8.2 (D), R91.3; also elsewhere on the board
Q8_G: Q8.1 (G); also elsewhere on the board
REF_1V65_ISO: C103.1, C105.1, R46.1, R52.1; also elsewhere on the board
RELAY_DRIVE_ISO: R79.2 (COIL_1); also elsewhere on the board

Notes on the sheet:
VSI half bridges on the isolated DC link. Q6/Q8 sources are ISOPGND (Proteus: Q6_S / Q8_S at J6).
PDF note: IKZ50N65EH5XKSA1 (alternative switch).
R91 2 mOhm shunt: 3 = Q7/Q8 midpoint, 4 = inductor_input -> J7,
1/2 = INU_SHUNT2/INU_SHUNT1 sense -> U4 (sheet 10).
Output filter between the inverter (J9/J10, inductor on J7/J9 off-board) and ACOUT1/ACOUT2; R79 connects the output.
U7:A measures the filter voltage (INU_FILTER_INPUT - INDUCTOR_OUTPUT) around REF_1V65_ISO -> ISOADA1.
v4: C103-C106 1n C0G across the 10k legs (15.9 kHz); C107/C108 4.7n on ISOADA1/2 (8.2k/4.7n = 4.1 kHz, v3: none).
U7:B measures the output voltage (AC_OUT_2 - AC_OUT_1) around REF_1V65_ISO -> ISOADA2.

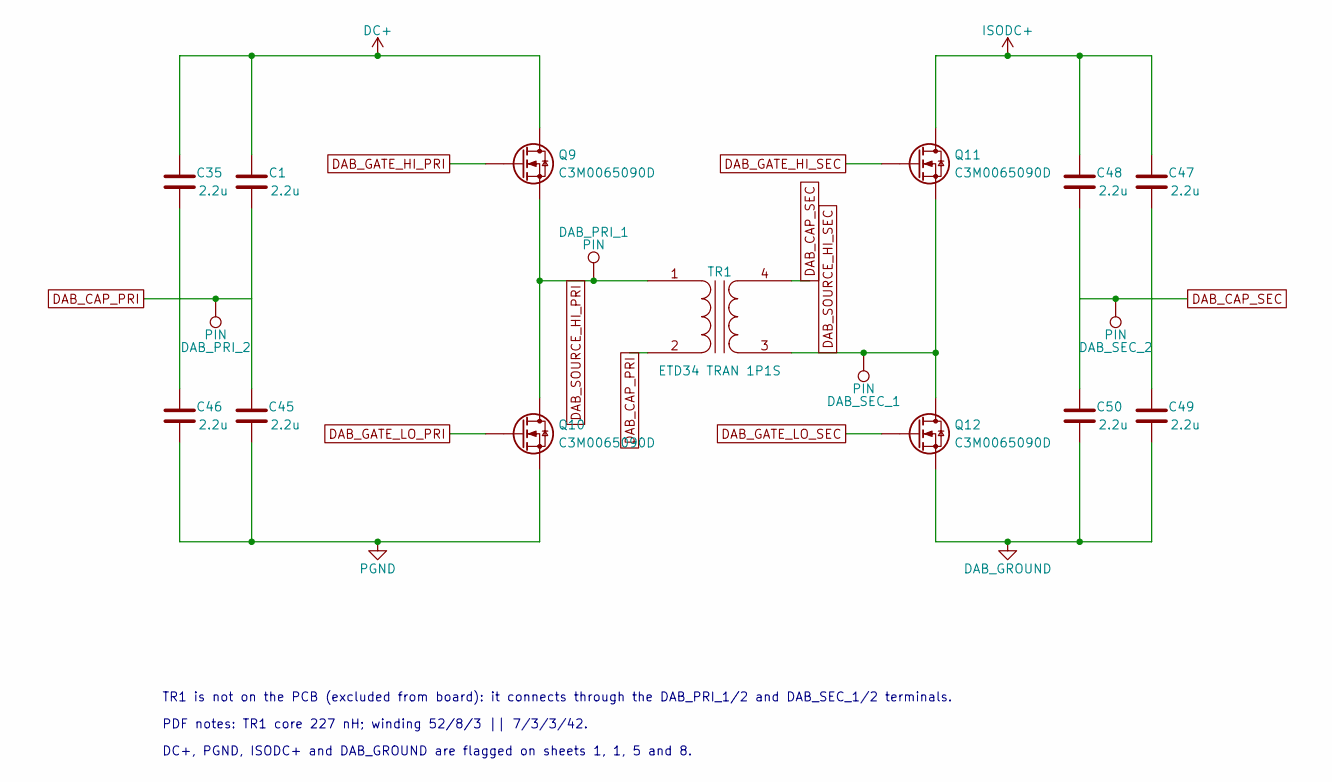
[picture p101: schematic 06_dual_active_bridge.kicad_sch, Inverter PSU - Dual Active Bridge]

Parts:
C1, C35, C45, C46, C47, C48, C49, C50: 2.2u; C_2220_5750Metric_Pad1.97x5.40mm_HandSolder
DAB_PRI_1, DAB_PRI_2: PIN; Terminal_D4.0mm_Drill3.0mm
DAB_SEC_1, DAB_SEC_2: PIN; Terminal_D4.0mm_Drill3.0mm
Q9, Q10, Q11, Q12: C3M0065090D; TO-247-3_Vertical_Proteus
TR1: ETD34 TRAN 1P1S

Connections:
DAB_CAP_PRI: C1.2, C35.2, C45.1, C46.1, DAB_PRI_2.1, TR1.2 (AB)
DAB_CAP_SEC: C47.2, C48.2, C49.1, C50.1, DAB_SEC_2.1, TR1.4 (SB)
DAB_GATE_HI_PRI: Q9.1 (G); also elsewhere on the board
DAB_GATE_HI_SEC: Q11.1 (G); also elsewhere on the board
DAB_GATE_LO_PRI: Q10.1 (G); also elsewhere on the board
DAB_GATE_LO_SEC: Q12.1 (G); also elsewhere on the board
DAB_GROUND: C49.2, C50.2, Q12.3 (S); also elsewhere on the board
DAB_SOURCE_HI_PRI: DAB_PRI_1.1, Q9.3 (S), Q10.2 (D), TR1.1 (AA); also elsewhere on the board
DAB_SOURCE_HI_SEC: DAB_SEC_1.1, Q11.3 (S), Q12.2 (D), TR1.3 (SA); also elsewhere on the board
DC+: C1.1, C35.1, Q9.2 (D); also elsewhere on the board
ISODC+: C47.1, C48.1, Q11.2 (D); also elsewhere on the board
PGND: C45.2, C46.2, Q10.3 (S); also elsewhere on the board

Notes on the sheet:
TR1 is not on the PCB (excluded from board): it connects through the DAB_PRI_1/2 and DAB_SEC_1/2 terminals.
PDF notes: TR1 core 227 nH; winding 52/8/3 || 7/3/3/42.
DC+, PGND, ISODC+ and DAB_GROUND are flagged on sheets 1, 1, 5 and 8.

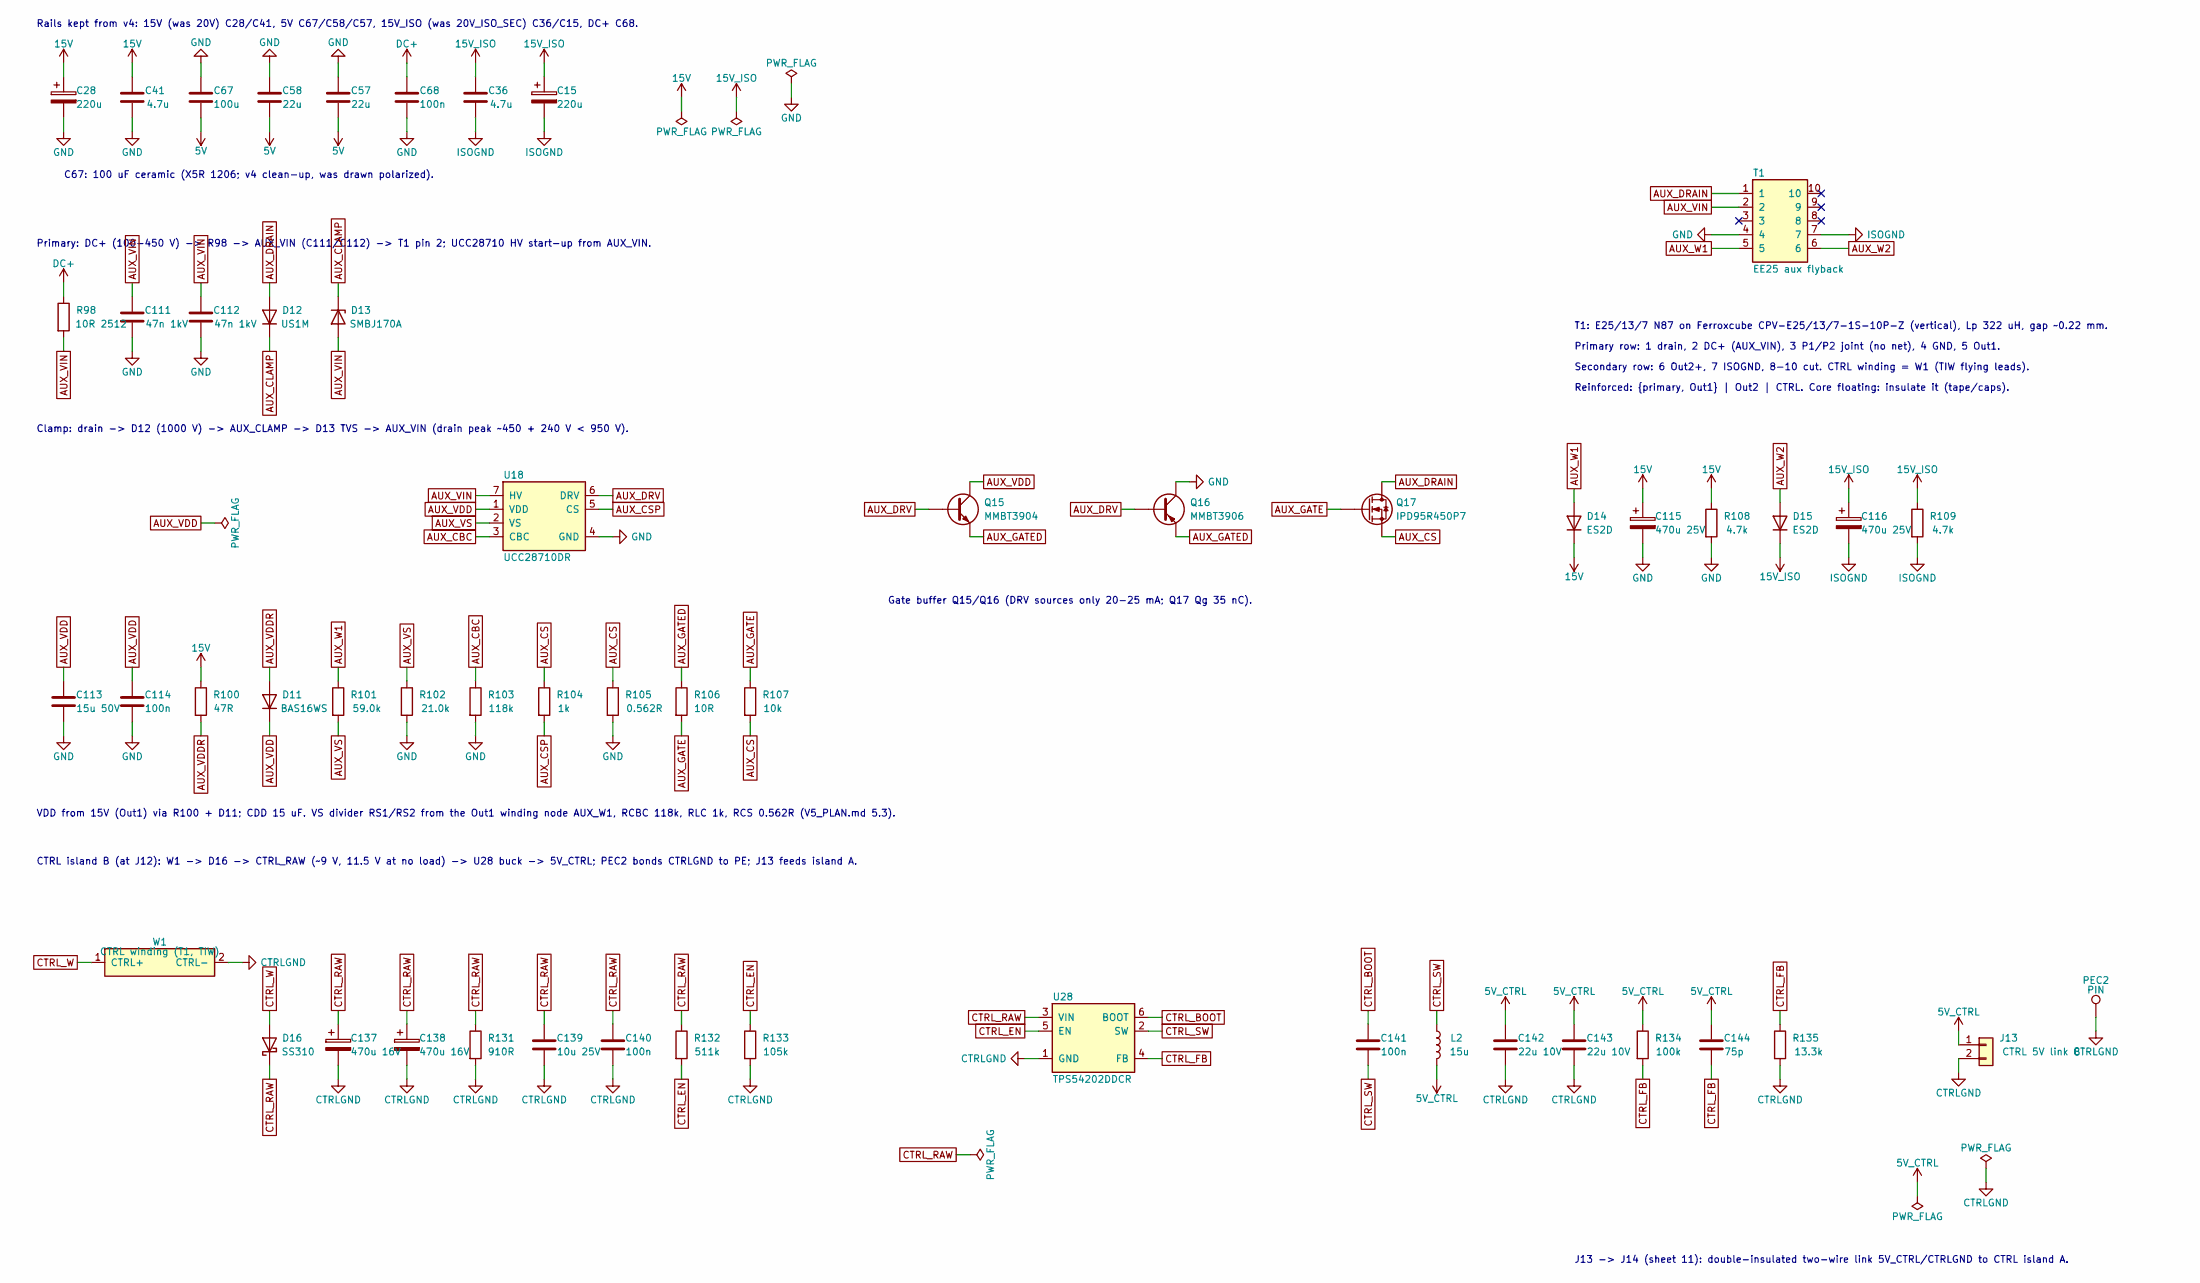
[picture p102: schematic 07_auxiliary_supply.kicad_sch, Inverter PSU - Auxiliary supply]

Parts:
C15, C28: 220u; CP_Elec_6.3x7.7_EEEFTE221XAP
C36, C41: 4.7u; C_1206_3216Metric_Pad1.33x1.80mm_HandSolder
C57, C58: 22u; C_1206_3216Metric_Pad1.33x1.80mm_HandSolder
C67: 100u; C_1206_3216Metric_Pad1.33x1.80mm_HandSolder
C68: 100n; C_1206_3216Metric_Pad1.33x1.80mm_HandSolder
C111, C112: 47n 1kV; C_1210_3225Metric
C113: 15u 50V; C_1210_3225Metric
C114, C140, C141: 100n; C_0603_1608Metric
C115, C116: 470u 25V; CP_Elec_8x10
C137, C138: 470u 16V; CP_Elec_8x10
C139: 10u 25V; C_1206_3216Metric
C142, C143: 22u 10V; C_1206_3216Metric
C144: 75p; C_0603_1608Metric
D11: BAS16WS; D_SOD-323_AC
D12: US1M; D_SMA_AC
D13: SMBJ170A; D_SMB_AC
D14, D15: ES2D; D_SMA_AC
D16: SS310; D_SMA_AC
J13: CTRL 5V link B; PinHeader_1x02_P2.54mm_Vertical
L2: 15u; L_Sunlord_SWPA6045S
PEC2: PIN; Terminal_D4.0mm_Drill3.0mm
Q15: MMBT3904; SOT-23
Q16: MMBT3906; SOT-23
Q17: IPD95R450P7; TO-252-2
R98: 10R 2512; R_2512_6332Metric
R100: 47R; R_0603_1608Metric
R101: 59.0k; R_0603_1608Metric
R102: 21.0k; R_0603_1608Metric
R103: 118k; R_0603_1608Metric
R104: 1k; R_0603_1608Metric
R105: 0.562R; R_1206_3216Metric
R106: 10R; R_0603_1608Metric
R107: 10k; R_0603_1608Metric
R108, R109: 4.7k; R_0805_2012Metric
R131: 910R; R_1206_3216Metric
R132: 511k; R_0603_1608Metric
R133: 105k; R_0603_1608Metric
R134: 100k; R_0603_1608Metric
R135: 13.3k; R_0603_1608Metric
T1: EE25 aux flyback; Transformer_EE25_Ferroxcube_CPV-E25-13-7-1S-10P_Vertical
U18: UCC28710DR; SOIC-7_3.9x4.9mm_P1.27mm_UCC28710
U28: TPS54202DDCR; SOT-23-6
W1: CTRL winding (T1, TIW); CTRL_Winding_Leads_2x1.6mm_P5.08mm

Connections:
5V: C57.2, C58.2, C67.2; also elsewhere on the board
5V_CTRL: C142.1, C143.1, C144.1, J13.1, L2.2, R134.1; also elsewhere on the board
15V: C28.1, C41.1, C115.1, D14.C (K), R100.1, R108.1; also elsewhere on the board
15V_ISO: C15.1, C36.1, C116.1, D15.C (K), R109.1; also elsewhere on the board
AUX_CBC: R103.1, U18.3 (CBC)
AUX_CLAMP: D12.C (K), D13.C (K)
AUX_CS: Q17.3 (S), R104.1, R105.1, R107.2
AUX_CSP: R104.2, U18.5 (CS)
AUX_DRAIN: D12.A, Q17.2 (D), T1.1
AUX_DRV: Q15.1 (B), Q16.1 (B), U18.6 (DRV)
AUX_GATE: Q17.1 (G), R106.2, R107.1
AUX_GATED: Q15.2 (E), Q16.2 (E), R106.1
AUX_VDD: C113.1, C114.1, D11.C (K), Q15.3 (C), U18.1 (VDD)
AUX_VDDR: D11.A, R100.2
AUX_VIN: C111.1, C112.1, D13.A, R98.2, T1.2, U18.7 (HV)
AUX_VS: R101.2, R102.1, U18.2 (VS)
AUX_W1: D14.A, R101.1, T1.5
AUX_W2: D15.A, T1.6
CTRLGND: C137.2, C138.2, C139.2, C140.2, C142.2, C143.2, J13.2, PEC2.1, R131.2, R133.2, R135.2, U28.1 (GND), W1.2 (CTRL-); also elsewhere on the board
CTRL_BOOT: C141.1, U28.6 (BOOT)
CTRL_EN: R132.2, R133.1, U28.5 (EN)
CTRL_FB: C144.2, R134.2, R135.1, U28.4 (FB)
CTRL_RAW: C137.1, C138.1, C139.1, C140.1, D16.C (K), R131.1, R132.1, U28.3 (VIN)
CTRL_SW: C141.2, L2.1, U28.2 (SW)
CTRL_W: D16.A, W1.1 (CTRL+)
DC+: C68.2, R98.1; also elsewhere on the board
GND: C28.2, C41.2, C57.1, C58.1, C67.1, C68.1, C111.2, C112.2, C113.2, C114.2, C115.2, Q16.3 (C), R102.2, R103.2, R105.2, R108.2, T1.4, U18.4 (GND); also elsewhere on the board
ISOGND: C15.2, C36.2, C116.2, R109.2, T1.7; also elsewhere on the board

Notes on the sheet:
Rails kept from v4: 15V (was 20V) C28/C41, 5V C67/C58/C57, 15V_ISO (was 20V_ISO_SEC) C36/C15, DC+ C68.
C67: 100 uF ceramic (X5R 1206; v4 clean-up, was drawn polarized).
Primary: DC+ (100-450 V) -> R98 -> AUX_VIN (C111/C112) -> T1 pin 2; UCC28710 HV start-up from AUX_VIN.
Clamp: drain -> D12 (1000 V) -> AUX_CLAMP -> D13 TVS -> AUX_VIN (drain peak ~450 + 240 V < 950 V).
VDD from 15V (Out1) via R100 + D11; CDD 15 uF. VS divider RS1/RS2 from the Out1 winding node AUX_W1, RCBC 118k, RLC 1k, RCS 0.562R (V5_PLAN.md 5.3).
Gate buffer Q15/Q16 (DRV sources only 20-25 mA; Q17 Qg 35 nC).
T1: E25/13/7 N87 on Ferroxcube CPV-E25/13/7-1S-10P-Z (vertical), Lp 322 uH, gap ~0.22 mm.
Primary row: 1 drain, 2 DC+ (AUX_VIN), 3 P1/P2 joint (no net), 4 GND, 5 Out1.
Secondary row: 6 Out2+, 7 ISOGND, 8-10 cut. CTRL winding = W1 (TIW flying leads).
Reinforced: {primary, Out1} | Out2 | CTRL. Core floating: insulate it (tape/caps).
CTRL island B (at J12): W1 -> D16 -> CTRL_RAW (~9 V, 11.5 V at no load) -> U28 buck -> 5V_CTRL; PEC2 bonds CTRLGND to PE; J13 feeds island A.
J13 -> J14 (sheet 11): double-insulated two-wire link 5V_CTRL/CTRLGND to CTRL island A.

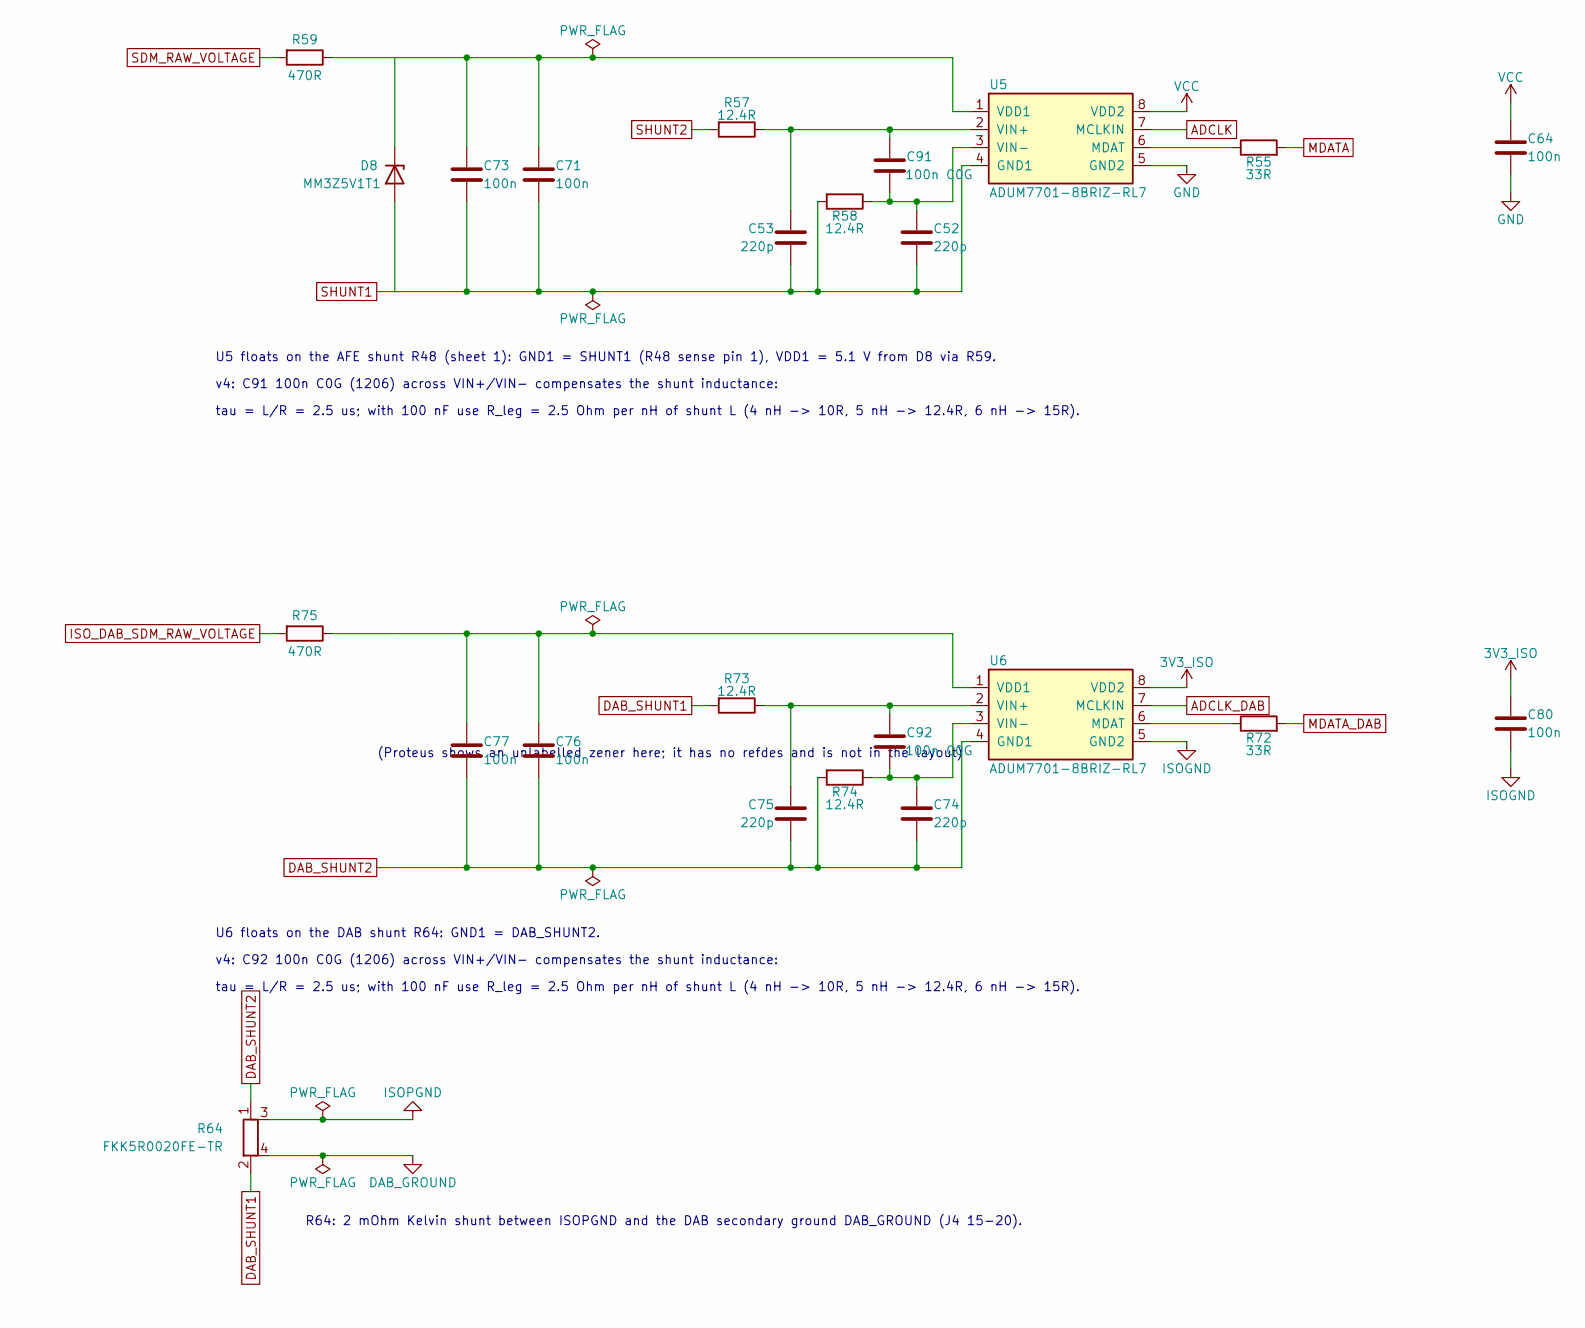
[picture p103: schematic 08_sdm_current_measurements.kicad_sch, Inverter PSU - SDM current measurements]

Parts:
C52, C53, C74, C75: 220p; C_0603_1608Metric
C64, C80: 100n; C_0402_1005Metric
C71, C73, C76, C77: 100n; C_0603_1608Metric
C91, C92: 100n C0G; C_1206_3216Metric
D8: MM3Z5V1T1; D_SOD-323_AC
R55, R72: 33R; R_0402_1005Metric
R57, R58, R73, R74: 12.4R; R_0402_1005Metric
R59, R75: 470R; R_0805_2012Metric_Pad1.20x1.40mm_HandSolder
R64: FKK5R0020FE-TR; R_Shunt_FKK5R0020FE
U5, U6: ADUM7701-8BRIZ-RL7; SOIC-8W_7.5x5.85mm_P1.27mm_ADuM7701

Connections:
3V3_ISO: C80.2, U6.8 (VDD2); also elsewhere on the board
ADCLK: U5.7 (MCLKIN); also elsewhere on the board
ADCLK_DAB: U6.7 (MCLKIN); also elsewhere on the board
DAB_GROUND: R64.4; also elsewhere on the board
DAB_SHUNT1: R64.2, R73.2
DAB_SHUNT2: C74.2, C75.2, C76.2, C77.2, R64.1, R74.2, U6.4 (GND1)
GND: C64.1, U5.5 (GND2); also elsewhere on the board
ISOGND: C80.1, U6.5 (GND2); also elsewhere on the board
ISOPGND: R64.3; also elsewhere on the board
ISO_DAB_SDM_RAW_VOLTAGE: R75.2; also elsewhere on the board
MDATA: R55.2; also elsewhere on the board
MDATA_DAB: R72.2; also elsewhere on the board
unnamed: C71.1, C73.1, D8.C (K), R59.1, U5.1 (VDD1)
unnamed: R55.1, U5.6 (MDAT)
unnamed: C53.1, C91.1, R57.1, U5.2 (VIN+)
unnamed: C52.1, C91.2, R58.1, U5.3 (VIN-)
unnamed: R72.1, U6.6 (MDAT)
unnamed: C76.1, C77.1, R75.1, U6.1 (VDD1)
unnamed: C75.1, C92.1, R73.1, U6.2 (VIN+)
unnamed: C74.1, C92.2, R74.1, U6.3 (VIN-)
SDM_RAW_VOLTAGE: R59.2; also elsewhere on the board
SHUNT1: C52.2, C53.2, C71.2, C73.2, D8.A, R58.2, U5.4 (GND1); also elsewhere on the board
SHUNT2: R57.2; also elsewhere on the board
VCC: C64.2, U5.8 (VDD2); also elsewhere on the board

Notes on the sheet:
v4: C91 100n C0G (1206) across VIN+/VIN- compensates the shunt inductance:
tau = L/R = 2.5 us; with 100 nF use R_leg = 2.5 Ohm per nH of shunt L (4 nH -> 10R, 5 nH -> 12.4R, 6 nH -> 15R).
U5 floats on the AFE shunt R48 (sheet 1): GND1 = SHUNT1 (R48 sense pin 1), VDD1 = 5.1 V from D8 via R59.
v4: C92 100n C0G (1206) across VIN+/VIN- compensates the shunt inductance:
(Proteus shows an unlabelled zener here; it has no refdes and is not in the layout)
U6 floats on the DAB shunt R64: GND1 = DAB_SHUNT2.
R64: 2 mOhm Kelvin shunt between ISOPGND and the DAB secondary ground DAB_GROUND (J4 15-20).

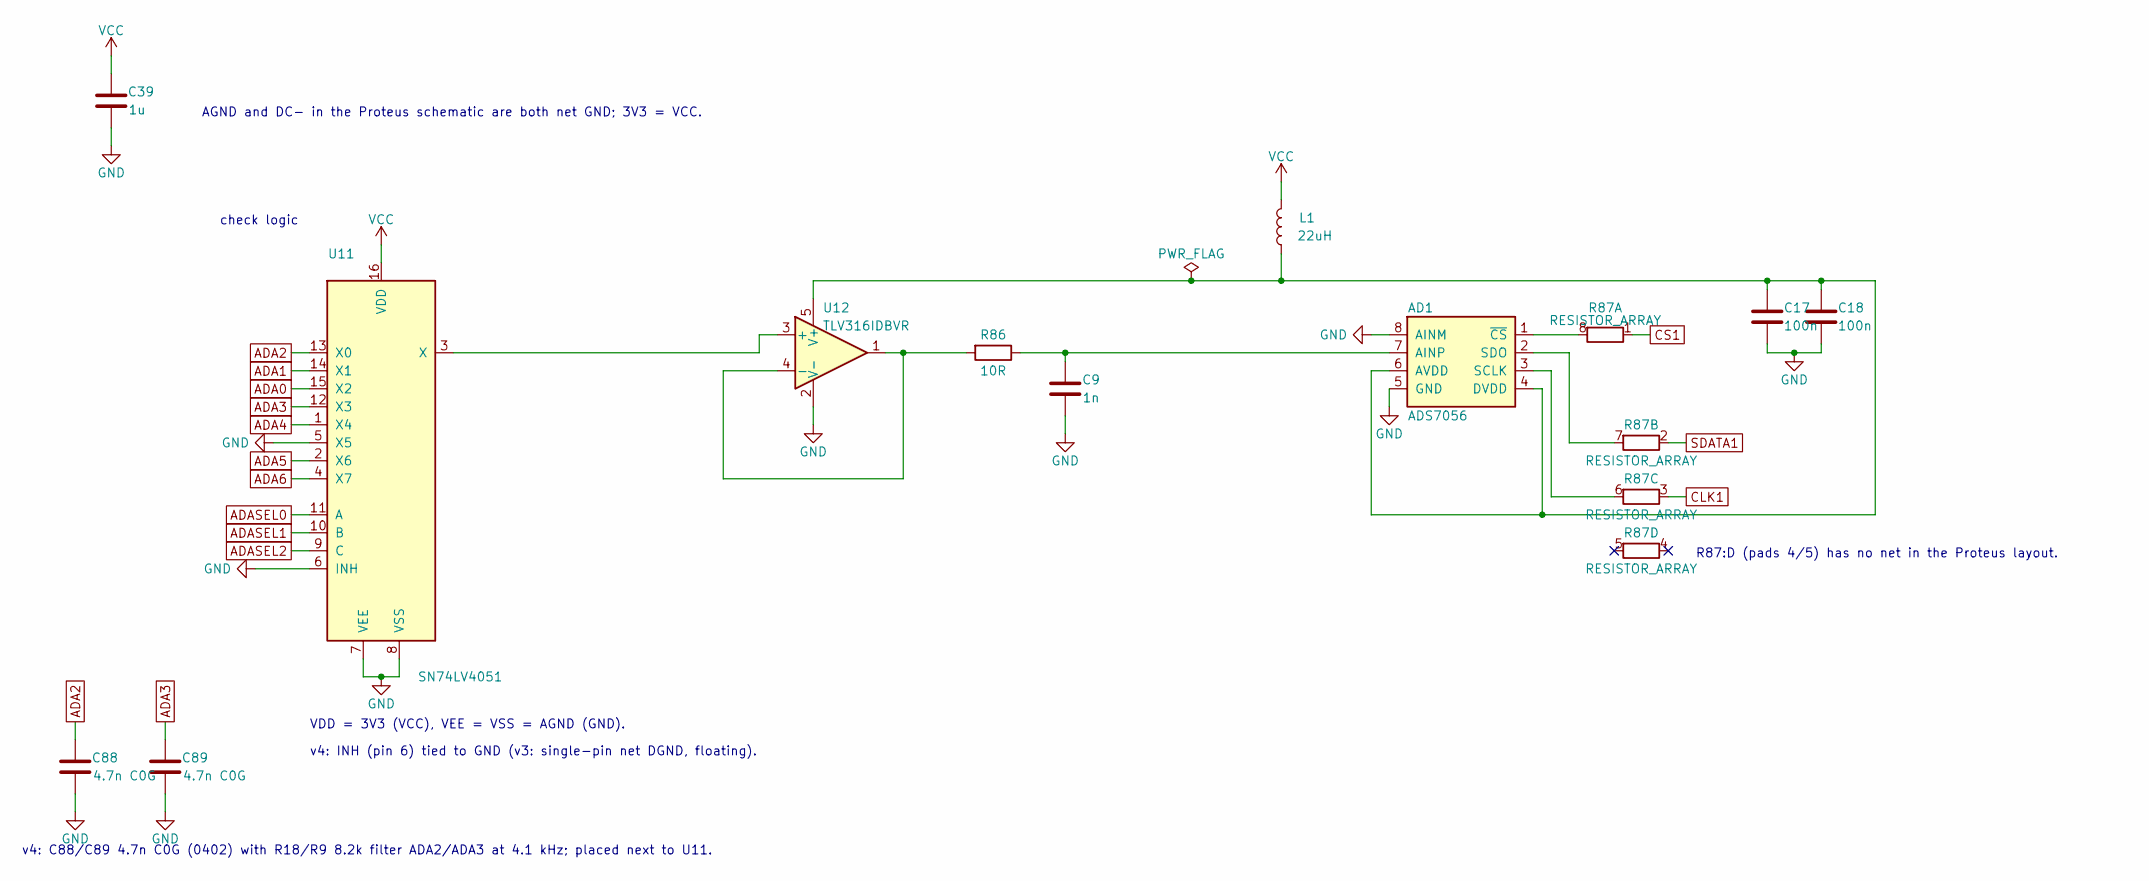
[picture p104: schematic 09_primary_side_adc.kicad_sch, Inverter PSU - primary side ADC]

Parts:
AD1: ADS7056; X2QFN-8_1.5x1.5mm_P0.5mm_ADS7056
C9: 1n; C_0402_1005Metric
C17, C18: 100n; C_0402_1005Metric
C39: 1u; C_0402_1005Metric
C88, C89: 4.7n C0G; C_0402_1005Metric
L1: 22uH; L_0805_2012Metric
R86: 10R; R_0402_1005Metric
R87: RESISTOR_ARRAY; R_Array_Convex_4x0402_Proteus
U11: SN74LV4051; TSSOP-16_4.4x5mm_P0.65mm_Proteus
U12: TLV316IDBVR; SOT-23-5_TLV316

Connections:
ADA0: U11.15 (X2)
ADA1: U11.14 (X1); also elsewhere on the board
ADA2: C88.1, U11.13 (X0); also elsewhere on the board
ADA3: C89.1, U11.12 (X3); also elsewhere on the board
ADA4: U11.1 (X4)
ADA5: U11.2 (X6)
ADA6: U11.4 (X7)
ADASEL0: U11.11 (A); also elsewhere on the board
ADASEL1: U11.10 (B); also elsewhere on the board
ADASEL2: U11.9 (C); also elsewhere on the board
CLK1: R87.3 (R3.1); also elsewhere on the board
CS1: R87.1 (R1.1); also elsewhere on the board
GND: AD1.5 (GND), AD1.8 (AINM), C9.1, C17.1, C18.1, C39.1, C88.2, C89.2, U11.5 (X5), U11.6 (INH), U11.7 (VEE), U11.8 (VSS), U12.2 (V-); also elsewhere on the board
unnamed: AD1.7 (AINP), C9.2, R86.1
unnamed: AD1.4 (DVDD), AD1.6 (AVDD), C17.2, C18.2, L1.1, U12.5 (V+)
unnamed: AD1.3 (SCLK), R87.6 (R3.2)
unnamed: AD1.2 (SDO), R87.7 (R2.2)
unnamed: AD1.1 (~CS), R87.8 (R1.2)
unnamed: U11.3 (X), U12.3 (+)
unnamed: R86.2, U12.1, U12.4 (-)
SDATA1: R87.2 (R2.1); also elsewhere on the board
VCC: C39.2, L1.2, U11.16 (VDD); also elsewhere on the board

Notes on the sheet:
AGND and DC- in the Proteus schematic are both net GND; 3V3 = VCC.
v4: INH (pin 6) tied to GND (v3: single-pin net DGND, floating).
VDD = 3V3 (VCC), VEE = VSS = AGND (GND).
check logic
v4: C88/C89 4.7n C0G (0402) with R18/R9 8.2k filter ADA2/ADA3 at 4.1 kHz; placed next to U11.
R87:D (pads 4/5) has no net in the Proteus layout.

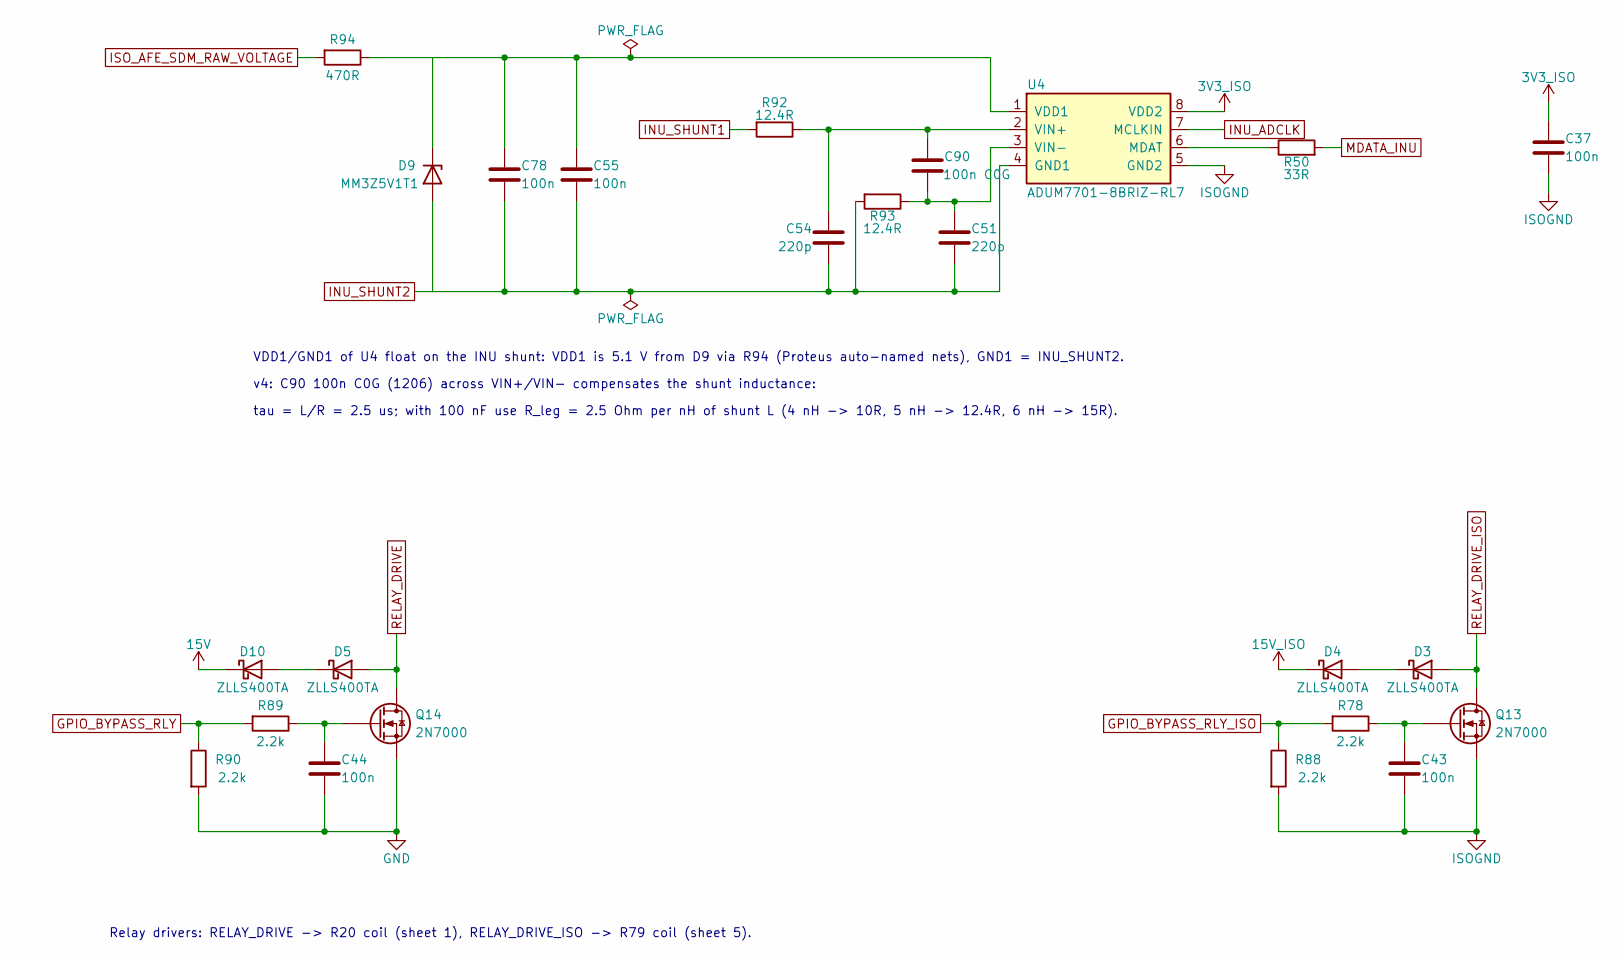
[picture p105: schematic 10_inu_sdm_relay_drive.kicad_sch, Inverter PSU - INU SDM and relay drive]

Parts:
C37: 100n; C_0402_1005Metric
C43, C44, C55, C78: 100n; C_0603_1608Metric
C51, C54: 220p; C_0603_1608Metric
C90: 100n C0G; C_1206_3216Metric
D3, D4, D5, D10: ZLLS400TA; D_SOD-323_AC
D9: MM3Z5V1T1; D_SOD-323_AC
Q13, Q14: 2N7000; SOT-23_Proteus
R50: 33R; R_0402_1005Metric
R78, R88, R89, R90: 2.2k; R_0603_1608Metric
R92, R93: 12.4R; R_0402_1005Metric
R94: 470R; R_0805_2012Metric_Pad1.20x1.40mm_HandSolder
U4: ADUM7701-8BRIZ-RL7; SOIC-8W_7.5x5.85mm_P1.27mm_ADuM7701

Connections:
3V3_ISO: C37.2, U4.8 (VDD2); also elsewhere on the board
15V: D10.C (K); also elsewhere on the board
15V_ISO: D4.C (K); also elsewhere on the board
GND: C44.2, Q14.3 (S), R90.2; also elsewhere on the board
GPIO_BYPASS_RLY: R89.2, R90.1; also elsewhere on the board
GPIO_BYPASS_RLY_ISO: R78.2, R88.1; also elsewhere on the board
INU_ADCLK: U4.7 (MCLKIN); also elsewhere on the board
INU_SHUNT1: R92.2; also elsewhere on the board
INU_SHUNT2: C51.2, C54.2, C55.2, C78.2, D9.A, R93.2, U4.4 (GND1); also elsewhere on the board
ISOGND: C37.1, C43.2, Q13.3 (S), R88.2, U4.5 (GND2); also elsewhere on the board
ISO_AFE_SDM_RAW_VOLTAGE: R94.2; also elsewhere on the board
MDATA_INU: R50.2; also elsewhere on the board
unnamed: D3.C (K), D4.A
unnamed: D5.C (K), D10.A
unnamed: C55.1, C78.1, D9.C (K), R94.1, U4.1 (VDD1)
unnamed: C43.1, Q13.2 (G), R78.1
unnamed: C44.1, Q14.2 (G), R89.1
unnamed: R50.1, U4.6 (MDAT)
unnamed: C54.1, C90.1, R92.1, U4.2 (VIN+)
unnamed: C51.1, C90.2, R93.1, U4.3 (VIN-)
RELAY_DRIVE: D5.A, Q14.1 (D); also elsewhere on the board
RELAY_DRIVE_ISO: D3.A, Q13.1 (D); also elsewhere on the board

Notes on the sheet:
v4: C90 100n C0G (1206) across VIN+/VIN- compensates the shunt inductance:
tau = L/R = 2.5 us; with 100 nF use R_leg = 2.5 Ohm per nH of shunt L (4 nH -> 10R, 5 nH -> 12.4R, 6 nH -> 15R).
VDD1/GND1 of U4 float on the INU shunt: VDD1 is 5.1 V from D9 via R94 (Proteus auto-named nets), GND1 = INU_SHUNT2.
Relay drivers: RELAY_DRIVE -> R20 coil (sheet 1), RELAY_DRIVE_ISO -> R79 coil (sheet 5).
