johonkanen/ac_psu_kicad/kicad/ac_psu.kicad_pcb

## KiCad design kicad/ac_psu.kicad_pcb (continued)

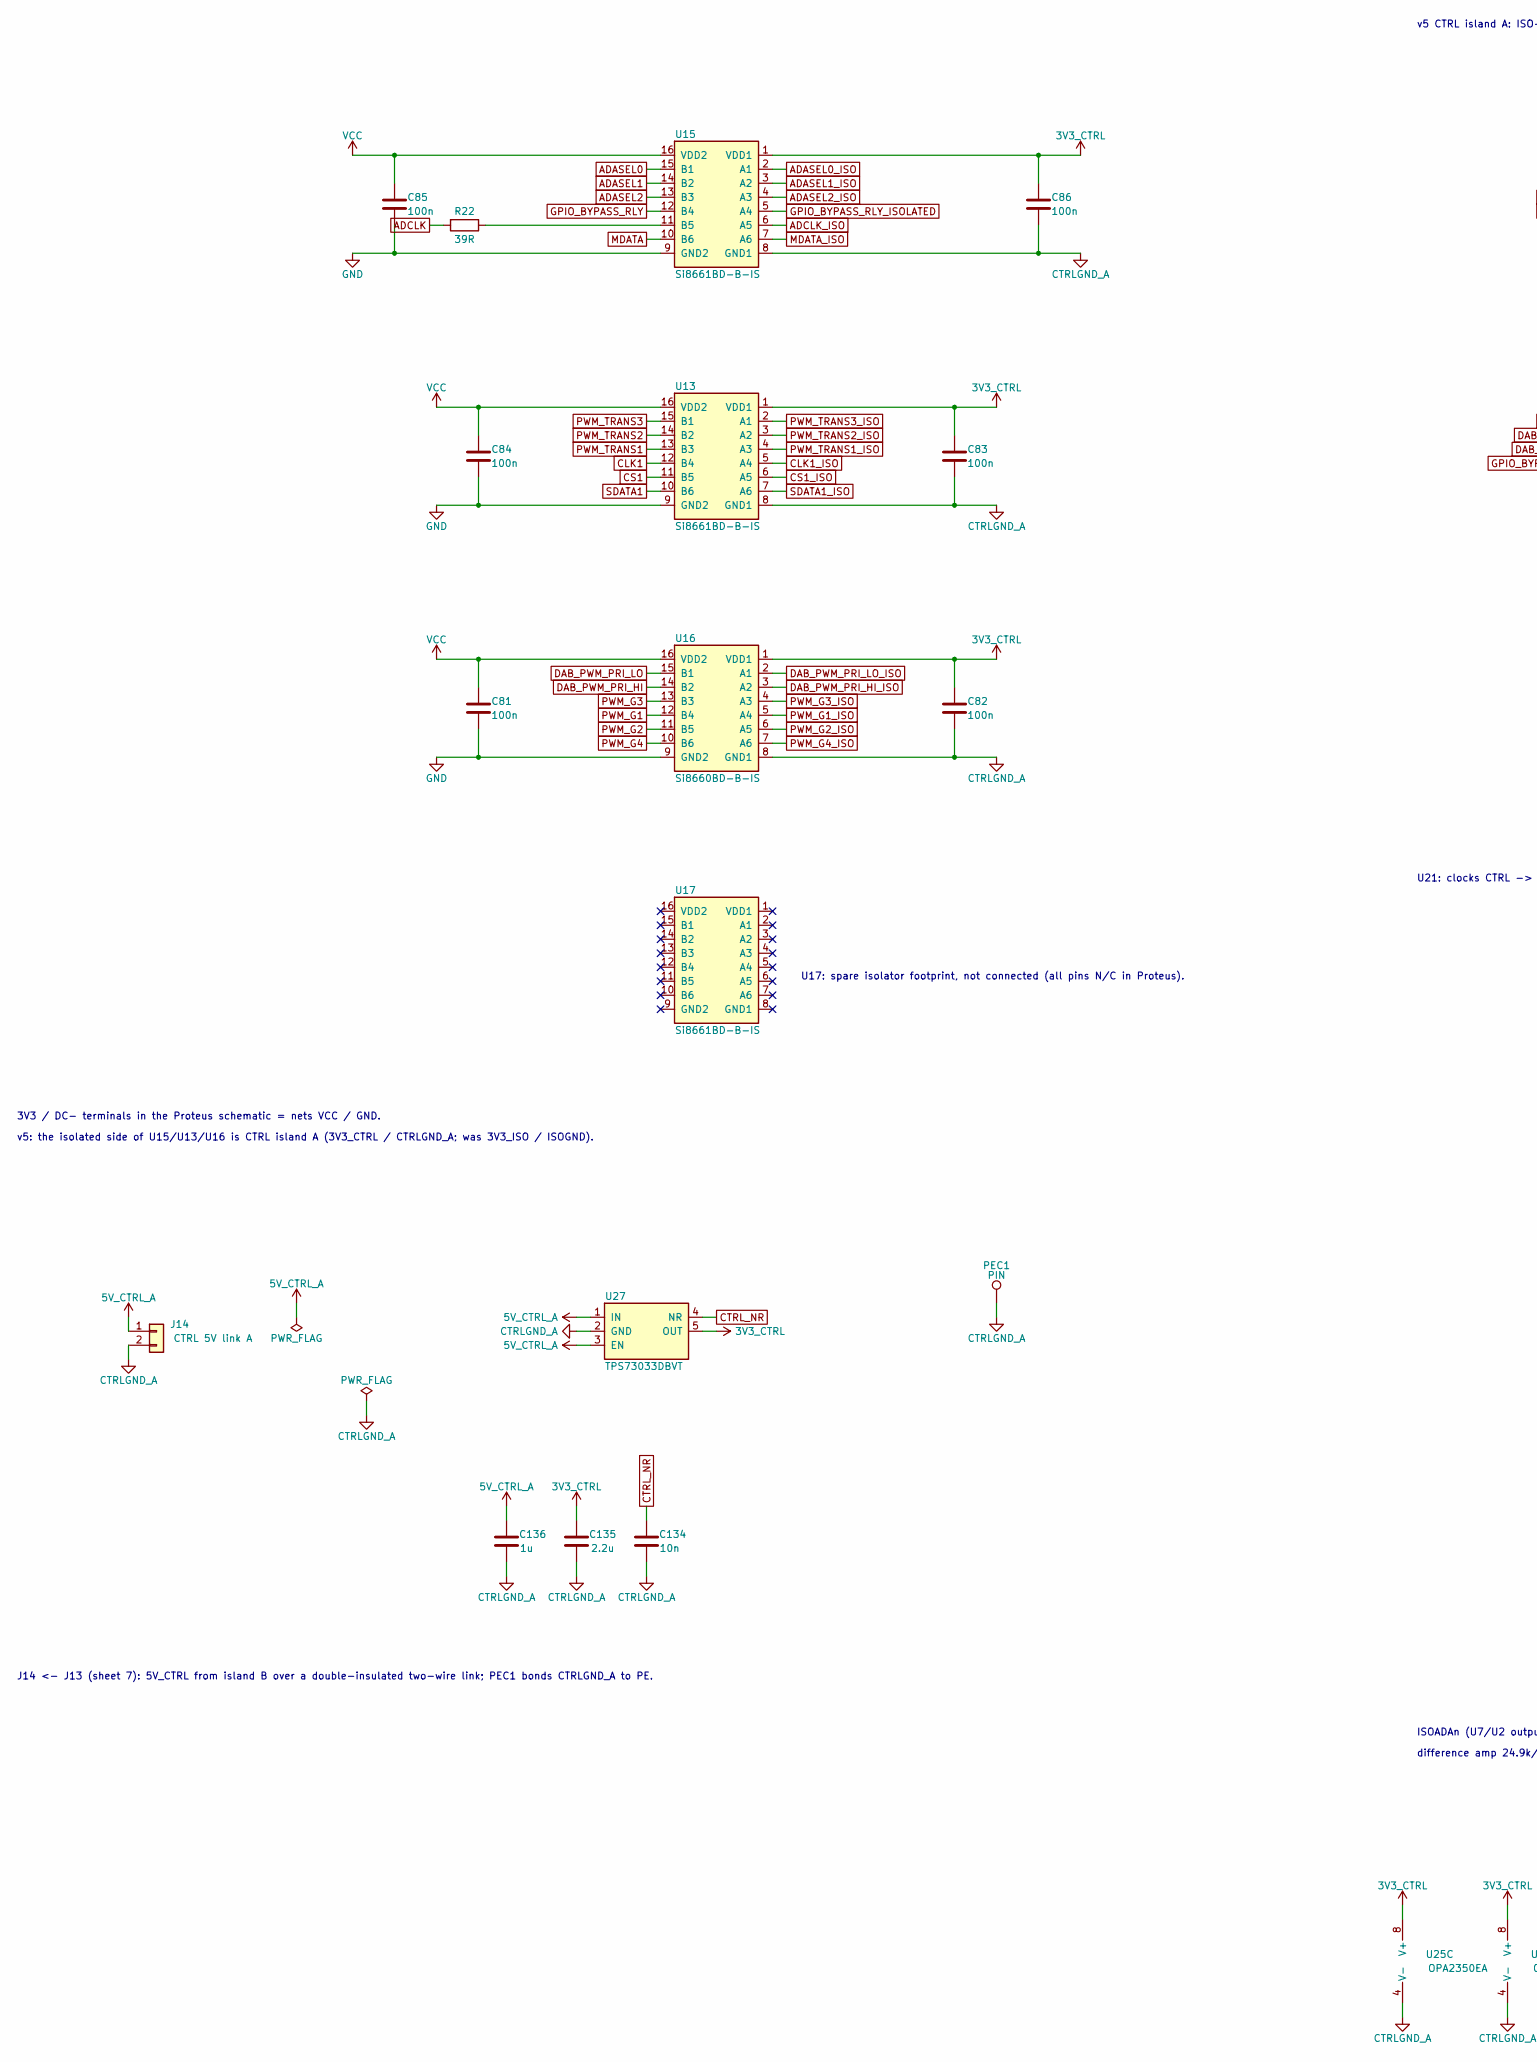
[picture p106: schematic 11_signal_isolators.kicad_sch, Inverter PSU - signal isolators, part in row 1, column 1]

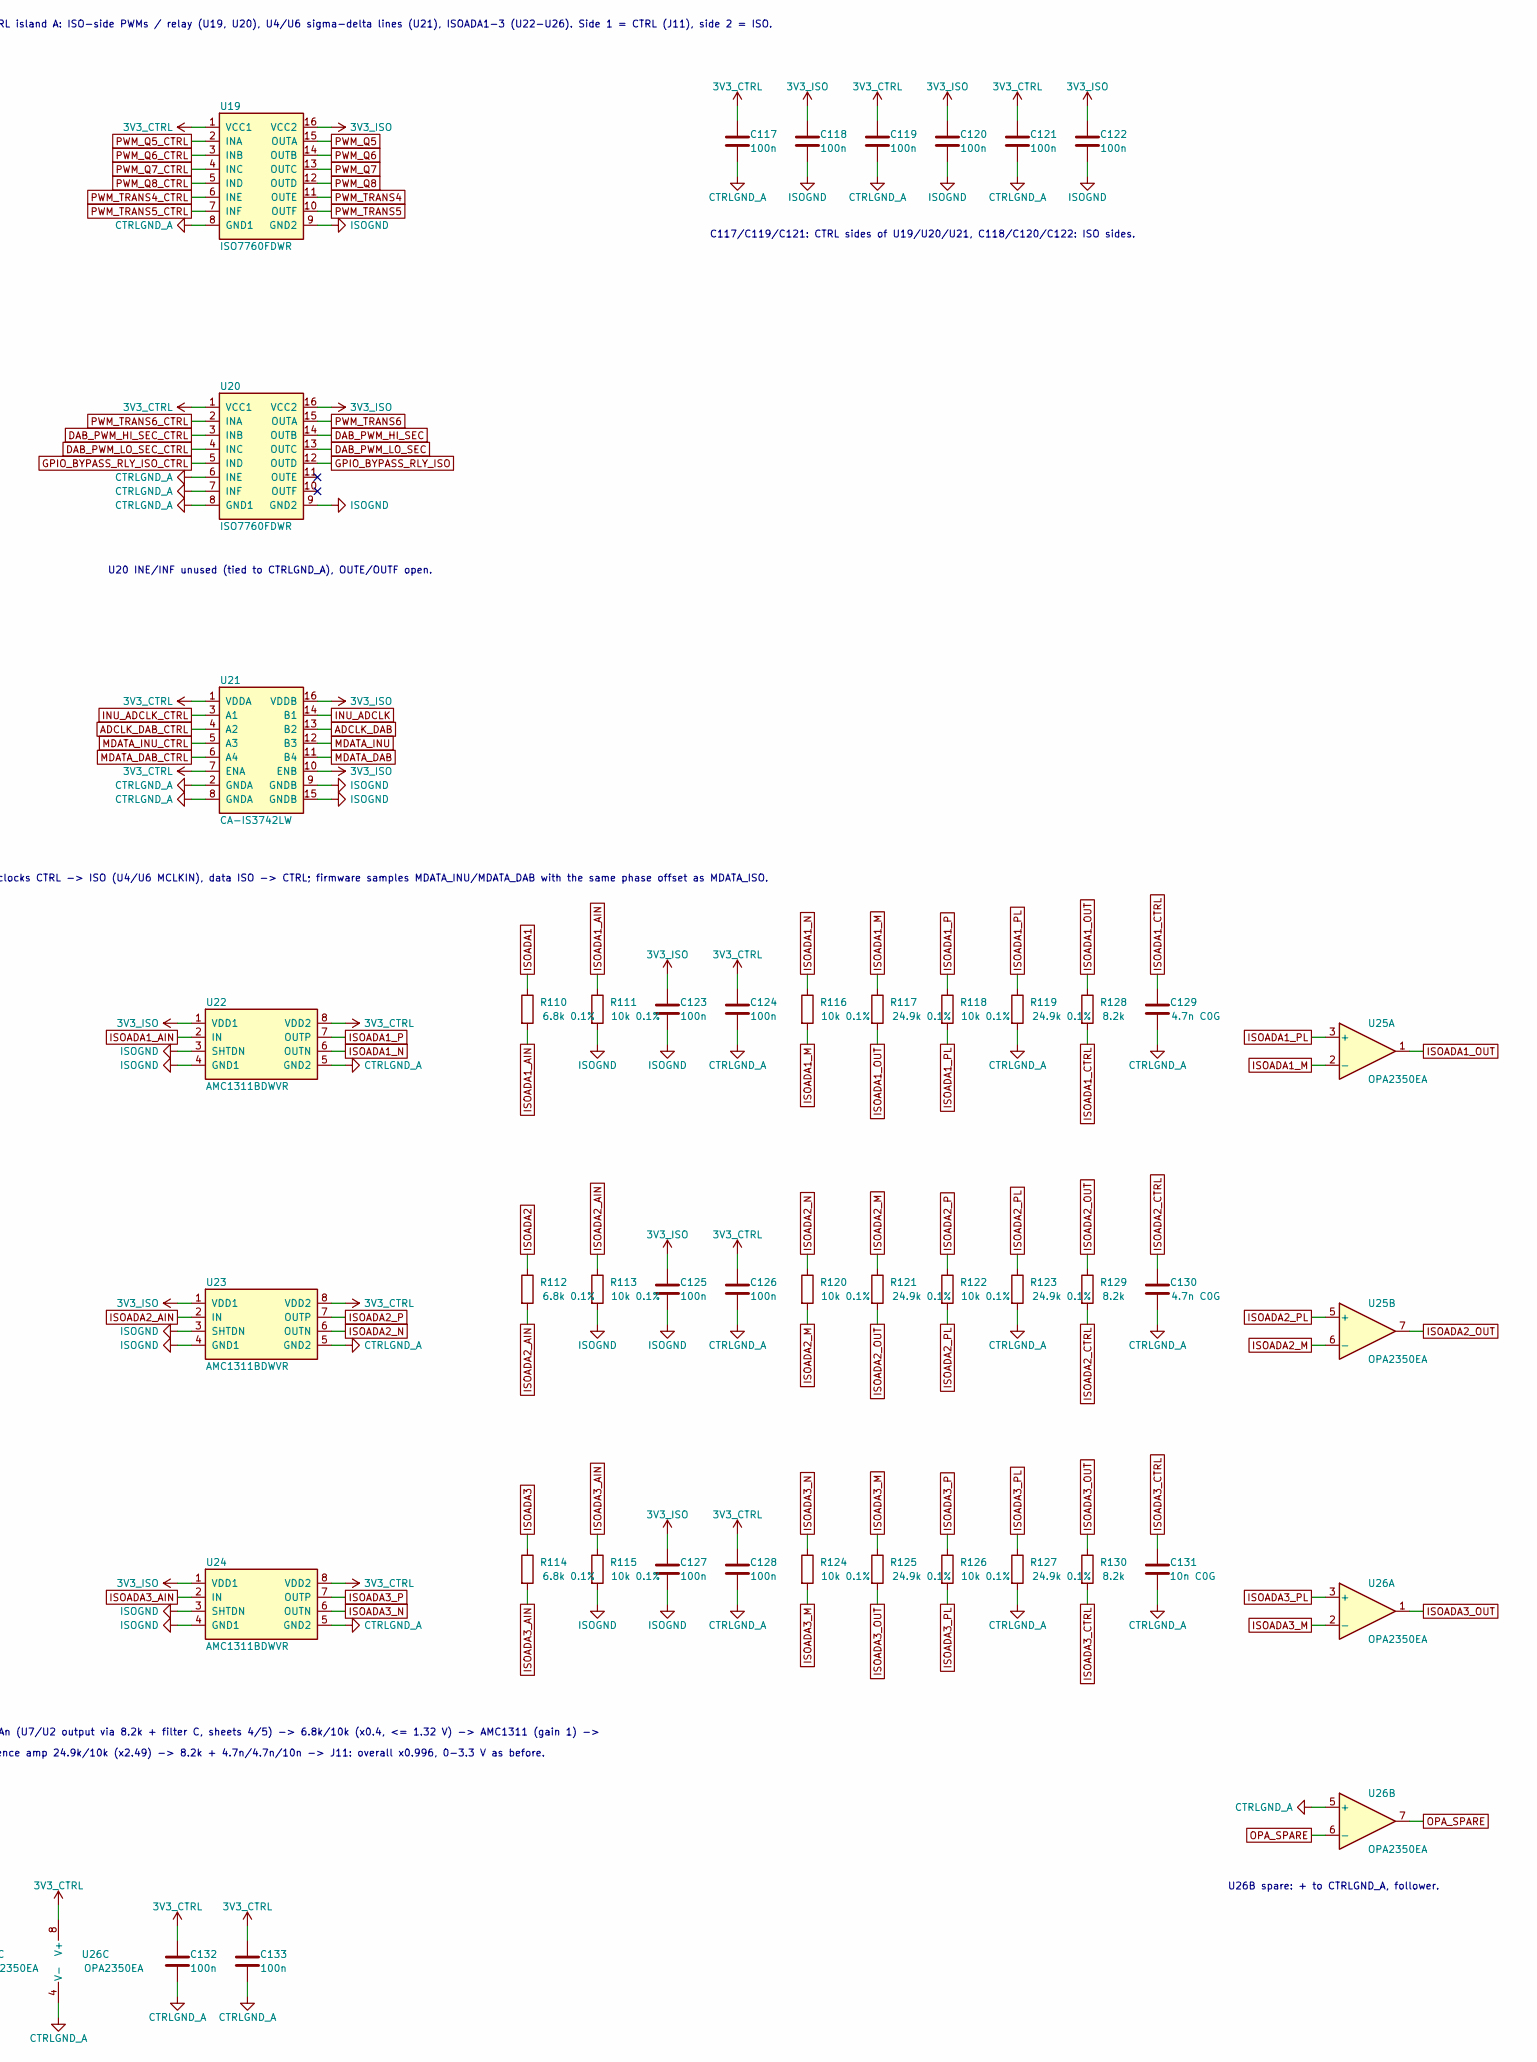
[picture p107: schematic 11_signal_isolators.kicad_sch, Inverter PSU - signal isolators, part in row 1, column 2]

Parts:
C81, C82, C83, C84, C85, C86, C117, C118, C119, C120, C121, C122, C123, C124, C125, C126, C127, C128, C132, C133: 100n; C_0402_1005Metric
C129, C130: 4.7n C0G; C_0402_1005Metric
C131: 10n C0G; C_0402_1005Metric
C134: 10n; C_0402_1005Metric
C135: 2.2u; C_0603_1608Metric
C136: 1u; C_0603_1608Metric
J14: CTRL 5V link A; PinHeader_1x02_P2.54mm_Vertical
PEC1: PIN; Terminal_D4.0mm_Drill3.0mm
R22: 39R; R_0402_1005Metric
R110, R112, R114: 6.8k 0.1%; R_0603_1608Metric
R111, R113, R115, R116, R118, R120, R122, R124, R126: 10k 0.1%; R_0603_1608Metric
R117, R119, R121, R123, R125, R127: 24.9k 0.1%; R_0603_1608Metric
R128, R129, R130: 8.2k; R_0402_1005Metric
U13, U15, U17: Si8661BD-B-IS; SOIC-16W_7.5x10.3mm_P1.27mm_Proteus
U16: Si8660BD-B-IS; SOIC-16W_7.5x10.3mm_P1.27mm_Proteus
U19, U20: ISO7760FDWR; SOIC-16W_7.5x10.3mm_P1.27mm
U21: CA-IS3742LW; SOIC-16W_7.5x10.3mm_P1.27mm
U22, U23, U24: AMC1311BDWVR; SOIC-8_7.5x5.85mm_P1.27mm
U25, U26: OPA2350EA; VSSOP-8_3x3mm_P0.65mm
U27: TPS73033DBVT; SOT-23-5

Connections:
3V3_CTRL: C82.2, C83.2, C86.2, C117.1, C119.1, C121.1, C124.1, C126.1, C128.1, C132.1, C133.1, C135.1, U13.1 (VDD1), U15.1 (VDD1), U16.1 (VDD1), U19.1 (VCC1), U20.1 (VCC1), U21.1 (VDDA), U21.7 (ENA), U22.8 (VDD2), U23.8 (VDD2), U24.8 (VDD2), U25.8 (V+), U26.8 (V+), U27.5 (OUT)
3V3_ISO: C118.1, C120.1, C122.1, C123.1, C125.1, C127.1, U19.16 (VCC2), U20.16 (VCC2), U21.10 (ENB), U21.16 (VDDB), U22.1 (VDD1), U23.1 (VDD1), U24.1 (VDD1); also elsewhere on the board
5V_CTRL_A: C136.1, J14.1, U27.1 (IN), U27.3 (EN)
ADASEL0: U15.15 (B1); also elsewhere on the board
ADASEL0_ISO: U15.2 (A1); also elsewhere on the board
ADASEL1: U15.14 (B2); also elsewhere on the board
ADASEL1_ISO: U15.3 (A2); also elsewhere on the board
ADASEL2: U15.13 (B3); also elsewhere on the board
ADASEL2_ISO: U15.4 (A3); also elsewhere on the board
ADCLK: R22.2; also elsewhere on the board
ADCLK_DAB: U21.13 (B2); also elsewhere on the board
ADCLK_DAB_CTRL: U21.4 (A2); also elsewhere on the board
ADCLK_ISO: U15.6 (A5); also elsewhere on the board
CLK1: U13.12 (B4); also elsewhere on the board
CLK1_ISO: U13.5 (A4); also elsewhere on the board
CS1: U13.11 (B5); also elsewhere on the board
CS1_ISO: U13.6 (A5); also elsewhere on the board
CTRLGND_A: C82.1, C83.1, C86.1, C117.2, C119.2, C121.2, C124.2, C126.2, C128.2, C129.2, C130.2, C131.2, C132.2, C133.2, C134.2, C135.2, C136.2, J14.2, PEC1.1, R119.2, R123.2, R127.2, U13.8 (GND1), U15.8 (GND1), U16.8 (GND1), U19.8 (GND1), U20.6 (INE), U20.7 (INF), U20.8 (GND1), U21.2 (GNDA), U21.8 (GNDA), U22.5 (GND2), U23.5 (GND2), U24.5 (GND2), U25.4 (V-), U26.4 (V-), U26.5 (+), U27.2 (GND); also elsewhere on the board
CTRL_NR: C134.1, U27.4 (NR)
DAB_PWM_HI_SEC: U20.14 (OUTB); also elsewhere on the board
DAB_PWM_HI_SEC_CTRL: U20.3 (INB); also elsewhere on the board
DAB_PWM_LO_SEC: U20.13 (OUTC); also elsewhere on the board
DAB_PWM_LO_SEC_CTRL: U20.4 (INC); also elsewhere on the board
DAB_PWM_PRI_HI: U16.14 (B2); also elsewhere on the board
DAB_PWM_PRI_HI_ISO: U16.3 (A2); also elsewhere on the board
DAB_PWM_PRI_LO: U16.15 (B1); also elsewhere on the board
DAB_PWM_PRI_LO_ISO: U16.2 (A1); also elsewhere on the board
GND: C81.1, C84.1, C85.1, U13.9 (GND2), U15.9 (GND2), U16.9 (GND2); also elsewhere on the board
GPIO_BYPASS_RLY: U15.12 (B4); also elsewhere on the board
GPIO_BYPASS_RLY_ISO: U20.12 (OUTD); also elsewhere on the board
GPIO_BYPASS_RLY_ISOLATED: U15.5 (A4); also elsewhere on the board
GPIO_BYPASS_RLY_ISO_CTRL: U20.5 (IND); also elsewhere on the board
INU_ADCLK: U21.14 (B1); also elsewhere on the board
INU_ADCLK_CTRL: U21.3 (A1); also elsewhere on the board
ISOADA1: R110.1; also elsewhere on the board
ISOADA1_AIN: R110.2, R111.1, U22.2 (IN)
ISOADA1_CTRL: C129.1, R128.2; also elsewhere on the board
ISOADA1_M: R116.2, R117.1, U25.2 (-)
ISOADA1_N: R116.1, U22.6 (OUTN)
ISOADA1_OUT: R117.2, R128.1, U25.1
ISOADA1_P: R118.1, U22.7 (OUTP)
ISOADA1_PL: R118.2, R119.1, U25.3 (+)
ISOADA2: R112.1; also elsewhere on the board
ISOADA2_AIN: R112.2, R113.1, U23.2 (IN)
ISOADA2_CTRL: C130.1, R129.2; also elsewhere on the board
ISOADA2_M: R120.2, R121.1, U25.6 (-)
ISOADA2_N: R120.1, U23.6 (OUTN)
ISOADA2_OUT: R121.2, R129.1, U25.7
ISOADA2_P: R122.1, U23.7 (OUTP)
ISOADA2_PL: R122.2, R123.1, U25.5 (+)
ISOADA3: R114.1; also elsewhere on the board
ISOADA3_AIN: R114.2, R115.1, U24.2 (IN)
ISOADA3_CTRL: C131.1, R130.2; also elsewhere on the board
ISOADA3_M: R124.2, R125.1, U26.2 (-)
ISOADA3_N: R124.1, U24.6 (OUTN)
ISOADA3_OUT: R125.2, R130.1, U26.1
ISOADA3_P: R126.1, U24.7 (OUTP)
ISOADA3_PL: R126.2, R127.1, U26.3 (+)
ISOGND: C118.2, C120.2, C122.2, C123.2, C125.2, C127.2, R111.2, R113.2, R115.2, U19.9 (GND2), U20.9 (GND2), U21.9 (GNDB), U21.15 (GNDB), U22.3 (SHTDN), U22.4 (GND1), U23.3 (SHTDN), U23.4 (GND1), U24.3 (SHTDN), U24.4 (GND1); also elsewhere on the board
MDATA: U15.10 (B6); also elsewhere on the board
MDATA_DAB: U21.11 (B4); also elsewhere on the board
MDATA_DAB_CTRL: U21.6 (A4); also elsewhere on the board
MDATA_INU: U21.12 (B3); also elsewhere on the board
MDATA_INU_CTRL: U21.5 (A3); also elsewhere on the board
MDATA_ISO: U15.7 (A6); also elsewhere on the board
unnamed: R22.1, U15.11 (B5)
OPA_SPARE: U26.6 (-), U26.7
PWM_G1: U16.12 (B4); also elsewhere on the board
PWM_G1_ISO: U16.5 (A4); also elsewhere on the board
PWM_G2: U16.11 (B5); also elsewhere on the board
PWM_G2_ISO: U16.6 (A5); also elsewhere on the board
PWM_G3: U16.13 (B3); also elsewhere on the board
PWM_G3_ISO: U16.4 (A3); also elsewhere on the board
PWM_G4: U16.10 (B6); also elsewhere on the board
PWM_G4_ISO: U16.7 (A6); also elsewhere on the board
PWM_Q5: U19.15 (OUTA); also elsewhere on the board
PWM_Q5_CTRL: U19.2 (INA); also elsewhere on the board
PWM_Q6: U19.14 (OUTB); also elsewhere on the board
PWM_Q6_CTRL: U19.3 (INB); also elsewhere on the board
PWM_Q7: U19.13 (OUTC); also elsewhere on the board
PWM_Q7_CTRL: U19.4 (INC); also elsewhere on the board
PWM_Q8: U19.12 (OUTD); also elsewhere on the board
PWM_Q8_CTRL: U19.5 (IND); also elsewhere on the board
PWM_TRANS1: U13.13 (B3); also elsewhere on the board
PWM_TRANS1_ISO: U13.4 (A3); also elsewhere on the board
PWM_TRANS2: U13.14 (B2); also elsewhere on the board
PWM_TRANS2_ISO: U13.3 (A2); also elsewhere on the board
PWM_TRANS3: U13.15 (B1); also elsewhere on the board
PWM_TRANS3_ISO: U13.2 (A1); also elsewhere on the board
PWM_TRANS4: U19.11 (OUTE); also elsewhere on the board
PWM_TRANS4_CTRL: U19.6 (INE); also elsewhere on the board
PWM_TRANS5: U19.10 (OUTF); also elsewhere on the board
PWM_TRANS5_CTRL: U19.7 (INF); also elsewhere on the board
PWM_TRANS6: U20.15 (OUTA); also elsewhere on the board
PWM_TRANS6_CTRL: U20.2 (INA); also elsewhere on the board
SDATA1: U13.10 (B6); also elsewhere on the board
SDATA1_ISO: U13.7 (A6); also elsewhere on the board
VCC: C81.2, C84.2, C85.2, U13.16 (VDD2), U15.16 (VDD2), U16.16 (VDD2); also elsewhere on the board

Notes on the sheet:
U17: spare isolator footprint, not connected (all pins N/C in Proteus).
3V3 / DC- terminals in the Proteus schematic = nets VCC / GND.
v5: the isolated side of U15/U13/U16 is CTRL island A (3V3_CTRL / CTRLGND_A; was 3V3_ISO / ISOGND).
v5 CTRL island A: ISO-side PWMs / relay (U19, U20), U4/U6 sigma-delta lines (U21), ISOADA1-3 (U22-U26). Side 1 = CTRL (J11), side 2 = ISO.
U20 INE/INF unused (tied to CTRLGND_A), OUTE/OUTF open.
U21: clocks CTRL -> ISO (U4/U6 MCLKIN), data ISO -> CTRL; firmware samples MDATA_INU/MDATA_DAB with the same phase offset as MDATA_ISO.
C117/C119/C121: CTRL sides of U19/U20/U21, C118/C120/C122: ISO sides.
ISOADAn (U7/U2 output via 8.2k + filter C, sheets 4/5) -> 6.8k/10k (x0.4, <= 1.32 V) -> AMC1311 (gain 1) ->
difference amp 24.9k/10k (x2.49) -> 8.2k + 4.7n/4.7n/10n -> J11: overall x0.996, 0-3.3 V as before.
U26B spare: + to CTRLGND_A, follower.
J14 <- J13 (sheet 7): 5V_CTRL from island B over a double-insulated two-wire link; PEC1 bonds CTRLGND_A to PE.

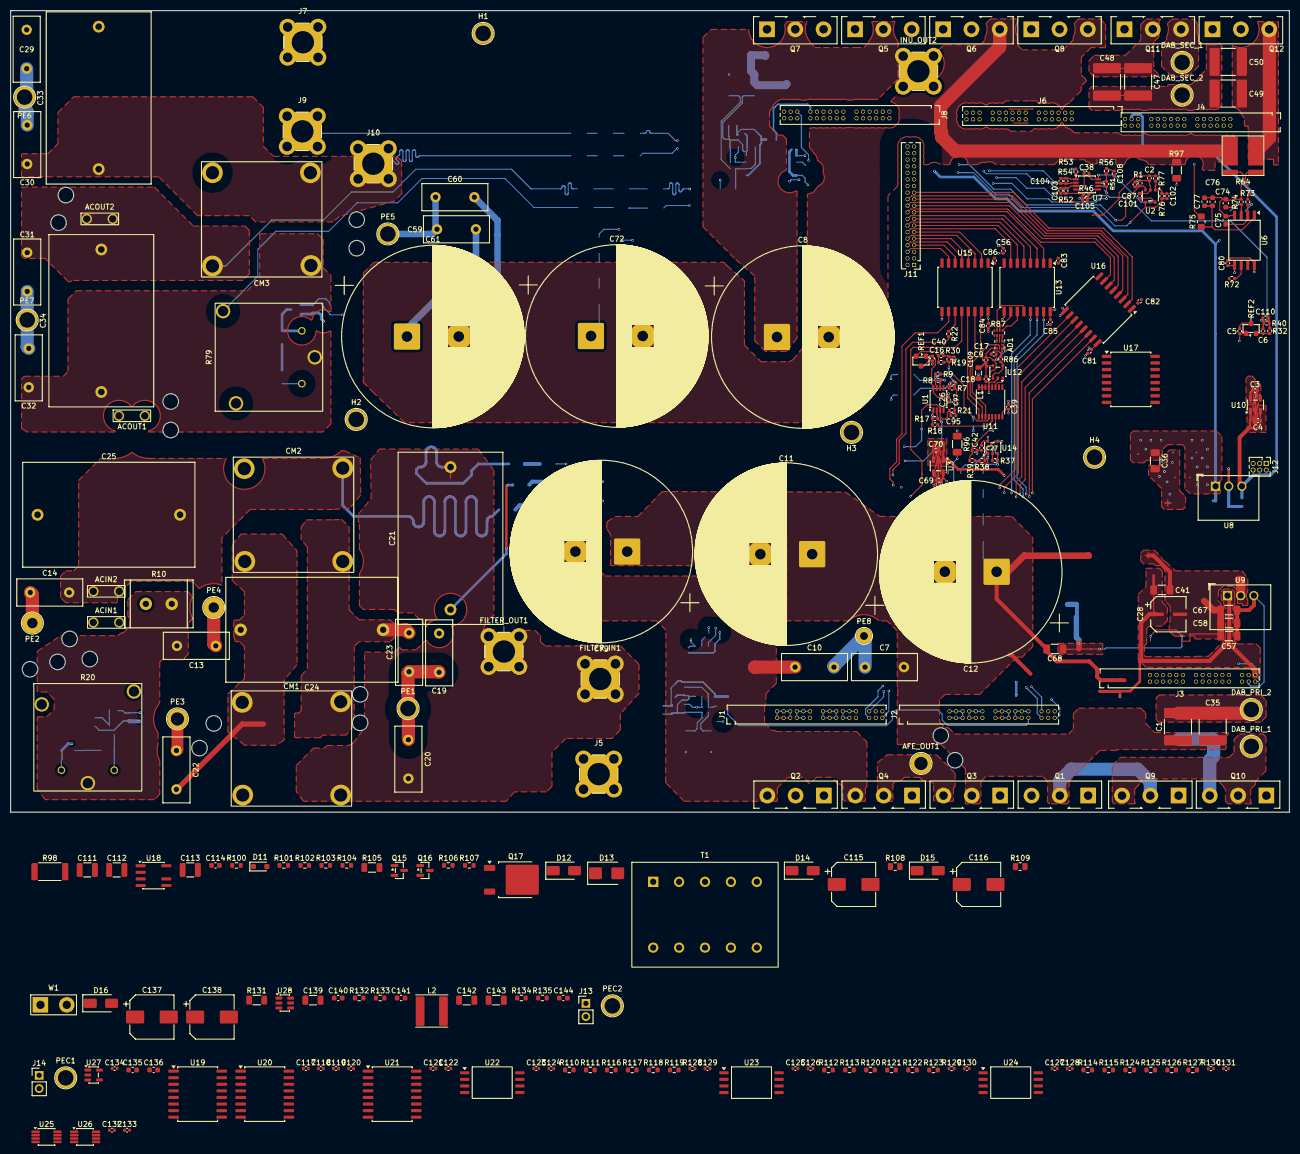
[picture p108: board ac_psu.kicad_pcb from above]

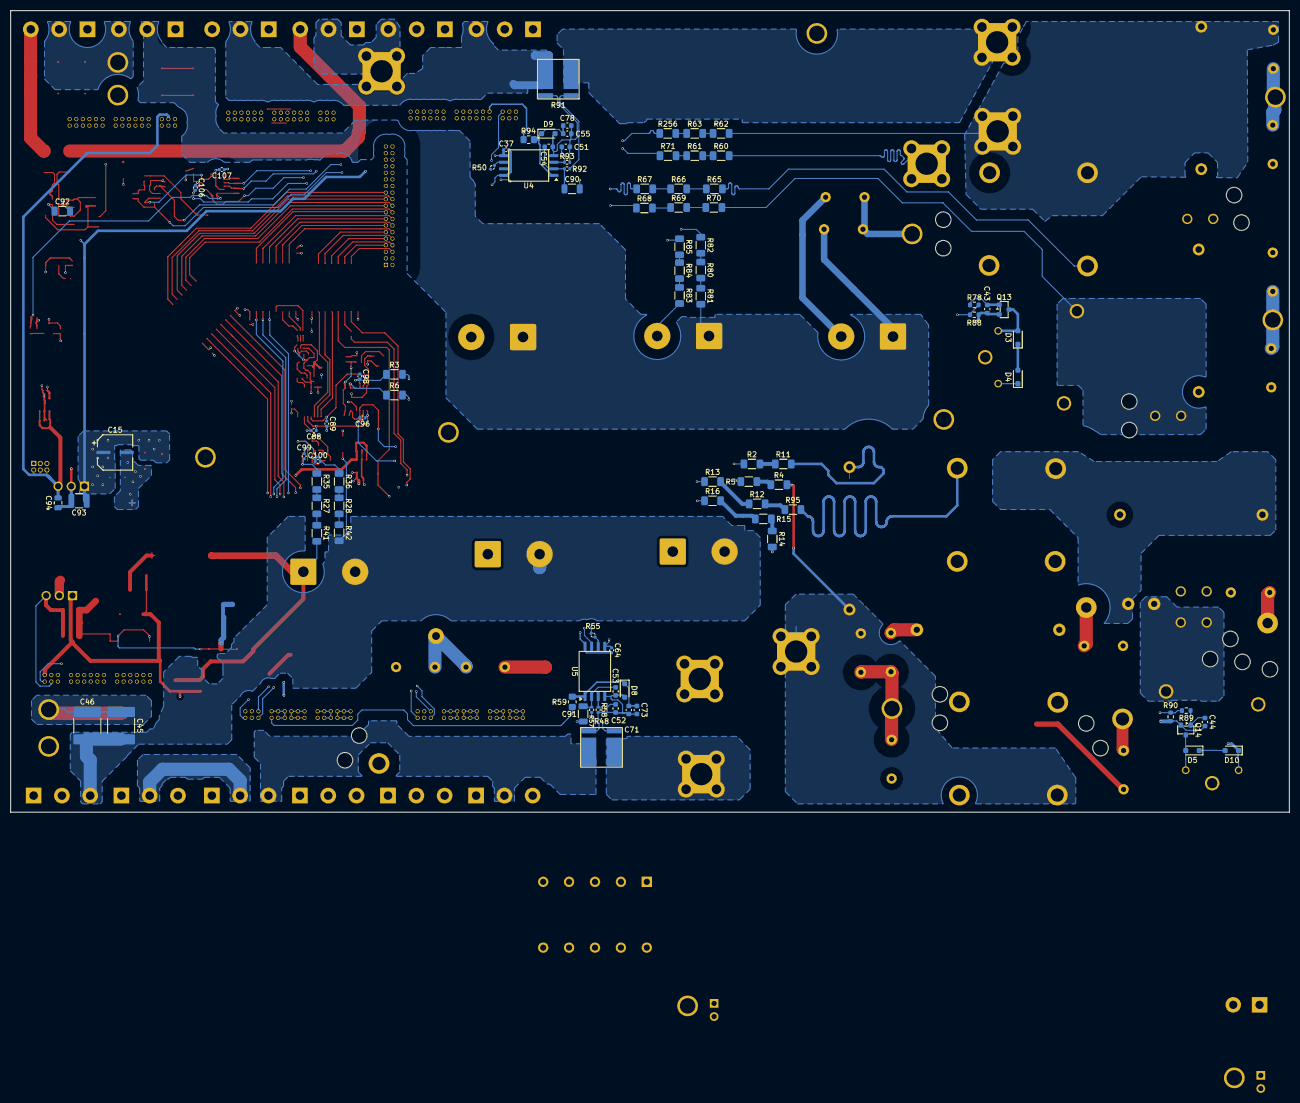
[picture p109: board ac_psu.kicad_pcb from below]

Board: 4 copper layers, 246.8 x 154.7 mm, 377 parts (88 on the bottom side), 254 nets.

Other parts of the board:
H1, H2, H3, H4: MountingHole_3.0mm; Terminal_D4.0mm_Drill3.0mm
TIE_ACIN1: cable tie; CableTie_NPTH_2x3.0mm_P5.5mm
TIE_ACOUT1, TIE_ACOUT2: cable tie; CableTie_NPTH_2x3.0mm_P5.5mm
TIE_AFE_OUT1: cable tie; CableTie_NPTH_2x3.0mm_P5.5mm
TIE_PE1, TIE_PE2, TIE_PE3, TIE_PE5: cable tie; CableTie_NPTH_2x3.0mm_P5.5mm
