johonkanen/ac_psu_kicad/(commit log)

2026-10-17 Add migration plan and Proteus source exports for single_phase_inverter_psu_v3
    Inventory of the Proteus CADCAM export (gerbers, IPC-D-356 netlist, schematic PDF
    renders), the phase plan for redrawing the schematic in KiCad 10 and mapping the
    gerber copper onto the new nets, the model usage plan, and a STATUS.md handoff file.
    [single_phase_inverter_psu_v3 - CADCAM Bottom Assembly.GBR, single_phase_inverter_psu_v3 - CADCAM Bottom Copper.GBR, single_phase_inverter_psu_v3 - CADCAM Bottom SMT Paste.GBR, single_phase_inverter_psu_v3 - CADCAM Bottom Silk Screen.GBR, single_phase_inverter_psu_v3 - CADCAM Bottom Solder Resist.GBR, single_phase_inverter_psu_v3 - CADCAM Drill TOP-BOT Plated.GBR, single_phase_inverter_psu_v3 - CA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]
2026-10-17 Phase 0: KiCad AppImage env, IPC-D-356A parser, pin/net reference tables
    [ipc356_pads.csv]
2026-10-17 Phase 1 prep: symbol library, part map, netlist comparison, KiCad skeleton
    - tools/gen_symbols.py -> lib/ac_psu.kicad_sym (pin ids = IPC, power symbols = IPC nets)
    - lib/part_map.csv + tools/check_symbols.py (pin sets vs IPC for every refdes)
    - tools/compare_netlists.py (pad-set equivalence, per-sheet progress)
    - tools/make_skeleton.py -> kicad/ project with 11 hierarchical sheets
    - tools/sch_builder.py, tools/erc.sh; check_all.sh extended
    [01_afe.kicad_sch, 02_fpga_connector.kicad_sch, 03_regulators.kicad_sch, 04_dc_links.kicad_sch, 05_vsi.kicad_sch, 06_dual_active_bridge.kicad_sch, 07_auxiliary_supply.kicad_sch, 08_sdm_current_measurements.kicad_sch]
2026-10-18 Phase 1: sheet 2 (fpga connector) transcribed; sheet scripts, renderer, pending-split warnings
    [02_fpga_connector.kicad_sch]
2026-10-18 Phase 1: sheet 3 (regulators) transcribed; centred field text for two-pin parts
    [02_fpga_connector.kicad_sch, 03_regulators.kicad_sch]
2026-10-18 Phase 1: sheet 11 (signal isolators); builder: rotation-aware fields, text sides, terminals
    [03_regulators.kicad_sch, 11_signal_isolators.kicad_sch]
2026-10-18 Phase 1: sheet 10 (INU SDM and relay drive)
    [10_inu_sdm_relay_drive.kicad_sch]
2026-10-18 Phase 1: sheet 9 (primary side ADC)
    [09_primary_side_adc.kicad_sch]
2026-10-18 Phase 1: sheet 8 (SDM current measurements)
    [08_sdm_current_measurements.kicad_sch]
2026-10-18 Phase 1: sheet 1 (afe); power symbols for PGND/ISOPGND/DAB_GROUND groups on sheet 2
    [01_afe.kicad_sch, 02_fpga_connector.kicad_sch]
2026-10-18 Phase 1: sheet 5 (VSI); diff_amp shared helper, layout fixes on sheets 1/8
    [01_afe.kicad_sch, 05_vsi.kicad_sch, 08_sdm_current_measurements.kicad_sch]
2026-10-18 Phase 1: sheets 6 (DAB) and 4 (DC links); diff_amp generalised for TLV316 blocks
    [01_afe.kicad_sch, 04_dc_links.kicad_sch, 05_vsi.kicad_sch, 06_dual_active_bridge.kicad_sch]
2026-10-18 Phase 1 done: sheet 7 (aux supply), strict check_all, STATUS and Phase 2 handoff prompt
    [02_fpga_connector.kicad_sch, 04_dc_links.kicad_sch, 07_auxiliary_supply.kicad_sch]
2026-10-18 Phase 2 done: footprints assigned and verified against IPC pads
    - tools/gen_footprints.py -> lib/footprint_map.csv + lib/ac_psu.pretty (20 project footprints)
    - tools/fpgeom.py: footprint pad loader and rigid fit; tools/check_footprints.py (+ pcbnew
    placement check), added to check_all.sh; reports/footprint_fit.csv for Phase 3 placement
    - sch_builder: Footprint field from the map, deterministic UUIDs; all sheets regenerated
    - kicad/fp-lib-table; STATUS.md (decisions, residuals, REF3025/C67 findings); Phase 3 prompt
    [01_afe.kicad_sch, 02_fpga_connector.kicad_sch, 03_regulators.kicad_sch, 04_dc_links.kicad_sch, 05_vsi.kicad_sch, 06_dual_active_bridge.kicad_sch, 07_auxiliary_supply.kicad_sch, 08_sdm_current_measurements.kicad_sch]
2026-10-19 Phase 3 done: PCB rebuilt from the Proteus gerbers with nets and zones
    tools/make_pcb.sh regenerates kicad/ac_psu.kicad_pcb (byte-reproducible):
    build_pcb.py (footprints with nets and symbol links at the Proteus
    positions, outline, mounting holes, rules), gerber_to_tracks.py (4052
    tracks, 173 vias; pour edge strokes recognised and skipped),
    assign_nets.py (union-find over copper, 0 shorts/orphans/opens with
    pours), pours_to_zones.py (79 zones = Proteus pour copper incl. holes).
    New checks in check_all.sh: check_board.py (pads/holes/vias vs IPC),
    assign_nets.py --check (after zone fill), drc.py (0 shorts, 0
    unconnected, 0 parity issues; courtyard overlaps accepted).
    Footprints (user decisio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
    [01_afe.kicad_sch, 02_fpga_connector.kicad_sch, 03_regulators.kicad_sch, 04_dc_links.kicad_sch, 05_vsi.kicad_sch, 06_dual_active_bridge.kicad_sch, 09_primary_side_adc.kicad_sch, 11_signal_isolators.kicad_sch]
2026-10-19 Phase 4 done: gerber round trip and IPC-D-356 diff against Proteus pass, review of the Phase 3 findings
    - tools/gerber.py: also reads KiCad plots (4.6 format, obround, multi-primitive aperture
    macros with $n expressions, %TO object attributes); Proteus side unchanged, board still
    byte-identical after make_pcb.sh
    - tools/gerber_roundtrip.py: rasterises both copper gerber sets on one 0.025 mm grid, XOR
    with 0.05 mm tolerance, clusters classified (pad shape / clearance / zone fill / other),
    centre-line coverage check for every draw and flash, drill comparison; report and overlay
    PNGs in reports/roundtrip/. Result: no unexplained copper difference on any layer, only
    pad shapes (KiCad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
    [gerber_roundtrip.py, ipc356_diff.py]
2026-10-21 Add CONVERSION_PLAYBOOK.md: generic Proteus to KiCad migration plan
2026-10-21 Use the shared proteus2kicad tools as submodule tools/p2k
    The generic tools (sexpr, geom2d, gerber, fpgeom, sch_builder, render_sheet, ipc356,
    kipy/kicad-cli/kicad_env.sh) move to proteus2kicad; board values to p2k_config.py.
    The remaining tools import them from p2k. check_all.sh gains the Gerber X2 vs IPC check.
    reference/ gains the refdes_proteus column and new header lines; pad data unchanged.
    [ipc356_pads.csv]
2026-10-22 fab: JLCPCB BOM for the in-stock small parts, stock search script and results
    [jlc_bom.csv]
2026-10-22 v4 design fixes: analysis and plan (no design change yet); board area render helper
    STATUS.md: 'v4 design fixes - in progress' with findings (R48 pin roles,
    copper to cut, placements, JLC parts, HV-via question for U4/U5) and next
    steps; next_prompt.md replaced. Design files unchanged.
2026-10-23 Aux flyback redesign: INN3694C, 20 W 2x15 V, EE25 transformer (OpenMagnetics)
    New design for the sheet-7 aux supply, not yet in the schematic:
    100-500 V DC in, 2 x 15 V / 0.67 A out, reinforced isolation with
    enamelled wire, 2 mm margin tape, 3-layer tape and sleeved leads.
    INN3694C (900 V) instead of INN3165C (650 V too low for 500 V in).
    TDK B66317G0250X187 (E25/13/7 N87, 0.25 mm gap), 69/10/10/9 turns.
    PyOpenMagnetics 1.7.35 scripts, MAS outputs, winding drawing, README.
2026-10-23 v4 design fixes: RET_ISO->ISOGND, U11 INH->GND, C88/C89 on ADA2/ADA3, ADuM7701 RC compensation, R48 Kelvin split
    Board frozen: kicad/ac_psu.kicad_pcb edited by one-shot pcbnew scripts tools/v4/fix_1..5
    (apply_all.sh, reproducible from the tag's board); make_pcb.sh rebuilds the Proteus board from
    tag proteus-conversion-complete into build/proteus/ (byte-identical, checked by regen_check).
    Proteus comparisons apply exactly lib/v4_deviations.csv + lib/v4_copper.csv (tools/deviations.py,
    wrappers compare_netlists_v4 / check_symbols_v4, deviation support in check_board,
    check_footprints, gen_footprints, ipc356_diff, gerber_roundtrip). p2k submodule unchanged.
    check_all: ALL CHECKS PASSED; DRC 0 s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
    [01_afe.kicad_sch, 07_auxiliary_supply.kicad_sch, 08_sdm_current_measurements.kicad_sch, 09_primary_side_adc.kicad_sch, 10_inu_sdm_relay_drive.kicad_sch, ac_psu.kicad_pcb, jlc_bom.csv]
2026-10-23 v4 fix 6: U8/U9 (VXO7805) body graphics away from J12
    A photo of the built board shows the modules' component faces pointing away
    from J12, so the Proteus silk was right and the KiCad R-78E graphics were on
    the wrong side of the pin row. gen_footprints flip_body mirrors the silk, fab,
    courtyard and texts across the pin row and turns the 3D model; pads unchanged.
    tools/v4/fix_6_u8u9_body.py applies it to U8/U9 on the frozen board (no copper
    or net change). DRC: -4 pth_inside_courtyard (J12/U8), +2 courtyards_overlap
    (U9 over C57/C58, real overhang). apply_all.sh on the tag's board reproduces
    the board byte for byte.
    Claude-Session: http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
    [ac_psu.kicad_pcb]
2026-10-23 make_pcb: build the Proteus board with the tag's project footprints (AC_PSU_PRETTY)
    Fix 6 is the first change to a project footprint since the tag; make_pcb.sh
    loaded lib/ac_psu.pretty from the working tree, so regen_check found the
    rebuilt Proteus board different from the tag.
    Claude-Session: https://claude.ai/code/session_01Am5hpeWpvZbzmHWspFiWJm
    [gen_footprints.py]
2026-10-24 v5 plan: aux flyback (INN3694C, EE25) into sheet 7 and the board
    Plan only, no design change: current rail usage, findings (isolation sides,
    secondary controller on GND, overdriven relay coils, stock, footprints),
    user decisions D1-D6, steps incl. a removed-part/replaced-block deviation
    mechanism and in-place vs separate aux board.
    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
2026-10-24 v4 clean-up: C67 drawn as a ceramic capacitor (symbol C), fix 7 copies its fields to the board
    C67 (100 uF on 5V) sits on the same non-polar 1206 land pattern as C57/C58
    with no polarity mark in Proteus; BOM part C15008 (100 uF 6.3 V X5R 1206).
    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
    [07_auxiliary_supply.kicad_sch, ac_psu.kicad_pcb]
2026-10-24 v5 plan: user decisions D1-D3, D5, D6 (reinforced Out2 barrier, in place, 15V/15V_ISO)
    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
2026-10-24 v4 clean-up: fix 8 moves silkscreen references off pads, silk and the board edge
    128 of 276 references moved (146 already clear, DAB_SEC_1 and R58 have no
    free spot). DRC: silk_overlap 199+ -> 35 (KiCad caps each type at 199),
    silk_edge_clearance 12 -> 0, reference-related silk_over_copper 6 -> 0;
    the remaining silk_over_copper are footprint outlines over the enlarged
    Proteus THT pads (snap-in, MKS), not references. Renders reports/v4/fix8_*.png.
    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
    [ac_psu.kicad_pcb]
2026-10-24 v4: R19/R32 422R instead of 420R (not E96, not stocked at JLC), fix 9
    2.5 V x 820/(422+820) = 1.6506 V (420R: 1.6532 V). Deviation value rows,
    sheet 3 note, board values.
    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
    [03_regulators.kicad_sch, ac_psu.kicad_pcb]
2026-10-24 fab: complete JLC BOM, hand-fit list, CPL and fab output script
    BOM 53 lines / 203 parts, all in stock for one board (fab/jlc_bom_check.py):
    AMC1306M25DWVR for the out-of-stock ADuM7701 (pin and package compatible),
    CA-IS3761LW for Si8661BD, 422R, R87 4x33R (assumed), 450 V 2220 for the DAB
    split caps, 10 V 100 uF for C67, TDK X1/Y2 discs, SLA relays. hand_fit.csv:
    TO-247s, snap-ins, film caps, chokes, shunts, VXO modules, C68 (needs a
    >=630 V part, the old BOM had 50 V), connectors, terminals, v5-replaced parts.
    make_fab.sh: gerbers + drills zip, CPL with rotation corrections.
    Claude-Session: https://claude.ai/code/session_01Am5hpeWpv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
    [hand_fit.csv, jlc_bom.csv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]
2026-10-24 v5 plan: Out2 power vs the upgraded U8 (Ti135 control card)
    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
2026-10-29 v4 fix 10: U8 K7805-2000R3 (5 V / 2 A) with C93/C94 per its datasheet
    For the isolated control card (efinix_soc_board POWER_BUDGET.md): U8 value
    VXO7805-1000 -> Mornsun K7805-2000R3 (same SIP-3 pinout and footprint, U9
    unchanged). C93 10u 50V X7R 1210 (22u 50V not stocked in 1206/1210) at pin 1,
    C94 22u 10V 0805 at pin 3, bottom side just south of U8's pins with short
    B.Cu tracks; pin 2 is on the In1 ISOGND zone. Deviation rows (value, 2 parts,
    4 pins, B.Cu area), sheet 3, part map. Footprint courtyard 0.075 mm short of
    the K7805's 6.85 mm body depth (kept, noted).
    Claude-Session: https://claude.ai/code/session_01Am5hpeWpvZbzmHWspFiWJm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
    [03_regulators.kicad_sch, ac_psu.kicad_pcb]
2026-10-29 fab: user answers (C68 500 V closest stocked, R87 33R, Y2, 250 VAC film caps, female sockets, THT by hand, AMC1306 accepted, chokes from AliExpress); U8 K7805-2000R3, C93/C94
    JLC BOM 54 lines / 190 SMD parts, all in stock (jlc_stock_2026-10-29.json;
    the 2026-10-24 result was removed in 40985db). Relays and Y caps moved to
    hand_fit.csv. Voltage margins re-checked at DC+ max 450 V (fab/README.md).
    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
    [hand_fit.csv, jlc_bom.csv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]
2026-10-29 v5 plan: new refdes start at C95 (C93/C94 taken by the U8 capacitors)
    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
2026-10-30 fab: ISO7760FDWR for U16, OPA2350EA for U1/U7, AD1 bought by the user
    Si8660BD (6) and OPA2353EA (16) were short at JLC. ISO7760F has the same
    pinout and default-low outputs; OPA2350 is the same family and package.
    AD1 (ADS7056) moves to the hand-fit list (user's parts, consign to JLC).
    Stock check: all 53 BOM lines in stock for 5 boards.
    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
    [hand_fit.csv, jlc_bom.csv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]
2026-10-30 reports/noise: switching-noise analysis of the measurement chains (no design change)
    Tap nodes without capacitance routed 70-100 mm near gate/source traces,
    U1B R7 = 1k breaking the difference amp, output RCs above the switching
    frequencies, undecoupled REF_1V65, shunt L*di/dt (covered by fix 4), DAB
    aliasing; proposed fixes by class (BOM value / board script / firmware /
    layout) and measurements for the v3 board. Renders and kipy scripts.
    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
2026-10-30 v4 fix 11/12: measurement filters (reports/noise findings 1-5), AMC1306M05
    Schematic (sheets 1/3/4/5/9): C95-C106 1n C0G across every 10k leg of the six
    difference amplifiers (15.9 kHz tap-node filter), R7 1k -> 10k (U1B + leg
    matched; ADA3 scaling changes), R18/R9 100R -> 8.2k with C88/C89 4.7n C0G and
    new C107/C108 4.7n on ISOADA1/2 (4.1 kHz), C42/C2 1n -> 10n C0G (1.9 kHz DC
    links), C109/C110 100n on REF_1V65/REF_1V65_ISO. R64/DAB series R unchanged
    (L unknown; 25R per leg for 10 nH).
    Board: fix 11 places the 16 caps (10 top beside their resistor, 6 bottom with
    7 vias), renames six auto-named output nets, sets the values; fix 12 re-runs
    fix 8's silk placement. DRC 293 (+1 silk), 0 shorts/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
    [01_afe.kicad_sch, 03_regulators.kicad_sch, 04_dc_links.kicad_sch, 05_vsi.kicad_sch, 09_primary_side_adc.kicad_sch, ac_psu.kicad_pcb, hand_fit.csv, jlc_bom.csv]
2026-10-30 v5 plan: D4 = UCC28710 PSR controller with an external 950 V MOSFET (SOT-223 IPN95R2K0P7)
    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
2026-10-30 v5 plan: full power at 100 V DC+, passive cooling: transformer Lp/VOR, DPAK MOSFET, thermal budget
    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
2026-10-31 fab: JLC codes for the DC link (Rubycon 450VXH 470u 450V) and X2 film capacitors (Faratronic 6.8u 305VAC)
    All five 7u film capacitors are line-to-line X capacitors (mains EMI filter and
    inverter output filter), so X2-rated parts. Stock check for 5 boards.
    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
    [hand_fit.csv]
2026-10-31 ctrl-isolation: plan for a reinforced-isolated control-card (CTRL) domain on the baseboard
    Inventory of J11/J12 and every ISOGND/3V3_ISO/5V_ISOL part, chosen isolators
    (2x ISO7760F, CA-IS3742LW), 3x AMC1311B for ISOADA1-3, power options, creepage,
    two CTRL islands, renders of the card area. Plan only, no design change.
    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
2026-10-31 v5 + CTRL isolation: done together, CTRL power from a dedicated v5 flyback winding; iW1830 ruled out
    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
2026-10-31 v5 aux flyback transformer: UCC28710 PSR, 25 W at 100 V, E30/15/7, TIW on Out2/CTRL (three reinforced groups)
    MKF run for E25/13/7, E30/15/7 and E32/16/9 at Vin 100/300/450 V. Chosen E30/15/7 N87 on a
    12-pin bobbin: Lp 265 uH, 32/5/5/3/8 turns, 0.65-0.74 W, ~80 C at 60 C chassis air. Analytical
    UCC28710 design (VOR, Lp, RCS, DCM/CC limits, drain peak, clamp, diodes, cap RMS) in params.py.
    README rewritten (previous INN3694C/EE25 design noted), V5_PLAN.md 5.3.
    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
2026-10-31 v5 aux flyback: 20 W on EE25 (Norwe 10165-106), CTRL on TIW flying leads (user decision)
    Lp 322 uH, Ipp 1.33 A, RCS 0.590 ohm, CC limit 25.5 W typ / 21.0 W worst
    case, 32/5/5/3/8 turns. MKF: 0.60-0.76 W, about 80 C at 60 C air.
    E30/15/7 (3b4a33d) kept as the alternative.
    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
2026-10-31 v5 aux flyback: no bias winding; Out1 is the PSR sense and VDD winding (user decision)
    VS divider from the Out1 winding (RS1 59.0k / RS2 21.0k, RCBC ~118k), VDD from
    15 V via BAS16 + 47R (~14.3 V), CDD 15 uF (TI eq. 24), hiccup on output shorts,
    DRV ~13 V fully enhances the FET (buffer recommended for 35 nC). Winding order
    P1-CTRL-Out1-P2-Out2 (O2 of four): clamp-effective leakage 5.9 uH, losses
    0.61-0.80 W. Freed pin widens the primary row; Out1 wire 0.63 mm.
    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
2026-10-31 v5 aux flyback: RCS 0.562 ohm (CC worst case 23.0 W), MMBT3904/3906 gate buffer (user decisions)
    Model re-run: full load 71 kHz, peak flux 280 mT at Ipp(max), EE25 losses 0.61-0.87 W,
    ~78-86 C at the assumed 60 C chassis air.
    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
2026-10-31 v5: insulation check for IEC 61010-1 (bench-top lab supply)
    Per-barrier working voltages and reinforced distances on the IEC 60664-1 basis
    (to verify against IEC 61010-1 Annex K): B2 primary<->ISO 630 V row (PCB 6.4 /
    material IIIa 12.6 mm), B3/B4 to CTRL 500 V row (5.0 / 10.0 mm), clearance
    >= 3 mm. Transformer: floating core must be insulated (tape/caps); TIW and row
    spacing to verify. PCB islands OK at >= 10 mm; B2 gaps need >= 12.6 mm. MKF
    insulation sweep (insulation.py/.txt); design input now IEC 60664-1 at 630 V.
    IEC 61010-1 checklist added.
    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
2026-10-31 v5: isolated DC link <= 410 V and 30 C rated ambient (user answers)
    Working voltages for floating and earthed output: B2 primary<->ISO now in the
    500 V row (~860 V peak, RMS 430-500 V; 1000 V row only if the output can run DC
    with one terminal earthed), B3/B4 unchanged in the 500 V row. B2 reinforced
    creepage 5.0 mm PCB / 10.0 mm bobbin (was 6.4 / 12.6). Internal air 55 C
    (30 C + assumed 20-30 K rise): EE25 0.64-0.92 W, ~74-82 C. U8 derating and
    IEC 61010-1 surface temperature notes. MKF re-run (insulation 500 V row,
    T_AMB 55 C); insulation sweep extended to 400 and 1000 V.
    Claude-Session: https://claude.ai/code/session_01Am5hpeWpvZbzm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
2026-10-31 v5 insulation: output is always floating AC (user), B2 stays in the 500 V row; 1000 V case closed
    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
2026-10-31 v4 fix 13/14: M4 ring-lug terminals on 7 lead connections, insulation spacing (IEC 61010-1)
    Fix 13: Wuerth REDCUBE THR 74650074R (M4, 50 A) with a plated 4.3 mm centre hole
    in a 7.4 mm square pad on FILTER_IN, FILTER_OUT, INU_OUT2, J5, J7, J9, J10 (new
    footprint kind 'footprint' in lib/v4_deviations.csv; checks taught the swap).
    DAB_PRI/SEC, ACIN, ACOUT pairs, AFE_OUT and PE1-8 need re-layout (STATUS).
    Fix 14: pours give way to 5.0 mm (primary-ISO) and 2.5 mm (to PE) on every
    layer, 3 inner tracks re-routed; tools/v4/domain_gaps.py (in check_all): 18
    violations -> 0. tools/v4/domains.py classifies the nets.
    v4board.load_fp loads a single footprint file so the replay no longer depends on
    th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
    [01_afe.kicad_sch, 05_vsi.kicad_sch, ac_psu.kicad_pcb, footprint_fit.csv, footprint_pads.csv, hand_fit.csv]
2026-11-01 v5: user confirmed IEC 61010-1 and the PCB spacing targets (5.0 mm reinforced, 2.5 mm to PE)
    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
2026-11-01 v4 fix 15: cable-tie anchors next to 8 soldered lead pins (IEC 61010-1 second fixing)
    Board-only footprint CableTie_NPTH_2x3.0mm_P5.5mm (2 x 3.0 mm NPTH, 5.5 mm apart)
    at ACIN1, ACOUT1, ACOUT2, PE1, PE2, PE3, PE5, AFE_OUT. ACIN2, PE4, PE6-PE8,
    DAB_PRI_1/2, DAB_SEC_1/2 have no spot clear of courtyards (STATUS). check_board
    checks the TIE_ anchors against their lib/v4_copper.csv areas. Hand-fit: PA66
    ties, tie within 10 mm of the pin. User confirmed IEC 61010-1 and the 5.0 / 2.5 mm
    spacing; full M4 terminals for the 17 soldered leads move to v5.
    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
    [ac_psu.kicad_pcb, hand_fit.csv]
2026-11-01 Board plots: kicad-board-plots workflow (copper layers + 3D) and README markers
    Same reusable workflow as efinix_soc_board (johonkanen/kicad-board-plots@v1.1,
    render-3d). It plots kicad/ac_psu.kicad_pcb on each board change, pushes the
    images to the renders branch and fills the README table between the markers.
    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
2026-11-01 README: update board plot table
2026-11-02 v5 plan: magnetics sourcing (core, coil formers, clips)
    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
2026-11-02 noise report: finding 9, gate-driver boards inject CM current into GND/ISOGND
    The gate-driver board (gate_drive_power_asym_fb_v3_ee10) has no galvanic
    GND-source path, but its gate-supply toroid couples each switch node to the
    baseboard GND/ISOGND (~10 pF x 30-50 V/ns = 0.3-0.5 A per edge). Fixes on the
    gate board (local CM return, CM choke, low-capacitance transformer or DC/DC
    module) and a measurement to confirm.
    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
2026-11-02 next_prompt: convert the gate-driver board next (JLC parts except the toroid)
    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
2026-11-03 next_prompt: the next phase is the gate-driver board conversion (ready-to-paste prompt)
    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
2026-11-03 next_prompt: gate-driver board converted in its own repo johonkanen/ac_psu_gate_drive
    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
2026-11-05 v4 fix 16: pours without holes; KiCad clearances and IEC domain DRC rules
    Every copper zone keeps only its outer outline (406 Proteus cut-outs removed).
    Per-zone clearance = smallest same-domain Proteus gap inside its holes; the
    IEC 61010-1 domain gaps are net classes DOM_P/I/E + kicad/ac_psu.kicad_dru
    rules (tools/v4/domain_rules.py, --check in check_all). gerber_roundtrip
    accepts differences inside zone outlines as "pour refill". apply_all.sh
    replays fixes 1-15 with the pre-fix-16 project file; byte-identical.
    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
    [ac_psu.kicad_pcb]
2026-11-05 v5 step 1: aux flyback (UCC28710, EE25) and CTRL isolation in the schematic, board staged
    Sheet 7: UCC28710 + IPD95R450P7 flyback, T1 EE25 vertical, 15V/15V_ISO outputs, CTRL winding ->
    TPS54202 -> 5V_CTRL (island B). Sheet 11: CTRL island A (ISO7760F x2, CA-IS3742, AMC1311 x3,
    OPA2350 diff amps, TPS73033), U13/U15/U16 A sides on CTRL. J11/J12 on CTRL nets, 20V -> 15V.
    lib/v5_deviations.csv (remove/rename kinds) and lib/v5_copper.csv pending-layout areas; checks list
    layout items there as pending. tools/v5/v5_1_aux_ctrl.py deletes the IW1830 supply, moves pads,
    cuts their old copper and stages the 98 new parts below the board for the GUI layout. Domain C with
    P-C/I-C 5.0 mm DRC rules. Bobbin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
    [01_afe.kicad_sch, 02_fpga_connector.kicad_sch, 03_regulators.kicad_sch, 05_vsi.kicad_sch, 07_auxiliary_supply.kicad_sch, 10_inu_sdm_relay_drive.kicad_sch, 11_signal_isolators.kicad_sch, ac_psu.kicad_pcb]
2026-11-09 v5 step 2: refdes AFE_OUT1, FILTER_IN1, FILTER_OUT1 so Update PCB from Schematic works
    KiCad counts a reference without a trailing number as unannotated and refuses
    "Update PCB from Schematic". New deviation kind refdes (Proteus -> KiCad name),
    applied by tools/deviations.py to the IPC records, pin lists and deviation rows;
    sheet 1, part_map and footprint_map use the new names; tools/v5/v5_2_refdes.py
    renames and re-links the three footprints and TIE_AFE_OUT on the board.
    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
    [01_afe.kicad_sch, ac_psu.kicad_pcb, footprint_fit.csv, footprint_pads.csv]
2026-11-12 fab: JLC codes for the v5 passives; deleted sheet-7 parts out of the BOM
    fab/jlc_bom.csv: the 71 v5 resistors, capacitors and L2 (all in stock for
    5 boards), the 23 parts deleted in v5 removed. fab/hand_fit.csv: PWM1/TR2
    removed, the step-2 refdes applied. Substitutions (R105 0.56R, C113 22u 35V,
    R98 2 W, polymer output capacitors) explained in fab/README.md.
    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
    [hand_fit.csv, jlc_bom.csv]
2026-11-12 V5_LAYOUT_PLAN.md: 15 mm standoffs, bottom parts up to 10 mm
    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
